marzece/Tubii_Tk2/Parts/parts/resistors/rsmd0603/readme

This is a working example of of parts table
for an 0805 resistor package. It points to
the c0805.dra in 
/tape/nandorpcb/PSD140/myparts/allegroSymbols
