marzece/Tubii_Tk2/worklib/tubii/physical/netlist.txt

(NETLIST)
(FOR DRAWING: C:/Users/QGPWindowsVB/Documents/ANUSTART/worklib/tubii/physical/TubiiPCB_V6.brd)
(GENERATED BY: ALLEGRO 16.6 P004 (v16-6-112G))
(Fri May 22 17:57:33 2015)
$PACKAGES
3006_TRIMPOT ! 3006P_TRIMPOT ; U149 U150 
CAP0603 ! 'CSMD0603-0.1UF,10%,0603,50V' ! '0.1UF' ; C1 C2 C3 C11 C12 C13 ,
        C14 C15 C22 C23 C24 C25 C26 C27 C28 C29 C30 C32 C33 C34 C35 C36 C37 ,
        C38 C39 C40 C41 C42 C43 C44 C45 C46 C47 C48 C84 C85 C86 C87 C89 ,
        C101 C102 C103 C104 C105 C110 C111 C112 C113 C114 C115 C116 C117 ,
        C118 C119 C120 C121 C122 C124 C125 C126 C127 C128 C129 C130 C131 ,
        C132 C133 C135 C136 C184 
CAP0603 ! 'CSMD0603-0.1UF,5%,0603,50V' ! '0.1UF' ; C52 C53 C54 C55 C56 C57 ,
        C60 C62 C63 C66 C96 C97 C98 C183 
CAP0603 ! 'CSMD0603-1.0UF,10%,0603,25V' ! '1.0UF' ; C4 C5 C6 C7 C9 C50 
CAP0603 ! 'CSMD0603-10NF,10%,0603,25V' ! 10NF ; C31 
CAP805 ! 'CSMD0805-0.01UF,10%,0805,25V' ! '0.01UF' ; C202 
CAP805 ! 'CSMD0805-0.1UF,5%,0805,50V' ! '0.1UF' ; C8 C10 C49 C51 C58 C59 ,
        C61 C64 C65 C76 C78 C88 C90 C91 C92 C93 C94 C99 C100 C123 C137 C138 ,
        C139 C140 C181 C182 
CAP805 ! 'CSMD0805-0.33UF,10%,0805,25V' ! '0.33UF' ; C71 C72 
CAP805 ! 'CSMD0805-1.0UF,10%,0805,25V' ! '1.0UF' ; C16 C17 C18 C19 C20 C21 
CAP805 ! 'CSMD0805-100NF,10%,0805,25V' ! 100NF ; C95 
CAP805 ! 'CSMD0805-10NF,10%,0805,25V' ! 10NF ; C83 
CAP805 ! 'CSMD0805-15PF,10%,0805,25V' ! 15PF ; C134 
CAP805 ! 'CSMD0805-1UF,10%,0805,25V' ! 1UF ; C106 C107 C108 C109 C141 C142 ,
        C143 C144 C145 C146 C147 C148 C149 C150 C151 C152 C153 C154 C155 ,
        C156 C157 C158 C159 C160 C161 C162 C163 C164 C165 C166 C167 C168 ,
        C169 C170 C171 C172 C173 C174 C175 C176 C177 C178 C179 C180 
CAP805 ! 'CSMD0805-NS,10%,0805,25V' ! 'NO STUFF' ; C186 C187 C188 C189 C190 ,
        C191 C192 C193 C194 C195 C196 C197 C198 C199 C200 C201 
CAP805 ! 'TANT0805-0.1UF,5%,0805,50V' ! '0.1UF' ; C73 C74 C82 C185 
CAP805 ! 'TANT0805-10UF,5%,0805,25V' ! 10UF ; C67 C68 C75 C77 C80 
CAP805 ! 'TANT0805-1UF,10%,0805,25V' ! 1UF ; C69 C70 C79 C81 
CONN10 ! IDS_C10 ; U6 U16 U53 U54 U80 
CONN12 ! CONN12 ; J2 
CONN20 ! CONN20 ; J3 
CONN32 ! CONN32 ; U148 
COTO2300_V1 ! COTO2342 ; U107 U112 U117 U122 U127 U132 U137 U142 
D6R10F1_BUTTON ! DR610F1_BUTTON ; U151 
DO35 ! 1N4448 ; U109 U110 U114 U115 U119 U120 U124 U125 U129 U130 U134 U135 ,
        U139 U140 U144 U145 
DO41 ! Z4KE ; U155 U156 U157 
FCI_61083_CONNECTOR ! 'FCI_61083-101400LF' ; U5 U65 
FEC32DTP ! TESTPOINT_L ; TP1 TP2 TP3 TP4 TP5 TP6 TP7 TP8 TP9 TP10 TP11 TP12 ,
        TP13 TP14 TP15 TP16 TP17 TP18 TP19 TP20 TP21 TP22 TP23 TP24 TP25 ,
        TP26 TP27 TP28 TP29 TP30 TP31 TP32 TP33 TP34 TP35 TP36 TP37 TP38 ,
        TP39 TP40 TP41 TP42 TP43 TP44 TP45 TP46 TP47 TP48 TP49 TP50 TP51 ,
        TP52 TP53 TP64 TP65 TP68 TP69 TP76 TP77 TP78 TP79 TP80 TP81 TP82 ,
        TP83 TP84 TP85 TP86 TP87 TP88 TP89 TP90 TP91 TP92 TP93 TP94 TP95 ,
        TP110 TP111 TP112 TP113 TP114 TP115 TP116 TP117 TP118 TP119 TP120 ,
        TP121 TP122 TP123 TP124 TP125 TP126 TP127 TP128 TP129 TP130 TP131 ,
        TP132 TP133 TP134 TP135 TP136 TP137 TP138 TP139 TP140 TP141 TP142 ,
        TP143 TP144 TP145 TP146 TP147 TP148 TP149 TP150 TP151 TP152 TP153 ,
        TP154 TP155 TP156 TP157 TP158 TP159 TP160 TP161 TP162 TP163 TP164 ,
        TP165 TP166 TP167 TP168 TP169 TP170 TP171 TP172 TP173 TP174 TP175 ,
        TP176 TP177 TP178 TP179 TP180 TP181 TP182 TP183 TP184 TP185 TP186 ,
        TP187 TP188 TP189 TP190 TP191 TP192 TP193 TP194 TP195 TP196 TP197 ,
        TP198 
INDUCT400 ! INDUCTOR_L ; L1 L2 L3 L4 L5 
LED1206 ! 'LED_1206-RED,RED,1206,16V' ! Red ; LED1 LED2 
LED_SSFLXH1031D ! LED_L ; D1 D2 D3 D4 D5 D6 D7 D8 D9 D10 D11 D12 D13 D14 ,
        D15 D16 D17 D18 
OSTOQ027150 ! OSTOQ027150 ; U154 
OSTOQ047150 ! OSTOQ047150 ; U48 U49 
P113FC ! PICKERING113FC ; U102 U103 U104 U105 
PLCC20 ! MC10H104 ; U12 U30 U32 U39 U40 U84 
PLCC20 ! MC10H116 ; U34 U51 U52 U153 
PLCC20 ! MC10H124 ; U8 U10 U29 U31 U33 U57 U67 U68 U94 
PLCC20 ! MC10H125 ; U18 U24 U35 U45 U56 U78 U79 U93 
PLCC20 ! MC10H131 ; U41 U42 U46 U73 U85 
PLCC28 ! MC10E016 ; U82 
PLCC28 ! MC10E101 ; U44 
PLCC28 ! MC10E116 ; U11 U17 U21 U43 U55 U74 U75 U83 
RES805 ! RES_L ; R194 R195 R196 R197 R198 R201 R203 R204 R208 R211 R212 ,
        R213 R214 R215 R218 R220 R221 R225 R228 R229 R230 R231 R232 R235 ,
        R237 R238 R242 R245 R246 R247 R248 R249 R252 R254 R255 R259 R262 ,
        R263 R264 R265 R266 R269 R271 R272 R276 R279 R280 R281 R282 R283 ,
        R286 R288 R289 R293 R296 R297 R298 R299 R300 R303 R305 R306 R310 ,
        R313 R314 R315 R316 R317 R320 R322 R323 R327 
RES805 ! 'RSMD0805-0,1%,0805' ! 0 ; R205 R206 R207 R209 R222 R223 R224 R226 ,
        R239 R240 R241 R243 R256 R257 R258 R260 R273 R274 R275 R277 R290 ,
        R291 R292 R294 R307 R308 R309 R311 R324 R325 R326 R328 
RES805 ! 'RSMD0805-10,1%,0805' ! 10 ; R200 R217 R234 R251 R268 R285 R302 ,
        R319 
RES805 ! 'RSMD0805-100,1%,0805' ! 100 ; R3 R4 R5 R12 R28 R40 R41 R76 R77 ,
        R110 R112 R181 R182 R183 R184 R185 R186 R367 R368 R381 R382 R383 ,
        R384 R385 R386 R387 R388 R389 R390 
RES805 ! 'RSMD0805-1000,1%,0805' ! 1000 ; R18 R19 R66 R68 R78 R79 R82 R83 ,
        R84 R85 R86 R87 R108 R109 R111 R113 R114 R115 
RES805 ! 'RSMD0805-10K,1%,0805' ! 10K ; R1 R2 R38 R39 R72 R75 R354 R355 
RES805 ! 'RSMD0805-111,1%,0805' ! 111 ; R199 R216 R233 R250 R267 R284 R301 ,
        R318 
RES805 ! 'RSMD0805-2K,1%,0805' ! 2K ; R180 R193 R210 R227 R244 R261 R278 ,
        R295 R312 
RES805 ! 'RSMD0805-499,1%,0805' ! 499 ; R140 R141 R142 R143 R144 R145 R146 ,
        R147 R167 R202 R219 R236 R253 R270 R287 R304 R321 
RES805 ! 'RSMD0805-5.1K,1%,0805' ! '5.1K' ; R351 R352 R353 R356 R357 R358 ,
        R359 R360 R361 R362 
RES805 ! 'RSMD0805-50,1%,0805' ! 50 ; R6 R7 R8 R9 R10 R11 R13 R14 R15 R16 ,
        R17 R20 R21 R22 R23 R24 R25 R26 R27 R29 R30 R31 R32 R33 R34 R35 R36 ,
        R37 R42 R43 R44 R45 R46 R47 R48 R49 R50 R51 R52 R53 R54 R55 R56 R57 ,
        R58 R59 R60 R61 R62 R63 R64 R65 R67 R69 R70 R71 R73 R74 R80 R81 R88 ,
        R89 R90 R91 R92 R93 R94 R95 R96 R97 R98 R99 R100 R101 R102 R103 ,
        R104 R105 R106 R107 R116 R117 R118 R119 R120 R121 R122 R123 R124 ,
        R125 R126 R127 R128 R129 R130 R131 R132 R133 R134 R135 R136 R137 ,
        R138 R139 R148 R149 R150 R151 R152 R153 R154 R155 R156 R157 R158 ,
        R159 R160 R161 R162 R163 R164 R165 R166 R168 R169 R170 R171 R172 ,
        R173 R174 R175 R176 R177 R178 R179 R187 R188 R189 R190 R191 R192 ,
        R329 R330 R331 R332 R333 R334 R335 R336 R337 R338 R339 R340 R341 ,
        R342 R343 R344 R345 R346 R347 R348 R349 R350 R363 R364 R365 R366 ,
        R369 R370 R371 R372 R373 R374 R375 R376 R377 R378 R379 R380 
SIP16 ! SIP_HEADER_16PIN ; J1 
SIP2 ! SIP_HEADER_2PIN ; U87 U88 U89 U90 U91 U92 
SMD_FOX ! FOXCLOCK ; U26 
SOIC14 ! 74F06 ; U63 U64 
SOIC14 ! 74F07 ; U76 U77 U101 
SOIC14 ! 74HCT164 ; U2 U66 U97 U98 
SOIC14 ! DS90LV019 ; U58 
SOIC14 ! OPA4277 ; U13 U14 
SOIC14 ! SN74S32 ; U152 
SOIC16 ! AD96687 ; U70 
SOIC16 ! DS1023200 ; U1 
SOIC16 ! DS102350 ; U36 U37 
SOIC16 ! DS1023500 ; U7 
SOIC16 ! HCT123 ; U9 U38 U47 U62 U95 
SOIC16 ! SY100EL34L ; U28 U86 
SOIC16W ! AD7243 ; U69 
SOIC20 ! 74HCT273 ; U96 
SOIC20 ! HCT374_1 ; U4 U99 U100 
SOIC20W ! SY100EL91L ; U27 
SOIC8 ! AD8009_SOIC ; U50 
SOIC8 ! DS90LV027 ; U20 
SOIC8 ! OPA2277_SOIC ; U15 
SOIC8 ! OPA277 ; U147 
SOIC8 ! REF02 ; U146 
SOIC8 ! SY100EL05 ; U22 U23 U81 
SOIC8 ! THS3061 ; U106 U108 U111 U113 U116 U118 U121 U123 U126 U128 U131 ,
        U133 U136 U138 U141 U143 
SOT223 ! LM1117 ; Q4 
SOT23 ! MMBTH10 ; U59 
SOT23 ! MMBTH81 ; U19 
SS22SDP2 ! SS22SDP2 ; U25 U71 U72 
SSOP16 ! 74HCT165 ; U3 
TO220ABH ! 7815S_L ; Q2 
TO220ABV ! 7915_L ; Q1 
TO92 ! MPSH81 ; U60 
TSSOP16 ! HCT238_TSSOP ; U61 
$NETS
'BACKPLANE_IN<10>' ; R80.2 U6.9 U15.5 
'BACKPLANE_IN<1>' ; R378.2 U6.1 U13.3 
'BACKPLANE_IN<2>' ; R377.2 U6.3 U13.5 
'BACKPLANE_IN<3>' ; R376.2 U6.5 U13.10 
'BACKPLANE_IN<4>' ; R375.2 U6.7 U13.12 
'BACKPLANE_IN<5>' ; R374.2 U6.2 U14.3 
'BACKPLANE_IN<6>' ; R373.2 U6.4 U14.5 
'BACKPLANE_IN<7>' ; R372.2 U6.6 U14.10 
'BACKPLANE_IN<8>' ; R371.2 U6.8 U14.12 
'BACKPLANE_IN<9>' ; R81.2 U6.10 U15.2 
'BACKPLANE_OUT<10>' ; U15.6 U15.7 U16.9 
'BACKPLANE_OUT<1>' ; U13.1 U13.2 U16.1 
'BACKPLANE_OUT<2>' ; U13.6 U13.7 U16.3 
'BACKPLANE_OUT<3>' ; U13.8 U13.9 U16.5 
'BACKPLANE_OUT<4>' ; U13.13 U13.14 U16.7 
'BACKPLANE_OUT<5>' ; U14.1 U14.2 U16.2 
'BACKPLANE_OUT<6>' ; U14.6 U14.7 U16.4 
'BACKPLANE_OUT<7>' ; U14.8 U14.9 U16.6 
'BACKPLANE_OUT<8>' ; U14.13 U14.14 U16.8 
'BACKPLANE_OUT<9>' ; U15.1 U15.3 U16.10 
'BCKP_CLK*' ; R27.2 TP12.1 U30.12 
BCKP_CLK_BUFD_N ; R162.2 U81.4 U83.12 
BCKP_CLK_BUFD_P ; R163.2 U81.3 U83.11 
'CARRIER_SRST#' ; U5.6 
CHANGE_CLK2_N ; R336.2 U21.15 U24.3 
CHANGE_CLK2_P ; R338.2 U21.14 U24.4 
CHOSEN_CLK2_N ; R332.2 U21.26 U24.8 U25.5 
CHOSEN_CLK2_P ; R331.2 U21.25 U24.9 U25.2 
CHOSEN_CLK_N ; R347.2 U22.6 U23.6 U25.6 
CHOSEN_CLK_P ; R345.2 U22.7 U23.7 U25.3 
CLK_BAD_N ; R178.1 U81.2 U94.5 
CLK_BAD_P ; R177.1 U81.1 U94.3 
CLK_MISSED ; R182.1 U96.2 
CLK_SEL_ECL_N ; R25.2 U29.5 U30.9 U30.14 
CLK_SEL_ECL_P ; R26.2 U29.3 U30.7 U30.17 
CLK_STATE ; R175.2 U84.7 U85.4 
'CNTRL_RAW<0>' ; TP8.1 U2.3 U3.11 U4.2 
'CNTRL_RAW<1>' ; TP7.1 U2.4 U3.12 U4.3 
'CNTRL_RAW<2>' ; TP6.1 U2.5 U3.13 U4.4 
'CNTRL_RAW<3>' ; TP5.1 U2.6 U3.14 U4.5 
'CNTRL_RAW<4>' ; TP4.1 U2.10 U3.3 U4.6 
'CNTRL_RAW<5>' ; TP3.1 U2.11 U3.4 U4.7 
'CNTRL_RAW<6>' ; TP2.1 U2.12 U3.5 U4.8 
'CNTRL_RAW<7>' ; TP1.1 U2.13 U3.6 U4.9 
COMP1_THRESH ; TP31.1 U69.14 U70.7 
COMP2_THRESH ; TP30.1 U70.10 U150.2 
COUNT ; R159.1 U81.7 U82.27 U85.8 
'COUNT_DATA_ECL<0>' ; R148.1 U68.3 U82.3 
'COUNT_DATA_ECL<1>' ; R149.1 U68.2 U82.4 
'COUNT_DATA_ECL<2>' ; R150.1 U68.19 U82.5 
'COUNT_DATA_ECL<3>' ; R151.1 U68.18 U82.6 
'COUNT_DATA_ECL<4>' ; R152.1 U67.3 U82.7 
'COUNT_DATA_ECL<5>' ; R153.1 U67.2 U82.21 
'COUNT_DATA_ECL<6>' ; R154.1 U67.19 U82.22 
'COUNT_DATA_ECL<7>' ; R155.1 U67.18 U82.23 
DDGT_BITS ; U1.3 U7.5 
DDGT_TTL ; U7.9 U8.9 U9.10 
DEF_CLK_DIV2_N ; U86.2 U88.1 
DEF_CLK_DIV2_P ; U86.1 U87.1 
DEF_CLK_DIV4_N ; U86.5 U90.1 
DEF_CLK_DIV4_P ; U86.4 U89.1 
DEF_CLK_DIV8_N ; U86.8 U92.1 
DEF_CLK_DIV8_P ; U86.7 U91.1 
DEF_CLK_DIVD_N ; R176.2 U88.2 U90.2 U92.2 U93.4 
DEF_CLK_DIVD_P ; R179.2 U87.2 U89.2 U91.2 U93.3 
DGT_GATE ; R53.2 TP122.1 U40.7 U40.9 U40.14 U40.17 U73.3 
DGT_TTL ; U1.15 U8.7 U8.13 U9.2 
DIVD_CLK_TTL ; U93.5 U95.2 
ECAL_ACTIVE_ECL_N ; R29.2 U31.5 U32.8 
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
TRIG_PULS2_N ; R62.2 U43.24 U46.18 
TRIG_PULS2_P ; R63.2 R66.2 U43.23 U46.19 
UNNAMED_1_74F06_I2_D1 ; U62.13 U63.1 U63.3 U63.5 U63.9 U63.11 U63.13 U64.1 ,
        U64.3 U64.5 U64.9 U64.11 U64.13 
UNNAMED_1_74F06_I2_Q1 ; C100.1 R110.1 R111.2 R382.1 R384.1 R387.1 R389.1 ,
        R390.1 U63.2 U63.4 U63.6 U63.8 U63.10 U63.12 
UNNAMED_1_74F06_I3_Q1 ; C99.1 R112.1 R113.2 R381.1 R383.1 R385.1 R386.1 ,
        R388.1 U64.2 U64.4 U64.6 U64.8 U64.10 U64.12 
UNNAMED_1_74F07_I41_A0 ; U99.19 U101.1 
UNNAMED_1_74F07_I41_A1 ; U99.18 U101.3 
UNNAMED_1_74F07_I41_A2 ; U99.17 U101.5 
UNNAMED_1_74F07_I41_A3 ; U99.16 U101.9 
UNNAMED_1_74F07_I41_Y0 ; R186.1 U101.2 
UNNAMED_1_74F07_I41_Y1 ; R184.1 U101.4 
UNNAMED_1_74F07_I41_Y2 ; R183.1 U101.6 
UNNAMED_1_74F07_I41_Y3 ; R185.1 U101.8 
UNNAMED_1_74HCT164_I28_Q0 ; U66.3 U68.7 
UNNAMED_1_74HCT164_I28_Q1 ; U66.4 U68.9 
UNNAMED_1_74HCT164_I28_Q2 ; U66.5 U68.13 
UNNAMED_1_74HCT164_I28_Q3 ; U66.6 U68.14 
UNNAMED_1_74HCT164_I28_Q4 ; U66.10 U67.7 
UNNAMED_1_74HCT164_I28_Q5 ; U66.11 U67.9 
UNNAMED_1_74HCT164_I28_Q6 ; U66.12 U67.13 
UNNAMED_1_74HCT164_I28_Q7 ; U66.13 U67.14 
UNNAMED_1_74HCT164_I64_Q0 ; U98.3 U99.2 
UNNAMED_1_74HCT164_I64_Q1 ; U98.4 U99.3 
UNNAMED_1_74HCT164_I64_Q2 ; U98.5 U99.4 
UNNAMED_1_74HCT164_I64_Q3 ; U98.6 U99.5 
UNNAMED_1_74HCT164_I64_Q7 ; U97.1 U98.13 
UNNAMED_1_74HCT164_I65_Q0 ; U97.3 U100.2 
UNNAMED_1_74HCT164_I65_Q1 ; U97.4 U100.3 
UNNAMED_1_74HCT164_I65_Q2 ; U97.5 U100.4 
UNNAMED_1_74HCT164_I65_Q3 ; U97.6 U100.5 
UNNAMED_1_74HCT164_I65_Q4 ; U97.10 U100.6 
UNNAMED_1_74HCT164_I65_Q5 ; U97.11 U100.7 
UNNAMED_1_74HCT164_I65_Q6 ; U97.12 U100.8 
UNNAMED_1_74HCT164_I65_Q7 ; U97.13 U100.9 
UNNAMED_1_AD7243_I2_REFIN ; U69.1 U69.2 U69.13 
UNNAMED_1_AD7243_I2_VDD ; C107.2 U69.16 
UNNAMED_1_AD7243_I2_VSS ; C106.2 U69.15 
UNNAMED_1_AD8009_I1_IN ; R86.2 R87.1 U50.2 
UNNAMED_1_AD8009_I1_V ; C84.1 U50.7 
UNNAMED_1_AD8009_I1_V_1 ; C85.2 U50.4 
UNNAMED_1_AD96687_I1_LE1 ; R356.2 U70.4 
UNNAMED_1_AD96687_I1_LE2 ; R357.2 U70.13 
UNNAMED_1_AD96687_I1_Q1 ; R48.2 TP32.1 U39.5 U70.1 
UNNAMED_1_AD96687_I1_Q2 ; R45.2 TP35.1 U39.13 U70.16 
UNNAMED_1_AD96687_I1_Q1_1 ; R46.2 TP33.1 U39.8 U70.2 
UNNAMED_1_AD96687_I1_Q2_1 ; R43.2 TP34.1 U39.15 U70.15 
UNNAMED_1_CAENBUFFER_I18_CNTRL ; R200.1 U100.15 
UNNAMED_1_CAENBUFFER_I18_INANAL ; R168.2 R193.1 R194.1 R197.1 U102.5 
UNNAMED_1_CAENBUFFER_I18_VREF5M ; C141.1 C146.1 C151.1 C156.1 C161.1 C166.1 ,
        C171.1 C176.1 R201.1 R218.1 R235.1 R252.1 R269.1 R286.1 R303.1 ,
        R320.1 R355.2 U147.6 
UNNAMED_1_CAENBUFFER_I19_CNTRL ; R217.1 U100.19 
UNNAMED_1_CAENBUFFER_I19_INANAL ; R169.2 R210.1 R211.1 R214.1 U104.5 
UNNAMED_1_CAENBUFFER_I20_CNTRL ; R234.1 U100.17 
UNNAMED_1_CAENBUFFER_I20_INANAL ; R170.2 R227.1 R228.1 R231.1 U103.5 
UNNAMED_1_CAENBUFFER_I21_CNTRL ; R251.1 U100.16 
UNNAMED_1_CAENBUFFER_I22_CNTRL ; R268.1 U100.14 
UNNAMED_1_CAENBUFFER_I23_CNTRL ; R285.1 U100.12 
UNNAMED_1_CAENBUFFER_I24_CNTRL ; R302.1 U100.18 
UNNAMED_1_CAENBUFFER_I5_CNTRL ; R319.1 U100.13 
UNNAMED_1_CAENBUFFER_I5_INANAL ; R312.1 R313.1 R316.1 R364.2 U105.5 
UNNAMED_1_CAENCOMS_I8_DATARDY ; U65.17 U99.11 U100.11 
UNNAMED_1_CAENCOMS_I8_GT2P ; R56.2 U17.20 U32.7 U41.5 U41.17 U42.5 U42.17 ,
        U73.5 
UNNAMED_1_CAENCOMS_I8_GTTTL ; U1.1 U5.24 U7.1 U18.15 
UNNAMED_1_CAENCOMS_I8_SYNC24TTL ; U5.18 U18.7 U20.3 
UNNAMED_1_CAENCOMS_I8_SYNCTTL ; U5.20 U18.5 U20.2 
UNNAMED_1_CHANGECLKS_I3_BCKPCLK ; R339.2 U23.4 U83.18 
UNNAMED_1_CHANGECLKS_I3_BCKPC_1 ; R340.2 U23.3 U83.17 
UNNAMED_1_CHANGECLKS_I3_BCKPC_2 ; R348.2 U25.4 U83.21 
UNNAMED_1_CHANGECLKS_I3_BCKPC_3 ; R346.2 U25.1 U83.20 
UNNAMED_1_CHANGECLKS_I3_CHANGEC ; R334.2 U21.4 U21.5 U21.28 U85.18 
UNNAMED_1_CHANGECLKS_I3_CHANG_1 ; R333.2 U21.3 U21.6 U21.27 U85.19 
UNNAMED_1_CHANGECLKS_I3_DEFAULT ; R342.1 U22.2 U83.15 
UNNAMED_1_CHANGECLKS_I3_DEFAU_1 ; R344.1 U22.1 U83.14 
UNNAMED_1_CLOCKS_I2_BCKPUSED ; U24.5 U65.43 
UNNAMED_1_CLOCKS_I2_CLK100TTL ; U24.7 U65.41 
UNNAMED_1_CLOCKS_I2_CLKSEL ; U4.19 U29.7 
UNNAMED_1_CLOCKS_I2_DATARDY ; U65.25 U94.9 
UNNAMED_1_CLOCKS_I2_RESET ; U65.47 U152.1 
UNNAMED_1_CNTRLREGISTER_I10_DAT ; U4.11 U65.38 
UNNAMED_1_CNTRLREGISTER_I10_ECA ; R28.1 U4.17 U31.7 
UNNAMED_1_CNTRLREGISTER_I10_LOS ; R5.2 U4.18 U10.7 
UNNAMED_1_CNTRLREGISTER_I10_REA ; U3.1 U3.15 U65.36 
UNNAMED_1_CNTRLREGISTER_I10_REG ; U3.9 U3.10 U65.32 
UNNAMED_1_COTO2342_I1_CTRLIN ; R319.2 U142.2 
UNNAMED_1_COTO2342_I1_CTRLIN_1 ; R200.2 U107.2 
UNNAMED_1_COTO2342_I1_CTRLIN_2 ; R217.2 U112.2 
UNNAMED_1_COTO2342_I1_CTRLIN_3 ; R234.2 U117.2 
UNNAMED_1_COTO2342_I1_CTRLIN_4 ; R251.2 U122.2 
UNNAMED_1_COTO2342_I1_CTRLIN_5 ; R268.2 U127.2 
UNNAMED_1_COTO2342_I1_CTRLIN_6 ; R285.2 U132.2 
UNNAMED_1_COTO2342_I1_CTRLIN_7 ; R302.2 U137.2 
UNNAMED_1_COTO2342_I1_IN1 ; R325.1 U142.5 
UNNAMED_1_COTO2342_I1_IN2 ; R324.1 U142.8 
UNNAMED_1_COTO2342_I1_IN1_1 ; R206.1 U107.5 
UNNAMED_1_COTO2342_I1_IN1_2 ; R223.1 U112.5 
UNNAMED_1_COTO2342_I1_IN1_3 ; R240.1 U117.5 
UNNAMED_1_COTO2342_I1_IN1_4 ; R257.1 U122.5 
UNNAMED_1_COTO2342_I1_IN1_5 ; R274.1 U127.5 
UNNAMED_1_COTO2342_I1_IN1_6 ; R291.1 U132.5 
UNNAMED_1_COTO2342_I1_IN1_7 ; R308.1 U137.5 
UNNAMED_1_COTO2342_I1_IN2_1 ; R205.1 U107.8 
UNNAMED_1_COTO2342_I1_IN2_2 ; R222.1 U112.8 
UNNAMED_1_COTO2342_I1_IN2_3 ; R239.1 U117.8 
UNNAMED_1_COTO2342_I1_IN2_4 ; R256.1 U122.8 
UNNAMED_1_COTO2342_I1_IN2_5 ; R273.1 U127.8 
UNNAMED_1_COTO2342_I1_IN2_6 ; R290.1 U132.8 
UNNAMED_1_COTO2342_I1_IN2_7 ; R307.1 U137.8 
UNNAMED_1_COTO2342_I1_NC1 ; R322.2 U142.7 
UNNAMED_1_COTO2342_I1_NC2 ; R315.2 R318.2 U142.6 
UNNAMED_1_COTO2342_I1_NC1_1 ; R203.2 U107.7 
UNNAMED_1_COTO2342_I1_NC1_2 ; R220.2 U112.7 
UNNAMED_1_COTO2342_I1_NC1_3 ; R237.2 U117.7 
UNNAMED_1_COTO2342_I1_NC1_4 ; R254.2 U122.7 
UNNAMED_1_COTO2342_I1_NC1_5 ; R271.2 U127.7 
UNNAMED_1_COTO2342_I1_NC1_6 ; R288.2 U132.7 
UNNAMED_1_COTO2342_I1_NC1_7 ; R305.2 U137.7 
UNNAMED_1_COTO2342_I1_NC2_1 ; R196.2 R199.2 U107.6 
UNNAMED_1_COTO2342_I1_NC2_2 ; R213.2 R216.2 U112.6 
UNNAMED_1_COTO2342_I1_NC2_3 ; R230.2 R233.2 U117.6 
UNNAMED_1_COTO2342_I1_NC2_4 ; R247.2 R250.2 U122.6 
UNNAMED_1_COTO2342_I1_NC2_5 ; R264.2 R267.2 U127.6 
UNNAMED_1_COTO2342_I1_NC2_6 ; R281.2 R284.2 U132.6 
UNNAMED_1_COTO2342_I1_NC2_7 ; R298.2 R301.2 U137.6 
UNNAMED_1_COTO2342_I1_NO1 ; R313.2 U142.1 
UNNAMED_1_COTO2342_I1_NO2 ; R314.2 R317.2 U142.4 
UNNAMED_1_COTO2342_I1_NO1_1 ; R194.2 U107.1 
UNNAMED_1_COTO2342_I1_NO1_2 ; R211.2 U112.1 
UNNAMED_1_COTO2342_I1_NO1_3 ; R228.2 U117.1 
UNNAMED_1_COTO2342_I1_NO1_4 ; R245.2 U122.1 
UNNAMED_1_COTO2342_I1_NO1_5 ; R262.2 U127.1 
UNNAMED_1_COTO2342_I1_NO1_6 ; R279.2 U132.1 
UNNAMED_1_COTO2342_I1_NO1_7 ; R296.2 U137.1 
UNNAMED_1_COTO2342_I1_NO2_1 ; R195.2 R198.2 U107.4 
UNNAMED_1_COTO2342_I1_NO2_2 ; R212.2 R215.2 U112.4 
UNNAMED_1_COTO2342_I1_NO2_3 ; R229.2 R232.2 U117.4 
UNNAMED_1_COTO2342_I1_NO2_4 ; R246.2 R249.2 U122.4 
UNNAMED_1_COTO2342_I1_NO2_5 ; R263.2 R266.2 U127.4 
UNNAMED_1_COTO2342_I1_NO2_6 ; R280.2 R283.2 U132.4 
UNNAMED_1_COTO2342_I1_NO2_7 ; R297.2 R300.2 U137.4 
UNNAMED_1_CSMD0603_I10_B_1 ; C41.2 U34.5 U34.12 U34.14 
UNNAMED_1_CSMD0603_I54_B ; C113.2 U74.2 U74.4 U74.6 U74.26 U74.28 
UNNAMED_1_CSMD0603_I55_A ; C115.1 U75.2 U75.4 U75.6 U75.26 U75.28 
UNNAMED_1_CSMD0805_I10_A ; C21.1 U15.8 
UNNAMED_1_CSMD0805_I11_A ; C20.1 U15.4 
UNNAMED_1_CSMD0805_I13_B ; C51.2 R38.2 U38.7 
UNNAMED_1_CSMD0805_I14_B ; C10.2 R1.2 U9.7 
UNNAMED_1_CSMD0805_I14_B_1 ; C49.2 R39.2 U38.15 
UNNAMED_1_CSMD0805_I15_B ; C8.2 R2.2 U9.15 
UNNAMED_1_CSMD0805_I20_B ; C176.2 R314.1 R315.1 
UNNAMED_1_CSMD0805_I20_B_1 ; C141.2 R195.1 R196.1 
UNNAMED_1_CSMD0805_I20_B_2 ; C146.2 R212.1 R213.1 
UNNAMED_1_CSMD0805_I20_B_3 ; C151.2 R229.1 R230.1 
UNNAMED_1_CSMD0805_I20_B_4 ; C156.2 R246.1 R247.1 
UNNAMED_1_CSMD0805_I20_B_5 ; C161.2 R263.1 R264.1 
UNNAMED_1_CSMD0805_I20_B_6 ; C166.2 R280.1 R281.1 
UNNAMED_1_CSMD0805_I20_B_7 ; C171.2 R297.1 R298.1 
UNNAMED_1_CSMD0805_I21_B_8 ; C100.2 TP22.1 
UNNAMED_1_CSMD0805_I22_B ; C99.2 TP25.1 
UNNAMED_1_CSMD0805_I23_B ; C95.2 U62.15 U149.2 
UNNAMED_1_CSMD0805_I46_B ; C64.2 R72.2 U47.15 
UNNAMED_1_CSMD0805_I57_B ; C65.2 R75.1 U47.7 
UNNAMED_1_CSMD0805_I64_B ; C61.2 U43.2 U43.4 U43.6 
UNNAMED_1_CSMD0805_I6_A ; C17.1 U13.4 
UNNAMED_1_CSMD0805_I70_B ; C59.2 R66.1 U43.5 
UNNAMED_1_CSMD0805_I71_A ; C58.1 R68.1 U43.3 
UNNAMED_1_CSMD0805_I7_A_1 ; C18.1 U13.11 
UNNAMED_1_CSMD0805_I8_A_1 ; C19.1 U14.4 
UNNAMED_1_CSMD0805_I8_B ; C108.2 U150.3 
UNNAMED_1_CSMD0805_I9_B ; C109.2 U150.1 
UNNAMED_1_CSMD0805_I9_B_1 ; C16.2 U14.11 
UNNAMED_1_DEFAULTCLKSEL_I1_BCKP ; R160.2 U30.18 U30.19 U83.5 U83.23 U83.25 
UNNAMED_1_DEFAULTCLKSEL_I1_DEFA ; R161.2 U30.3 U30.4 U83.3 U83.27 
UNNAMED_1_DEFAULTCLKSEL_I1_RESE ; R157.1 U29.18 U82.26 U85.17 
UNNAMED_1_DEFAULTCLKSEL_I1_RE_1 ; U29.9 U29.14 U96.1 U152.3 
UNNAMED_1_DR610F1BUTTON_I24_B1 ; R167.2 U151.2 U151.3 U152.4 
UNNAMED_1_DS102350_I1_Q ; U36.3 U37.5 
UNNAMED_1_DS90LV019_I14_DIN ; U56.7 U58.2 
UNNAMED_1_DS90LV019_I14_ROUT ; U57.9 U58.4 
UNNAMED_1_ELLIECOMS_I9_SMELLIED ; U5.54 U33.7 
UNNAMED_1_ELLIECOMS_I9_SMELLIEP ; U5.17 U35.5 
UNNAMED_1_ELLIECOMS_I9_SMELLI_1 ; U5.48 U33.13 
UNNAMED_1_ELLIECOMS_I9_TELLIEDE ; U5.50 U33.9 
UNNAMED_1_ELLIECOMS_I9_TELLIEPR ; U5.19 U35.7 
UNNAMED_1_ELLIECOMS_I9_TELLIEPU ; U5.44 U33.14 
'UNNAMED_1_EXTTRIGS_I70_EXTT<10>' ; R145.2 U5.61 U76.6 
'UNNAMED_1_EXTTRIGS_I70_EXTT<11>' ; R144.2 U5.69 U76.8 
'UNNAMED_1_EXTTRIGS_I70_EXTT<12>' ; R143.2 U5.81 U77.2 
'UNNAMED_1_EXTTRIGS_I70_EXTT<13>' ; R142.2 U5.75 U77.4 
'UNNAMED_1_EXTTRIGS_I70_EXTT<14>' ; R141.2 U5.73 U77.6 
'UNNAMED_1_EXTTRIGS_I70_EXTT<15>' ; R140.2 U5.83 U77.8 
'UNNAMED_1_EXTTRIGS_I70_EXTTR<0>' ; U65.74 U79.5 
'UNNAMED_1_EXTTRIGS_I70_EXTTR<1>' ; U65.84 U79.7 
'UNNAMED_1_EXTTRIGS_I70_EXTTR<2>' ; U65.82 U79.15 
'UNNAMED_1_EXTTRIGS_I70_EXTTR<3>' ; U65.76 U79.17 
'UNNAMED_1_EXTTRIGS_I70_EXTTR<4>' ; U65.62 U78.5 
'UNNAMED_1_EXTTRIGS_I70_EXTTR<5>' ; U65.70 U78.7 
'UNNAMED_1_EXTTRIGS_I70_EXTTR<6>' ; U65.68 U78.15 
'UNNAMED_1_EXTTRIGS_I70_EXTTR<7>' ; U65.64 U78.17 
'UNNAMED_1_EXTTRIGS_I70_EXTTR<8>' ; R147.2 U5.67 U76.2 
'UNNAMED_1_EXTTRIGS_I70_EXTTR<9>' ; R146.2 U5.63 U76.4 
UNNAMED_1_GENERALUTILITIES_I4_1 ; U36.1 U65.19 
UNNAMED_1_GENERALUTILITIES_I4_G ; U37.1 U65.23 
UNNAMED_1_GTDELAYS_I1_DDGTN ; R11.2 U8.4 U12.9 
UNNAMED_1_GTDELAYS_I1_DDGTP ; R12.2 TP11.1 U8.2 
UNNAMED_1_HCT123_I22_Q1 ; R41.1 U38.13 
UNNAMED_1_HCT123_I22_Q2 ; R40.1 U38.5 
UNNAMED_1_HCT123_I29_CEXT1 ; C134.2 R180.2 U95.14 
UNNAMED_1_HCT123_I54_Q1 ; R76.1 U47.13 
UNNAMED_1_HCT123_I54_Q2 ; R77.1 U47.5 
UNNAMED_1_HCT123_I9_Q1 ; R4.1 U9.13 
UNNAMED_1_HCT123_I9_Q2 ; R3.1 U9.5 
UNNAMED_1_HCT238_I53_A0 ; U5.49 U61.1 
UNNAMED_1_HCT238_I53_A1 ; U5.53 U61.2 
UNNAMED_1_HCT238_I53_A2 ; U5.55 U61.3 
UNNAMED_1_HCT374_I2_Q6 ; TP9.1 U4.13 
UNNAMED_1_HCT374_I2_Q7 ; TP10.1 U4.12 
UNNAMED_1_LED1206_I28_A ; LED1.2 R111.1 
UNNAMED_1_LED1206_I29_A ; LED2.2 R113.1 
UNNAMED_1_LEDL_I102_A ; D15.2 R367.1 
UNNAMED_1_LEDL_I11_A ; D3.2 R5.1 
UNNAMED_1_LEDL_I12_A ; D10.2 R79.2 
UNNAMED_1_LEDL_I17_A ; D5.2 R41.2 
UNNAMED_1_LEDL_I18_A ; D1.2 R4.2 
UNNAMED_1_LEDL_I18_A_1 ; D6.2 R40.2 
UNNAMED_1_LEDL_I19_A ; D2.2 R3.2 
UNNAMED_1_LEDL_I19_B ; D9.1 R78.1 
UNNAMED_1_LEDL_I25_A ; D14.2 R85.2 
UNNAMED_1_LEDL_I32_A ; D17.2 R181.2 
UNNAMED_1_LEDL_I33_A ; D18.2 R182.2 
UNNAMED_1_LEDL_I3_A ; D4.2 R28.2 
UNNAMED_1_LEDL_I42_B ; D11.1 R82.1 
UNNAMED_1_LEDL_I44_A ; D12.2 R83.1 
UNNAMED_1_LEDL_I46_B ; D13.1 R84.1 
UNNAMED_1_LEDL_I49_A ; D8.2 R77.2 
UNNAMED_1_LEDL_I50_A ; D7.2 R76.2 
UNNAMED_1_LOGEN_I13_DGT2 ; R116.2 U8.19 U73.7 
UNNAMED_1_LOGEN_I13_LOSTAR2 ; R59.2 U11.14 U42.12 
UNNAMED_1_MC10E016_I48_TCLD ; R359.2 U82.28 
UNNAMED_1_MC10E116_I1_D0 ; C123.2 U83.2 U83.4 U83.6 U83.24 U83.26 U83.28 
UNNAMED_1_MC10E116_I1_Q0 ; R164.2 U83.8 U86.13 
UNNAMED_1_MC10E116_I1_Q3 ; R330.2 U17.18 U18.13 
UNNAMED_1_MC10E116_I1_Q0_1 ; R165.2 U83.9 U86.12 
UNNAMED_1_MC10E116_I1_Q3_1 ; R329.2 U17.17 U18.14 
UNNAMED_1_MC10E116_I22_D3 ; R108.2 U55.25 U59.2 
UNNAMED_1_MC10E116_I22_Q0 ; R103.2 U55.8 U56.4 
UNNAMED_1_MC10E116_I22_Q1 ; R104.2 U55.11 U56.9 
UNNAMED_1_MC10E116_I22_Q2 ; R107.2 U55.14 U60.1 
UNNAMED_1_MC10E116_I22_Q0_1 ; R105.2 U55.9 U56.3 
UNNAMED_1_MC10E116_I22_Q1_1 ; R106.2 U55.12 U56.8 
UNNAMED_1_MC10E116_I2_D0 ; C11.2 U11.2 U11.4 U11.6 U11.28 
UNNAMED_1_MC10E116_I2_Q0 ; R8.2 U11.8 U12.7 
UNNAMED_1_MC10E116_I3_Q0 ; R128.1 U74.8 U79.14 
UNNAMED_1_MC10E116_I3_Q1 ; R124.1 U74.12 U79.8 
UNNAMED_1_MC10E116_I3_Q2 ; R139.1 U74.14 U79.4 
UNNAMED_1_MC10E116_I3_Q3 ; R134.1 U74.18 U79.18 
UNNAMED_1_MC10E116_I3_Q0_1 ; R130.1 U74.9 U79.13 
UNNAMED_1_MC10E116_I3_Q1_1 ; R126.1 U74.11 U79.9 
UNNAMED_1_MC10E116_I3_Q2_1 ; R138.1 U74.15 U79.3 
UNNAMED_1_MC10E116_I3_Q3_1 ; R132.1 U74.17 U79.19 
UNNAMED_1_MC10E116_I4_Q0 ; R129.2 U75.9 U78.13 
UNNAMED_1_MC10E116_I4_Q1 ; R133.2 U75.12 U78.8 
UNNAMED_1_MC10E116_I4_Q2 ; R136.2 U75.15 U78.3 
UNNAMED_1_MC10E116_I4_Q3 ; R125.2 U75.17 U78.19 
UNNAMED_1_MC10E116_I4_Q0_1 ; R131.2 U75.8 U78.14 
UNNAMED_1_MC10E116_I4_Q1_1 ; R135.2 U75.11 U78.9 
UNNAMED_1_MC10E116_I4_Q2_1 ; R137.2 U75.14 U78.4 
UNNAMED_1_MC10E116_I4_Q3_1 ; R127.2 U75.18 U78.18 
UNNAMED_1_MC10E116_I63_Q0 ; R73.1 TP131.1 U43.8 U46.5 
UNNAMED_1_MC10E116_I63_Q1 ; R74.1 TP132.1 U43.11 U46.17 
UNNAMED_1_MC10H104_I4_A2 ; R349.2 U30.8 U30.15 U153.4 
UNNAMED_1_MC10H131_I17_CE1 ; U42.8 U42.14 
UNNAMED_1_MC10H131_I59_CC ; R362.1 U85.12 
UNNAMED_1_MC10H131_I59_D1 ; R360.2 U85.9 
UNNAMED_1_MC10H131_I59_D2 ; R361.2 U85.13 
UNNAMED_1_MC10H131_I62_CC ; R351.1 U46.12 
UNNAMED_1_MC10H131_I62_D1 ; R353.1 U46.9 
UNNAMED_1_MC10H131_I62_D2 ; R352.1 U46.13 
UNNAMED_1_MICROZEDMODULE_I1_MTC ; U5.32 U69.9 
UNNAMED_1_MICROZEDMODULE_I1_M_1 ; U5.30 U45.7 U47.10 
UNNAMED_1_MICROZEDMODULE_I1_M_2 ; U5.26 U45.5 U47.2 
UNNAMED_1_MMBTH81_I9_C ; R19.1 U19.3 
UNNAMED_1_MPSH81_I17_C ; R109.2 U60.3 
UNNAMED_1_OPA277_I2_IN ; R354.2 R355.1 U147.2 
UNNAMED_1_PICKERING113FC_I60_CN ; R183.2 U105.4 
UNNAMED_1_PICKERING113FC_I61_CN ; R184.2 U102.4 
UNNAMED_1_PICKERING113FC_I62_CN ; R185.2 U104.4 
UNNAMED_1_PICKERING113FC_I63_CN ; R186.2 U103.4 
UNNAMED_1_REF02_I1_VOUT ; R354.1 U146.5 
UNNAMED_1_RESL_I10_B ; R320.2 U141.2 
UNNAMED_1_RESL_I10_B_1 ; R201.2 U106.2 
UNNAMED_1_RESL_I10_B_2 ; R218.2 U111.2 
UNNAMED_1_RESL_I10_B_3 ; R235.2 U116.2 
UNNAMED_1_RESL_I10_B_4 ; R252.2 U121.2 
UNNAMED_1_RESL_I10_B_5 ; R269.2 U126.2 
UNNAMED_1_RESL_I10_B_6 ; R286.2 U131.2 
UNNAMED_1_RESL_I10_B_7 ; R303.2 U136.2 
UNNAMED_1_RESL_I11_A ; C200.1 R316.2 R323.1 U141.3 
UNNAMED_1_RESL_I11_A_1 ; C186.1 R197.2 R204.1 U106.3 
UNNAMED_1_RESL_I11_A_2 ; C188.1 R214.2 R221.1 U111.3 
UNNAMED_1_RESL_I11_A_3 ; C190.1 R231.2 R238.1 U116.3 
UNNAMED_1_RESL_I11_A_4 ; C192.1 R248.2 R255.1 U121.3 
UNNAMED_1_RESL_I11_A_5 ; C194.1 R265.2 R272.1 U126.3 
UNNAMED_1_RESL_I11_A_6 ; C196.1 R282.2 R289.1 U131.3 
UNNAMED_1_RESL_I11_A_7 ; C198.1 R299.2 R306.1 U136.3 
UNNAMED_1_RESL_I11_B ; C200.2 R323.2 R326.1 U141.6 
UNNAMED_1_RESL_I11_B_1 ; C186.2 R204.2 R207.1 U106.6 
UNNAMED_1_RESL_I11_B_2 ; C188.2 R221.2 R224.1 U111.6 
UNNAMED_1_RESL_I11_B_3 ; C190.2 R238.2 R241.1 U116.6 
UNNAMED_1_RESL_I11_B_4 ; C192.2 R255.2 R258.1 U121.6 
UNNAMED_1_RESL_I11_B_5 ; C194.2 R272.2 R275.1 U126.6 
UNNAMED_1_RESL_I11_B_6 ; C196.2 R289.2 R292.1 U131.6 
UNNAMED_1_RESL_I11_B_7 ; C198.2 R306.2 R309.1 U136.6 
UNNAMED_1_RESL_I16_A ; C201.1 R325.2 R327.1 U143.3 
UNNAMED_1_RESL_I16_A_1 ; C187.1 R206.2 R208.1 U108.3 
UNNAMED_1_RESL_I16_A_2 ; C189.1 R223.2 R225.1 U113.3 
UNNAMED_1_RESL_I16_A_3 ; C191.1 R240.2 R242.1 U118.3 
UNNAMED_1_RESL_I16_A_4 ; C193.1 R257.2 R259.1 U123.3 
UNNAMED_1_RESL_I16_A_5 ; C195.1 R274.2 R276.1 U128.3 
UNNAMED_1_RESL_I16_A_6 ; C197.1 R291.2 R293.1 U133.3 
UNNAMED_1_RESL_I16_A_7 ; C199.1 R308.2 R310.1 U138.3 
UNNAMED_1_RESL_I16_B ; C201.2 R327.2 R328.1 U143.6 
UNNAMED_1_RESL_I16_B_1 ; C187.2 R208.2 R209.1 U108.6 
UNNAMED_1_RESL_I16_B_2 ; C189.2 R225.2 R226.1 U113.6 
UNNAMED_1_RESL_I16_B_3 ; C191.2 R242.2 R243.1 U118.6 
UNNAMED_1_RESL_I16_B_4 ; C193.2 R259.2 R260.1 U123.6 
UNNAMED_1_RESL_I16_B_5 ; C195.2 R276.2 R277.1 U128.6 
UNNAMED_1_RESL_I16_B_6 ; C197.2 R293.2 R294.1 U133.6 
UNNAMED_1_RESL_I16_B_7 ; C199.2 R310.2 R311.1 U138.6 
UNNAMED_1_RESL_I7_A ; R312.2 R321.1 R322.1 
UNNAMED_1_RESL_I7_A_1 ; R193.2 R202.1 R203.1 
UNNAMED_1_RESL_I7_A_2 ; R210.2 R219.1 R220.1 
UNNAMED_1_RESL_I7_A_3 ; R227.2 R236.1 R237.1 
UNNAMED_1_RESL_I7_A_4 ; R244.2 R253.1 R254.1 
UNNAMED_1_RESL_I7_A_5 ; R261.2 R270.1 R271.1 
UNNAMED_1_RESL_I7_A_6 ; R278.2 R287.1 R288.1 
UNNAMED_1_RESL_I7_A_7 ; R295.2 R304.1 R305.1 
UNNAMED_1_RSMD0805_I16_B ; R20.2 U27.19 U28.13 
UNNAMED_1_RSMD0805_I17_B ; R21.2 U27.18 U28.12 
UNNAMED_1_RSMD0805_I18_B ; R324.2 U143.2 
UNNAMED_1_RSMD0805_I18_B_1 ; R205.2 U108.2 
UNNAMED_1_RSMD0805_I18_B_2 ; R222.2 U113.2 
UNNAMED_1_RSMD0805_I18_B_3 ; R239.2 U118.2 
UNNAMED_1_RSMD0805_I18_B_4 ; R256.2 U123.2 
UNNAMED_1_RSMD0805_I18_B_5 ; R273.2 U128.2 
UNNAMED_1_RSMD0805_I18_B_6 ; R290.2 U133.2 
UNNAMED_1_RSMD0805_I18_B_7 ; R307.2 U138.2 
UNNAMED_1_RSMD0805_I39_A ; C202.2 D16.2 R379.1 R380.1 U156.1 
UNNAMED_1_RSMD0805_I45_B ; R358.2 U71.1 U71.6 U72.1 U72.6 
UNNAMED_1_RSMD0805_I4_B ; R115.2 TP21.1 
UNNAMED_1_RSMD0805_I5_B ; R114.2 TP24.1 
UNNAMED_1_SS22SDP2_I34_P1 ; R47.2 TP36.1 U39.7 U71.2 
UNNAMED_1_SS22SDP2_I34_P2 ; R350.2 TP37.1 U39.9 U71.5 
UNNAMED_1_SS22SDP2_I34_TA2 ; U71.3 U71.4 U72.3 U72.4 
UNNAMED_1_SS22SDP2_I35_P1 ; R44.2 TP38.1 U39.14 U72.2 
UNNAMED_1_SS22SDP2_I35_P2 ; R42.2 TP39.1 U39.17 U72.5 
UNNAMED_1_Z4KE_I37_CAT ; U155.1 U157.2 
UNNAMED_1_Z4KE_I38_AND ; U156.2 U157.1 
'UNNAMED_2_FRONTPORTS_I2_CAEN<0>' ; R328.2 TP143.1 U144.1 U145.2 
'UNNAMED_2_FRONTPORTS_I2_CAEN<1>' ; R209.2 TP145.1 U109.1 U110.2 
'UNNAMED_2_FRONTPORTS_I2_CAEN<2>' ; R226.2 TP147.1 U114.1 U115.2 
'UNNAMED_2_FRONTPORTS_I2_CAEN<3>' ; R243.2 TP149.1 U119.1 U120.2 
'UNNAMED_2_FRONTPORTS_I2_CAEN<4>' ; R260.2 TP151.1 U124.1 U125.2 
'UNNAMED_2_FRONTPORTS_I2_CAEN<5>' ; R277.2 TP153.1 U129.1 U130.2 
'UNNAMED_2_FRONTPORTS_I2_CAEN<6>' ; R294.2 TP155.1 U134.1 U135.2 
'UNNAMED_2_FRONTPORTS_I2_CAEN<7>' ; R311.2 TP157.1 U139.1 U140.2 
UNNAMED_2_FRONTPORTS_I2_CLK100N ; J2.12 U21.17 
UNNAMED_2_FRONTPORTS_I2_CLK100P ; J2.11 U21.18 
UNNAMED_2_FRONTPORTS_I2_DGTN ; TP117.1 U8.5 
UNNAMED_2_FRONTPORTS_I2_DGTP ; TP116.1 U8.3 
UNNAMED_2_FRONTPORTS_I2_ECLTOLV ; R101.2 TP87.1 U55.5 
UNNAMED_2_FRONTPORTS_I2_ECLTONI ; R102.2 TP88.1 U55.27 
UNNAMED_2_FRONTPORTS_I2_ECLTOTT ; R100.2 TP86.1 U55.3 
UNNAMED_2_FRONTPORTS_I2_ECLTO_1 ; TP94.1 U58.11 
UNNAMED_2_FRONTPORTS_I2_ECLTO_2 ; TP93.1 U58.12 
UNNAMED_2_FRONTPORTS_I2_ECLTO_3 ; TP95.1 U60.2 
UNNAMED_2_FRONTPORTS_I2_ECLTO_4 ; TP92.1 U56.5 
'UNNAMED_2_FRONTPORTS_I2_EXT<10>' ; U76.1 U148.21 
'UNNAMED_2_FRONTPORTS_I2_EXT<11>' ; U76.9 U148.23 
'UNNAMED_2_FRONTPORTS_I2_EXT<12>' ; U77.5 U148.25 
'UNNAMED_2_FRONTPORTS_I2_EXT<13>' ; U77.3 U148.27 
'UNNAMED_2_FRONTPORTS_I2_EXT<14>' ; U77.1 U148.29 
'UNNAMED_2_FRONTPORTS_I2_EXT<15>' ; U77.9 U148.31 
UNNAMED_2_FRONTPORTS_I2_EXTPEDI ; R31.2 TP114.1 U32.9 
UNNAMED_2_FRONTPORTS_I2_EXTPEDO ; TP110.1 U32.3 U32.4 
'UNNAMED_2_FRONTPORTS_I2_EXTT<0>' ; R118.2 U74.5 U148.1 
'UNNAMED_2_FRONTPORTS_I2_EXTT<1>' ; R117.2 U74.3 U148.3 
'UNNAMED_2_FRONTPORTS_I2_EXTT<2>' ; R363.2 U74.27 U148.5 
'UNNAMED_2_FRONTPORTS_I2_EXTT<3>' ; R119.2 U74.25 U148.7 
'UNNAMED_2_FRONTPORTS_I2_EXTT<4>' ; R121.2 U75.5 U148.9 
'UNNAMED_2_FRONTPORTS_I2_EXTT<5>' ; R120.2 U75.3 U148.11 
'UNNAMED_2_FRONTPORTS_I2_EXTT<6>' ; R122.2 U75.27 U148.13 
'UNNAMED_2_FRONTPORTS_I2_EXTT<7>' ; R123.2 U75.25 U148.15 
'UNNAMED_2_FRONTPORTS_I2_EXTT<8>' ; U76.5 U148.17 
'UNNAMED_2_FRONTPORTS_I2_EXTT<9>' ; U76.3 U148.19 
UNNAMED_2_FRONTPORTS_I2_GENERIC ; TP64.1 U5.31 
UNNAMED_2_FRONTPORTS_I2_GENER_1 ; J2.6 U37.15 U38.2 
UNNAMED_2_FRONTPORTS_I2_GENER_2 ; J2.8 U36.15 U38.10 
UNNAMED_2_FRONTPORTS_I2_GTN ; R192.2 U17.24 U17.26 U17.28 U80.2 
UNNAMED_2_FRONTPORTS_I2_GTNIM ; R18.1 TP141.1 U19.2 
UNNAMED_2_FRONTPORTS_I2_GTP ; R191.2 U17.23 U17.25 U17.27 U80.1 
UNNAMED_2_FRONTPORTS_I2_GTTTLOU ; TP52.1 U18.17 
UNNAMED_2_FRONTPORTS_I2_LOSTARO ; TP119.1 U11.12 
UNNAMED_2_FRONTPORTS_I2_LOSTA_1 ; TP118.1 U11.11 
UNNAMED_2_FRONTPORTS_I2_LVDSTOE ; R368.1 TP84.1 U58.9 
UNNAMED_2_FRONTPORTS_I2_LVDST_1 ; R368.2 TP83.1 U58.10 
UNNAMED_2_FRONTPORTS_I2_LVDST_2 ; TP90.1 U57.2 
UNNAMED_2_FRONTPORTS_I2_MTCAMIM ; J3.6 U43.18 
UNNAMED_2_FRONTPORTS_I2_MTCAM_1 ; J3.5 U43.17 
UNNAMED_2_FRONTPORTS_I2_MTCAM_2 ; J3.2 R365.2 U70.8 
UNNAMED_2_FRONTPORTS_I2_MTCAM_3 ; J3.8 U43.21 
UNNAMED_2_FRONTPORTS_I2_MTCAM_4 ; J3.7 U43.20 
UNNAMED_2_FRONTPORTS_I2_MTCAM_5 ; J3.4 R366.2 U70.9 
UNNAMED_2_FRONTPORTS_I2_MTCDLO ; R6.2 TP120.1 U11.3 
UNNAMED_2_FRONTPORTS_I2_NIMTOEC ; TP85.1 U59.1 
UNNAMED_2_FRONTPORTS_I2_NIMTO_1 ; TP91.1 U55.17 
'UNNAMED_2_FRONTPORTS_I2_PUL<10>' ; R173.2 R278.1 R279.1 R282.1 TP195.1 
'UNNAMED_2_FRONTPORTS_I2_PUL<11>' ; R174.2 R295.1 R296.1 R299.1 TP197.1 
'UNNAMED_2_FRONTPORTS_I2_PULS<0>' ; TP175.1 U105.1 
'UNNAMED_2_FRONTPORTS_I2_PULS<1>' ; TP177.1 U105.2 
'UNNAMED_2_FRONTPORTS_I2_PULS<2>' ; TP179.1 U102.1 
'UNNAMED_2_FRONTPORTS_I2_PULS<3>' ; TP181.1 U102.2 
'UNNAMED_2_FRONTPORTS_I2_PULS<4>' ; TP183.1 U104.1 
'UNNAMED_2_FRONTPORTS_I2_PULS<5>' ; TP185.1 U104.2 
'UNNAMED_2_FRONTPORTS_I2_PULS<6>' ; TP187.1 U103.1 
'UNNAMED_2_FRONTPORTS_I2_PULS<7>' ; TP189.1 U103.2 
'UNNAMED_2_FRONTPORTS_I2_PULS<8>' ; R171.2 R244.1 R245.1 R248.1 TP191.1 
'UNNAMED_2_FRONTPORTS_I2_PULS<9>' ; R172.2 R261.1 R262.1 R265.1 TP193.1 
UNNAMED_2_FRONTPORTS_I2_PULSEIN ; R86.1 TP68.1 
UNNAMED_2_FRONTPORTS_I2_PULSE_1 ; R87.2 TP76.1 U50.6 
UNNAMED_2_FRONTPORTS_I2_RIBBONP ; J2.4 R89.2 U52.5 
UNNAMED_2_FRONTPORTS_I2_RIBBO_1 ; J2.3 R88.2 U52.7 
UNNAMED_2_FRONTPORTS_I2_RIBBO_2 ; J2.1 U51.18 
UNNAMED_2_FRONTPORTS_I2_RIBBO_3 ; J2.2 U51.19 
'UNNAMED_2_FRONTPORTS_I2_SCAL<1>' ; J1.14 U4.15 
'UNNAMED_2_FRONTPORTS_I2_SCAL<2>' ; J1.15 U4.14 
'UNNAMED_2_FRONTPORTS_I2_SCAL<3>' ; J1.3 U4.16 
'UNNAMED_2_FRONTPORTS_I2_SCAL<4>' ; J1.16 U65.24 
'UNNAMED_2_FRONTPORTS_I2_SCAL<5>' ; J1.12 U65.30 
'UNNAMED_2_FRONTPORTS_I2_SCAL<6>' ; J1.13 U65.26 
'UNNAMED_2_FRONTPORTS_I2_SCOP<0>' ; R326.2 TP159.1 
'UNNAMED_2_FRONTPORTS_I2_SCOP<1>' ; R207.2 TP161.1 
'UNNAMED_2_FRONTPORTS_I2_SCOP<2>' ; R224.2 TP163.1 
'UNNAMED_2_FRONTPORTS_I2_SCOP<3>' ; R241.2 TP165.1 
'UNNAMED_2_FRONTPORTS_I2_SCOP<4>' ; R258.2 TP167.1 
'UNNAMED_2_FRONTPORTS_I2_SCOP<5>' ; R275.2 TP169.1 
'UNNAMED_2_FRONTPORTS_I2_SCOP<6>' ; R292.2 TP171.1 
'UNNAMED_2_FRONTPORTS_I2_SCOP<7>' ; R309.2 TP173.1 
UNNAMED_2_FRONTPORTS_I2_SMELLIE ; J3.18 R33.2 U34.7 
UNNAMED_2_FRONTPORTS_I2_SMELL_1 ; J3.16 U33.19 
UNNAMED_2_FRONTPORTS_I2_SMELL_2 ; J3.12 U33.3 
UNNAMED_2_FRONTPORTS_I2_SYNC24L ; TP140.1 U20.5 
UNNAMED_2_FRONTPORTS_I2_SYNC24N ; R190.2 U17.6 U80.9 
UNNAMED_2_FRONTPORTS_I2_SYNC24P ; R189.2 U17.5 U80.10 
UNNAMED_2_FRONTPORTS_I2_SYNC2_1 ; TP139.1 U20.6 
UNNAMED_2_FRONTPORTS_I2_SYNCLVD ; TP138.1 U20.8 
UNNAMED_2_FRONTPORTS_I2_SYNCL_1 ; TP137.1 U20.7 
UNNAMED_2_FRONTPORTS_I2_SYNCN ; R188.2 U17.4 U80.7 
UNNAMED_2_FRONTPORTS_I2_SYNCP ; R187.2 U17.3 U80.8 
UNNAMED_2_FRONTPORTS_I2_TELLIED ; J3.20 R32.2 U34.13 
UNNAMED_2_FRONTPORTS_I2_TELLIEP ; J3.10 U33.2 
UNNAMED_2_FRONTPORTS_I2_TELLI_1 ; J3.14 U33.18 
UNNAMED_2_FRONTPORTS_I2_TTLTOEC ; TP82.1 U57.7 
UNNAMED_2_FRONTPORTS_I2_TTLTO_1 ; TP89.1 U57.3 
UNNAMED_2_FRONTPORTS_I2_TUBCLKI ; J2.10 R370.1 U153.5 
UNNAMED_2_FRONTPORTS_I2_TUBCL_1 ; J2.9 R369.1 U153.7 
UNNAMED_2_FRONTPORTS_I2_TUBIIRT ; TP112.1 U65.20 
USE_BCKP_N ; R337.1 U21.9 U22.4 
USE_BCKP_P ; R335.1 U21.8 U22.3 
USE_DEFAULT_N ; R341.2 U21.12 U23.2 
USE_DEFAULT_P ; R343.2 U21.11 U23.1 
V3P3 ; C31.1 C33.2 C80.2 C81.2 C82.2 C83.1 Q4.2 Q4.4 R85.1 U5.78 U5.79 ,
        U5.80 U26.6 U27.1 U27.11 U27.20 U65.78 U65.79 U65.80 U155.2 
VBAT ; U5.7 
VBB_TRANS ; C88.2 U55.2 U55.4 U55.6 U55.26 U55.28 
VCC15 ; C78.2 C107.1 C142.2 C144.2 C147.2 C149.2 C152.2 C154.2 C157.2 ,
        C159.2 C162.2 C164.2 C167.2 C169.2 C172.2 C174.2 C177.2 C179.2 ,
        C181.1 Q2.3 Q2.4 R83.2 TP16.1 U106.7 U108.7 U111.7 U113.7 U116.7 ,
        U118.7 U121.7 U123.7 U126.7 U128.7 U131.7 U133.7 U136.7 U138.7 ,
        U141.7 U143.7 U146.2 U147.7 
VCC24 ; C71.2 L4.2 Q2.1 
VCC ; C1.2 C2.2 C3.1 C4.1 C5.2 C6.2 C9.1 C12.1 C17.2 C19.2 C21.2 C24.2 ,
        C25.1 C30.2 C35.1 C38.1 C40.2 C42.1 C46.2 C47.2 C48.2 C50.1 C62.2 ,
        C66.1 C68.1 C70.1 C74.1 C77.2 C84.2 C91.1 C92.2 C93.2 C96.1 C97.2 ,
        C98.2 C101.2 C102.1 C103.1 C108.1 C111.2 C117.1 C118.1 C121.2 ,
        C122.2 C131.2 C133.2 C135.2 C136.1 C137.2 C138.2 C139.1 C140.1 ,
        C182.2 C183.1 J1.2 L1.2 Q4.3 R1.1 R2.1 R38.1 R39.1 R72.1 R75.2 ,
        R79.1 R110.2 R112.2 R114.1 R115.1 R140.1 R141.1 R142.1 R143.1 ,
        R144.1 R145.1 R146.1 R147.1 R180.1 R381.2 R382.2 R383.2 R384.2 ,
        R385.2 R386.2 R387.2 R388.2 R389.2 R390.2 TP13.1 TP40.1 TP42.1 ,
        TP44.1 TP46.1 TP48.1 TP50.1 U1.14 U1.16 U2.9 U2.14 U3.16 U4.1 U4.20 ,
        U5.57 U5.58 U5.59 U5.60 U7.14 U7.16 U8.12 U9.3 U9.11 U9.16 U10.12 ,
        U18.12 U20.1 U24.12 U29.8 U29.12 U31.8 U31.12 U32.10 U33.8 U33.12 ,
        U35.12 U36.14 U36.16 U37.14 U37.16 U38.3 U38.11 U38.16 U45.12 ,
        U47.16 U56.12 U57.8 U57.12 U58.1 U58.14 U61.4 U61.5 U61.16 U62.3 ,
        U62.16 U63.14 U64.14 U65.12 U65.57 U65.58 U65.59 U65.60 U66.9 ,
        U66.14 U67.8 U67.12 U68.8 U68.12 U69.3 U69.4 U70.11 U76.14 U77.14 ,
        U78.12 U79.12 U93.12 U94.8 U94.12 U95.16 U96.3 U96.20 U97.9 U97.14 ,
        U98.9 U98.14 U99.20 U100.20 U101.14 U102.3 U103.3 U104.3 U105.3 ,
        U107.3 U112.3 U117.3 U122.3 U127.3 U132.3 U137.3 U142.3 U149.3 ,
        U151.1 
VCC15M ; C76.2 C106.1 C143.1 C145.1 C148.1 C150.1 C153.1 C155.1 C158.1 ,
        C160.1 C163.1 C165.1 C168.1 C170.1 C173.1 C175.1 C178.1 C180.1 Q1.3 ,
        Q1.4 R82.2 TP15.1 U106.4 U108.4 U111.4 U113.4 U116.4 U118.4 U121.4 ,
        U123.4 U126.4 U128.4 U131.4 U133.4 U136.4 U138.4 U141.4 U143.4 ,
        U147.4 
VCC24M ; C72.2 L3.2 Q1.2 
VCC24M_RAW ; L3.1 U48.4 
VCC24_RAW ; L4.1 U48.1 
VCCIO_EN_O ; U65.10 
VCC_RAW ; L1.1 U49.1 
VEE ; C7.1 C13.1 C14.2 C15.2 C16.1 C18.2 C20.2 C22.1 C23.1 C26.1 C27.1 ,
        C28.2 C29.2 C32.1 C34.2 C36.2 C37.2 C39.2 C43.1 C44.2 C45.1 C52.2 ,
        C53.2 C54.2 C55.2 C56.2 C57.1 C60.1 C63.1 C67.2 C69.2 C73.2 C85.1 ,
        C86.1 C87.1 C89.1 C90.1 C94.2 C104.2 C105.2 C109.1 C110.2 C112.2 ,
        C114.1 C116.1 C119.1 C120.1 C124.1 C125.1 C126.1 C127.1 C128.1 ,
        C129.2 C130.1 C132.1 C184.1 L2.2 R19.2 R78.2 R108.1 R109.1 TP14.1 ,
        U8.10 U10.10 U11.1 U12.10 U17.1 U18.10 U21.1 U22.5 U23.5 U24.10 ,
        U27.10 U28.9 U29.10 U30.10 U31.10 U33.10 U34.10 U35.10 U39.10 ,
        U40.10 U41.10 U42.10 U43.1 U44.1 U45.10 U46.10 U51.10 U52.10 U55.1 ,
        U56.10 U57.10 U67.10 U68.10 U70.6 U73.10 U74.1 U75.1 U78.10 U79.10 ,
        U81.5 U82.1 U83.1 U84.10 U85.10 U86.9 U93.10 U94.10 U153.10 
VEE_RAW ; L2.1 U49.4 
VTT ; C75.2 C79.2 C185.2 L5.2 R6.1 R7.1 R8.1 R9.1 R10.1 R11.1 R12.1 R13.2 ,
        R14.2 R15.2 R16.2 R17.2 R20.1 R21.1 R22.1 R23.1 R24.1 R25.1 R26.1 ,
        R27.1 R29.1 R30.1 R31.1 R32.1 R33.1 R34.1 R35.1 R36.1 R37.1 R42.1 ,
        R43.1 R44.1 R45.1 R46.1 R47.1 R48.1 R49.1 R50.1 R51.1 R52.1 R53.1 ,
        R54.1 R55.1 R56.1 R57.1 R58.1 R59.1 R60.1 R61.1 R62.1 R63.1 R64.1 ,
        R65.1 R67.1 R69.1 R70.1 R71.1 R73.2 R74.2 R84.2 R88.1 R89.1 R90.1 ,
        R91.1 R92.1 R93.1 R94.1 R95.1 R96.1 R97.1 R98.1 R99.1 R100.1 R101.1 ,
        R102.1 R103.1 R104.1 R105.1 R106.1 R107.1 R116.1 R117.1 R118.1 ,
        R119.1 R120.1 R121.1 R122.1 R123.1 R124.2 R125.1 R126.2 R127.1 ,
        R128.2 R129.1 R130.2 R131.1 R132.2 R133.1 R134.2 R135.1 R136.1 ,
        R137.1 R138.2 R139.2 R148.2 R149.2 R150.2 R151.2 R152.2 R153.2 ,
        R154.2 R155.2 R156.2 R157.2 R158.1 R159.2 R160.1 R161.1 R162.1 ,
        R163.1 R164.1 R165.1 R166.1 R175.1 R176.1 R177.2 R178.2 R179.1 ,
        R187.1 R188.1 R189.1 R190.1 R191.1 R192.1 R329.1 R330.1 R331.1 ,
        R332.1 R333.1 R334.1 R335.2 R336.1 R337.2 R338.1 R339.1 R340.1 ,
        R341.1 R342.2 R343.1 R344.2 R345.1 R346.1 R347.1 R348.1 R349.1 ,
        R350.1 R363.1 R369.2 R370.2 TP17.1 U110.1 U115.1 U120.1 U125.1 ,
        U130.1 U135.1 U140.1 U145.1 
VTT_RAW ; L5.1 U154.1 
$PACKAGES
$A_PROPERTIES
REUSE_ID '26'; 'U144'
REUSE_ID '21'; 'U145'
REUSE_ID '11'; 'U142'
REUSE_ID '4'; 'C176'
REUSE_ID '15'; 'C177'
REUSE_ID '6'; 'C178'
REUSE_ID '27'; 'C179'
REUSE_ID '25'; 'C180'
ROOM 'BASE_BUFFER'; 'U14' 'U13' 'U15' 'U16' 'U6' 'C21',
           'C20' 'C19' 'C18' 'C17' 'C16'
REUSE_ID '13'; 'R313'
REUSE_ID '3'; 'R314'
REUSE_ID '5'; 'R315'
REUSE_ID '8'; 'R316'
REUSE_ID '2'; 'R317'
REUSE_ID '9'; 'R320'
REUSE_ID '17'; 'R322'
REUSE_ID '10'; 'R323'
REUSE_ID '24'; 'R327'
REUSE_ID '16'; 'R324'
REUSE_ID '18'; 'R325'
REUSE_ID '19'; 'R326'
REUSE_ID '22'; 'R328'
REUSE_ID '1'; 'R319'
REUSE_ID '7'; 'R318'
REUSE_ID '12'; 'R312'
ROOM 'CAEN_DIG'; 'C25' 'C24' 'C23' 'C22' 'R192' 'R191',
           'R190' 'R189' 'R188' 'R187' 'R17' 'R16',
           'R15' 'R14' 'R13' 'R330' 'R329' 'U17',
           'R19' 'R18' 'U19' 'U18' 'U20'
ROOM 'ECAL_CONTROL'; 'C40' 'C39' 'C38' 'R31' 'R30' 'R29',
           'U32' 'U31'
ROOM 'PULSE_INV'; 'C85' 'C84' 'R87' 'R86' 'U50'
ROOM 'EXT_TRIG'; 'C122' 'C121' 'C120' 'C119' 'C118' 'C117',
           'C116' 'C115' 'C114' 'C113' 'R139' 'R138',
           'R137' 'R136' 'R135' 'R134' 'R133' 'R132',
           'R131' 'R130' 'R129' 'R128' 'R127' 'R126',
           'R125' 'R124' 'R123' 'R122' 'R121' 'R120',
           'R119' 'R118' 'R117' 'R363' 'U75' 'U74',
           'U79' 'U78' 'U77' 'U76'
ROOM 'TRANSLATORS'; 'C94' 'C93' 'C92' 'C91' 'C90' 'C88',
           'C89' 'R107' 'R106' 'R105' 'R104' 'R103',
           'R102' 'R101' 'R100' 'U55' 'R109' 'R108',
           'U60' 'U59' 'U56' 'U57' 'U58'
ROOM 'SPKR'; 'C100' 'C99' 'R113' 'R111' 'C95' 'C98',
           'C97' 'C96' 'U64' 'U63' 'U62' 'LED2',
           'LED1'
ROOM 'FAULT_DETECT'; 'C123' 'C136' 'C135' 'C133' 'C132' 'C131',
           'C130' 'C129' 'C128' 'C127' 'C126' 'C125',
           'C124' 'C105' 'C104' 'C103' 'C102' 'C101',
           'R179' 'R178' 'R177' 'R176' 'R175' 'R166',
           'R165' 'R164' 'R163' 'R162' 'R161' 'R160',
           'R159' 'R158' 'R157' 'R156' 'R155' 'R154',
           'R153' 'R152' 'R151' 'R150' 'R149' 'R148',
           'U84' 'U83' 'U86' 'U81' 'U92' 'U91',
           'U90' 'U89' 'U88' 'U87' 'R180' 'U85',
           'U93' 'U94' 'U68' 'U67' 'U82' 'C134',
           'U96' 'U95' 'R362' 'R361' 'R360' 'R359'
ROOM 'SEL_LO'; 'R5' 'D3' 'C15' 'C14' 'C13' 'C12',
           'C11' 'R11' 'R10' 'R9' 'R8' 'R7',
           'R6' 'U12' 'U11' 'U10'
ROOM 'GT_DELAY'; 'R2' 'R1' 'R4' 'R3' 'D2' 'D1',
           'U7' 'U1' 'C10' 'C8' 'C9' 'C7',
           'C6' 'C5' 'C4' 'U8' 'U9'
ROOM 'POWER'; 'TP17' 'TP16' 'TP15' 'TP14' 'TP13' 'C78',
           'C76' 'C81' 'C79' 'C70' 'C69' 'C80',
           'C77' 'C68' 'C67' 'C75' 'C82' 'C74',
           'C73' 'C185' 'U49' 'U48' 'L4' 'L3',
           'L2' 'L1' 'L5' 'C83' 'C72' 'C71',
           'Q4' 'Q1' 'Q2'
ROOM 'CNTRL_REG'; 'TP10' 'TP9' 'TP8' 'TP7' 'TP6' 'TP5',
           'TP4' 'TP3' 'TP2' 'TP1' 'U4' 'C3',
           'C2' 'C1' 'U3'
PLACE_TAG; 'TP10' 'TP9' 'TP8' 'TP7' 'TP6' 'TP5',
           'TP4' 'TP3' 'TP2' 'TP1' 'TP198' 'TP197',
           'TP196' 'TP195' 'TP194' 'TP193' 'TP192' 'TP191',
           'TP190' 'TP189' 'TP188' 'TP187' 'TP186' 'TP185',
           'TP184' 'TP183' 'TP182' 'TP181' 'TP180' 'TP179',
           'TP178' 'TP177' 'TP176' 'TP175' 'TP174' 'TP173',
           'TP172' 'TP171' 'TP170' 'TP169' 'TP168' 'TP167',
           'TP166' 'TP165' 'TP164' 'TP163' 'TP162' 'TP161',
           'TP160' 'TP159' 'TP158' 'TP157' 'TP156' 'TP155',
           'TP154' 'TP153' 'TP152' 'TP151' 'TP150' 'TP149',
           'TP148' 'TP147' 'TP146' 'TP145' 'TP144' 'TP143',
           'TP130' 'TP129' 'TP127' 'TP26' 'TP25' 'TP24',
           'TP23' 'TP22' 'TP21' 'TP17' 'TP16' 'TP15',
           'TP14' 'TP13' 'TP12' 'R2' 'R1' 'R75',
           'R72' 'R39' 'R38' 'R4' 'R3' 'R5',
           'R186' 'R185' 'R184' 'R183' 'R182' 'R181',
           'R77' 'R76' 'R41' 'R40' 'R28' 'R112',
           'R110' 'D2' 'D1' 'D3' 'D18' 'D17',
           'D14' 'D13' 'D12' 'D11' 'D10' 'D9',
           'D8' 'D7' 'D6' 'D5' 'D4' 'U4',
           'U100' 'U99' 'U7' 'U1' 'C10' 'C8',
           'C140' 'C139' 'C138' 'C137' 'C123' 'C100',
           'C99' 'C94' 'C93' 'C92' 'C91' 'C90',
           'C88' 'C78' 'C76' 'C65' 'C64' 'C61',
           'C59' 'C58' 'C51' 'C49' 'C9' 'C7',
           'C6' 'C5' 'C4' 'C50' 'C3' 'C2',
           'C1' 'C15' 'C14' 'C13' 'C12' 'C11',
           'C136' 'C135' 'C133' 'C132' 'C131' 'C130',
           'C129' 'C128' 'C127' 'C126' 'C125' 'C124',
           'C122' 'C121' 'C120' 'C119' 'C118' 'C117',
           'C116' 'C115' 'C114' 'C113' 'C105' 'C104',
           'C103' 'C102' 'C101' 'C89' 'C87' 'C86',
           'C85' 'C84' 'C48' 'C47' 'C46' 'C45',
           'C44' 'C43' 'C42' 'C41' 'C40' 'C39',
           'C38' 'C37' 'C36' 'C35' 'C34' 'C33',
           'C32' 'C30' 'C29' 'C28' 'C27' 'C26',
           'C25' 'C24' 'C23' 'C22' 'U3' 'R11',
           'R10' 'R9' 'R8' 'R7' 'R6' 'R192',
           'R191' 'R190' 'R189' 'R188' 'R187' 'R179',
           'R178' 'R177' 'R176' 'R175' 'R166' 'R165',
           'R164' 'R163' 'R162' 'R161' 'R160' 'R159',
           'R158' 'R157' 'R156' 'R155' 'R154' 'R153',
           'R152' 'R151' 'R150' 'R149' 'R148' 'R139',
           'R138' 'R137' 'R136' 'R135' 'R134' 'R133',
           'R132' 'R131' 'R130' 'R129' 'R128' 'R127',
           'R126' 'R125' 'R124' 'R123' 'R122' 'R121',
           'R120' 'R119' 'R118' 'R117' 'R107' 'R106',
           'R105' 'R104' 'R103' 'R102' 'R101' 'R100',
           'R99' 'R98' 'R97' 'R96' 'R95' 'R94',
           'R93' 'R92' 'R91' 'R90' 'R89' 'R88',
           'R74' 'R73' 'R71' 'R70' 'R69' 'R67',
           'R65' 'R64' 'R63' 'R62' 'R61' 'R60',
           'R59' 'R58' 'R57' 'R56' 'R55' 'R54',
           'R53' 'R52' 'R51' 'R50' 'R49' 'R48',
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
ROOM 'MTCA_MIMIC'; 'TP136' 'TP135' 'TP130' 'TP129' 'TP127' 'TP35',
           'TP34' 'R75' 'R72' 'R77' 'R76' 'D8',
           'D7' 'C65' 'C64' 'C61' 'C59' 'C58',
           'R74' 'R73' 'R71' 'R70' 'R69' 'R67',
           'R65' 'R64' 'R63' 'R62' 'R61' 'R60',
           'R59' 'R58' 'R57' 'R56' 'R55' 'R54',
           'R53' 'R52' 'R51' 'R50' 'R49' 'R48',
           'R47' 'R46' 'R45' 'R44' 'R43' 'R42',
           'R350' 'U40' 'U39' 'U43' 'R68' 'R66',
           'U46' 'U42' 'U41' 'U45' 'U44' 'C66',
           'C63' 'C62' 'C60' 'C57' 'C56' 'C55',
           'C54' 'C53' 'C52' 'U47' 'R353' 'R352',
           'R351'
ROOM 'CLK_PICK'; 'TP12' 'C37' 'C36' 'C35' 'C34' 'C33',
           'C32' 'C184' 'R27' 'R26' 'R25' 'R24',
           'R23' 'R22' 'R21' 'R20' 'R349' 'R370',
           'R369' 'U30' 'U27' 'U28' 'R167' 'U29',
           'U26' 'C31' 'U152'
ROOM 'GENERIC_DELAYS'; 'R39' 'R38' 'C51' 'C49' 'C50' 'C48',
           'C47' 'U37' 'U36' 'U38'
ROOM 'CAEN_ANALOG'; 'R186' 'R185' 'R184' 'R183' 'U100' 'U99',
           'C140' 'C139' 'C138' 'C137' 'C182' 'R364',
           'R174' 'R173' 'R172' 'R171' 'R170' 'R169',
           'R168' 'R321' 'R304' 'R287' 'R270' 'R253',
           'R236' 'R219' 'R202' 'R312' 'R295' 'R278',
           'R261' 'R244' 'R227' 'R210' 'R193' 'R318',
           'R301' 'R284' 'R267' 'R250' 'R233' 'R216',
           'R199' 'R319' 'R302' 'R285' 'R268' 'R251',
           'R234' 'R217' 'R200' 'R328' 'R326' 'R325',
           'R324' 'R311' 'R309' 'R308' 'R307' 'R294',
           'R292' 'R291' 'R290' 'R277' 'R275' 'R274',
           'R273' 'R260' 'R258' 'R257' 'R256' 'R243',
           'R241' 'R240' 'R239' 'R226' 'R224' 'R223',
           'R222' 'R209' 'R207' 'R206' 'R205' 'R327',
           'R323' 'R322' 'R320' 'R317' 'R316' 'R315',
           'R314' 'R313' 'R310' 'R306' 'R305' 'R303',
           'R300' 'R299' 'R298' 'R297' 'R296' 'R293',
           'R289' 'R288' 'R286' 'R283' 'R282' 'R281',
           'R280' 'R279' 'R276' 'R272' 'R271' 'R269',
           'R266' 'R265' 'R264' 'R263' 'R262' 'R259',
           'R255' 'R254' 'R252' 'R249' 'R248' 'R247',
           'R246' 'R245' 'R242' 'R238' 'R237' 'R235',
           'R232' 'R231' 'R230' 'R229' 'R228' 'R225',
           'R221' 'R220' 'R218' 'R215' 'R214' 'R213',
           'R212' 'R211' 'R208' 'R204' 'R203' 'R201',
           'R198' 'R197' 'R196' 'R195' 'R194' 'C180',
           'C179' 'C178' 'C177' 'C176' 'C175' 'C174',
           'C173' 'C172' 'C171' 'C170' 'C169' 'C168',
           'C167' 'C166' 'C165' 'C164' 'C163' 'C162',
           'C161' 'C160' 'C159' 'C158' 'C157' 'C156',
           'C155' 'C154' 'C153' 'C152' 'C151' 'C150',
           'C149' 'C148' 'C147' 'C146' 'C145' 'C144',
           'C143' 'C142' 'C141' 'U142' 'U137' 'U132',
           'U127' 'U122' 'U117' 'U112' 'U107' 'U101',
           'U145' 'U144' 'U140' 'U139' 'U135' 'U134',
           'U130' 'U129' 'U125' 'U124' 'U120' 'U119',
           'U115' 'U114' 'U110' 'U109' 'U143' 'U141',
           'U138' 'U136' 'U133' 'U131' 'U128' 'U126',
           'U123' 'U121' 'U118' 'U116' 'U113' 'U111',
           'U108' 'U106' 'C201' 'C200' 'C199' 'C198',
           'C197' 'C196' 'C195' 'C194' 'C193' 'C192',
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
ROOM 'RIBBON_DELAY'; 'C87' 'C86' 'R99' 'R98' 'R97' 'R96',
           'R95' 'R94' 'R93' 'R92' 'R91' 'R90',
           'R89' 'R88' 'U52' 'U51' 'U54' 'U53'
ROOM 'ELLIE'; 'C46' 'C45' 'C44' 'C43' 'C42' 'C41',
           'R37' 'R36' 'R35' 'R34' 'R33' 'R32',
           'U35' 'U33' 'U34'
ROOM 'CHANGE_CLKS'; 'C30' 'C29' 'C28' 'C27' 'C26' 'R348',
           'R347' 'R346' 'R345' 'R344' 'R343' 'R342',
           'R341' 'R340' 'R339' 'R338' 'R337' 'R336',
           'R335' 'R334' 'R333' 'R332' 'R331' 'U21',
           'U23' 'U22' 'U25' 'U24'
REUSE_ID '20'; 'R321'
$NETS
$A_PROPERTIES
LOGICAL_PATH '@tubii_tk2_lib.tubii(sch_1):page1_i1@tubii_tk2_lib.tubii_pcb(sch_1):page1_i2@tubii_tk2_lib.clocks(sch_1):page1_i1@tubii_tk2_lib.default_clk_sel(sch_1):unnamed_1_z4ke_i38_and'; 'UNNAMED_1_Z4KE_I38_AND'
LOGICAL_PATH '@tubii_tk2_lib.tubii(sch_1):page1_i1@tubii_tk2_lib.tubii_pcb(sch_1):page1_i2@tubii_tk2_lib.clocks(sch_1):page1_i1@tubii_tk2_lib.default_clk_sel(sch_1):unnamed_1_z4ke_i37_cat'; 'UNNAMED_1_Z4KE_I37_CAT'
LOGICAL_PATH '@tubii_tk2_lib.tubii(sch_1):page1_i1@tubii_tk2_lib.tubii_pcb(sch_1):page1_i2@tubii_tk2_lib.clocks(sch_1):page1_i1@tubii_tk2_lib.default_clk_sel(sch_1):unnamed_1_rsmd0805_i39_a'; 'UNNAMED_1_RSMD0805_I39_A'
LOGICAL_PATH '@tubii_tk2_lib.tubii(sch_1):unnamed_2_frontports_i2_gtttlout'; 'UNNAMED_2_FRONTPORTS_I2_GTTTLOU'
LOGICAL_PATH '@tubii_tk2_lib.tubii(sch_1):page1_i1@tubii_tk2_lib.tubii_pcb(sch_1):page1_i5@tubii_tk2_lib.power(sch_1):vtt_raw'; 'VTT_RAW'
LOGICAL_PATH '@tubii_tk2_lib.tubii(sch_1):unnamed_2_frontports_i2_tubclkinp'; 'UNNAMED_2_FRONTPORTS_I2_TUBCL_1'
LOGICAL_PATH '@tubii_tk2_lib.tubii(sch_1):unnamed_2_frontports_i2_tubclkinn'; 'UNNAMED_2_FRONTPORTS_I2_TUBCLKI'
LOGICAL_PATH '@tubii_tk2_lib.tubii(sch_1):unnamed_2_frontports_i2_lvdstoeclinp'; 'UNNAMED_2_FRONTPORTS_I2_LVDST_1'
LOGICAL_PATH '@tubii_tk2_lib.tubii(sch_1):unnamed_2_frontports_i2_lvdstoeclinn'; 'UNNAMED_2_FRONTPORTS_I2_LVDSTOE'
LOGICAL_PATH '@tubii_tk2_lib.tubii(sch_1):page1_i1@tubii_tk2_lib.tubii_pcb(sch_1):page1_i2@tubii_tk2_lib.clocks(sch_1):page1_i1@tubii_tk2_lib.default_clk_sel(sch_1):unnamed_1_mc10h104_i4_a2'; 'UNNAMED_1_MC10H104_I4_A2'
LOGICAL_PATH '@tubii_tk2_lib.tubii(sch_1):page1_i1@tubii_tk2_lib.tubii_pcb(sch_1):page1_i1@tubii_tk2_lib.microzed_module(sch_1):unnamed_1_ledl_i102_a'; 'UNNAMED_1_LEDL_I102_A'
LOGICAL_PATH '@tubii_tk2_lib.tubii(sch_1):page1_i1@tubii_tk2_lib.tubii_pcb(sch_1):page1_i1@tubii_tk2_lib.microzed_module(sch_1):vccio_en_o'; 'VCCIO_EN_O'
LOGICAL_PATH '@tubii_tk2_lib.tubii(sch_1):page1_i1@tubii_tk2_lib.tubii_pcb(sch_1):page1_i1@tubii_tk2_lib.microzed_module(sch_1):vbat'; 'VBAT'
LOGICAL_PATH '@tubii_tk2_lib.tubii(sch_1):page1_i1@tubii_tk2_lib.tubii_pcb(sch_1):page1_i1@tubii_tk2_lib.microzed_module(sch_1):pwr_good'; 'PWR_GOOD'
LOGICAL_PATH '@tubii_tk2_lib.tubii(sch_1):page1_i1@tubii_tk2_lib.tubii_pcb(sch_1):page1_i1@tubii_tk2_lib.microzed_module(sch_1):pwr_en'; 'PWR_EN'
LOGICAL_PATH '@tubii_tk2_lib.tubii(sch_1):page1_i1@tubii_tk2_lib.tubii_pcb(sch_1):page1_i1@tubii_tk2_lib.microzed_module(sch_1):mz_happy'; 'MZ_HAPPY'
LOGICAL_PATH '@tubii_tk2_lib.tubii(sch_1):page1_i1@tubii_tk2_lib.tubii_pcb(sch_1):page1_i1@tubii_tk2_lib.microzed_module(sch_1):jx2_se_1'; 'JX2_SE_1'
LOGICAL_PATH '@tubii_tk2_lib.tubii(sch_1):page1_i1@tubii_tk2_lib.tubii_pcb(sch_1):page1_i1@tubii_tk2_lib.microzed_module(sch_1):jx2_se_0'; 'JX2_SE_0'
LOGICAL_PATH '@tubii_tk2_lib.tubii(sch_1):page1_i1@tubii_tk2_lib.tubii_pcb(sch_1):page1_i1@tubii_tk2_lib.microzed_module(sch_1):jx1_se_0'; 'JX1_SE_0'
LOGICAL_PATH '@tubii_tk2_lib.tubii(sch_1):page1_i1@tubii_tk2_lib.tubii_pcb(sch_1):page1_i1@tubii_tk2_lib.microzed_module(sch_1):jtag_tdo'; 'JTAG_TDO'
LOGICAL_PATH '@tubii_tk2_lib.tubii(sch_1):page1_i1@tubii_tk2_lib.tubii_pcb(sch_1):page1_i1@tubii_tk2_lib.microzed_module(sch_1):jtag_tck'; 'JTAG_TCK'
LOGICAL_PATH '@tubii_tk2_lib.tubii(sch_1):page1_i1@tubii_tk2_lib.tubii_pcb(sch_1):page1_i1@tubii_tk2_lib.microzed_module(sch_1):\init#\'; 'INIT#'
LOGICAL_PATH '@tubii_tk2_lib.tubii(sch_1):page1_i1@tubii_tk2_lib.tubii_pcb(sch_1):page1_i2@tubii_tk2_lib.clocks(sch_1):unnamed_1_dr610f1button_i24_b1'; 'UNNAMED_1_DR610F1BUTTON_I24_B1'
LOGICAL_PATH '@tubii_tk2_lib.tubii(sch_1):page1_i1@tubii_tk2_lib.tubii_pcb(sch_1):page1_i2@tubii_tk2_lib.clocks(sch_1):unnamed_1_defaultclksel_i1_reset'; 'UNNAMED_1_DEFAULTCLKSEL_I1_RE_1'
LOGICAL_PATH '@tubii_tk2_lib.tubii(sch_1):page1_i1@tubii_tk2_lib.tubii_pcb(sch_1):unnamed_1_microzedmodule_i1_mtcamimictrig2'; 'UNNAMED_1_MICROZEDMODULE_I1_M_2'
LOGICAL_PATH '@tubii_tk2_lib.tubii(sch_1):page1_i1@tubii_tk2_lib.tubii_pcb(sch_1):unnamed_1_microzedmodule_i1_mtcamimictrig1'; 'UNNAMED_1_MICROZEDMODULE_I1_M_1'
LOGICAL_PATH '@tubii_tk2_lib.tubii(sch_1):page1_i1@tubii_tk2_lib.tubii_pcb(sch_1):page1_i8@tubii_tk2_lib.caen_coms(sch_1):page1_i1@tubii_tk2_lib.caen_analog_coms(sch_1):unnamed_1_pickering113fc_i63_cntrl'; 'UNNAMED_1_PICKERING113FC_I63_CN'
LOGICAL_PATH '@tubii_tk2_lib.tubii(sch_1):page1_i1@tubii_tk2_lib.tubii_pcb(sch_1):page1_i8@tubii_tk2_lib.caen_coms(sch_1):page1_i1@tubii_tk2_lib.caen_analog_coms(sch_1):unnamed_1_pickering113fc_i62_cntrl'; 'UNNAMED_1_PICKERING113FC_I62_CN'
LOGICAL_PATH '@tubii_tk2_lib.tubii(sch_1):page1_i1@tubii_tk2_lib.tubii_pcb(sch_1):page1_i8@tubii_tk2_lib.caen_coms(sch_1):page1_i1@tubii_tk2_lib.caen_analog_coms(sch_1):unnamed_1_pickering113fc_i61_cntrl'; 'UNNAMED_1_PICKERING113FC_I61_CN'
LOGICAL_PATH '@tubii_tk2_lib.tubii(sch_1):page1_i1@tubii_tk2_lib.tubii_pcb(sch_1):page1_i8@tubii_tk2_lib.caen_coms(sch_1):page1_i1@tubii_tk2_lib.caen_analog_coms(sch_1):unnamed_1_pickering113fc_i60_cntrl'; 'UNNAMED_1_PICKERING113FC_I60_CN'
LOGICAL_PATH '@tubii_tk2_lib.tubii(sch_1):page1_i1@tubii_tk2_lib.tubii_pcb(sch_1):page1_i11@tubii_tk2_lib.tubii_spkr(sch_1):unnamed_1_led1206_i29_a'; 'UNNAMED_1_LED1206_I29_A'
LOGICAL_PATH '@tubii_tk2_lib.tubii(sch_1):page1_i1@tubii_tk2_lib.tubii_pcb(sch_1):page1_i11@tubii_tk2_lib.tubii_spkr(sch_1):unnamed_1_led1206_i28_a'; 'UNNAMED_1_LED1206_I28_A'
LOGICAL_PATH '@tubii_tk2_lib.tubii(sch_1):page1_i1@tubii_tk2_lib.tubii_pcb(sch_1):page1_i3@tubii_tk2_lib.mtca_mimic(sch_1):unnamed_1_rsmd0805_i45_b'; 'UNNAMED_1_RSMD0805_I45_B'
LOGICAL_PATH '@tubii_tk2_lib.tubii(sch_1):page1_i1@tubii_tk2_lib.tubii_pcb(sch_1):page1_i2@tubii_tk2_lib.clocks(sch_1):page1_i2@tubii_tk2_lib.fault_detection(sch_1):unnamed_1_mc10h131_i59_d2'; 'UNNAMED_1_MC10H131_I59_D2'
LOGICAL_PATH '@tubii_tk2_lib.tubii(sch_1):page1_i1@tubii_tk2_lib.tubii_pcb(sch_1):page1_i2@tubii_tk2_lib.clocks(sch_1):page1_i2@tubii_tk2_lib.fault_detection(sch_1):unnamed_1_mc10h131_i59_d1'; 'UNNAMED_1_MC10H131_I59_D1'
LOGICAL_PATH '@tubii_tk2_lib.tubii(sch_1):page1_i1@tubii_tk2_lib.tubii_pcb(sch_1):page1_i2@tubii_tk2_lib.clocks(sch_1):page1_i2@tubii_tk2_lib.fault_detection(sch_1):unnamed_1_mc10h131_i59_cc'; 'UNNAMED_1_MC10H131_I59_CC'
LOGICAL_PATH '@tubii_tk2_lib.tubii(sch_1):page1_i1@tubii_tk2_lib.tubii_pcb(sch_1):page1_i2@tubii_tk2_lib.clocks(sch_1):page1_i2@tubii_tk2_lib.fault_detection(sch_1):unnamed_1_mc10e016_i48_tcld'; 'UNNAMED_1_MC10E016_I48_TCLD'
LOGICAL_PATH '@tubii_tk2_lib.tubii(sch_1):page1_i1@tubii_tk2_lib.tubii_pcb(sch_1):page1_i3@tubii_tk2_lib.mtca_mimic(sch_1):unnamed_1_ad96687_i1_le2'; 'UNNAMED_1_AD96687_I1_LE2'
LOGICAL_PATH '@tubii_tk2_lib.tubii(sch_1):page1_i1@tubii_tk2_lib.tubii_pcb(sch_1):page1_i3@tubii_tk2_lib.mtca_mimic(sch_1):unnamed_1_ad96687_i1_le1'; 'UNNAMED_1_AD96687_I1_LE1'
LOGICAL_PATH '@tubii_tk2_lib.tubii(sch_1):page1_i1@tubii_tk2_lib.tubii_pcb(sch_1):page1_i8@tubii_tk2_lib.caen_coms(sch_1):page1_i1@tubii_tk2_lib.caen_analog_coms(sch_1):unnamed_1_caenbuffer_i5_cntrl'; 'UNNAMED_1_CAENBUFFER_I5_CNTRL'
LOGICAL_PATH '@tubii_tk2_lib.tubii(sch_1):page1_i1@tubii_tk2_lib.tubii_pcb(sch_1):page1_i8@tubii_tk2_lib.caen_coms(sch_1):page1_i1@tubii_tk2_lib.caen_analog_coms(sch_1):unnamed_1_caenbuffer_i24_cntrl'; 'UNNAMED_1_CAENBUFFER_I24_CNTRL'
LOGICAL_PATH '@tubii_tk2_lib.tubii(sch_1):page1_i1@tubii_tk2_lib.tubii_pcb(sch_1):page1_i8@tubii_tk2_lib.caen_coms(sch_1):page1_i1@tubii_tk2_lib.caen_analog_coms(sch_1):unnamed_1_caenbuffer_i20_cntrl'; 'UNNAMED_1_CAENBUFFER_I20_CNTRL'
LOGICAL_PATH '@tubii_tk2_lib.tubii(sch_1):page1_i1@tubii_tk2_lib.tubii_pcb(sch_1):page1_i8@tubii_tk2_lib.caen_coms(sch_1):page1_i1@tubii_tk2_lib.caen_analog_coms(sch_1):unnamed_1_caenbuffer_i19_cntrl'; 'UNNAMED_1_CAENBUFFER_I19_CNTRL'
LOGICAL_PATH '@tubii_tk2_lib.tubii(sch_1):page1_i1@tubii_tk2_lib.tubii_pcb(sch_1):page1_i8@tubii_tk2_lib.caen_coms(sch_1):page1_i1@tubii_tk2_lib.caen_analog_coms(sch_1):unnamed_1_caenbuffer_i18_cntrl'; 'UNNAMED_1_CAENBUFFER_I18_CNTRL'
LOGICAL_PATH '@tubii_tk2_lib.tubii(sch_1):page1_i1@tubii_tk2_lib.tubii_pcb(sch_1):page1_i8@tubii_tk2_lib.caen_coms(sch_1):page1_i1@tubii_tk2_lib.caen_analog_coms(sch_1):page1_i58@tubii_tk2_lib.vref_gen(sch_1):unnamed_1_ref02_i1_vout'; 'UNNAMED_1_REF02_I1_VOUT'
LOGICAL_PATH '@tubii_tk2_lib.tubii(sch_1):page1_i1@tubii_tk2_lib.tubii_pcb(sch_1):page1_i8@tubii_tk2_lib.caen_coms(sch_1):page1_i1@tubii_tk2_lib.caen_analog_coms(sch_1):page1_i58@tubii_tk2_lib.vref_gen(sch_1):unnamed_1_opa277_i2_in'; 'UNNAMED_1_OPA277_I2_IN'
LOGICAL_PATH '@tubii_tk2_lib.tubii(sch_1):page1_i1@tubii_tk2_lib.tubii_pcb(sch_1):page1_i8@tubii_tk2_lib.caen_coms(sch_1):page1_i1@tubii_tk2_lib.caen_analog_coms(sch_1):unnamed_1_caenbuffer_i18_vref5m'; 'UNNAMED_1_CAENBUFFER_I18_VREF5M'
LOGICAL_PATH '@tubii_tk2_lib.tubii(sch_1):page1_i1@tubii_tk2_lib.tubii_pcb(sch_1):page1_i3@tubii_tk2_lib.mtca_mimic(sch_1):page1_i16@tubii_tk2_lib.trigger_logic(sch_1):unnamed_1_mc10h131_i62_d2'; 'UNNAMED_1_MC10H131_I62_D2'
LOGICAL_PATH '@tubii_tk2_lib.tubii(sch_1):page1_i1@tubii_tk2_lib.tubii_pcb(sch_1):page1_i3@tubii_tk2_lib.mtca_mimic(sch_1):page1_i16@tubii_tk2_lib.trigger_logic(sch_1):unnamed_1_mc10h131_i62_d1'; 'UNNAMED_1_MC10H131_I62_D1'
LOGICAL_PATH '@tubii_tk2_lib.tubii(sch_1):page1_i1@tubii_tk2_lib.tubii_pcb(sch_1):page1_i3@tubii_tk2_lib.mtca_mimic(sch_1):page1_i16@tubii_tk2_lib.trigger_logic(sch_1):unnamed_1_mc10h131_i62_cc'; 'UNNAMED_1_MC10H131_I62_CC'
LOGICAL_PATH '@tubii_tk2_lib.tubii(sch_1):page1_i1@tubii_tk2_lib.tubii_pcb(sch_1):page1_i4@tubii_tk2_lib.general_utilities(sch_1):page1_i20@tubii_tk2_lib.ecl_translation(sch_1):vbb_trans'; 'VBB_TRANS'
LOGICAL_PATH '@tubii_tk2_lib.tubii(sch_1):vcc15m'; 'VCC15M'
VOLTAGE '-15V'; 'VCC15M'
LOGICAL_PATH '@tubii_tk2_lib.tubii(sch_1):vcc15'; 'VCC15'
VOLTAGE '15V'; 'VCC15'
LOGICAL_PATH '@tubii_tk2_lib.tubii(sch_1):v3p3'; 'V3P3'
VOLTAGE '3.3V'; 'V3P3'
LOGICAL_PATH '@tubii_tk2_lib.tubii(sch_1):page1_i1@tubii_tk2_lib.tubii_pcb(sch_1):page1_i2@tubii_tk2_lib.clocks(sch_1):page1_i3@tubii_tk2_lib.change_clks(sch_1):use_default_p'; 'USE_DEFAULT_P'
LOGICAL_PATH '@tubii_tk2_lib.tubii(sch_1):page1_i1@tubii_tk2_lib.tubii_pcb(sch_1):page1_i2@tubii_tk2_lib.clocks(sch_1):page1_i3@tubii_tk2_lib.change_clks(sch_1):use_default_n'; 'USE_DEFAULT_N'
LOGICAL_PATH '@tubii_tk2_lib.tubii(sch_1):page1_i1@tubii_tk2_lib.tubii_pcb(sch_1):page1_i2@tubii_tk2_lib.clocks(sch_1):page1_i3@tubii_tk2_lib.change_clks(sch_1):use_bckp_p'; 'USE_BCKP_P'
LOGICAL_PATH '@tubii_tk2_lib.tubii(sch_1):page1_i1@tubii_tk2_lib.tubii_pcb(sch_1):page1_i2@tubii_tk2_lib.clocks(sch_1):page1_i3@tubii_tk2_lib.change_clks(sch_1):use_bckp_n'; 'USE_BCKP_N'
LOGICAL_PATH '@tubii_tk2_lib.tubii(sch_1):page1_i1@tubii_tk2_lib.tubii_pcb(sch_1):page1_i3@tubii_tk2_lib.mtca_mimic(sch_1):unnamed_1_ss22sdp2_i35_p2'; 'UNNAMED_1_SS22SDP2_I35_P2'
LOGICAL_PATH '@tubii_tk2_lib.tubii(sch_1):page1_i1@tubii_tk2_lib.tubii_pcb(sch_1):page1_i3@tubii_tk2_lib.mtca_mimic(sch_1):unnamed_1_ss22sdp2_i35_p1'; 'UNNAMED_1_SS22SDP2_I35_P1'
LOGICAL_PATH '@tubii_tk2_lib.tubii(sch_1):page1_i1@tubii_tk2_lib.tubii_pcb(sch_1):page1_i3@tubii_tk2_lib.mtca_mimic(sch_1):unnamed_1_ss22sdp2_i34_ta2'; 'UNNAMED_1_SS22SDP2_I34_TA2'
LOGICAL_PATH '@tubii_tk2_lib.tubii(sch_1):page1_i1@tubii_tk2_lib.tubii_pcb(sch_1):page1_i3@tubii_tk2_lib.mtca_mimic(sch_1):unnamed_1_ss22sdp2_i34_p2'; 'UNNAMED_1_SS22SDP2_I34_P2'
LOGICAL_PATH '@tubii_tk2_lib.tubii(sch_1):page1_i1@tubii_tk2_lib.tubii_pcb(sch_1):page1_i3@tubii_tk2_lib.mtca_mimic(sch_1):unnamed_1_ss22sdp2_i34_p1'; 'UNNAMED_1_SS22SDP2_I34_P1'
LOGICAL_PATH '@tubii_tk2_lib.tubii(sch_1):page1_i1@tubii_tk2_lib.tubii_pcb(sch_1):page1_i11@tubii_tk2_lib.tubii_spkr(sch_1):unnamed_1_rsmd0805_i5_b'; 'UNNAMED_1_RSMD0805_I5_B'
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
LOGICAL_PATH '@tubii_tk2_lib.tubii(sch_1):page1_i1@tubii_tk2_lib.tubii_pcb(sch_1):page1_i8@tubii_tk2_lib.caen_coms(sch_1):page1_i1@tubii_tk2_lib.caen_analog_coms(sch_1):page1_i18@tubii_tk2_lib.caen_buffer(sch_1):unnamed_1_resl_i11_a'; 'UNNAMED_1_RESL_I11_A_1'
LOGICAL_PATH '@tubii_tk2_lib.tubii(sch_1):page1_i1@tubii_tk2_lib.tubii_pcb(sch_1):page1_i8@tubii_tk2_lib.caen_coms(sch_1):page1_i1@tubii_tk2_lib.caen_analog_coms(sch_1):page1_i5@tubii_tk2_lib.caen_buffer(sch_1):unnamed_1_resl_i11_a'; 'UNNAMED_1_RESL_I11_A'
LOGICAL_PATH '@tubii_tk2_lib.tubii(sch_1):page1_i1@tubii_tk2_lib.tubii_pcb(sch_1):page1_i8@tubii_tk2_lib.caen_coms(sch_1):page1_i1@tubii_tk2_lib.caen_analog_coms(sch_1):page1_i24@tubii_tk2_lib.caen_buffer(sch_1):unnamed_1_resl_i10_b'; 'UNNAMED_1_RESL_I10_B_7'
LOGICAL_PATH '@tubii_tk2_lib.tubii(sch_1):page1_i1@tubii_tk2_lib.tubii_pcb(sch_1):page1_i8@tubii_tk2_lib.caen_coms(sch_1):page1_i1@tubii_tk2_lib.caen_analog_coms(sch_1):page1_i23@tubii_tk2_lib.caen_buffer(sch_1):unnamed_1_resl_i10_b'; 'UNNAMED_1_RESL_I10_B_6'
LOGICAL_PATH '@tubii_tk2_lib.tubii(sch_1):page1_i1@tubii_tk2_lib.tubii_pcb(sch_1):page1_i8@tubii_tk2_lib.caen_coms(sch_1):page1_i1@tubii_tk2_lib.caen_analog_coms(sch_1):page1_i22@tubii_tk2_lib.caen_buffer(sch_1):unnamed_1_resl_i10_b'; 'UNNAMED_1_RESL_I10_B_5'
LOGICAL_PATH '@tubii_tk2_lib.tubii(sch_1):page1_i1@tubii_tk2_lib.tubii_pcb(sch_1):page1_i8@tubii_tk2_lib.caen_coms(sch_1):page1_i1@tubii_tk2_lib.caen_analog_coms(sch_1):page1_i21@tubii_tk2_lib.caen_buffer(sch_1):unnamed_1_resl_i10_b'; 'UNNAMED_1_RESL_I10_B_4'
LOGICAL_PATH '@tubii_tk2_lib.tubii(sch_1):page1_i1@tubii_tk2_lib.tubii_pcb(sch_1):page1_i8@tubii_tk2_lib.caen_coms(sch_1):page1_i1@tubii_tk2_lib.caen_analog_coms(sch_1):page1_i20@tubii_tk2_lib.caen_buffer(sch_1):unnamed_1_resl_i10_b'; 'UNNAMED_1_RESL_I10_B_3'
LOGICAL_PATH '@tubii_tk2_lib.tubii(sch_1):page1_i1@tubii_tk2_lib.tubii_pcb(sch_1):page1_i8@tubii_tk2_lib.caen_coms(sch_1):page1_i1@tubii_tk2_lib.caen_analog_coms(sch_1):page1_i19@tubii_tk2_lib.caen_buffer(sch_1):unnamed_1_resl_i10_b'; 'UNNAMED_1_RESL_I10_B_2'
LOGICAL_PATH '@tubii_tk2_lib.tubii(sch_1):page1_i1@tubii_tk2_lib.tubii_pcb(sch_1):page1_i8@tubii_tk2_lib.caen_coms(sch_1):page1_i1@tubii_tk2_lib.caen_analog_coms(sch_1):page1_i18@tubii_tk2_lib.caen_buffer(sch_1):unnamed_1_resl_i10_b'; 'UNNAMED_1_RESL_I10_B_1'
LOGICAL_PATH '@tubii_tk2_lib.tubii(sch_1):page1_i1@tubii_tk2_lib.tubii_pcb(sch_1):page1_i8@tubii_tk2_lib.caen_coms(sch_1):page1_i1@tubii_tk2_lib.caen_analog_coms(sch_1):page1_i5@tubii_tk2_lib.caen_buffer(sch_1):unnamed_1_resl_i10_b'; 'UNNAMED_1_RESL_I10_B'
LOGICAL_PATH '@tubii_tk2_lib.tubii(sch_1):page1_i1@tubii_tk2_lib.tubii_pcb(sch_1):page1_i4@tubii_tk2_lib.general_utilities(sch_1):page1_i20@tubii_tk2_lib.ecl_translation(sch_1):unnamed_1_mpsh81_i17_c'; 'UNNAMED_1_MPSH81_I17_C'
LOGICAL_PATH '@tubii_tk2_lib.tubii(sch_1):page1_i1@tubii_tk2_lib.tubii_pcb(sch_1):page1_i8@tubii_tk2_lib.caen_coms(sch_1):page1_i2@tubii_tk2_lib.caen_dig_coms(sch_1):unnamed_1_mmbth81_i9_c'; 'UNNAMED_1_MMBTH81_I9_C'
LOGICAL_PATH '@tubii_tk2_lib.tubii(sch_1):page1_i1@tubii_tk2_lib.tubii_pcb(sch_1):unnamed_1_microzedmodule_i1_mtcamimicdatardy'; 'UNNAMED_1_MICROZEDMODULE_I1_MTC'
LOGICAL_PATH '@tubii_tk2_lib.tubii(sch_1):page1_i1@tubii_tk2_lib.tubii_pcb(sch_1):page1_i3@tubii_tk2_lib.mtca_mimic(sch_1):page1_i16@tubii_tk2_lib.trigger_logic(sch_1):unnamed_1_mc10h131_i17_ce1'; 'UNNAMED_1_MC10H131_I17_CE1'
LOGICAL_PATH '@tubii_tk2_lib.tubii(sch_1):page1_i1@tubii_tk2_lib.tubii_pcb(sch_1):page1_i3@tubii_tk2_lib.mtca_mimic(sch_1):page1_i16@tubii_tk2_lib.trigger_logic(sch_1):unnamed_1_mc10e116_i63_q1'; 'UNNAMED_1_MC10E116_I63_Q1'
LOGICAL_PATH '@tubii_tk2_lib.tubii(sch_1):page1_i1@tubii_tk2_lib.tubii_pcb(sch_1):page1_i3@tubii_tk2_lib.mtca_mimic(sch_1):page1_i16@tubii_tk2_lib.trigger_logic(sch_1):unnamed_1_mc10e116_i63_q0'; 'UNNAMED_1_MC10E116_I63_Q0'
LOGICAL_PATH '@tubii_tk2_lib.tubii(sch_1):page1_i1@tubii_tk2_lib.tubii_pcb(sch_1):page1_i70@tubii_tk2_lib.ext_trigs(sch_1):unnamed_1_mc10e116_i4_q3_1'; 'UNNAMED_1_MC10E116_I4_Q3_1'
LOGICAL_PATH '@tubii_tk2_lib.tubii(sch_1):page1_i1@tubii_tk2_lib.tubii_pcb(sch_1):page1_i70@tubii_tk2_lib.ext_trigs(sch_1):unnamed_1_mc10e116_i4_q3'; 'UNNAMED_1_MC10E116_I4_Q3'
LOGICAL_PATH '@tubii_tk2_lib.tubii(sch_1):page1_i1@tubii_tk2_lib.tubii_pcb(sch_1):page1_i70@tubii_tk2_lib.ext_trigs(sch_1):unnamed_1_mc10e116_i4_q2_1'; 'UNNAMED_1_MC10E116_I4_Q2_1'
LOGICAL_PATH '@tubii_tk2_lib.tubii(sch_1):page1_i1@tubii_tk2_lib.tubii_pcb(sch_1):page1_i70@tubii_tk2_lib.ext_trigs(sch_1):unnamed_1_mc10e116_i4_q2'; 'UNNAMED_1_MC10E116_I4_Q2'
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
LOGICAL_PATH '@tubii_tk2_lib.tubii(sch_1):page1_i1@tubii_tk2_lib.tubii_pcb(sch_1):page1_i2@tubii_tk2_lib.clocks(sch_1):page1_i2@tubii_tk2_lib.fault_detection(sch_1):unnamed_1_mc10e116_i1_q0_1'; 'UNNAMED_1_MC10E116_I1_Q0_1'
LOGICAL_PATH '@tubii_tk2_lib.tubii(sch_1):page1_i1@tubii_tk2_lib.tubii_pcb(sch_1):page1_i2@tubii_tk2_lib.clocks(sch_1):page1_i2@tubii_tk2_lib.fault_detection(sch_1):unnamed_1_mc10e116_i1_q0'; 'UNNAMED_1_MC10E116_I1_Q0'
LOGICAL_PATH '@tubii_tk2_lib.tubii(sch_1):page1_i1@tubii_tk2_lib.tubii_pcb(sch_1):page1_i2@tubii_tk2_lib.clocks(sch_1):page1_i2@tubii_tk2_lib.fault_detection(sch_1):unnamed_1_mc10e116_i1_d0'; 'UNNAMED_1_MC10E116_I1_D0'
LOGICAL_PATH '@tubii_tk2_lib.tubii(sch_1):page1_i1@tubii_tk2_lib.tubii_pcb(sch_1):unnamed_1_logen_i13_lostar2'; 'UNNAMED_1_LOGEN_I13_LOSTAR2'
LOGICAL_PATH '@tubii_tk2_lib.tubii(sch_1):page1_i1@tubii_tk2_lib.tubii_pcb(sch_1):unnamed_1_logen_i13_dgt2'; 'UNNAMED_1_LOGEN_I13_DGT2'
LOGICAL_PATH '@tubii_tk2_lib.tubii(sch_1):page1_i1@tubii_tk2_lib.tubii_pcb(sch_1):page1_i3@tubii_tk2_lib.mtca_mimic(sch_1):page1_i16@tubii_tk2_lib.trigger_logic(sch_1):unnamed_1_ledl_i50_a'; 'UNNAMED_1_LEDL_I50_A'
LOGICAL_PATH '@tubii_tk2_lib.tubii(sch_1):page1_i1@tubii_tk2_lib.tubii_pcb(sch_1):page1_i3@tubii_tk2_lib.mtca_mimic(sch_1):page1_i16@tubii_tk2_lib.trigger_logic(sch_1):unnamed_1_ledl_i49_a'; 'UNNAMED_1_LEDL_I49_A'
LOGICAL_PATH '@tubii_tk2_lib.tubii(sch_1):page1_i1@tubii_tk2_lib.tubii_pcb(sch_1):page1_i5@tubii_tk2_lib.power(sch_1):unnamed_1_ledl_i46_b'; 'UNNAMED_1_LEDL_I46_B'
LOGICAL_PATH '@tubii_tk2_lib.tubii(sch_1):page1_i1@tubii_tk2_lib.tubii_pcb(sch_1):page1_i5@tubii_tk2_lib.power(sch_1):unnamed_1_ledl_i44_a'; 'UNNAMED_1_LEDL_I44_A'
LOGICAL_PATH '@tubii_tk2_lib.tubii(sch_1):page1_i1@tubii_tk2_lib.tubii_pcb(sch_1):page1_i5@tubii_tk2_lib.power(sch_1):unnamed_1_ledl_i42_b'; 'UNNAMED_1_LEDL_I42_B'
LOGICAL_PATH '@tubii_tk2_lib.tubii(sch_1):page1_i1@tubii_tk2_lib.tubii_pcb(sch_1):page1_i6@tubii_tk2_lib.ecal_control(sch_1):unnamed_1_ledl_i3_a'; 'UNNAMED_1_LEDL_I3_A'
LOGICAL_PATH '@tubii_tk2_lib.tubii(sch_1):page1_i1@tubii_tk2_lib.tubii_pcb(sch_1):page1_i2@tubii_tk2_lib.clocks(sch_1):page1_i2@tubii_tk2_lib.fault_detection(sch_1):unnamed_1_ledl_i33_a'; 'UNNAMED_1_LEDL_I33_A'
LOGICAL_PATH '@tubii_tk2_lib.tubii(sch_1):page1_i1@tubii_tk2_lib.tubii_pcb(sch_1):page1_i2@tubii_tk2_lib.clocks(sch_1):page1_i2@tubii_tk2_lib.fault_detection(sch_1):unnamed_1_ledl_i32_a'; 'UNNAMED_1_LEDL_I32_A'
LOGICAL_PATH '@tubii_tk2_lib.tubii(sch_1):page1_i1@tubii_tk2_lib.tubii_pcb(sch_1):page1_i5@tubii_tk2_lib.power(sch_1):unnamed_1_ledl_i25_a'; 'UNNAMED_1_LEDL_I25_A'
LOGICAL_PATH '@tubii_tk2_lib.tubii(sch_1):page1_i1@tubii_tk2_lib.tubii_pcb(sch_1):page1_i5@tubii_tk2_lib.power(sch_1):unnamed_1_ledl_i19_b'; 'UNNAMED_1_LEDL_I19_B'
LOGICAL_PATH '@tubii_tk2_lib.tubii(sch_1):page1_i1@tubii_tk2_lib.tubii_pcb(sch_1):page1_i4@tubii_tk2_lib.general_utilities(sch_1):page1_i5@tubii_tk2_lib.generic_delays(sch_1):unnamed_1_ledl_i18_a'; 'UNNAMED_1_LEDL_I18_A_1'
LOGICAL_PATH '@tubii_tk2_lib.tubii(sch_1):page1_i1@tubii_tk2_lib.tubii_pcb(sch_1):page1_i4@tubii_tk2_lib.general_utilities(sch_1):page1_i5@tubii_tk2_lib.generic_delays(sch_1):unnamed_1_ledl_i17_a'; 'UNNAMED_1_LEDL_I17_A'
LOGICAL_PATH '@tubii_tk2_lib.tubii(sch_1):page1_i1@tubii_tk2_lib.tubii_pcb(sch_1):page1_i5@tubii_tk2_lib.power(sch_1):unnamed_1_ledl_i12_a'; 'UNNAMED_1_LEDL_I12_A'
LOGICAL_PATH '@tubii_tk2_lib.tubii(sch_1):page1_i1@tubii_tk2_lib.tubii_pcb(sch_1):page1_i5@tubii_tk2_lib.power(sch_1):vcc24m_raw'; 'VCC24M_RAW'
LOGICAL_PATH '@tubii_tk2_lib.tubii(sch_1):page1_i1@tubii_tk2_lib.tubii_pcb(sch_1):page1_i5@tubii_tk2_lib.power(sch_1):vcc24_raw'; 'VCC24_RAW'
LOGICAL_PATH '@tubii_tk2_lib.tubii(sch_1):page1_i1@tubii_tk2_lib.tubii_pcb(sch_1):page1_i5@tubii_tk2_lib.power(sch_1):vee_raw'; 'VEE_RAW'
LOGICAL_PATH '@tubii_tk2_lib.tubii(sch_1):page1_i1@tubii_tk2_lib.tubii_pcb(sch_1):page1_i5@tubii_tk2_lib.power(sch_1):vcc_raw'; 'VCC_RAW'
LOGICAL_PATH '@tubii_tk2_lib.tubii(sch_1):page1_i1@tubii_tk2_lib.tubii_pcb(sch_1):unnamed_1_hct238_i53_a2'; 'UNNAMED_1_HCT238_I53_A2'
LOGICAL_PATH '@tubii_tk2_lib.tubii(sch_1):page1_i1@tubii_tk2_lib.tubii_pcb(sch_1):unnamed_1_hct238_i53_a0'; 'UNNAMED_1_HCT238_I53_A0'
LOGICAL_PATH '@tubii_tk2_lib.tubii(sch_1):unnamed_2_frontports_i2_scopeoutanal(6)'; 'UNNAMED_2_FRONTPORTS_I2_SCOP<6>'
LOGICAL_PATH '@tubii_tk2_lib.tubii(sch_1):unnamed_2_frontports_i2_scopeoutanal(4)'; 'UNNAMED_2_FRONTPORTS_I2_SCOP<4>'
LOGICAL_PATH '@tubii_tk2_lib.tubii(sch_1):unnamed_2_frontports_i2_scopeoutanal(2)'; 'UNNAMED_2_FRONTPORTS_I2_SCOP<2>'
LOGICAL_PATH '@tubii_tk2_lib.tubii(sch_1):unnamed_2_frontports_i2_scopeoutanal(0)'; 'UNNAMED_2_FRONTPORTS_I2_SCOP<0>'
LOGICAL_PATH '@tubii_tk2_lib.tubii(sch_1):unnamed_2_frontports_i2_scaler(5)'; 'UNNAMED_2_FRONTPORTS_I2_SCAL<5>'
LOGICAL_PATH '@tubii_tk2_lib.tubii(sch_1):unnamed_2_frontports_i2_scaler(3)'; 'UNNAMED_2_FRONTPORTS_I2_SCAL<3>'
LOGICAL_PATH '@tubii_tk2_lib.tubii(sch_1):unnamed_2_frontports_i2_scaler(1)'; 'UNNAMED_2_FRONTPORTS_I2_SCAL<1>'
LOGICAL_PATH '@tubii_tk2_lib.tubii(sch_1):unnamed_2_frontports_i2_pulseinanal(8)'; 'UNNAMED_2_FRONTPORTS_I2_PULS<8>'
LOGICAL_PATH '@tubii_tk2_lib.tubii(sch_1):unnamed_2_frontports_i2_pulseinanal(6)'; 'UNNAMED_2_FRONTPORTS_I2_PULS<6>'
LOGICAL_PATH '@tubii_tk2_lib.tubii(sch_1):unnamed_2_frontports_i2_pulseinanal(4)'; 'UNNAMED_2_FRONTPORTS_I2_PULS<4>'
LOGICAL_PATH '@tubii_tk2_lib.tubii(sch_1):unnamed_2_frontports_i2_pulseinanal(2)'; 'UNNAMED_2_FRONTPORTS_I2_PULS<2>'
LOGICAL_PATH '@tubii_tk2_lib.tubii(sch_1):unnamed_2_frontports_i2_pulseinanal(0)'; 'UNNAMED_2_FRONTPORTS_I2_PULS<0>'
LOGICAL_PATH '@tubii_tk2_lib.tubii(sch_1):unnamed_2_frontports_i2_pulseinanal(10)'; 'UNNAMED_2_FRONTPORTS_I2_PUL<10>'
LOGICAL_PATH '@tubii_tk2_lib.tubii(sch_1):unnamed_2_frontports_i2_exttrigin(8)'; 'UNNAMED_2_FRONTPORTS_I2_EXTT<8>'
LOGICAL_PATH '@tubii_tk2_lib.tubii(sch_1):unnamed_2_frontports_i2_exttrigin(6)'; 'UNNAMED_2_FRONTPORTS_I2_EXTT<6>'
LOGICAL_PATH '@tubii_tk2_lib.tubii(sch_1):unnamed_2_frontports_i2_exttrigin(4)'; 'UNNAMED_2_FRONTPORTS_I2_EXTT<4>'
LOGICAL_PATH '@tubii_tk2_lib.tubii(sch_1):unnamed_2_frontports_i2_exttrigin(2)'; 'UNNAMED_2_FRONTPORTS_I2_EXTT<2>'
LOGICAL_PATH '@tubii_tk2_lib.tubii(sch_1):unnamed_2_frontports_i2_exttrigin(0)'; 'UNNAMED_2_FRONTPORTS_I2_EXTT<0>'
LOGICAL_PATH '@tubii_tk2_lib.tubii(sch_1):unnamed_2_frontports_i2_exttrigin(14)'; 'UNNAMED_2_FRONTPORTS_I2_EXT<14>'
LOGICAL_PATH '@tubii_tk2_lib.tubii(sch_1):unnamed_2_frontports_i2_exttrigin(12)'; 'UNNAMED_2_FRONTPORTS_I2_EXT<12>'
LOGICAL_PATH '@tubii_tk2_lib.tubii(sch_1):unnamed_2_frontports_i2_exttrigin(10)'; 'UNNAMED_2_FRONTPORTS_I2_EXT<10>'
LOGICAL_PATH '@tubii_tk2_lib.tubii(sch_1):unnamed_2_frontports_i2_ecltolvdsoutn'; 'UNNAMED_2_FRONTPORTS_I2_ECLTO_1'
LOGICAL_PATH '@tubii_tk2_lib.tubii(sch_1):unnamed_2_frontports_i2_dgtn'; 'UNNAMED_2_FRONTPORTS_I2_DGTN'
SPACING_CONSTRAINT_SET 'SCSDIFFPAIR'; 'UNNAMED_2_FRONTPORTS_I2_DGTN' 'UNNAMED_2_FRONTPORTS_I2_DGTP' 'UNNAMED_2_FRONTPORTS_I2_ECLTO_1' 'UNNAMED_2_FRONTPORTS_I2_ECLTO_2'
LOGICAL_PATH '@tubii_tk2_lib.tubii(sch_1):unnamed_2_frontports_i2_clk100p'; 'UNNAMED_2_FRONTPORTS_I2_CLK100P'
LOGICAL_PATH '@tubii_tk2_lib.tubii(sch_1):unnamed_2_frontports_i2_clk100n'; 'UNNAMED_2_FRONTPORTS_I2_CLK100N'
LOGICAL_PATH '@tubii_tk2_lib.tubii(sch_1):unnamed_2_frontports_i2_caenoutanal(7)'; 'UNNAMED_2_FRONTPORTS_I2_CAEN<7>'
LOGICAL_PATH '@tubii_tk2_lib.tubii(sch_1):unnamed_2_frontports_i2_caenoutanal(5)'; 'UNNAMED_2_FRONTPORTS_I2_CAEN<5>'
LOGICAL_PATH '@tubii_tk2_lib.tubii(sch_1):unnamed_2_frontports_i2_caenoutanal(3)'; 'UNNAMED_2_FRONTPORTS_I2_CAEN<3>'
LOGICAL_PATH '@tubii_tk2_lib.tubii(sch_1):unnamed_2_frontports_i2_caenoutanal(1)'; 'UNNAMED_2_FRONTPORTS_I2_CAEN<1>'
LOGICAL_PATH '@tubii_tk2_lib.tubii(sch_1):page1_i1@tubii_tk2_lib.tubii_pcb(sch_1):unnamed_1_exttrigs_i70_exttrigout(9)'; 'UNNAMED_1_EXTTRIGS_I70_EXTTR<9>'
LOGICAL_PATH '@tubii_tk2_lib.tubii(sch_1):page1_i1@tubii_tk2_lib.tubii_pcb(sch_1):unnamed_1_exttrigs_i70_exttrigout(7)'; 'UNNAMED_1_EXTTRIGS_I70_EXTTR<7>'
LOGICAL_PATH '@tubii_tk2_lib.tubii(sch_1):page1_i1@tubii_tk2_lib.tubii_pcb(sch_1):unnamed_1_exttrigs_i70_exttrigout(5)'; 'UNNAMED_1_EXTTRIGS_I70_EXTTR<5>'
LOGICAL_PATH '@tubii_tk2_lib.tubii(sch_1):page1_i1@tubii_tk2_lib.tubii_pcb(sch_1):unnamed_1_exttrigs_i70_exttrigout(3)'; 'UNNAMED_1_EXTTRIGS_I70_EXTTR<3>'
LOGICAL_PATH '@tubii_tk2_lib.tubii(sch_1):page1_i1@tubii_tk2_lib.tubii_pcb(sch_1):unnamed_1_exttrigs_i70_exttrigout(1)'; 'UNNAMED_1_EXTTRIGS_I70_EXTTR<1>'
LOGICAL_PATH '@tubii_tk2_lib.tubii(sch_1):page1_i1@tubii_tk2_lib.tubii_pcb(sch_1):unnamed_1_exttrigs_i70_exttrigout(15)'; 'UNNAMED_1_EXTTRIGS_I70_EXTT<15>'
LOGICAL_PATH '@tubii_tk2_lib.tubii(sch_1):page1_i1@tubii_tk2_lib.tubii_pcb(sch_1):unnamed_1_exttrigs_i70_exttrigout(13)'; 'UNNAMED_1_EXTTRIGS_I70_EXTT<13>'
LOGICAL_PATH '@tubii_tk2_lib.tubii(sch_1):page1_i1@tubii_tk2_lib.tubii_pcb(sch_1):unnamed_1_exttrigs_i70_exttrigout(11)'; 'UNNAMED_1_EXTTRIGS_I70_EXTT<11>'
LOGICAL_PATH '@tubii_tk2_lib.tubii(sch_1):page1_i1@tubii_tk2_lib.tubii_pcb(sch_1):unnamed_1_elliecoms_i9_telliepulse'; 'UNNAMED_1_ELLIECOMS_I9_TELLIEPU'
LOGICAL_PATH '@tubii_tk2_lib.tubii(sch_1):page1_i1@tubii_tk2_lib.tubii_pcb(sch_1):unnamed_1_elliecoms_i9_telliepredelayttl'; 'UNNAMED_1_ELLIECOMS_I9_TELLIEPR'
LOGICAL_PATH '@tubii_tk2_lib.tubii(sch_1):page1_i1@tubii_tk2_lib.tubii_pcb(sch_1):unnamed_1_elliecoms_i9_telliedelayoutttl'; 'UNNAMED_1_ELLIECOMS_I9_TELLIEDE'
LOGICAL_PATH '@tubii_tk2_lib.tubii(sch_1):page1_i1@tubii_tk2_lib.tubii_pcb(sch_1):unnamed_1_elliecoms_i9_smelliepulse'; 'UNNAMED_1_ELLIECOMS_I9_SMELLI_1'
LOGICAL_PATH '@tubii_tk2_lib.tubii(sch_1):page1_i1@tubii_tk2_lib.tubii_pcb(sch_1):unnamed_1_elliecoms_i9_smelliepredelayttl'; 'UNNAMED_1_ELLIECOMS_I9_SMELLIEP'
LOGICAL_PATH '@tubii_tk2_lib.tubii(sch_1):page1_i1@tubii_tk2_lib.tubii_pcb(sch_1):unnamed_1_elliecoms_i9_smelliedelayoutttl'; 'UNNAMED_1_ELLIECOMS_I9_SMELLIED'
LOGICAL_PATH '@tubii_tk2_lib.tubii(sch_1):page1_i1@tubii_tk2_lib.tubii_pcb(sch_1):page1_i4@tubii_tk2_lib.general_utilities(sch_1):page1_i20@tubii_tk2_lib.ecl_translation(sch_1):unnamed_1_ds90lv019_i14_rout'; 'UNNAMED_1_DS90LV019_I14_ROUT'
LOGICAL_PATH '@tubii_tk2_lib.tubii(sch_1):page1_i1@tubii_tk2_lib.tubii_pcb(sch_1):page1_i4@tubii_tk2_lib.general_utilities(sch_1):page1_i20@tubii_tk2_lib.ecl_translation(sch_1):unnamed_1_ds90lv019_i14_din'; 'UNNAMED_1_DS90LV019_I14_DIN'
LOGICAL_PATH '@tubii_tk2_lib.tubii(sch_1):page1_i1@tubii_tk2_lib.tubii_pcb(sch_1):page1_i4@tubii_tk2_lib.general_utilities(sch_1):page1_i5@tubii_tk2_lib.generic_delays(sch_1):unnamed_1_ds102350_i1_q'; 'UNNAMED_1_DS102350_I1_Q'
LOGICAL_PATH '@tubii_tk2_lib.tubii(sch_1):page1_i1@tubii_tk2_lib.tubii_pcb(sch_1):page1_i2@tubii_tk2_lib.clocks(sch_1):unnamed_1_defaultclksel_i1_reseteclp'; 'UNNAMED_1_DEFAULTCLKSEL_I1_RESE'
LOGICAL_PATH '@tubii_tk2_lib.tubii(sch_1):page1_i1@tubii_tk2_lib.tubii_pcb(sch_1):page1_i2@tubii_tk2_lib.clocks(sch_1):unnamed_1_defaultclksel_i1_defaultclk'; 'UNNAMED_1_DEFAULTCLKSEL_I1_DEFA'
LOGICAL_PATH '@tubii_tk2_lib.tubii(sch_1):page1_i1@tubii_tk2_lib.tubii_pcb(sch_1):page1_i2@tubii_tk2_lib.clocks(sch_1):unnamed_1_defaultclksel_i1_bckpclk'; 'UNNAMED_1_DEFAULTCLKSEL_I1_BCKP'
LOGICAL_PATH '@tubii_tk2_lib.tubii(sch_1):page1_i1@tubii_tk2_lib.tubii_pcb(sch_1):page1_i12@tubii_tk2_lib.baseline_buffer(sch_1):unnamed_1_csmd0805_i9_b'; 'UNNAMED_1_CSMD0805_I9_B_1'
LOGICAL_PATH '@tubii_tk2_lib.tubii(sch_1):page1_i1@tubii_tk2_lib.tubii_pcb(sch_1):page1_i3@tubii_tk2_lib.mtca_mimic(sch_1):unnamed_1_csmd0805_i9_b'; 'UNNAMED_1_CSMD0805_I9_B'
LOGICAL_PATH '@tubii_tk2_lib.tubii(sch_1):page1_i1@tubii_tk2_lib.tubii_pcb(sch_1):page1_i3@tubii_tk2_lib.mtca_mimic(sch_1):unnamed_1_csmd0805_i8_b'; 'UNNAMED_1_CSMD0805_I8_B'
LOGICAL_PATH '@tubii_tk2_lib.tubii(sch_1):page1_i1@tubii_tk2_lib.tubii_pcb(sch_1):page1_i12@tubii_tk2_lib.baseline_buffer(sch_1):unnamed_1_csmd0805_i8_a'; 'UNNAMED_1_CSMD0805_I8_A_1'
LOGICAL_PATH '@tubii_tk2_lib.tubii(sch_1):page1_i1@tubii_tk2_lib.tubii_pcb(sch_1):page1_i12@tubii_tk2_lib.baseline_buffer(sch_1):unnamed_1_csmd0805_i7_a'; 'UNNAMED_1_CSMD0805_I7_A_1'
LOGICAL_PATH '@tubii_tk2_lib.tubii(sch_1):page1_i1@tubii_tk2_lib.tubii_pcb(sch_1):page1_i3@tubii_tk2_lib.mtca_mimic(sch_1):page1_i16@tubii_tk2_lib.trigger_logic(sch_1):unnamed_1_csmd0805_i71_a'; 'UNNAMED_1_CSMD0805_I71_A'
LOGICAL_PATH '@tubii_tk2_lib.tubii(sch_1):page1_i1@tubii_tk2_lib.tubii_pcb(sch_1):page1_i3@tubii_tk2_lib.mtca_mimic(sch_1):page1_i16@tubii_tk2_lib.trigger_logic(sch_1):unnamed_1_csmd0805_i70_b'; 'UNNAMED_1_CSMD0805_I70_B'
LOGICAL_PATH '@tubii_tk2_lib.tubii(sch_1):page1_i1@tubii_tk2_lib.tubii_pcb(sch_1):page1_i12@tubii_tk2_lib.baseline_buffer(sch_1):unnamed_1_csmd0805_i6_a'; 'UNNAMED_1_CSMD0805_I6_A'
LOGICAL_PATH '@tubii_tk2_lib.tubii(sch_1):page1_i1@tubii_tk2_lib.tubii_pcb(sch_1):page1_i3@tubii_tk2_lib.mtca_mimic(sch_1):page1_i16@tubii_tk2_lib.trigger_logic(sch_1):unnamed_1_csmd0805_i64_b'; 'UNNAMED_1_CSMD0805_I64_B'
LOGICAL_PATH '@tubii_tk2_lib.tubii(sch_1):page1_i1@tubii_tk2_lib.tubii_pcb(sch_1):page1_i3@tubii_tk2_lib.mtca_mimic(sch_1):page1_i16@tubii_tk2_lib.trigger_logic(sch_1):unnamed_1_csmd0805_i57_b'; 'UNNAMED_1_CSMD0805_I57_B'
LOGICAL_PATH '@tubii_tk2_lib.tubii(sch_1):page1_i1@tubii_tk2_lib.tubii_pcb(sch_1):page1_i3@tubii_tk2_lib.mtca_mimic(sch_1):page1_i16@tubii_tk2_lib.trigger_logic(sch_1):unnamed_1_csmd0805_i46_b'; 'UNNAMED_1_CSMD0805_I46_B'
LOGICAL_PATH '@tubii_tk2_lib.tubii(sch_1):page1_i1@tubii_tk2_lib.tubii_pcb(sch_1):page1_i11@tubii_tk2_lib.tubii_spkr(sch_1):unnamed_1_csmd0805_i23_b'; 'UNNAMED_1_CSMD0805_I23_B'
LOGICAL_PATH '@tubii_tk2_lib.tubii(sch_1):page1_i1@tubii_tk2_lib.tubii_pcb(sch_1):page1_i11@tubii_tk2_lib.tubii_spkr(sch_1):unnamed_1_csmd0805_i22_b'; 'UNNAMED_1_CSMD0805_I22_B'
LOGICAL_PATH '@tubii_tk2_lib.tubii(sch_1):page1_i1@tubii_tk2_lib.tubii_pcb(sch_1):page1_i11@tubii_tk2_lib.tubii_spkr(sch_1):unnamed_1_csmd0805_i21_b'; 'UNNAMED_1_CSMD0805_I21_B_8'
LOGICAL_PATH '@tubii_tk2_lib.tubii(sch_1):page1_i1@tubii_tk2_lib.tubii_pcb(sch_1):page1_i8@tubii_tk2_lib.caen_coms(sch_1):page1_i1@tubii_tk2_lib.caen_analog_coms(sch_1):page1_i24@tubii_tk2_lib.caen_buffer(sch_1):unnamed_1_csmd0805_i20_b'; 'UNNAMED_1_CSMD0805_I20_B_7'
LOGICAL_PATH '@tubii_tk2_lib.tubii(sch_1):page1_i1@tubii_tk2_lib.tubii_pcb(sch_1):page1_i8@tubii_tk2_lib.caen_coms(sch_1):page1_i1@tubii_tk2_lib.caen_analog_coms(sch_1):page1_i23@tubii_tk2_lib.caen_buffer(sch_1):unnamed_1_csmd0805_i20_b'; 'UNNAMED_1_CSMD0805_I20_B_6'
LOGICAL_PATH '@tubii_tk2_lib.tubii(sch_1):page1_i1@tubii_tk2_lib.tubii_pcb(sch_1):page1_i8@tubii_tk2_lib.caen_coms(sch_1):page1_i1@tubii_tk2_lib.caen_analog_coms(sch_1):page1_i22@tubii_tk2_lib.caen_buffer(sch_1):unnamed_1_csmd0805_i20_b'; 'UNNAMED_1_CSMD0805_I20_B_5'
LOGICAL_PATH '@tubii_tk2_lib.tubii(sch_1):page1_i1@tubii_tk2_lib.tubii_pcb(sch_1):page1_i8@tubii_tk2_lib.caen_coms(sch_1):page1_i1@tubii_tk2_lib.caen_analog_coms(sch_1):page1_i21@tubii_tk2_lib.caen_buffer(sch_1):unnamed_1_csmd0805_i20_b'; 'UNNAMED_1_CSMD0805_I20_B_4'
LOGICAL_PATH '@tubii_tk2_lib.tubii(sch_1):page1_i1@tubii_tk2_lib.tubii_pcb(sch_1):page1_i8@tubii_tk2_lib.caen_coms(sch_1):page1_i1@tubii_tk2_lib.caen_analog_coms(sch_1):page1_i20@tubii_tk2_lib.caen_buffer(sch_1):unnamed_1_csmd0805_i20_b'; 'UNNAMED_1_CSMD0805_I20_B_3'
LOGICAL_PATH '@tubii_tk2_lib.tubii(sch_1):page1_i1@tubii_tk2_lib.tubii_pcb(sch_1):page1_i8@tubii_tk2_lib.caen_coms(sch_1):page1_i1@tubii_tk2_lib.caen_analog_coms(sch_1):page1_i19@tubii_tk2_lib.caen_buffer(sch_1):unnamed_1_csmd0805_i20_b'; 'UNNAMED_1_CSMD0805_I20_B_2'
LOGICAL_PATH '@tubii_tk2_lib.tubii(sch_1):page1_i1@tubii_tk2_lib.tubii_pcb(sch_1):page1_i8@tubii_tk2_lib.caen_coms(sch_1):page1_i1@tubii_tk2_lib.caen_analog_coms(sch_1):page1_i18@tubii_tk2_lib.caen_buffer(sch_1):unnamed_1_csmd0805_i20_b'; 'UNNAMED_1_CSMD0805_I20_B_1'
LOGICAL_PATH '@tubii_tk2_lib.tubii(sch_1):page1_i1@tubii_tk2_lib.tubii_pcb(sch_1):page1_i8@tubii_tk2_lib.caen_coms(sch_1):page1_i1@tubii_tk2_lib.caen_analog_coms(sch_1):page1_i5@tubii_tk2_lib.caen_buffer(sch_1):unnamed_1_csmd0805_i20_b'; 'UNNAMED_1_CSMD0805_I20_B'
LOGICAL_PATH '@tubii_tk2_lib.tubii(sch_1):page1_i1@tubii_tk2_lib.tubii_pcb(sch_1):page1_i4@tubii_tk2_lib.general_utilities(sch_1):page1_i5@tubii_tk2_lib.generic_delays(sch_1):unnamed_1_csmd0805_i14_b'; 'UNNAMED_1_CSMD0805_I14_B_1'
LOGICAL_PATH '@tubii_tk2_lib.tubii(sch_1):page1_i1@tubii_tk2_lib.tubii_pcb(sch_1):page1_i4@tubii_tk2_lib.general_utilities(sch_1):page1_i5@tubii_tk2_lib.generic_delays(sch_1):unnamed_1_csmd0805_i13_b'; 'UNNAMED_1_CSMD0805_I13_B'
LOGICAL_PATH '@tubii_tk2_lib.tubii(sch_1):page1_i1@tubii_tk2_lib.tubii_pcb(sch_1):page1_i12@tubii_tk2_lib.baseline_buffer(sch_1):unnamed_1_csmd0805_i11_a'; 'UNNAMED_1_CSMD0805_I11_A'
LOGICAL_PATH '@tubii_tk2_lib.tubii(sch_1):page1_i1@tubii_tk2_lib.tubii_pcb(sch_1):page1_i12@tubii_tk2_lib.baseline_buffer(sch_1):unnamed_1_csmd0805_i10_a'; 'UNNAMED_1_CSMD0805_I10_A'
LOGICAL_PATH '@tubii_tk2_lib.tubii(sch_1):page1_i1@tubii_tk2_lib.tubii_pcb(sch_1):page1_i70@tubii_tk2_lib.ext_trigs(sch_1):unnamed_1_csmd0603_i55_a'; 'UNNAMED_1_CSMD0603_I55_A'
LOGICAL_PATH '@tubii_tk2_lib.tubii(sch_1):page1_i1@tubii_tk2_lib.tubii_pcb(sch_1):page1_i70@tubii_tk2_lib.ext_trigs(sch_1):unnamed_1_csmd0603_i54_b'; 'UNNAMED_1_CSMD0603_I54_B'
LOGICAL_PATH '@tubii_tk2_lib.tubii(sch_1):page1_i1@tubii_tk2_lib.tubii_pcb(sch_1):page1_i9@tubii_tk2_lib.ellie_coms(sch_1):unnamed_1_csmd0603_i10_b'; 'UNNAMED_1_CSMD0603_I10_B_1'
LOGICAL_PATH '@tubii_tk2_lib.tubii(sch_1):page1_i1@tubii_tk2_lib.tubii_pcb(sch_1):page1_i8@tubii_tk2_lib.caen_coms(sch_1):page1_i1@tubii_tk2_lib.caen_analog_coms(sch_1):page1_i24@tubii_tk2_lib.caen_buffer(sch_1):unnamed_1_coto2342_i1_no2'; 'UNNAMED_1_COTO2342_I1_NO2_7'
LOGICAL_PATH '@tubii_tk2_lib.tubii(sch_1):page1_i1@tubii_tk2_lib.tubii_pcb(sch_1):page1_i8@tubii_tk2_lib.caen_coms(sch_1):page1_i1@tubii_tk2_lib.caen_analog_coms(sch_1):page1_i23@tubii_tk2_lib.caen_buffer(sch_1):unnamed_1_coto2342_i1_no2'; 'UNNAMED_1_COTO2342_I1_NO2_6'
LOGICAL_PATH '@tubii_tk2_lib.tubii(sch_1):page1_i1@tubii_tk2_lib.tubii_pcb(sch_1):page1_i8@tubii_tk2_lib.caen_coms(sch_1):page1_i1@tubii_tk2_lib.caen_analog_coms(sch_1):page1_i22@tubii_tk2_lib.caen_buffer(sch_1):unnamed_1_coto2342_i1_no2'; 'UNNAMED_1_COTO2342_I1_NO2_5'
LOGICAL_PATH '@tubii_tk2_lib.tubii(sch_1):page1_i1@tubii_tk2_lib.tubii_pcb(sch_1):page1_i8@tubii_tk2_lib.caen_coms(sch_1):page1_i1@tubii_tk2_lib.caen_analog_coms(sch_1):page1_i21@tubii_tk2_lib.caen_buffer(sch_1):unnamed_1_coto2342_i1_no2'; 'UNNAMED_1_COTO2342_I1_NO2_4'
LOGICAL_PATH '@tubii_tk2_lib.tubii(sch_1):page1_i1@tubii_tk2_lib.tubii_pcb(sch_1):page1_i8@tubii_tk2_lib.caen_coms(sch_1):page1_i1@tubii_tk2_lib.caen_analog_coms(sch_1):page1_i20@tubii_tk2_lib.caen_buffer(sch_1):unnamed_1_coto2342_i1_no2'; 'UNNAMED_1_COTO2342_I1_NO2_3'
LOGICAL_PATH '@tubii_tk2_lib.tubii(sch_1):page1_i1@tubii_tk2_lib.tubii_pcb(sch_1):page1_i8@tubii_tk2_lib.caen_coms(sch_1):page1_i1@tubii_tk2_lib.caen_analog_coms(sch_1):page1_i19@tubii_tk2_lib.caen_buffer(sch_1):unnamed_1_coto2342_i1_no2'; 'UNNAMED_1_COTO2342_I1_NO2_2'
LOGICAL_PATH '@tubii_tk2_lib.tubii(sch_1):page1_i1@tubii_tk2_lib.tubii_pcb(sch_1):page1_i8@tubii_tk2_lib.caen_coms(sch_1):page1_i1@tubii_tk2_lib.caen_analog_coms(sch_1):page1_i18@tubii_tk2_lib.caen_buffer(sch_1):unnamed_1_coto2342_i1_no2'; 'UNNAMED_1_COTO2342_I1_NO2_1'
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
LOGICAL_PATH '@tubii_tk2_lib.tubii(sch_1):page1_i1@tubii_tk2_lib.tubii_pcb(sch_1):unnamed_1_cntrlregister_i10_regval'; 'UNNAMED_1_CNTRLREGISTER_I10_REG'
LOGICAL_PATH '@tubii_tk2_lib.tubii(sch_1):page1_i1@tubii_tk2_lib.tubii_pcb(sch_1):unnamed_1_cntrlregister_i10_readbit'; 'UNNAMED_1_CNTRLREGISTER_I10_REA'
LOGICAL_PATH '@tubii_tk2_lib.tubii(sch_1):page1_i1@tubii_tk2_lib.tubii_pcb(sch_1):unnamed_1_cntrlregister_i10_losel'; 'UNNAMED_1_CNTRLREGISTER_I10_LOS'
LOGICAL_PATH '@tubii_tk2_lib.tubii(sch_1):page1_i1@tubii_tk2_lib.tubii_pcb(sch_1):unnamed_1_cntrlregister_i10_ecalenable'; 'UNNAMED_1_CNTRLREGISTER_I10_ECA'
LOGICAL_PATH '@tubii_tk2_lib.tubii(sch_1):page1_i1@tubii_tk2_lib.tubii_pcb(sch_1):unnamed_1_cntrlregister_i10_datardy'; 'UNNAMED_1_CNTRLREGISTER_I10_DAT'
LOGICAL_PATH '@tubii_tk2_lib.tubii(sch_1):page1_i1@tubii_tk2_lib.tubii_pcb(sch_1):unnamed_1_clocks_i2_reset'; 'UNNAMED_1_CLOCKS_I2_RESET'
LOGICAL_PATH '@tubii_tk2_lib.tubii(sch_1):page1_i1@tubii_tk2_lib.tubii_pcb(sch_1):unnamed_1_clocks_i2_datardy'; 'UNNAMED_1_CLOCKS_I2_DATARDY'
LOGICAL_PATH '@tubii_tk2_lib.tubii(sch_1):page1_i1@tubii_tk2_lib.tubii_pcb(sch_1):unnamed_1_clocks_i2_clksel'; 'UNNAMED_1_CLOCKS_I2_CLKSEL'
LOGICAL_PATH '@tubii_tk2_lib.tubii(sch_1):page1_i1@tubii_tk2_lib.tubii_pcb(sch_1):unnamed_1_clocks_i2_clk100ttl'; 'UNNAMED_1_CLOCKS_I2_CLK100TTL'
LOGICAL_PATH '@tubii_tk2_lib.tubii(sch_1):page1_i1@tubii_tk2_lib.tubii_pcb(sch_1):unnamed_1_clocks_i2_bckpused'; 'UNNAMED_1_CLOCKS_I2_BCKPUSED'
LOGICAL_PATH '@tubii_tk2_lib.tubii(sch_1):page1_i1@tubii_tk2_lib.tubii_pcb(sch_1):page1_i2@tubii_tk2_lib.clocks(sch_1):unnamed_1_changeclks_i3_defaultclk2p'; 'UNNAMED_1_CHANGECLKS_I3_DEFAU_1'
LOGICAL_PATH '@tubii_tk2_lib.tubii(sch_1):page1_i1@tubii_tk2_lib.tubii_pcb(sch_1):page1_i2@tubii_tk2_lib.clocks(sch_1):unnamed_1_changeclks_i3_defaultclk2n'; 'UNNAMED_1_CHANGECLKS_I3_DEFAULT'
LOGICAL_PATH '@tubii_tk2_lib.tubii(sch_1):page1_i1@tubii_tk2_lib.tubii_pcb(sch_1):page1_i2@tubii_tk2_lib.clocks(sch_1):unnamed_1_changeclks_i3_changeclkp'; 'UNNAMED_1_CHANGECLKS_I3_CHANG_1'
LOGICAL_PATH '@tubii_tk2_lib.tubii(sch_1):page1_i1@tubii_tk2_lib.tubii_pcb(sch_1):page1_i2@tubii_tk2_lib.clocks(sch_1):unnamed_1_changeclks_i3_changeclkn'; 'UNNAMED_1_CHANGECLKS_I3_CHANGEC'
LOGICAL_PATH '@tubii_tk2_lib.tubii(sch_1):page1_i1@tubii_tk2_lib.tubii_pcb(sch_1):page1_i2@tubii_tk2_lib.clocks(sch_1):unnamed_1_changeclks_i3_bckpclk3p'; 'UNNAMED_1_CHANGECLKS_I3_BCKPC_3'
LOGICAL_PATH '@tubii_tk2_lib.tubii(sch_1):page1_i1@tubii_tk2_lib.tubii_pcb(sch_1):page1_i2@tubii_tk2_lib.clocks(sch_1):unnamed_1_changeclks_i3_bckpclk3n'; 'UNNAMED_1_CHANGECLKS_I3_BCKPC_2'
LOGICAL_PATH '@tubii_tk2_lib.tubii(sch_1):page1_i1@tubii_tk2_lib.tubii_pcb(sch_1):page1_i2@tubii_tk2_lib.clocks(sch_1):unnamed_1_changeclks_i3_bckpclk2p'; 'UNNAMED_1_CHANGECLKS_I3_BCKPC_1'
LOGICAL_PATH '@tubii_tk2_lib.tubii(sch_1):page1_i1@tubii_tk2_lib.tubii_pcb(sch_1):page1_i2@tubii_tk2_lib.clocks(sch_1):unnamed_1_changeclks_i3_bckpclk2n'; 'UNNAMED_1_CHANGECLKS_I3_BCKPCLK'
LOGICAL_PATH '@tubii_tk2_lib.tubii(sch_1):page1_i1@tubii_tk2_lib.tubii_pcb(sch_1):unnamed_1_caencoms_i8_syncttl'; 'UNNAMED_1_CAENCOMS_I8_SYNCTTL'
LOGICAL_PATH '@tubii_tk2_lib.tubii(sch_1):page1_i1@tubii_tk2_lib.tubii_pcb(sch_1):unnamed_1_caencoms_i8_sync24ttl'; 'UNNAMED_1_CAENCOMS_I8_SYNC24TTL'
LOGICAL_PATH '@tubii_tk2_lib.tubii(sch_1):page1_i1@tubii_tk2_lib.tubii_pcb(sch_1):unnamed_1_caencoms_i8_gtttl'; 'UNNAMED_1_CAENCOMS_I8_GTTTL'
LOGICAL_PATH '@tubii_tk2_lib.tubii(sch_1):page1_i1@tubii_tk2_lib.tubii_pcb(sch_1):unnamed_1_caencoms_i8_gt2p'; 'UNNAMED_1_CAENCOMS_I8_GT2P'
LOGICAL_PATH '@tubii_tk2_lib.tubii(sch_1):page1_i1@tubii_tk2_lib.tubii_pcb(sch_1):unnamed_1_caencoms_i8_datardy'; 'UNNAMED_1_CAENCOMS_I8_DATARDY'
LOGICAL_PATH '@tubii_tk2_lib.tubii(sch_1):page1_i1@tubii_tk2_lib.tubii_pcb(sch_1):page1_i8@tubii_tk2_lib.caen_coms(sch_1):page1_i1@tubii_tk2_lib.caen_analog_coms(sch_1):unnamed_1_caenbuffer_i5_inanal'; 'UNNAMED_1_CAENBUFFER_I5_INANAL'
LOGICAL_PATH '@tubii_tk2_lib.tubii(sch_1):page1_i1@tubii_tk2_lib.tubii_pcb(sch_1):page1_i8@tubii_tk2_lib.caen_coms(sch_1):page1_i1@tubii_tk2_lib.caen_analog_coms(sch_1):unnamed_1_caenbuffer_i20_inanal'; 'UNNAMED_1_CAENBUFFER_I20_INANAL'
LOGICAL_PATH '@tubii_tk2_lib.tubii(sch_1):page1_i1@tubii_tk2_lib.tubii_pcb(sch_1):page1_i8@tubii_tk2_lib.caen_coms(sch_1):page1_i1@tubii_tk2_lib.caen_analog_coms(sch_1):unnamed_1_caenbuffer_i19_inanal'; 'UNNAMED_1_CAENBUFFER_I19_INANAL'
LOGICAL_PATH '@tubii_tk2_lib.tubii(sch_1):page1_i1@tubii_tk2_lib.tubii_pcb(sch_1):page1_i8@tubii_tk2_lib.caen_coms(sch_1):page1_i1@tubii_tk2_lib.caen_analog_coms(sch_1):unnamed_1_caenbuffer_i18_inanal'; 'UNNAMED_1_CAENBUFFER_I18_INANAL'
LOGICAL_PATH '@tubii_tk2_lib.tubii(sch_1):page1_i1@tubii_tk2_lib.tubii_pcb(sch_1):page1_i3@tubii_tk2_lib.mtca_mimic(sch_1):unnamed_1_ad96687_i1_q2_1'; 'UNNAMED_1_AD96687_I1_Q2_1'
LOGICAL_PATH '@tubii_tk2_lib.tubii(sch_1):page1_i1@tubii_tk2_lib.tubii_pcb(sch_1):page1_i3@tubii_tk2_lib.mtca_mimic(sch_1):unnamed_1_ad96687_i1_q2'; 'UNNAMED_1_AD96687_I1_Q2'
LOGICAL_PATH '@tubii_tk2_lib.tubii(sch_1):page1_i1@tubii_tk2_lib.tubii_pcb(sch_1):page1_i3@tubii_tk2_lib.mtca_mimic(sch_1):unnamed_1_ad96687_i1_q1_1'; 'UNNAMED_1_AD96687_I1_Q1_1'
LOGICAL_PATH '@tubii_tk2_lib.tubii(sch_1):page1_i1@tubii_tk2_lib.tubii_pcb(sch_1):page1_i3@tubii_tk2_lib.mtca_mimic(sch_1):unnamed_1_ad96687_i1_q1'; 'UNNAMED_1_AD96687_I1_Q1'
LOGICAL_PATH '@tubii_tk2_lib.tubii(sch_1):page1_i1@tubii_tk2_lib.tubii_pcb(sch_1):page1_i4@tubii_tk2_lib.general_utilities(sch_1):page1_i1@tubii_tk2_lib.pulse_inverter(sch_1):unnamed_1_ad8009_i1_v_1'; 'UNNAMED_1_AD8009_I1_V_1'
LOGICAL_PATH '@tubii_tk2_lib.tubii(sch_1):page1_i1@tubii_tk2_lib.tubii_pcb(sch_1):page1_i4@tubii_tk2_lib.general_utilities(sch_1):page1_i1@tubii_tk2_lib.pulse_inverter(sch_1):unnamed_1_ad8009_i1_v'; 'UNNAMED_1_AD8009_I1_V'
LOGICAL_PATH '@tubii_tk2_lib.tubii(sch_1):page1_i1@tubii_tk2_lib.tubii_pcb(sch_1):page1_i4@tubii_tk2_lib.general_utilities(sch_1):page1_i1@tubii_tk2_lib.pulse_inverter(sch_1):unnamed_1_ad8009_i1_in'; 'UNNAMED_1_AD8009_I1_IN'
LOGICAL_PATH '@tubii_tk2_lib.tubii(sch_1):page1_i1@tubii_tk2_lib.tubii_pcb(sch_1):page1_i3@tubii_tk2_lib.mtca_mimic(sch_1):unnamed_1_ad7243_i2_vss'; 'UNNAMED_1_AD7243_I2_VSS'
LOGICAL_PATH '@tubii_tk2_lib.tubii(sch_1):page1_i1@tubii_tk2_lib.tubii_pcb(sch_1):page1_i3@tubii_tk2_lib.mtca_mimic(sch_1):unnamed_1_ad7243_i2_vdd'; 'UNNAMED_1_AD7243_I2_VDD'
LOGICAL_PATH '@tubii_tk2_lib.tubii(sch_1):page1_i1@tubii_tk2_lib.tubii_pcb(sch_1):page1_i3@tubii_tk2_lib.mtca_mimic(sch_1):unnamed_1_ad7243_i2_refin'; 'UNNAMED_1_AD7243_I2_REFIN'
LOGICAL_PATH '@tubii_tk2_lib.tubii(sch_1):page1_i1@tubii_tk2_lib.tubii_pcb(sch_1):page1_i5@tubii_tk2_lib.power(sch_1):vcc24m'; 'VCC24M'
VOLTAGE '-24V'; 'VCC24M'
LOGICAL_PATH '@tubii_tk2_lib.tubii(sch_1):page1_i1@tubii_tk2_lib.tubii_pcb(sch_1):page1_i5@tubii_tk2_lib.power(sch_1):vcc24'; 'VCC24'
VOLTAGE '24V'; 'VCC24'
LOGICAL_PATH '@tubii_tk2_lib.tubii(sch_1):page1_i1@tubii_tk2_lib.tubii_pcb(sch_1):page1_i2@tubii_tk2_lib.clocks(sch_1):unnamed_1_74hct164_i28_q7'; 'UNNAMED_1_74HCT164_I28_Q7'
LOGICAL_PATH '@tubii_tk2_lib.tubii(sch_1):page1_i1@tubii_tk2_lib.tubii_pcb(sch_1):page1_i2@tubii_tk2_lib.clocks(sch_1):unnamed_1_74hct164_i28_q6'; 'UNNAMED_1_74HCT164_I28_Q6'
LOGICAL_PATH '@tubii_tk2_lib.tubii(sch_1):page1_i1@tubii_tk2_lib.tubii_pcb(sch_1):page1_i2@tubii_tk2_lib.clocks(sch_1):unnamed_1_74hct164_i28_q5'; 'UNNAMED_1_74HCT164_I28_Q5'
LOGICAL_PATH '@tubii_tk2_lib.tubii(sch_1):page1_i1@tubii_tk2_lib.tubii_pcb(sch_1):page1_i2@tubii_tk2_lib.clocks(sch_1):unnamed_1_74hct164_i28_q4'; 'UNNAMED_1_74HCT164_I28_Q4'
LOGICAL_PATH '@tubii_tk2_lib.tubii(sch_1):page1_i1@tubii_tk2_lib.tubii_pcb(sch_1):page1_i2@tubii_tk2_lib.clocks(sch_1):unnamed_1_74hct164_i28_q3'; 'UNNAMED_1_74HCT164_I28_Q3'
LOGICAL_PATH '@tubii_tk2_lib.tubii(sch_1):page1_i1@tubii_tk2_lib.tubii_pcb(sch_1):page1_i2@tubii_tk2_lib.clocks(sch_1):unnamed_1_74hct164_i28_q2'; 'UNNAMED_1_74HCT164_I28_Q2'
LOGICAL_PATH '@tubii_tk2_lib.tubii(sch_1):page1_i1@tubii_tk2_lib.tubii_pcb(sch_1):page1_i2@tubii_tk2_lib.clocks(sch_1):unnamed_1_74hct164_i28_q1'; 'UNNAMED_1_74HCT164_I28_Q1'
LOGICAL_PATH '@tubii_tk2_lib.tubii(sch_1):page1_i1@tubii_tk2_lib.tubii_pcb(sch_1):page1_i2@tubii_tk2_lib.clocks(sch_1):unnamed_1_74hct164_i28_q0'; 'UNNAMED_1_74HCT164_I28_Q0'
LOGICAL_PATH '@tubii_tk2_lib.tubii(sch_1):page1_i1@tubii_tk2_lib.tubii_pcb(sch_1):page1_i8@tubii_tk2_lib.caen_coms(sch_1):page1_i1@tubii_tk2_lib.caen_analog_coms(sch_1):unnamed_1_74hct164_i65_q7'; 'UNNAMED_1_74HCT164_I65_Q7'
LOGICAL_PATH '@tubii_tk2_lib.tubii(sch_1):page1_i1@tubii_tk2_lib.tubii_pcb(sch_1):page1_i8@tubii_tk2_lib.caen_coms(sch_1):page1_i1@tubii_tk2_lib.caen_analog_coms(sch_1):unnamed_1_74hct164_i65_q6'; 'UNNAMED_1_74HCT164_I65_Q6'
LOGICAL_PATH '@tubii_tk2_lib.tubii(sch_1):page1_i1@tubii_tk2_lib.tubii_pcb(sch_1):page1_i8@tubii_tk2_lib.caen_coms(sch_1):page1_i1@tubii_tk2_lib.caen_analog_coms(sch_1):unnamed_1_74hct164_i65_q5'; 'UNNAMED_1_74HCT164_I65_Q5'
LOGICAL_PATH '@tubii_tk2_lib.tubii(sch_1):page1_i1@tubii_tk2_lib.tubii_pcb(sch_1):page1_i8@tubii_tk2_lib.caen_coms(sch_1):page1_i1@tubii_tk2_lib.caen_analog_coms(sch_1):unnamed_1_74hct164_i65_q4'; 'UNNAMED_1_74HCT164_I65_Q4'
LOGICAL_PATH '@tubii_tk2_lib.tubii(sch_1):page1_i1@tubii_tk2_lib.tubii_pcb(sch_1):page1_i8@tubii_tk2_lib.caen_coms(sch_1):page1_i1@tubii_tk2_lib.caen_analog_coms(sch_1):unnamed_1_74hct164_i65_q3'; 'UNNAMED_1_74HCT164_I65_Q3'
LOGICAL_PATH '@tubii_tk2_lib.tubii(sch_1):page1_i1@tubii_tk2_lib.tubii_pcb(sch_1):page1_i8@tubii_tk2_lib.caen_coms(sch_1):page1_i1@tubii_tk2_lib.caen_analog_coms(sch_1):unnamed_1_74hct164_i65_q2'; 'UNNAMED_1_74HCT164_I65_Q2'
LOGICAL_PATH '@tubii_tk2_lib.tubii(sch_1):page1_i1@tubii_tk2_lib.tubii_pcb(sch_1):page1_i8@tubii_tk2_lib.caen_coms(sch_1):page1_i1@tubii_tk2_lib.caen_analog_coms(sch_1):unnamed_1_74hct164_i65_q1'; 'UNNAMED_1_74HCT164_I65_Q1'
LOGICAL_PATH '@tubii_tk2_lib.tubii(sch_1):page1_i1@tubii_tk2_lib.tubii_pcb(sch_1):page1_i8@tubii_tk2_lib.caen_coms(sch_1):page1_i1@tubii_tk2_lib.caen_analog_coms(sch_1):unnamed_1_74hct164_i65_q0'; 'UNNAMED_1_74HCT164_I65_Q0'
LOGICAL_PATH '@tubii_tk2_lib.tubii(sch_1):page1_i1@tubii_tk2_lib.tubii_pcb(sch_1):page1_i8@tubii_tk2_lib.caen_coms(sch_1):page1_i1@tubii_tk2_lib.caen_analog_coms(sch_1):unnamed_1_74hct164_i64_q7'; 'UNNAMED_1_74HCT164_I64_Q7'
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
LOGICAL_PATH '@tubii_tk2_lib.tubii(sch_1):page1_i1@tubii_tk2_lib.tubii_pcb(sch_1):page1_i3@tubii_tk2_lib.mtca_mimic(sch_1):page1_i16@tubii_tk2_lib.trigger_logic(sch_1):trig_gate1_p'; 'TRIG_GATE1_P'
LOGICAL_PATH '@tubii_tk2_lib.tubii(sch_1):page1_i1@tubii_tk2_lib.tubii_pcb(sch_1):page1_i3@tubii_tk2_lib.mtca_mimic(sch_1):page1_i16@tubii_tk2_lib.trigger_logic(sch_1):trig_gate1_n'; 'TRIG_GATE1_N'
LOGICAL_PATH '@tubii_tk2_lib.tubii(sch_1):page1_i1@tubii_tk2_lib.tubii_pcb(sch_1):page1_i9@tubii_tk2_lib.ellie_coms(sch_1):tellie_delay_buf_p'; 'TELLIE_DELAY_BUF_P'
LOGICAL_PATH '@tubii_tk2_lib.tubii(sch_1):page1_i1@tubii_tk2_lib.tubii_pcb(sch_1):page1_i9@tubii_tk2_lib.ellie_coms(sch_1):tellie_delay_buf_n'; 'TELLIE_DELAY_BUF_N'
LOGICAL_PATH '@tubii_tk2_lib.tubii(sch_1):page1_i1@tubii_tk2_lib.tubii_pcb(sch_1):page1_i2@tubii_tk2_lib.clocks(sch_1):page1_i2@tubii_tk2_lib.fault_detection(sch_1):tc'; 'TC'
LOGICAL_PATH '@tubii_tk2_lib.tubii(sch_1):page1_i1@tubii_tk2_lib.tubii_pcb(sch_1):page1_i8@tubii_tk2_lib.caen_coms(sch_1):page1_i2@tubii_tk2_lib.caen_dig_coms(sch_1):sync_2_p'; 'SYNC_2_P'
LOGICAL_PATH '@tubii_tk2_lib.tubii(sch_1):page1_i1@tubii_tk2_lib.tubii_pcb(sch_1):page1_i8@tubii_tk2_lib.caen_coms(sch_1):page1_i2@tubii_tk2_lib.caen_dig_coms(sch_1):sync_2_n'; 'SYNC_2_N'
LOGICAL_PATH '@tubii_tk2_lib.tubii(sch_1):page1_i1@tubii_tk2_lib.tubii_pcb(sch_1):page1_i8@tubii_tk2_lib.caen_coms(sch_1):page1_i2@tubii_tk2_lib.caen_dig_coms(sch_1):sync24_2_p'; 'SYNC24_2_P'
LOGICAL_PATH '@tubii_tk2_lib.tubii(sch_1):page1_i1@tubii_tk2_lib.tubii_pcb(sch_1):page1_i8@tubii_tk2_lib.caen_coms(sch_1):page1_i2@tubii_tk2_lib.caen_dig_coms(sch_1):sync24_2_n'; 'SYNC24_2_N'
LOGICAL_PATH '@tubii_tk2_lib.tubii(sch_1):page1_i1@tubii_tk2_lib.tubii_pcb(sch_1):sr_data'; 'SR_DATA'
LOGICAL_PATH '@tubii_tk2_lib.tubii(sch_1):page1_i1@tubii_tk2_lib.tubii_pcb(sch_1):sr_clk'; 'SR_CLK'
LOGICAL_PATH '@tubii_tk2_lib.tubii(sch_1):page1_i1@tubii_tk2_lib.tubii_pcb(sch_1):spkr'; 'SPKR'
LOGICAL_PATH '@tubii_tk2_lib.tubii(sch_1):page1_i1@tubii_tk2_lib.tubii_pcb(sch_1):page1_i9@tubii_tk2_lib.ellie_coms(sch_1):smellie_delay_buf_p'; 'SMELLIE_DELAY_BUF_P'
LOGICAL_PATH '@tubii_tk2_lib.tubii(sch_1):page1_i1@tubii_tk2_lib.tubii_pcb(sch_1):page1_i9@tubii_tk2_lib.ellie_coms(sch_1):smellie_delay_buf_n'; 'SMELLIE_DELAY_BUF_N'
LOGICAL_PATH '@tubii_tk2_lib.tubii(sch_1):page1_i1@tubii_tk2_lib.tubii_pcb(sch_1):page1_i3@tubii_tk2_lib.mtca_mimic(sch_1):page1_i16@tubii_tk2_lib.trigger_logic(sch_1):set_retrig2'; 'SET_RETRIG2'
LOGICAL_PATH '@tubii_tk2_lib.tubii(sch_1):page1_i1@tubii_tk2_lib.tubii_pcb(sch_1):page1_i3@tubii_tk2_lib.mtca_mimic(sch_1):page1_i16@tubii_tk2_lib.trigger_logic(sch_1):set_retrig1'; 'SET_RETRIG1'
LOGICAL_PATH '@tubii_tk2_lib.tubii(sch_1):page1_i1@tubii_tk2_lib.tubii_pcb(sch_1):page1_i4@tubii_tk2_lib.general_utilities(sch_1):page1_i2@tubii_tk2_lib.ribbon_delay(sch_1):rib9_p'; 'RIB9_P'
LOGICAL_PATH '@tubii_tk2_lib.tubii(sch_1):page1_i1@tubii_tk2_lib.tubii_pcb(sch_1):page1_i4@tubii_tk2_lib.general_utilities(sch_1):page1_i2@tubii_tk2_lib.ribbon_delay(sch_1):rib9_n'; 'RIB9_N'
LOGICAL_PATH '@tubii_tk2_lib.tubii(sch_1):page1_i1@tubii_tk2_lib.tubii_pcb(sch_1):page1_i4@tubii_tk2_lib.general_utilities(sch_1):page1_i2@tubii_tk2_lib.ribbon_delay(sch_1):rib8_p'; 'RIB8_P'
LOGICAL_PATH '@tubii_tk2_lib.tubii(sch_1):page1_i1@tubii_tk2_lib.tubii_pcb(sch_1):page1_i4@tubii_tk2_lib.general_utilities(sch_1):page1_i2@tubii_tk2_lib.ribbon_delay(sch_1):rib8_n'; 'RIB8_N'
LOGICAL_PATH '@tubii_tk2_lib.tubii(sch_1):page1_i1@tubii_tk2_lib.tubii_pcb(sch_1):page1_i4@tubii_tk2_lib.general_utilities(sch_1):page1_i2@tubii_tk2_lib.ribbon_delay(sch_1):rib7_p'; 'RIB7_P'
LOGICAL_PATH '@tubii_tk2_lib.tubii(sch_1):page1_i1@tubii_tk2_lib.tubii_pcb(sch_1):page1_i4@tubii_tk2_lib.general_utilities(sch_1):page1_i2@tubii_tk2_lib.ribbon_delay(sch_1):rib7_n'; 'RIB7_N'
LOGICAL_PATH '@tubii_tk2_lib.tubii(sch_1):page1_i1@tubii_tk2_lib.tubii_pcb(sch_1):page1_i4@tubii_tk2_lib.general_utilities(sch_1):page1_i2@tubii_tk2_lib.ribbon_delay(sch_1):rib6_p'; 'RIB6_P'
LOGICAL_PATH '@tubii_tk2_lib.tubii(sch_1):page1_i1@tubii_tk2_lib.tubii_pcb(sch_1):page1_i4@tubii_tk2_lib.general_utilities(sch_1):page1_i2@tubii_tk2_lib.ribbon_delay(sch_1):rib6_n'; 'RIB6_N'
LOGICAL_PATH '@tubii_tk2_lib.tubii(sch_1):page1_i1@tubii_tk2_lib.tubii_pcb(sch_1):page1_i4@tubii_tk2_lib.general_utilities(sch_1):page1_i2@tubii_tk2_lib.ribbon_delay(sch_1):rib5_p'; 'RIB5_P'
LOGICAL_PATH '@tubii_tk2_lib.tubii(sch_1):page1_i1@tubii_tk2_lib.tubii_pcb(sch_1):page1_i4@tubii_tk2_lib.general_utilities(sch_1):page1_i2@tubii_tk2_lib.ribbon_delay(sch_1):rib5_n'; 'RIB5_N'
LOGICAL_PATH '@tubii_tk2_lib.tubii(sch_1):page1_i1@tubii_tk2_lib.tubii_pcb(sch_1):page1_i4@tubii_tk2_lib.general_utilities(sch_1):page1_i2@tubii_tk2_lib.ribbon_delay(sch_1):rib4_p'; 'RIB4_P'
LOGICAL_PATH '@tubii_tk2_lib.tubii(sch_1):page1_i1@tubii_tk2_lib.tubii_pcb(sch_1):page1_i4@tubii_tk2_lib.general_utilities(sch_1):page1_i2@tubii_tk2_lib.ribbon_delay(sch_1):rib4_n'; 'RIB4_N'
LOGICAL_PATH '@tubii_tk2_lib.tubii(sch_1):page1_i1@tubii_tk2_lib.tubii_pcb(sch_1):page1_i4@tubii_tk2_lib.general_utilities(sch_1):page1_i2@tubii_tk2_lib.ribbon_delay(sch_1):rib3_p'; 'RIB3_P'
LOGICAL_PATH '@tubii_tk2_lib.tubii(sch_1):page1_i1@tubii_tk2_lib.tubii_pcb(sch_1):page1_i4@tubii_tk2_lib.general_utilities(sch_1):page1_i2@tubii_tk2_lib.ribbon_delay(sch_1):rib3_n'; 'RIB3_N'
LOGICAL_PATH '@tubii_tk2_lib.tubii(sch_1):page1_i1@tubii_tk2_lib.tubii_pcb(sch_1):page1_i4@tubii_tk2_lib.general_utilities(sch_1):page1_i2@tubii_tk2_lib.ribbon_delay(sch_1):rib2_p'; 'RIB2_P'
LOGICAL_PATH '@tubii_tk2_lib.tubii(sch_1):page1_i1@tubii_tk2_lib.tubii_pcb(sch_1):page1_i4@tubii_tk2_lib.general_utilities(sch_1):page1_i2@tubii_tk2_lib.ribbon_delay(sch_1):rib2_n'; 'RIB2_N'
LOGICAL_PATH '@tubii_tk2_lib.tubii(sch_1):page1_i1@tubii_tk2_lib.tubii_pcb(sch_1):page1_i4@tubii_tk2_lib.general_utilities(sch_1):page1_i2@tubii_tk2_lib.ribbon_delay(sch_1):rib1_p'; 'RIB1_P'
LOGICAL_PATH '@tubii_tk2_lib.tubii(sch_1):page1_i1@tubii_tk2_lib.tubii_pcb(sch_1):page1_i4@tubii_tk2_lib.general_utilities(sch_1):page1_i2@tubii_tk2_lib.ribbon_delay(sch_1):rib1_n'; 'RIB1_N'
LOGICAL_PATH '@tubii_tk2_lib.tubii(sch_1):page1_i1@tubii_tk2_lib.tubii_pcb(sch_1):page1_i4@tubii_tk2_lib.general_utilities(sch_1):page1_i2@tubii_tk2_lib.ribbon_delay(sch_1):rib10_p'; 'RIB10_P'
LOGICAL_PATH '@tubii_tk2_lib.tubii(sch_1):page1_i1@tubii_tk2_lib.tubii_pcb(sch_1):page1_i4@tubii_tk2_lib.general_utilities(sch_1):page1_i2@tubii_tk2_lib.ribbon_delay(sch_1):rib10_n'; 'RIB10_N'
LOGICAL_PATH '@tubii_tk2_lib.tubii(sch_1):page1_i1@tubii_tk2_lib.tubii_pcb(sch_1):page1_i3@tubii_tk2_lib.mtca_mimic(sch_1):page1_i16@tubii_tk2_lib.trigger_logic(sch_1):retrig_gate2'; 'RETRIG_GATE2'
LOGICAL_PATH '@tubii_tk2_lib.tubii(sch_1):page1_i1@tubii_tk2_lib.tubii_pcb(sch_1):page1_i3@tubii_tk2_lib.mtca_mimic(sch_1):page1_i16@tubii_tk2_lib.trigger_logic(sch_1):retrig_gate1'; 'RETRIG_GATE1'
LOGICAL_PATH '@tubii_tk2_lib.tubii(sch_1):page1_i1@tubii_tk2_lib.tubii_pcb(sch_1):page1_i2@tubii_tk2_lib.clocks(sch_1):page1_i2@tubii_tk2_lib.fault_detection(sch_1):restart_count'; 'RESTART_COUNT'
LOGICAL_PATH '@tubii_tk2_lib.tubii(sch_1):page1_i1@tubii_tk2_lib.tubii_pcb(sch_1):page1_i2@tubii_tk2_lib.clocks(sch_1):page1_i1@tubii_tk2_lib.default_clk_sel(sch_1):reset_clk_div_ecl'; 'RESET_CLK_DIV_ECL'
LOGICAL_PATH '@tubii_tk2_lib.tubii(sch_1):page1_i1@tubii_tk2_lib.tubii_pcb(sch_1):page1_i3@tubii_tk2_lib.mtca_mimic(sch_1):page1_i16@tubii_tk2_lib.trigger_logic(sch_1):prep_retrig2'; 'PREP_RETRIG2'
LOGICAL_PATH '@tubii_tk2_lib.tubii(sch_1):page1_i1@tubii_tk2_lib.tubii_pcb(sch_1):page1_i3@tubii_tk2_lib.mtca_mimic(sch_1):page1_i16@tubii_tk2_lib.trigger_logic(sch_1):prep_retrig1'; 'PREP_RETRIG1'
LOGICAL_PATH '@tubii_tk2_lib.tubii(sch_1):page1_i1@tubii_tk2_lib.tubii_pcb(sch_1):page1_i3@tubii_tk2_lib.mtca_mimic(sch_1):page1_i16@tubii_tk2_lib.trigger_logic(sch_1):pos_trig2'; 'POS_TRIG2'
LOGICAL_PATH '@tubii_tk2_lib.tubii(sch_1):page1_i1@tubii_tk2_lib.tubii_pcb(sch_1):page1_i3@tubii_tk2_lib.mtca_mimic(sch_1):page1_i16@tubii_tk2_lib.trigger_logic(sch_1):pos_trig1'; 'POS_TRIG1'
LOGICAL_PATH '@tubii_tk2_lib.tubii(sch_1):page1_i1@tubii_tk2_lib.tubii_pcb(sch_1):page1_i3@tubii_tk2_lib.mtca_mimic(sch_1):page1_i16@tubii_tk2_lib.trigger_logic(sch_1):neg_trig2'; 'NEG_TRIG2'
LOGICAL_PATH '@tubii_tk2_lib.tubii(sch_1):page1_i1@tubii_tk2_lib.tubii_pcb(sch_1):page1_i3@tubii_tk2_lib.mtca_mimic(sch_1):page1_i16@tubii_tk2_lib.trigger_logic(sch_1):neg_trig1'; 'NEG_TRIG1'
LOGICAL_PATH '@tubii_tk2_lib.tubii(sch_1):page1_i1@tubii_tk2_lib.tubii_pcb(sch_1):page1_i2@tubii_tk2_lib.clocks(sch_1):page1_i2@tubii_tk2_lib.fault_detection(sch_1):\load_count*\'; 'LOAD_COUNT*'
LOGICAL_PATH '@tubii_tk2_lib.tubii(sch_1):page1_i1@tubii_tk2_lib.tubii_pcb(sch_1):le_mtca_mimic'; 'LE_MTCA_MIMIC'
LOGICAL_PATH '@tubii_tk2_lib.tubii(sch_1):page1_i1@tubii_tk2_lib.tubii_pcb(sch_1):le_gt_delays'; 'LE_GT_DELAYS'
LOGICAL_PATH '@tubii_tk2_lib.tubii(sch_1):page1_i1@tubii_tk2_lib.tubii_pcb(sch_1):le_gen_utils'; 'LE_GEN_UTILS'
LOGICAL_PATH '@tubii_tk2_lib.tubii(sch_1):page1_i1@tubii_tk2_lib.tubii_pcb(sch_1):le_cntrl_reg'; 'LE_CNTRL_REG'
LOGICAL_PATH '@tubii_tk2_lib.tubii(sch_1):page1_i1@tubii_tk2_lib.tubii_pcb(sch_1):le_clks'; 'LE_CLKS'
LOGICAL_PATH '@tubii_tk2_lib.tubii(sch_1):page1_i1@tubii_tk2_lib.tubii_pcb(sch_1):le_caen'; 'LE_CAEN'
LOGICAL_PATH '@tubii_tk2_lib.tubii(sch_1):page1_i1@tubii_tk2_lib.tubii_pcb(sch_1):page1_i1@tubii_tk2_lib.microzed_module(sch_1):jx2_guide_pin2'; 'JX2_GUIDE_PIN2'
LOGICAL_PATH '@tubii_tk2_lib.tubii(sch_1):page1_i1@tubii_tk2_lib.tubii_pcb(sch_1):page1_i1@tubii_tk2_lib.microzed_module(sch_1):jx2_guide_pin1'; 'JX2_GUIDE_PIN1'
LOGICAL_PATH '@tubii_tk2_lib.tubii(sch_1):page1_i1@tubii_tk2_lib.tubii_pcb(sch_1):page1_i1@tubii_tk2_lib.microzed_module(sch_1):jx1_se_1'; 'JX1_SE_1'
LOGICAL_PATH '@tubii_tk2_lib.tubii(sch_1):page1_i1@tubii_tk2_lib.tubii_pcb(sch_1):page1_i1@tubii_tk2_lib.microzed_module(sch_1):jx1_guide_pin2'; 'JX1_GUIDE_PIN2'
LOGICAL_PATH '@tubii_tk2_lib.tubii(sch_1):page1_i1@tubii_tk2_lib.tubii_pcb(sch_1):page1_i1@tubii_tk2_lib.microzed_module(sch_1):jx1_guide_pin1'; 'JX1_GUIDE_PIN1'
LOGICAL_PATH '@tubii_tk2_lib.tubii(sch_1):page1_i1@tubii_tk2_lib.tubii_pcb(sch_1):page1_i1@tubii_tk2_lib.microzed_module(sch_1):jtag_tms'; 'JTAG_TMS'
LOGICAL_PATH '@tubii_tk2_lib.tubii(sch_1):page1_i1@tubii_tk2_lib.tubii_pcb(sch_1):page1_i1@tubii_tk2_lib.microzed_module(sch_1):jtag_tdi'; 'JTAG_TDI'
LOGICAL_PATH '@tubii_tk2_lib.tubii(sch_1):page1_i1@tubii_tk2_lib.tubii_pcb(sch_1):page1_i1@tubii_tk2_lib.microzed_module(sch_1):i2c_sda'; 'I2C_SDA'
LOGICAL_PATH '@tubii_tk2_lib.tubii(sch_1):page1_i1@tubii_tk2_lib.tubii_pcb(sch_1):page1_i1@tubii_tk2_lib.microzed_module(sch_1):i2c_scl'; 'I2C_SCL'
LOGICAL_PATH '@tubii_tk2_lib.tubii(sch_1):page1_i1@tubii_tk2_lib.tubii_pcb(sch_1):page1_i8@tubii_tk2_lib.caen_coms(sch_1):page1_i2@tubii_tk2_lib.caen_dig_coms(sch_1):gt_2'; 'GT_2'
LOGICAL_PATH '@tubii_tk2_lib.tubii(sch_1):page1_i1@tubii_tk2_lib.tubii_pcb(sch_1):page1_i8@tubii_tk2_lib.caen_coms(sch_1):gt2_n'; 'GT2_N'
LOGICAL_PATH '@tubii_tk2_lib.tubii(sch_1):page1_i1@tubii_tk2_lib.tubii_pcb(sch_1):page1_i1@tubii_tk2_lib.microzed_module(sch_1):gpio5'; 'GPIO5'
LOGICAL_PATH '@tubii_tk2_lib.tubii(sch_1):page1_i1@tubii_tk2_lib.tubii_pcb(sch_1):page1_i1@tubii_tk2_lib.microzed_module(sch_1):gpio4'; 'GPIO4'
LOGICAL_PATH '@tubii_tk2_lib.tubii(sch_1):page1_i1@tubii_tk2_lib.tubii_pcb(sch_1):page1_i1@tubii_tk2_lib.microzed_module(sch_1):gpio3'; 'GPIO3'
LOGICAL_PATH '@tubii_tk2_lib.tubii(sch_1):page1_i1@tubii_tk2_lib.tubii_pcb(sch_1):page1_i1@tubii_tk2_lib.microzed_module(sch_1):gpio2'; 'GPIO2'
LOGICAL_PATH '@tubii_tk2_lib.tubii(sch_1):page1_i1@tubii_tk2_lib.tubii_pcb(sch_1):page1_i1@tubii_tk2_lib.microzed_module(sch_1):gpio1'; 'GPIO1'
LOGICAL_PATH '@tubii_tk2_lib.tubii(sch_1):page1_i1@tubii_tk2_lib.tubii_pcb(sch_1):page1_i1@tubii_tk2_lib.microzed_module(sch_1):gpio0'; 'GPIO0'
LOGICAL_PATH '@tubii_tk2_lib.tubii(sch_1):page1_i1@tubii_tk2_lib.tubii_pcb(sch_1):page1_i2@tubii_tk2_lib.clocks(sch_1):page1_i2@tubii_tk2_lib.fault_detection(sch_1):fuzzd_clk_p'; 'FUZZD_CLK_P'
LOGICAL_PATH '@tubii_tk2_lib.tubii(sch_1):page1_i1@tubii_tk2_lib.tubii_pcb(sch_1):page1_i2@tubii_tk2_lib.clocks(sch_1):page1_i2@tubii_tk2_lib.fault_detection(sch_1):fuzzd_clk_n'; 'FUZZD_CLK_N'
LOGICAL_PATH '@tubii_tk2_lib.tubii(sch_1):page1_i1@tubii_tk2_lib.tubii_pcb(sch_1):page1_i1@tubii_tk2_lib.microzed_module(sch_1):fpga_done'; 'FPGA_DONE'
LOGICAL_PATH '@tubii_tk2_lib.tubii(sch_1):page1_i1@tubii_tk2_lib.tubii_pcb(sch_1):page1_i2@tubii_tk2_lib.clocks(sch_1):page1_i1@tubii_tk2_lib.default_clk_sel(sch_1):fox_clk_lvpecl_p'; 'FOX_CLK_LVPECL_P'
LOGICAL_PATH '@tubii_tk2_lib.tubii(sch_1):page1_i1@tubii_tk2_lib.tubii_pcb(sch_1):page1_i2@tubii_tk2_lib.clocks(sch_1):page1_i1@tubii_tk2_lib.default_clk_sel(sch_1):fox_clk_lvpecl_n'; 'FOX_CLK_LVPECL_N'
LOGICAL_PATH '@tubii_tk2_lib.tubii(sch_1):page1_i1@tubii_tk2_lib.tubii_pcb(sch_1):page1_i2@tubii_tk2_lib.clocks(sch_1):page1_i1@tubii_tk2_lib.default_clk_sel(sch_1):fox_100mhz_p'; 'FOX_100MHZ_P'
LOGICAL_PATH '@tubii_tk2_lib.tubii(sch_1):page1_i1@tubii_tk2_lib.tubii_pcb(sch_1):page1_i2@tubii_tk2_lib.clocks(sch_1):page1_i1@tubii_tk2_lib.default_clk_sel(sch_1):en_clk_div_ecl'; 'EN_CLK_DIV_ECL'
LOGICAL_PATH '@tubii_tk2_lib.tubii(sch_1):page1_i1@tubii_tk2_lib.tubii_pcb(sch_1):page1_i6@tubii_tk2_lib.ecal_control(sch_1):ecal_active_ecl_p'; 'ECAL_ACTIVE_ECL_P'
LOGICAL_PATH '@tubii_tk2_lib.tubii(sch_1):page1_i1@tubii_tk2_lib.tubii_pcb(sch_1):page1_i6@tubii_tk2_lib.ecal_control(sch_1):ecal_active_ecl_n'; 'ECAL_ACTIVE_ECL_N'
LOGICAL_PATH '@tubii_tk2_lib.tubii(sch_1):page1_i1@tubii_tk2_lib.tubii_pcb(sch_1):page1_i2@tubii_tk2_lib.clocks(sch_1):page1_i2@tubii_tk2_lib.fault_detection(sch_1):divd_clk_ttl'; 'DIVD_CLK_TTL'
LOGICAL_PATH '@tubii_tk2_lib.tubii(sch_1):page1_i1@tubii_tk2_lib.tubii_pcb(sch_1):page1_i3@tubii_tk2_lib.mtca_mimic(sch_1):dgt_gate'; 'DGT_GATE'
LOGICAL_PATH '@tubii_tk2_lib.tubii(sch_1):page1_i1@tubii_tk2_lib.tubii_pcb(sch_1):page1_i2@tubii_tk2_lib.clocks(sch_1):page1_i2@tubii_tk2_lib.fault_detection(sch_1):def_clk_divd_p'; 'DEF_CLK_DIVD_P'
LOGICAL_PATH '@tubii_tk2_lib.tubii(sch_1):page1_i1@tubii_tk2_lib.tubii_pcb(sch_1):page1_i2@tubii_tk2_lib.clocks(sch_1):page1_i2@tubii_tk2_lib.fault_detection(sch_1):def_clk_divd_n'; 'DEF_CLK_DIVD_N'
LOGICAL_PATH '@tubii_tk2_lib.tubii(sch_1):page1_i1@tubii_tk2_lib.tubii_pcb(sch_1):page1_i2@tubii_tk2_lib.clocks(sch_1):page1_i2@tubii_tk2_lib.fault_detection(sch_1):def_clk_div8_p'; 'DEF_CLK_DIV8_P'
LOGICAL_PATH '@tubii_tk2_lib.tubii(sch_1):page1_i1@tubii_tk2_lib.tubii_pcb(sch_1):page1_i2@tubii_tk2_lib.clocks(sch_1):page1_i2@tubii_tk2_lib.fault_detection(sch_1):def_clk_div8_n'; 'DEF_CLK_DIV8_N'
LOGICAL_PATH '@tubii_tk2_lib.tubii(sch_1):page1_i1@tubii_tk2_lib.tubii_pcb(sch_1):page1_i2@tubii_tk2_lib.clocks(sch_1):page1_i2@tubii_tk2_lib.fault_detection(sch_1):def_clk_div4_p'; 'DEF_CLK_DIV4_P'
LOGICAL_PATH '@tubii_tk2_lib.tubii(sch_1):page1_i1@tubii_tk2_lib.tubii_pcb(sch_1):page1_i2@tubii_tk2_lib.clocks(sch_1):page1_i2@tubii_tk2_lib.fault_detection(sch_1):def_clk_div4_n'; 'DEF_CLK_DIV4_N'
LOGICAL_PATH '@tubii_tk2_lib.tubii(sch_1):page1_i1@tubii_tk2_lib.tubii_pcb(sch_1):page1_i2@tubii_tk2_lib.clocks(sch_1):page1_i2@tubii_tk2_lib.fault_detection(sch_1):def_clk_div2_p'; 'DEF_CLK_DIV2_P'
LOGICAL_PATH '@tubii_tk2_lib.tubii(sch_1):page1_i1@tubii_tk2_lib.tubii_pcb(sch_1):page1_i2@tubii_tk2_lib.clocks(sch_1):page1_i2@tubii_tk2_lib.fault_detection(sch_1):def_clk_div2_n'; 'DEF_CLK_DIV2_N'
LOGICAL_PATH '@tubii_tk2_lib.tubii(sch_1):page1_i1@tubii_tk2_lib.tubii_pcb(sch_1):page1_i2@tubii_tk2_lib.clocks(sch_1):count_data_ecl(7)'; 'COUNT_DATA_ECL<7>'
LOGICAL_PATH '@tubii_tk2_lib.tubii(sch_1):page1_i1@tubii_tk2_lib.tubii_pcb(sch_1):page1_i2@tubii_tk2_lib.clocks(sch_1):count_data_ecl(5)'; 'COUNT_DATA_ECL<5>'
LOGICAL_PATH '@tubii_tk2_lib.tubii(sch_1):page1_i1@tubii_tk2_lib.tubii_pcb(sch_1):page1_i2@tubii_tk2_lib.clocks(sch_1):count_data_ecl(3)'; 'COUNT_DATA_ECL<3>'
LOGICAL_PATH '@tubii_tk2_lib.tubii(sch_1):page1_i1@tubii_tk2_lib.tubii_pcb(sch_1):page1_i2@tubii_tk2_lib.clocks(sch_1):count_data_ecl(1)'; 'COUNT_DATA_ECL<1>'
LOGICAL_PATH '@tubii_tk2_lib.tubii(sch_1):page1_i1@tubii_tk2_lib.tubii_pcb(sch_1):page1_i12@tubii_tk2_lib.baseline_buffer(sch_1):backplane_out(8)'; 'BACKPLANE_OUT<8>'
LOGICAL_PATH '@tubii_tk2_lib.tubii(sch_1):page1_i1@tubii_tk2_lib.tubii_pcb(sch_1):page1_i12@tubii_tk2_lib.baseline_buffer(sch_1):backplane_out(6)'; 'BACKPLANE_OUT<6>'
LOGICAL_PATH '@tubii_tk2_lib.tubii(sch_1):page1_i1@tubii_tk2_lib.tubii_pcb(sch_1):page1_i12@tubii_tk2_lib.baseline_buffer(sch_1):backplane_out(4)'; 'BACKPLANE_OUT<4>'
LOGICAL_PATH '@tubii_tk2_lib.tubii(sch_1):page1_i1@tubii_tk2_lib.tubii_pcb(sch_1):page1_i12@tubii_tk2_lib.baseline_buffer(sch_1):backplane_out(2)'; 'BACKPLANE_OUT<2>'
LOGICAL_PATH '@tubii_tk2_lib.tubii(sch_1):page1_i1@tubii_tk2_lib.tubii_pcb(sch_1):page1_i12@tubii_tk2_lib.baseline_buffer(sch_1):backplane_out(10)'; 'BACKPLANE_OUT<10>'
LOGICAL_PATH '@tubii_tk2_lib.tubii(sch_1):page1_i1@tubii_tk2_lib.tubii_pcb(sch_1):page1_i12@tubii_tk2_lib.baseline_buffer(sch_1):backplane_in(8)'; 'BACKPLANE_IN<8>'
LOGICAL_PATH '@tubii_tk2_lib.tubii(sch_1):page1_i1@tubii_tk2_lib.tubii_pcb(sch_1):page1_i12@tubii_tk2_lib.baseline_buffer(sch_1):backplane_in(6)'; 'BACKPLANE_IN<6>'
LOGICAL_PATH '@tubii_tk2_lib.tubii(sch_1):page1_i1@tubii_tk2_lib.tubii_pcb(sch_1):page1_i12@tubii_tk2_lib.baseline_buffer(sch_1):backplane_in(4)'; 'BACKPLANE_IN<4>'
LOGICAL_PATH '@tubii_tk2_lib.tubii(sch_1):page1_i1@tubii_tk2_lib.tubii_pcb(sch_1):page1_i12@tubii_tk2_lib.baseline_buffer(sch_1):backplane_in(2)'; 'BACKPLANE_IN<2>'
LOGICAL_PATH '@tubii_tk2_lib.tubii(sch_1):page1_i1@tubii_tk2_lib.tubii_pcb(sch_1):page1_i12@tubii_tk2_lib.baseline_buffer(sch_1):backplane_in(10)'; 'BACKPLANE_IN<10>'
VOLTAGE '5 V'; 'VCC'
LOGICAL_PATH '@tubii_tk2_lib.tubii(sch_1):page1_i1@tubii_tk2_lib.tubii_pcb(sch_1):page1_i13@tubii_tk2_lib.lo_gen(sch_1):page1_i1@tubii_tk2_lib.gt_delays(sch_1):unnamed_1_ledl_i19_a'; 'UNNAMED_1_LEDL_I19_A'
LOGICAL_PATH '@tubii_tk2_lib.tubii(sch_1):page1_i1@tubii_tk2_lib.tubii_pcb(sch_1):page1_i13@tubii_tk2_lib.lo_gen(sch_1):page1_i1@tubii_tk2_lib.gt_delays(sch_1):unnamed_1_ledl_i18_a'; 'UNNAMED_1_LEDL_I18_A'
LOGICAL_PATH '@tubii_tk2_lib.tubii(sch_1):page1_i1@tubii_tk2_lib.tubii_pcb(sch_1):page1_i10@tubii_tk2_lib.cntrl_register(sch_1):unnamed_1_hct374_i2_q7'; 'UNNAMED_1_HCT374_I2_Q7'
LOGICAL_PATH '@tubii_tk2_lib.tubii(sch_1):page1_i1@tubii_tk2_lib.tubii_pcb(sch_1):page1_i10@tubii_tk2_lib.cntrl_register(sch_1):unnamed_1_hct374_i2_q6'; 'UNNAMED_1_HCT374_I2_Q6'
LOGICAL_PATH '@tubii_tk2_lib.tubii(sch_1):page1_i1@tubii_tk2_lib.tubii_pcb(sch_1):page1_i13@tubii_tk2_lib.lo_gen(sch_1):page1_i1@tubii_tk2_lib.gt_delays(sch_1):unnamed_1_hct123_i9_q2'; 'UNNAMED_1_HCT123_I9_Q2'
LOGICAL_PATH '@tubii_tk2_lib.tubii(sch_1):page1_i1@tubii_tk2_lib.tubii_pcb(sch_1):page1_i13@tubii_tk2_lib.lo_gen(sch_1):page1_i1@tubii_tk2_lib.gt_delays(sch_1):unnamed_1_hct123_i9_q1'; 'UNNAMED_1_HCT123_I9_Q1'
LOGICAL_PATH '@tubii_tk2_lib.tubii(sch_1):page1_i1@tubii_tk2_lib.tubii_pcb(sch_1):page1_i13@tubii_tk2_lib.lo_gen(sch_1):page1_i1@tubii_tk2_lib.gt_delays(sch_1):unnamed_1_csmd0805_i15_b'; 'UNNAMED_1_CSMD0805_I15_B'
LOGICAL_PATH '@tubii_tk2_lib.tubii(sch_1):page1_i1@tubii_tk2_lib.tubii_pcb(sch_1):page1_i13@tubii_tk2_lib.lo_gen(sch_1):page1_i1@tubii_tk2_lib.gt_delays(sch_1):unnamed_1_csmd0805_i14_b'; 'UNNAMED_1_CSMD0805_I14_B'
LOGICAL_PATH '@tubii_tk2_lib.tubii(sch_1):gnd'; 'GND'
WEIGHT '0'; 'GND' 'VCC'
VOLTAGE '0 V'; 'GND'
LOGICAL_PATH '@tubii_tk2_lib.tubii(sch_1):page1_i1@tubii_tk2_lib.tubii_pcb(sch_1):page1_i13@tubii_tk2_lib.lo_gen(sch_1):page1_i1@tubii_tk2_lib.gt_delays(sch_1):dgt_ttl'; 'DGT_TTL'
LOGICAL_PATH '@tubii_tk2_lib.tubii(sch_1):page1_i1@tubii_tk2_lib.tubii_pcb(sch_1):page1_i13@tubii_tk2_lib.lo_gen(sch_1):page1_i1@tubii_tk2_lib.gt_delays(sch_1):ddgt_ttl'; 'DDGT_TTL'
LOGICAL_PATH '@tubii_tk2_lib.tubii(sch_1):page1_i1@tubii_tk2_lib.tubii_pcb(sch_1):page1_i13@tubii_tk2_lib.lo_gen(sch_1):page1_i1@tubii_tk2_lib.gt_delays(sch_1):ddgt_bits'; 'DDGT_BITS'
LOGICAL_PATH '@tubii_tk2_lib.tubii(sch_1):page1_i1@tubii_tk2_lib.tubii_pcb(sch_1):page1_i10@tubii_tk2_lib.cntrl_register(sch_1):cntrl_raw(7)'; 'CNTRL_RAW<7>'
LOGICAL_PATH '@tubii_tk2_lib.tubii(sch_1):page1_i1@tubii_tk2_lib.tubii_pcb(sch_1):page1_i10@tubii_tk2_lib.cntrl_register(sch_1):cntrl_raw(5)'; 'CNTRL_RAW<5>'
LOGICAL_PATH '@tubii_tk2_lib.tubii(sch_1):page1_i1@tubii_tk2_lib.tubii_pcb(sch_1):page1_i10@tubii_tk2_lib.cntrl_register(sch_1):cntrl_raw(3)'; 'CNTRL_RAW<3>'
LOGICAL_PATH '@tubii_tk2_lib.tubii(sch_1):page1_i1@tubii_tk2_lib.tubii_pcb(sch_1):page1_i10@tubii_tk2_lib.cntrl_register(sch_1):cntrl_raw(1)'; 'CNTRL_RAW<1>'
DIFFERENTIAL_PAIR 'DP_LVDS_TO_ECL'; 'UNNAMED_2_FRONTPORTS_I2_LVDSTOE' 'UNNAMED_2_FRONTPORTS_I2_LVDST_1'
DIFFERENTIAL_PAIR 'DP_USE_DEFAULT'; 'USE_DEFAULT_N' 'USE_DEFAULT_P'
DIFFERENTIAL_PAIR 'DP_UNNAMED_1_MC10E116_I4_Q3'; 'UNNAMED_1_MC10E116_I4_Q3' 'UNNAMED_1_MC10E116_I4_Q3_1'
DIFFERENTIAL_PAIR 'DP_UNNAMED_1_MC10E116_I4_Q1'; 'UNNAMED_1_MC10E116_I4_Q1' 'UNNAMED_1_MC10E116_I4_Q1_1'
DIFFERENTIAL_PAIR 'DP_UNNAMED_1_MC10E116_I3_Q3'; 'UNNAMED_1_MC10E116_I3_Q3' 'UNNAMED_1_MC10E116_I3_Q3_1'
DIFFERENTIAL_PAIR 'DP_UNNAMED_1_MC10E116_I3_Q1'; 'UNNAMED_1_MC10E116_I3_Q1' 'UNNAMED_1_MC10E116_I3_Q1_1'
DIFFERENTIAL_PAIR 'DP_UNNAMED_1_MC10E116_I22_Q1'; 'UNNAMED_1_MC10E116_I22_Q1' 'UNNAMED_1_MC10E116_I22_Q1_1'
DIFFERENTIAL_PAIR 'DP_UNNAMED_1_MC10E116_I1_Q3'; 'UNNAMED_1_MC10E116_I1_Q3' 'UNNAMED_1_MC10E116_I1_Q3_1'
BUS_NAME 'LE'; 'UNNAMED_1_HCT238_I53_A0' 'UNNAMED_1_HCT238_I53_A1' 'UNNAMED_1_HCT238_I53_A2'
DIFFERENTIAL_PAIR 'DP_UNNAMED_1_FRONTPORTS_I2_SYNCLVDS'; 'UNNAMED_2_FRONTPORTS_I2_SYNCLVD' 'UNNAMED_2_FRONTPORTS_I2_SYNCL_1'
DIFFERENTIAL_PAIR 'DP_UNNAMED_1_FRONTPORTS_I2_SYNC24'; 'UNNAMED_2_FRONTPORTS_I2_SYNC24N' 'UNNAMED_2_FRONTPORTS_I2_SYNC24P'
DIFFERENTIAL_PAIR 'DP_UNNAMED_1_FRONTPORTS_I2_SYNC24LVDS'; 'UNNAMED_2_FRONTPORTS_I2_SYNC24L' 'UNNAMED_2_FRONTPORTS_I2_SYNC2_1'
BUS_NAME 'UNNAMED_2_FRONTPORTS_I2_SCOPEOU'; 'UNNAMED_2_FRONTPORTS_I2_SCOP<0>' 'UNNAMED_2_FRONTPORTS_I2_SCOP<1>' 'UNNAMED_2_FRONTPORTS_I2_SCOP<2>' 'UNNAMED_2_FRONTPORTS_I2_SCOP<3>' 'UNNAMED_2_FRONTPORTS_I2_SCOP<4>' 'UNNAMED_2_FRONTPORTS_I2_SCOP<5>',
           'UNNAMED_2_FRONTPORTS_I2_SCOP<6>' 'UNNAMED_2_FRONTPORTS_I2_SCOP<7>'
DIFFERENTIAL_PAIR 'DP_UNNAMED_1_FRONTPORTS_I2_RIBBONPULSEOUT'; 'UNNAMED_2_FRONTPORTS_I2_RIBBO_2' 'UNNAMED_2_FRONTPORTS_I2_RIBBO_3'
BUS_NAME 'UNNAMED_2_FRONTPORTS_I2_PULSE_2'; 'UNNAMED_2_FRONTPORTS_I2_PUL<10>' 'UNNAMED_2_FRONTPORTS_I2_PUL<11>' 'UNNAMED_2_FRONTPORTS_I2_PULS<0>' 'UNNAMED_2_FRONTPORTS_I2_PULS<1>' 'UNNAMED_2_FRONTPORTS_I2_PULS<2>' 'UNNAMED_2_FRONTPORTS_I2_PULS<3>',
           'UNNAMED_2_FRONTPORTS_I2_PULS<4>' 'UNNAMED_2_FRONTPORTS_I2_PULS<5>' 'UNNAMED_2_FRONTPORTS_I2_PULS<6>' 'UNNAMED_2_FRONTPORTS_I2_PULS<7>' 'UNNAMED_2_FRONTPORTS_I2_PULS<8>' 'UNNAMED_2_FRONTPORTS_I2_PULS<9>'
DIFFERENTIAL_PAIR 'DP_UNNAMED_1_FRONTPORTS_I2_MTCAMIMIC2OUT'; 'UNNAMED_2_FRONTPORTS_I2_MTCAM_3' 'UNNAMED_2_FRONTPORTS_I2_MTCAM_4'
DIFFERENTIAL_PAIR 'DP_UNNAMED_1_FRONTPORTS_I2_LOSTAROUT'; 'UNNAMED_2_FRONTPORTS_I2_LOSTARO' 'UNNAMED_2_FRONTPORTS_I2_LOSTA_1'
BUS_NAME 'UNNAMED_2_FRONTPORTS_I2_EXTTRIG'; 'UNNAMED_2_FRONTPORTS_I2_EXT<10>' 'UNNAMED_2_FRONTPORTS_I2_EXT<11>' 'UNNAMED_2_FRONTPORTS_I2_EXT<12>' 'UNNAMED_2_FRONTPORTS_I2_EXT<13>' 'UNNAMED_2_FRONTPORTS_I2_EXT<14>' 'UNNAMED_2_FRONTPORTS_I2_EXT<15>',
           'UNNAMED_2_FRONTPORTS_I2_EXTT<0>' 'UNNAMED_2_FRONTPORTS_I2_EXTT<1>' 'UNNAMED_2_FRONTPORTS_I2_EXTT<2>' 'UNNAMED_2_FRONTPORTS_I2_EXTT<3>' 'UNNAMED_2_FRONTPORTS_I2_EXTT<4>' 'UNNAMED_2_FRONTPORTS_I2_EXTT<5>',
           'UNNAMED_2_FRONTPORTS_I2_EXTT<6>' 'UNNAMED_2_FRONTPORTS_I2_EXTT<7>' 'UNNAMED_2_FRONTPORTS_I2_EXTT<8>' 'UNNAMED_2_FRONTPORTS_I2_EXTT<9>'
DIFFERENTIAL_PAIR 'UNNAMED_1_FRONTPORTS_I2_DGT'; 'UNNAMED_2_FRONTPORTS_I2_DGTN' 'UNNAMED_2_FRONTPORTS_I2_DGTP'
BUS_NAME 'UNNAMED_2_FRONTPORTS_I2_CAENOUT'; 'UNNAMED_2_FRONTPORTS_I2_CAEN<0>' 'UNNAMED_2_FRONTPORTS_I2_CAEN<1>' 'UNNAMED_2_FRONTPORTS_I2_CAEN<2>' 'UNNAMED_2_FRONTPORTS_I2_CAEN<3>' 'UNNAMED_2_FRONTPORTS_I2_CAEN<4>' 'UNNAMED_2_FRONTPORTS_I2_CAEN<5>',
           'UNNAMED_2_FRONTPORTS_I2_CAEN<6>' 'UNNAMED_2_FRONTPORTS_I2_CAEN<7>'
DIFFERENTIAL_PAIR 'DP_UNNAMED_1_CSMD0805_I64_B'; 'UNNAMED_1_CSMD0805_I64_B' 'UNNAMED_1_CSMD0805_I70_B'
DIFFERENTIAL_PAIR 'DP_UNNAMED_1_CSMD0603_I55_A'; 'UNNAMED_1_CSMD0603_I55_A' 'UNNAMED_2_FRONTPORTS_I2_EXTT<4>'
DIFFERENTIAL_PAIR 'DP_UNNAMED_1_CSMD0603_I54_B'; 'UNNAMED_1_CSMD0603_I54_B' 'UNNAMED_2_FRONTPORTS_I2_EXTT<0>'
DIFFERENTIAL_PAIR 'DP_UNNAMED_1_CSMD0603_I10_B'; 'UNNAMED_1_CSMD0603_I10_B_1' 'UNNAMED_2_FRONTPORTS_I2_SMELLIE'
DIFFERENTIAL_PAIR 'DP_UNNAMED_1_CHANGECLKS_I3_CHANGECLK'; 'UNNAMED_1_CHANGECLKS_I3_CHANGEC' 'UNNAMED_1_CHANGECLKS_I3_CHANG_1'
DIFFERENTIAL_PAIR 'DP_UNNAMED_1_CHANGECLKS_I3_BCKPCLK2'; 'UNNAMED_1_CHANGECLKS_I3_BCKPCLK' 'UNNAMED_1_CHANGECLKS_I3_BCKPC_1'
DIFFERENTIAL_PAIR 'DP_UNNAMED_1_AD96687_I1_Q2'; 'UNNAMED_1_AD96687_I1_Q2' 'UNNAMED_1_AD96687_I1_Q2_1'
DIFFERENTIAL_PAIR 'DP_TRIG_PULS2'; 'TRIG_PULS2_N' 'TRIG_PULS2_P'
DIFFERENTIAL_PAIR 'DP_TRIG_GATE2'; 'TRIG_GATE2_N' 'TRIG_GATE2_P'
DIFFERENTIAL_PAIR 'DP_TELLIE_DELAY_BUF'; 'TELLIE_DELAY_BUF_N' 'TELLIE_DELAY_BUF_P'
DIFFERENTIAL_PAIR 'DP_SYNC24_2'; 'SYNC24_2_N' 'SYNC24_2_P'
DIFFERENTIAL_PAIR 'DP_RIB9'; 'RIB9_N' 'RIB9_P'
DIFFERENTIAL_PAIR 'DP_RIB7'; 'RIB7_N' 'RIB7_P'
DIFFERENTIAL_PAIR 'DP_RIB5'; 'RIB5_N' 'RIB5_P'
DIFFERENTIAL_PAIR 'DP_RIB3'; 'RIB3_N' 'RIB3_P'
DIFFERENTIAL_PAIR 'DP_RIB1'; 'RIB1_N' 'RIB1_P'
DIFFERENTIAL_PAIR 'DP_FUZZD_CLK'; 'FUZZD_CLK_N' 'FUZZD_CLK_P'
DIFFERENTIAL_PAIR 'ECAL_ACTIVE_ECL'; 'ECAL_ACTIVE_ECL_N' 'ECAL_ACTIVE_ECL_P'
DIFFERENTIAL_PAIR 'DP_DEF_CLK_DIV8'; 'DEF_CLK_DIV8_N' 'DEF_CLK_DIV8_P'
DIFFERENTIAL_PAIR 'DP_DEF_CLK_DIV2'; 'DEF_CLK_DIV2_N' 'DEF_CLK_DIV2_P'
BUS_NAME 'COUNT_DATA_ECL'; 'COUNT_DATA_ECL<1>' 'COUNT_DATA_ECL<2>' 'COUNT_DATA_ECL<3>' 'COUNT_DATA_ECL<4>' 'COUNT_DATA_ECL<5>' 'COUNT_DATA_ECL<6>',
           'COUNT_DATA_ECL<7>'
DIFFERENTIAL_PAIR 'DP_CLK_BAD'; 'CLK_BAD_N' 'CLK_BAD_P'
DIFFERENTIAL_PAIR 'DP_CHOSEN_CLK2'; 'CHOSEN_CLK2_N' 'CHOSEN_CLK2_P'
DIFFERENTIAL_PAIR 'DP_BCKP_CLK_BUFD'; 'BCKP_CLK_BUFD_N' 'BCKP_CLK_BUFD_P'
BUS_NAME 'BACKPLANE_IN'; 'BACKPLANE_IN<10>' 'BACKPLANE_IN<1>' 'BACKPLANE_IN<2>' 'BACKPLANE_IN<3>' 'BACKPLANE_IN<4>' 'BACKPLANE_IN<5>',
           'BACKPLANE_IN<6>' 'BACKPLANE_IN<7>' 'BACKPLANE_IN<8>' 'BACKPLANE_IN<9>'
DIFFERENTIAL_PAIR 'DP_UNNAMED_1_FRONTPORTS_I2_MTCDLO'; 'UNNAMED_1_MC10E116_I2_D0' 'UNNAMED_2_FRONTPORTS_I2_MTCDLO'
BUS_NAME 'CNTRL_RAW'; 'CNTRL_RAW<0>' 'CNTRL_RAW<1>' 'CNTRL_RAW<2>' 'CNTRL_RAW<3>' 'CNTRL_RAW<4>' 'CNTRL_RAW<5>',
           'CNTRL_RAW<6>' 'CNTRL_RAW<7>'
DIFFERENTIAL_PAIR 'LO_SEL_ECL'; 'LO_SEL_ECL_N' 'LO_SEL_ECL_P'
BUS_NAME 'BACKPLANE_OUT'; 'BACKPLANE_OUT<10>' 'BACKPLANE_OUT<1>' 'BACKPLANE_OUT<2>' 'BACKPLANE_OUT<3>' 'BACKPLANE_OUT<4>' 'BACKPLANE_OUT<5>',
           'BACKPLANE_OUT<6>' 'BACKPLANE_OUT<7>' 'BACKPLANE_OUT<8>' 'BACKPLANE_OUT<9>'
DIFFERENTIAL_PAIR 'DP_CHANGE_CLK2'; 'CHANGE_CLK2_N' 'CHANGE_CLK2_P'
DIFFERENTIAL_PAIR 'DP_CHOSEN_CLK'; 'CHOSEN_CLK_N' 'CHOSEN_CLK_P'
DIFFERENTIAL_PAIR 'DP_CLK_SEL_ECL'; 'CLK_SEL_ECL_N' 'CLK_SEL_ECL_P'
DIFFERENTIAL_PAIR 'DP_DEF_CLK_DIV4'; 'DEF_CLK_DIV4_N' 'DEF_CLK_DIV4_P'
DIFFERENTIAL_PAIR 'DP_DEF_CLK_DIVD'; 'DEF_CLK_DIVD_N' 'DEF_CLK_DIVD_P'
DIFFERENTIAL_PAIR 'DP_FOX_CLK_LVPECL'; 'FOX_CLK_LVPECL_N' 'FOX_CLK_LVPECL_P'
DIFFERENTIAL_PAIR 'DP_GT2_N'; 'GT2_N' 'UNNAMED_1_CAENCOMS_I8_GT2P'
DIFFERENTIAL_PAIR 'DP_RIB10'; 'RIB10_N' 'RIB10_P'
DIFFERENTIAL_PAIR 'DP_RIB2'; 'RIB2_N' 'RIB2_P'
DIFFERENTIAL_PAIR 'DP_RIB4'; 'RIB4_N' 'RIB4_P'
DIFFERENTIAL_PAIR 'DP_RIB6'; 'RIB6_N' 'RIB6_P'
DIFFERENTIAL_PAIR 'DP_RIB8'; 'RIB8_N' 'RIB8_P'
DIFFERENTIAL_PAIR 'DP_SMELLIE_DELAY_BUF'; 'SMELLIE_DELAY_BUF_N' 'SMELLIE_DELAY_BUF_P'
DIFFERENTIAL_PAIR 'DP_SYNC_2'; 'SYNC_2_N' 'SYNC_2_P'
DIFFERENTIAL_PAIR 'DP_TRIG_GATE1'; 'TRIG_GATE1_N' 'TRIG_GATE1_P'
DIFFERENTIAL_PAIR 'DP_TRIG_PULS1'; 'TRIG_PULS1_N' 'TRIG_PULS1_P'
DIFFERENTIAL_PAIR 'DP_UNNAMED_1_AD96687_I1_Q1'; 'UNNAMED_1_AD96687_I1_Q1' 'UNNAMED_1_AD96687_I1_Q1_1'
DIFFERENTIAL_PAIR 'DP_UNNAMED_1_CHANGECLKS_I3_BCKPCLK3'; 'UNNAMED_1_CHANGECLKS_I3_BCKPC_2' 'UNNAMED_1_CHANGECLKS_I3_BCKPC_3'
DIFFERENTIAL_PAIR 'DP_UNNAMED_1_CHANGECLKS_I3_DEFAULTCLK2'; 'UNNAMED_1_CHANGECLKS_I3_DEFAULT' 'UNNAMED_1_CHANGECLKS_I3_DEFAU_1'
DIFFERENTIAL_PAIR 'DP_UNNAMED_1_DEFAULTCLKSEL_I1_DEFAULTCLK'; 'UNNAMED_1_DEFAULTCLKSEL_I1_BCKP' 'UNNAMED_1_MC10E116_I1_D0'
BUS_NAME 'UNNAMED_1_EXTTRIGS_I70_EXTTRIGO'; 'UNNAMED_1_EXTTRIGS_I70_EXTT<10>' 'UNNAMED_1_EXTTRIGS_I70_EXTT<11>' 'UNNAMED_1_EXTTRIGS_I70_EXTT<12>' 'UNNAMED_1_EXTTRIGS_I70_EXTT<13>' 'UNNAMED_1_EXTTRIGS_I70_EXTT<14>' 'UNNAMED_1_EXTTRIGS_I70_EXTT<15>',
           'UNNAMED_1_EXTTRIGS_I70_EXTTR<0>' 'UNNAMED_1_EXTTRIGS_I70_EXTTR<1>' 'UNNAMED_1_EXTTRIGS_I70_EXTTR<2>' 'UNNAMED_1_EXTTRIGS_I70_EXTTR<3>' 'UNNAMED_1_EXTTRIGS_I70_EXTTR<4>' 'UNNAMED_1_EXTTRIGS_I70_EXTTR<5>',
           'UNNAMED_1_EXTTRIGS_I70_EXTTR<6>' 'UNNAMED_1_EXTTRIGS_I70_EXTTR<7>' 'UNNAMED_1_EXTTRIGS_I70_EXTTR<8>' 'UNNAMED_1_EXTTRIGS_I70_EXTTR<9>'
DIFFERENTIAL_PAIR 'DP_UNNAMED_1_FRONTPORTS_I2_CLK100'; 'UNNAMED_2_FRONTPORTS_I2_CLK100N' 'UNNAMED_2_FRONTPORTS_I2_CLK100P'
DIFFERENTIAL_PAIR 'DP_ECLTOLVDS'; 'UNNAMED_2_FRONTPORTS_I2_ECLTO_1' 'UNNAMED_2_FRONTPORTS_I2_ECLTO_2'
DIFFERENTIAL_PAIR 'DP_UNNAMED_1_FRONTPORTS_I2_GT'; 'UNNAMED_2_FRONTPORTS_I2_GTN' 'UNNAMED_2_FRONTPORTS_I2_GTP'
DIFFERENTIAL_PAIR 'DP_UNNAMED_1_FRONTPORTS_I2_MTCAMIMIC1OUT'; 'UNNAMED_2_FRONTPORTS_I2_MTCAMIM' 'UNNAMED_2_FRONTPORTS_I2_MTCAM_1'
DIFFERENTIAL_PAIR 'DP_UNNAMED_1_FRONTPORTS_I2_RIBBONPULSEIN'; 'UNNAMED_2_FRONTPORTS_I2_RIBBONP' 'UNNAMED_2_FRONTPORTS_I2_RIBBO_1'
BUS_NAME 'UNNAMED_2_FRONTPORTS_I2_SCALER'; 'UNNAMED_2_FRONTPORTS_I2_SCAL<1>' 'UNNAMED_2_FRONTPORTS_I2_SCAL<2>' 'UNNAMED_2_FRONTPORTS_I2_SCAL<3>' 'UNNAMED_2_FRONTPORTS_I2_SCAL<4>' 'UNNAMED_2_FRONTPORTS_I2_SCAL<5>' 'UNNAMED_2_FRONTPORTS_I2_SCAL<6>'
DIFFERENTIAL_PAIR 'DP_UNNAMED_1_FRONTPORTS_I2_SYNC'; 'UNNAMED_2_FRONTPORTS_I2_SYNCN' 'UNNAMED_2_FRONTPORTS_I2_SYNCP'
DIFFERENTIAL_PAIR 'DP_UNNAMED_1_MC10E116_I1_Q0'; 'UNNAMED_1_MC10E116_I1_Q0' 'UNNAMED_1_MC10E116_I1_Q0_1'
DIFFERENTIAL_PAIR 'DP_UNNAMED_2_FRONTPORTS_I2_TUBCLKIN'; 'UNNAMED_1_MC10E116_I22_D3' 'VBB_TRANS'
DIFFERENTIAL_PAIR 'DP_UNNAMED_1_MC10E116_I22_Q0'; 'UNNAMED_1_MC10E116_I22_Q0' 'UNNAMED_1_MC10E116_I22_Q0_1'
DIFFERENTIAL_PAIR 'DP_UNNAMED_1_MC10E116_I3_Q0'; 'UNNAMED_1_MC10E116_I3_Q0' 'UNNAMED_1_MC10E116_I3_Q0_1'
DIFFERENTIAL_PAIR 'DP_UNNAMED_1_MC10E116_I3_Q2'; 'UNNAMED_1_MC10E116_I3_Q2' 'UNNAMED_1_MC10E116_I3_Q2_1'
DIFFERENTIAL_PAIR 'DP_UNNAMED_1_MC10E116_I4_Q0'; 'UNNAMED_1_MC10E116_I4_Q0' 'UNNAMED_1_MC10E116_I4_Q0_1'
DIFFERENTIAL_PAIR 'DP_UNNAMED_1_MC10E116_I4_Q2'; 'UNNAMED_1_MC10E116_I4_Q2' 'UNNAMED_1_MC10E116_I4_Q2_1'
DIFFERENTIAL_PAIR 'DP_USE_BCKP'; 'USE_BCKP_N' 'USE_BCKP_P'
DIFFERENTIAL_PAIR 'DP_UNNAMED_2_FRONTPORTS_I2_TUBCLKI'; 'UNNAMED_2_FRONTPORTS_I2_TUBCLKI' 'UNNAMED_2_FRONTPORTS_I2_TUBCL_1'
LOGICAL_PATH '@tubii_tk2_lib.tubii(sch_1):page1_i1@tubii_tk2_lib.tubii_pcb(sch_1):page1_i10@tubii_tk2_lib.cntrl_register(sch_1):cntrl_raw(0)'; 'CNTRL_RAW<0>'
LOGICAL_PATH '@tubii_tk2_lib.tubii(sch_1):page1_i1@tubii_tk2_lib.tubii_pcb(sch_1):page1_i10@tubii_tk2_lib.cntrl_register(sch_1):cntrl_raw(2)'; 'CNTRL_RAW<2>'
LOGICAL_PATH '@tubii_tk2_lib.tubii(sch_1):page1_i1@tubii_tk2_lib.tubii_pcb(sch_1):page1_i10@tubii_tk2_lib.cntrl_register(sch_1):cntrl_raw(4)'; 'CNTRL_RAW<4>'
LOGICAL_PATH '@tubii_tk2_lib.tubii(sch_1):page1_i1@tubii_tk2_lib.tubii_pcb(sch_1):page1_i10@tubii_tk2_lib.cntrl_register(sch_1):cntrl_raw(6)'; 'CNTRL_RAW<6>'
LOGICAL_PATH '@tubii_tk2_lib.tubii(sch_1):vcc'; 'VCC'
VOLTAGE '-5.2 V'; 'VEE'
LOGICAL_PATH '@tubii_tk2_lib.tubii(sch_1):vee'; 'VEE'
LOGICAL_PATH '@tubii_tk2_lib.tubii(sch_1):page1_i1@tubii_tk2_lib.tubii_pcb(sch_1):page1_i13@tubii_tk2_lib.lo_gen(sch_1):page1_i2@tubii_tk2_lib.select_lo_src(sch_1):lo_sel_ecl_n'; 'LO_SEL_ECL_N'
LOGICAL_PATH '@tubii_tk2_lib.tubii(sch_1):page1_i1@tubii_tk2_lib.tubii_pcb(sch_1):page1_i13@tubii_tk2_lib.lo_gen(sch_1):page1_i2@tubii_tk2_lib.select_lo_src(sch_1):lo_sel_ecl_p'; 'LO_SEL_ECL_P'
LOGICAL_PATH '@tubii_tk2_lib.tubii(sch_1):page1_i1@tubii_tk2_lib.tubii_pcb(sch_1):page1_i13@tubii_tk2_lib.lo_gen(sch_1):page1_i2@tubii_tk2_lib.select_lo_src(sch_1):lo_star_raw'; 'LO_STAR_RAW'
LOGICAL_PATH '@tubii_tk2_lib.tubii(sch_1):page1_i1@tubii_tk2_lib.tubii_pcb(sch_1):page1_i13@tubii_tk2_lib.lo_gen(sch_1):unnamed_1_gtdelays_i1_ddgtn'; 'UNNAMED_1_GTDELAYS_I1_DDGTN'
LOGICAL_PATH '@tubii_tk2_lib.tubii(sch_1):page1_i1@tubii_tk2_lib.tubii_pcb(sch_1):page1_i13@tubii_tk2_lib.lo_gen(sch_1):unnamed_1_gtdelays_i1_ddgtp'; 'UNNAMED_1_GTDELAYS_I1_DDGTP'
LOGICAL_PATH '@tubii_tk2_lib.tubii(sch_1):page1_i1@tubii_tk2_lib.tubii_pcb(sch_1):page1_i13@tubii_tk2_lib.lo_gen(sch_1):page1_i2@tubii_tk2_lib.select_lo_src(sch_1):unnamed_1_ledl_i11_a'; 'UNNAMED_1_LEDL_I11_A'
LOGICAL_PATH '@tubii_tk2_lib.tubii(sch_1):page1_i1@tubii_tk2_lib.tubii_pcb(sch_1):page1_i13@tubii_tk2_lib.lo_gen(sch_1):page1_i2@tubii_tk2_lib.select_lo_src(sch_1):unnamed_1_mc10e116_i2_d0'; 'UNNAMED_1_MC10E116_I2_D0'
LOGICAL_PATH '@tubii_tk2_lib.tubii(sch_1):page1_i1@tubii_tk2_lib.tubii_pcb(sch_1):page1_i13@tubii_tk2_lib.lo_gen(sch_1):page1_i2@tubii_tk2_lib.select_lo_src(sch_1):unnamed_1_mc10e116_i2_q0'; 'UNNAMED_1_MC10E116_I2_Q0'
VOLTAGE '-2 V'; 'VTT'
LOGICAL_PATH '@tubii_tk2_lib.tubii(sch_1):vtt'; 'VTT'
LOGICAL_PATH '@tubii_tk2_lib.tubii(sch_1):page1_i1@tubii_tk2_lib.tubii_pcb(sch_1):page1_i12@tubii_tk2_lib.baseline_buffer(sch_1):backplane_in(1)'; 'BACKPLANE_IN<1>'
LOGICAL_PATH '@tubii_tk2_lib.tubii(sch_1):page1_i1@tubii_tk2_lib.tubii_pcb(sch_1):page1_i12@tubii_tk2_lib.baseline_buffer(sch_1):backplane_in(3)'; 'BACKPLANE_IN<3>'
LOGICAL_PATH '@tubii_tk2_lib.tubii(sch_1):page1_i1@tubii_tk2_lib.tubii_pcb(sch_1):page1_i12@tubii_tk2_lib.baseline_buffer(sch_1):backplane_in(5)'; 'BACKPLANE_IN<5>'
LOGICAL_PATH '@tubii_tk2_lib.tubii(sch_1):page1_i1@tubii_tk2_lib.tubii_pcb(sch_1):page1_i12@tubii_tk2_lib.baseline_buffer(sch_1):backplane_in(7)'; 'BACKPLANE_IN<7>'
LOGICAL_PATH '@tubii_tk2_lib.tubii(sch_1):page1_i1@tubii_tk2_lib.tubii_pcb(sch_1):page1_i12@tubii_tk2_lib.baseline_buffer(sch_1):backplane_in(9)'; 'BACKPLANE_IN<9>'
LOGICAL_PATH '@tubii_tk2_lib.tubii(sch_1):page1_i1@tubii_tk2_lib.tubii_pcb(sch_1):page1_i12@tubii_tk2_lib.baseline_buffer(sch_1):backplane_out(1)'; 'BACKPLANE_OUT<1>'
LOGICAL_PATH '@tubii_tk2_lib.tubii(sch_1):page1_i1@tubii_tk2_lib.tubii_pcb(sch_1):page1_i12@tubii_tk2_lib.baseline_buffer(sch_1):backplane_out(3)'; 'BACKPLANE_OUT<3>'
LOGICAL_PATH '@tubii_tk2_lib.tubii(sch_1):page1_i1@tubii_tk2_lib.tubii_pcb(sch_1):page1_i12@tubii_tk2_lib.baseline_buffer(sch_1):backplane_out(5)'; 'BACKPLANE_OUT<5>'
LOGICAL_PATH '@tubii_tk2_lib.tubii(sch_1):page1_i1@tubii_tk2_lib.tubii_pcb(sch_1):page1_i12@tubii_tk2_lib.baseline_buffer(sch_1):backplane_out(7)'; 'BACKPLANE_OUT<7>'
LOGICAL_PATH '@tubii_tk2_lib.tubii(sch_1):page1_i1@tubii_tk2_lib.tubii_pcb(sch_1):page1_i12@tubii_tk2_lib.baseline_buffer(sch_1):backplane_out(9)'; 'BACKPLANE_OUT<9>'
LOGICAL_PATH '@tubii_tk2_lib.tubii(sch_1):page1_i1@tubii_tk2_lib.tubii_pcb(sch_1):page1_i2@tubii_tk2_lib.clocks(sch_1):page1_i1@tubii_tk2_lib.default_clk_sel(sch_1):\bckp_clk*\'; 'BCKP_CLK*'
LOGICAL_PATH '@tubii_tk2_lib.tubii(sch_1):page1_i1@tubii_tk2_lib.tubii_pcb(sch_1):page1_i2@tubii_tk2_lib.clocks(sch_1):page1_i2@tubii_tk2_lib.fault_detection(sch_1):bckp_clk_bufd_n'; 'BCKP_CLK_BUFD_N'
LOGICAL_PATH '@tubii_tk2_lib.tubii(sch_1):page1_i1@tubii_tk2_lib.tubii_pcb(sch_1):page1_i2@tubii_tk2_lib.clocks(sch_1):page1_i2@tubii_tk2_lib.fault_detection(sch_1):bckp_clk_bufd_p'; 'BCKP_CLK_BUFD_P'
LOGICAL_PATH '@tubii_tk2_lib.tubii(sch_1):page1_i1@tubii_tk2_lib.tubii_pcb(sch_1):page1_i8@tubii_tk2_lib.caen_coms(sch_1):page1_i1@tubii_tk2_lib.caen_analog_coms(sch_1):unnamed_1_caenbuffer_i21_cntrl'; 'UNNAMED_1_CAENBUFFER_I21_CNTRL'
LOGICAL_PATH '@tubii_tk2_lib.tubii(sch_1):page1_i1@tubii_tk2_lib.tubii_pcb(sch_1):page1_i8@tubii_tk2_lib.caen_coms(sch_1):page1_i1@tubii_tk2_lib.caen_analog_coms(sch_1):unnamed_1_caenbuffer_i22_cntrl'; 'UNNAMED_1_CAENBUFFER_I22_CNTRL'
LOGICAL_PATH '@tubii_tk2_lib.tubii(sch_1):page1_i1@tubii_tk2_lib.tubii_pcb(sch_1):page1_i8@tubii_tk2_lib.caen_coms(sch_1):page1_i1@tubii_tk2_lib.caen_analog_coms(sch_1):unnamed_1_caenbuffer_i23_cntrl'; 'UNNAMED_1_CAENBUFFER_I23_CNTRL'
LOGICAL_PATH '@tubii_tk2_lib.tubii(sch_1):page1_i1@tubii_tk2_lib.tubii_pcb(sch_1):page1_i1@tubii_tk2_lib.microzed_module(sch_1):\carrier_srst#\'; 'CARRIER_SRST#'
LOGICAL_PATH '@tubii_tk2_lib.tubii(sch_1):page1_i1@tubii_tk2_lib.tubii_pcb(sch_1):page1_i2@tubii_tk2_lib.clocks(sch_1):page1_i3@tubii_tk2_lib.change_clks(sch_1):change_clk2_n'; 'CHANGE_CLK2_N'
LOGICAL_PATH '@tubii_tk2_lib.tubii(sch_1):page1_i1@tubii_tk2_lib.tubii_pcb(sch_1):page1_i2@tubii_tk2_lib.clocks(sch_1):page1_i3@tubii_tk2_lib.change_clks(sch_1):change_clk2_p'; 'CHANGE_CLK2_P'
LOGICAL_PATH '@tubii_tk2_lib.tubii(sch_1):page1_i1@tubii_tk2_lib.tubii_pcb(sch_1):page1_i2@tubii_tk2_lib.clocks(sch_1):page1_i3@tubii_tk2_lib.change_clks(sch_1):chosen_clk2_n'; 'CHOSEN_CLK2_N'
LOGICAL_PATH '@tubii_tk2_lib.tubii(sch_1):page1_i1@tubii_tk2_lib.tubii_pcb(sch_1):page1_i2@tubii_tk2_lib.clocks(sch_1):page1_i3@tubii_tk2_lib.change_clks(sch_1):chosen_clk2_p'; 'CHOSEN_CLK2_P'
LOGICAL_PATH '@tubii_tk2_lib.tubii(sch_1):page1_i1@tubii_tk2_lib.tubii_pcb(sch_1):page1_i2@tubii_tk2_lib.clocks(sch_1):page1_i3@tubii_tk2_lib.change_clks(sch_1):chosen_clk_n'; 'CHOSEN_CLK_N'
LOGICAL_PATH '@tubii_tk2_lib.tubii(sch_1):page1_i1@tubii_tk2_lib.tubii_pcb(sch_1):page1_i2@tubii_tk2_lib.clocks(sch_1):page1_i3@tubii_tk2_lib.change_clks(sch_1):chosen_clk_p'; 'CHOSEN_CLK_P'
LOGICAL_PATH '@tubii_tk2_lib.tubii(sch_1):page1_i1@tubii_tk2_lib.tubii_pcb(sch_1):page1_i2@tubii_tk2_lib.clocks(sch_1):page1_i2@tubii_tk2_lib.fault_detection(sch_1):clk_bad_n'; 'CLK_BAD_N'
LOGICAL_PATH '@tubii_tk2_lib.tubii(sch_1):page1_i1@tubii_tk2_lib.tubii_pcb(sch_1):page1_i2@tubii_tk2_lib.clocks(sch_1):page1_i2@tubii_tk2_lib.fault_detection(sch_1):clk_bad_p'; 'CLK_BAD_P'
LOGICAL_PATH '@tubii_tk2_lib.tubii(sch_1):page1_i1@tubii_tk2_lib.tubii_pcb(sch_1):page1_i2@tubii_tk2_lib.clocks(sch_1):page1_i2@tubii_tk2_lib.fault_detection(sch_1):clk_missed'; 'CLK_MISSED'
LOGICAL_PATH '@tubii_tk2_lib.tubii(sch_1):page1_i1@tubii_tk2_lib.tubii_pcb(sch_1):page1_i2@tubii_tk2_lib.clocks(sch_1):page1_i1@tubii_tk2_lib.default_clk_sel(sch_1):clk_sel_ecl_n'; 'CLK_SEL_ECL_N'
LOGICAL_PATH '@tubii_tk2_lib.tubii(sch_1):page1_i1@tubii_tk2_lib.tubii_pcb(sch_1):page1_i2@tubii_tk2_lib.clocks(sch_1):page1_i1@tubii_tk2_lib.default_clk_sel(sch_1):clk_sel_ecl_p'; 'CLK_SEL_ECL_P'
LOGICAL_PATH '@tubii_tk2_lib.tubii(sch_1):page1_i1@tubii_tk2_lib.tubii_pcb(sch_1):page1_i2@tubii_tk2_lib.clocks(sch_1):page1_i2@tubii_tk2_lib.fault_detection(sch_1):clk_state'; 'CLK_STATE'
LOGICAL_PATH '@tubii_tk2_lib.tubii(sch_1):page1_i1@tubii_tk2_lib.tubii_pcb(sch_1):page1_i3@tubii_tk2_lib.mtca_mimic(sch_1):comp1_thresh'; 'COMP1_THRESH'
LOGICAL_PATH '@tubii_tk2_lib.tubii(sch_1):page1_i1@tubii_tk2_lib.tubii_pcb(sch_1):page1_i3@tubii_tk2_lib.mtca_mimic(sch_1):comp2_thresh'; 'COMP2_THRESH'
LOGICAL_PATH '@tubii_tk2_lib.tubii(sch_1):page1_i1@tubii_tk2_lib.tubii_pcb(sch_1):page1_i2@tubii_tk2_lib.clocks(sch_1):page1_i2@tubii_tk2_lib.fault_detection(sch_1):count'; 'COUNT'
LOGICAL_PATH '@tubii_tk2_lib.tubii(sch_1):page1_i1@tubii_tk2_lib.tubii_pcb(sch_1):page1_i2@tubii_tk2_lib.clocks(sch_1):count_data_ecl(0)'; 'COUNT_DATA_ECL<0>'
LOGICAL_PATH '@tubii_tk2_lib.tubii(sch_1):page1_i1@tubii_tk2_lib.tubii_pcb(sch_1):page1_i2@tubii_tk2_lib.clocks(sch_1):count_data_ecl(2)'; 'COUNT_DATA_ECL<2>'
LOGICAL_PATH '@tubii_tk2_lib.tubii(sch_1):page1_i1@tubii_tk2_lib.tubii_pcb(sch_1):page1_i2@tubii_tk2_lib.clocks(sch_1):count_data_ecl(4)'; 'COUNT_DATA_ECL<4>'
LOGICAL_PATH '@tubii_tk2_lib.tubii(sch_1):page1_i1@tubii_tk2_lib.tubii_pcb(sch_1):page1_i2@tubii_tk2_lib.clocks(sch_1):count_data_ecl(6)'; 'COUNT_DATA_ECL<6>'
LOGICAL_PATH '@tubii_tk2_lib.tubii(sch_1):page1_i1@tubii_tk2_lib.tubii_pcb(sch_1):unnamed_1_exttrigs_i70_exttrigout(10)'; 'UNNAMED_1_EXTTRIGS_I70_EXTT<10>'
LOGICAL_PATH '@tubii_tk2_lib.tubii(sch_1):page1_i1@tubii_tk2_lib.tubii_pcb(sch_1):unnamed_1_exttrigs_i70_exttrigout(12)'; 'UNNAMED_1_EXTTRIGS_I70_EXTT<12>'
LOGICAL_PATH '@tubii_tk2_lib.tubii(sch_1):page1_i1@tubii_tk2_lib.tubii_pcb(sch_1):unnamed_1_exttrigs_i70_exttrigout(14)'; 'UNNAMED_1_EXTTRIGS_I70_EXTT<14>'
LOGICAL_PATH '@tubii_tk2_lib.tubii(sch_1):page1_i1@tubii_tk2_lib.tubii_pcb(sch_1):unnamed_1_exttrigs_i70_exttrigout(0)'; 'UNNAMED_1_EXTTRIGS_I70_EXTTR<0>'
LOGICAL_PATH '@tubii_tk2_lib.tubii(sch_1):page1_i1@tubii_tk2_lib.tubii_pcb(sch_1):unnamed_1_exttrigs_i70_exttrigout(2)'; 'UNNAMED_1_EXTTRIGS_I70_EXTTR<2>'
LOGICAL_PATH '@tubii_tk2_lib.tubii(sch_1):page1_i1@tubii_tk2_lib.tubii_pcb(sch_1):unnamed_1_exttrigs_i70_exttrigout(4)'; 'UNNAMED_1_EXTTRIGS_I70_EXTTR<4>'
LOGICAL_PATH '@tubii_tk2_lib.tubii(sch_1):page1_i1@tubii_tk2_lib.tubii_pcb(sch_1):unnamed_1_exttrigs_i70_exttrigout(6)'; 'UNNAMED_1_EXTTRIGS_I70_EXTTR<6>'
LOGICAL_PATH '@tubii_tk2_lib.tubii(sch_1):page1_i1@tubii_tk2_lib.tubii_pcb(sch_1):unnamed_1_exttrigs_i70_exttrigout(8)'; 'UNNAMED_1_EXTTRIGS_I70_EXTTR<8>'
LOGICAL_PATH '@tubii_tk2_lib.tubii(sch_1):unnamed_2_frontports_i2_caenoutanal(0)'; 'UNNAMED_2_FRONTPORTS_I2_CAEN<0>'
LOGICAL_PATH '@tubii_tk2_lib.tubii(sch_1):unnamed_2_frontports_i2_caenoutanal(2)'; 'UNNAMED_2_FRONTPORTS_I2_CAEN<2>'
LOGICAL_PATH '@tubii_tk2_lib.tubii(sch_1):unnamed_2_frontports_i2_caenoutanal(4)'; 'UNNAMED_2_FRONTPORTS_I2_CAEN<4>'
LOGICAL_PATH '@tubii_tk2_lib.tubii(sch_1):unnamed_2_frontports_i2_caenoutanal(6)'; 'UNNAMED_2_FRONTPORTS_I2_CAEN<6>'
LOGICAL_PATH '@tubii_tk2_lib.tubii(sch_1):unnamed_2_frontports_i2_dgtp'; 'UNNAMED_2_FRONTPORTS_I2_DGTP'
LOGICAL_PATH '@tubii_tk2_lib.tubii(sch_1):unnamed_2_frontports_i2_ecltolvdsin'; 'UNNAMED_2_FRONTPORTS_I2_ECLTOLV'
LOGICAL_PATH '@tubii_tk2_lib.tubii(sch_1):unnamed_2_frontports_i2_ecltonimin'; 'UNNAMED_2_FRONTPORTS_I2_ECLTONI'
LOGICAL_PATH '@tubii_tk2_lib.tubii(sch_1):unnamed_2_frontports_i2_ecltottlin'; 'UNNAMED_2_FRONTPORTS_I2_ECLTOTT'
LOGICAL_PATH '@tubii_tk2_lib.tubii(sch_1):unnamed_2_frontports_i2_ecltolvdsoutp'; 'UNNAMED_2_FRONTPORTS_I2_ECLTO_2'
LOGICAL_PATH '@tubii_tk2_lib.tubii(sch_1):unnamed_2_frontports_i2_ecltonimout'; 'UNNAMED_2_FRONTPORTS_I2_ECLTO_3'
LOGICAL_PATH '@tubii_tk2_lib.tubii(sch_1):unnamed_2_frontports_i2_ecltottlout'; 'UNNAMED_2_FRONTPORTS_I2_ECLTO_4'
LOGICAL_PATH '@tubii_tk2_lib.tubii(sch_1):unnamed_2_frontports_i2_exttrigin(11)'; 'UNNAMED_2_FRONTPORTS_I2_EXT<11>'
LOGICAL_PATH '@tubii_tk2_lib.tubii(sch_1):unnamed_2_frontports_i2_exttrigin(13)'; 'UNNAMED_2_FRONTPORTS_I2_EXT<13>'
LOGICAL_PATH '@tubii_tk2_lib.tubii(sch_1):unnamed_2_frontports_i2_exttrigin(15)'; 'UNNAMED_2_FRONTPORTS_I2_EXT<15>'
LOGICAL_PATH '@tubii_tk2_lib.tubii(sch_1):unnamed_2_frontports_i2_extpedin'; 'UNNAMED_2_FRONTPORTS_I2_EXTPEDI'
LOGICAL_PATH '@tubii_tk2_lib.tubii(sch_1):unnamed_2_frontports_i2_extpedout'; 'UNNAMED_2_FRONTPORTS_I2_EXTPEDO'
LOGICAL_PATH '@tubii_tk2_lib.tubii(sch_1):unnamed_2_frontports_i2_exttrigin(1)'; 'UNNAMED_2_FRONTPORTS_I2_EXTT<1>'
LOGICAL_PATH '@tubii_tk2_lib.tubii(sch_1):unnamed_2_frontports_i2_exttrigin(3)'; 'UNNAMED_2_FRONTPORTS_I2_EXTT<3>'
LOGICAL_PATH '@tubii_tk2_lib.tubii(sch_1):unnamed_2_frontports_i2_exttrigin(5)'; 'UNNAMED_2_FRONTPORTS_I2_EXTT<5>'
LOGICAL_PATH '@tubii_tk2_lib.tubii(sch_1):unnamed_2_frontports_i2_exttrigin(7)'; 'UNNAMED_2_FRONTPORTS_I2_EXTT<7>'
LOGICAL_PATH '@tubii_tk2_lib.tubii(sch_1):unnamed_2_frontports_i2_exttrigin(9)'; 'UNNAMED_2_FRONTPORTS_I2_EXTT<9>'
LOGICAL_PATH '@tubii_tk2_lib.tubii(sch_1):unnamed_2_frontports_i2_genericdelayin'; 'UNNAMED_2_FRONTPORTS_I2_GENERIC'
LOGICAL_PATH '@tubii_tk2_lib.tubii(sch_1):unnamed_2_frontports_i2_genericdelayout'; 'UNNAMED_2_FRONTPORTS_I2_GENER_1'
LOGICAL_PATH '@tubii_tk2_lib.tubii(sch_1):unnamed_2_frontports_i2_genericpulseout'; 'UNNAMED_2_FRONTPORTS_I2_GENER_2'
LOGICAL_PATH '@tubii_tk2_lib.tubii(sch_1):unnamed_2_frontports_i2_gtn'; 'UNNAMED_2_FRONTPORTS_I2_GTN'
LOGICAL_PATH '@tubii_tk2_lib.tubii(sch_1):unnamed_2_frontports_i2_gtnim'; 'UNNAMED_2_FRONTPORTS_I2_GTNIM'
LOGICAL_PATH '@tubii_tk2_lib.tubii(sch_1):unnamed_2_frontports_i2_gtp'; 'UNNAMED_2_FRONTPORTS_I2_GTP'
LOGICAL_PATH '@tubii_tk2_lib.tubii(sch_1):unnamed_2_frontports_i2_lostaroutn'; 'UNNAMED_2_FRONTPORTS_I2_LOSTARO'
LOGICAL_PATH '@tubii_tk2_lib.tubii(sch_1):unnamed_2_frontports_i2_lostaroutp'; 'UNNAMED_2_FRONTPORTS_I2_LOSTA_1'
LOGICAL_PATH '@tubii_tk2_lib.tubii(sch_1):unnamed_2_frontports_i2_lvdstoeclout'; 'UNNAMED_2_FRONTPORTS_I2_LVDST_2'
LOGICAL_PATH '@tubii_tk2_lib.tubii(sch_1):unnamed_2_frontports_i2_mtcamimic1outn'; 'UNNAMED_2_FRONTPORTS_I2_MTCAMIM'
LOGICAL_PATH '@tubii_tk2_lib.tubii(sch_1):unnamed_2_frontports_i2_mtcamimic1outp'; 'UNNAMED_2_FRONTPORTS_I2_MTCAM_1'
LOGICAL_PATH '@tubii_tk2_lib.tubii(sch_1):unnamed_2_frontports_i2_mtcamimic1pulseanal'; 'UNNAMED_2_FRONTPORTS_I2_MTCAM_2'
LOGICAL_PATH '@tubii_tk2_lib.tubii(sch_1):unnamed_2_frontports_i2_mtcamimic2outn'; 'UNNAMED_2_FRONTPORTS_I2_MTCAM_3'
LOGICAL_PATH '@tubii_tk2_lib.tubii(sch_1):unnamed_2_frontports_i2_mtcamimic2outp'; 'UNNAMED_2_FRONTPORTS_I2_MTCAM_4'
LOGICAL_PATH '@tubii_tk2_lib.tubii(sch_1):unnamed_2_frontports_i2_mtcamimic2pulseanal'; 'UNNAMED_2_FRONTPORTS_I2_MTCAM_5'
LOGICAL_PATH '@tubii_tk2_lib.tubii(sch_1):unnamed_2_frontports_i2_mtcdlo'; 'UNNAMED_2_FRONTPORTS_I2_MTCDLO'
LOGICAL_PATH '@tubii_tk2_lib.tubii(sch_1):unnamed_2_frontports_i2_nimtoeclin'; 'UNNAMED_2_FRONTPORTS_I2_NIMTOEC'
LOGICAL_PATH '@tubii_tk2_lib.tubii(sch_1):unnamed_2_frontports_i2_nimtoeclout'; 'UNNAMED_2_FRONTPORTS_I2_NIMTO_1'
LOGICAL_PATH '@tubii_tk2_lib.tubii(sch_1):unnamed_2_frontports_i2_pulseinanal(11)'; 'UNNAMED_2_FRONTPORTS_I2_PUL<11>'
LOGICAL_PATH '@tubii_tk2_lib.tubii(sch_1):unnamed_2_frontports_i2_pulseinanal(1)'; 'UNNAMED_2_FRONTPORTS_I2_PULS<1>'
LOGICAL_PATH '@tubii_tk2_lib.tubii(sch_1):unnamed_2_frontports_i2_pulseinanal(3)'; 'UNNAMED_2_FRONTPORTS_I2_PULS<3>'
LOGICAL_PATH '@tubii_tk2_lib.tubii(sch_1):unnamed_2_frontports_i2_pulseinanal(5)'; 'UNNAMED_2_FRONTPORTS_I2_PULS<5>'
LOGICAL_PATH '@tubii_tk2_lib.tubii(sch_1):unnamed_2_frontports_i2_pulseinanal(7)'; 'UNNAMED_2_FRONTPORTS_I2_PULS<7>'
LOGICAL_PATH '@tubii_tk2_lib.tubii(sch_1):unnamed_2_frontports_i2_pulseinanal(9)'; 'UNNAMED_2_FRONTPORTS_I2_PULS<9>'
LOGICAL_PATH '@tubii_tk2_lib.tubii(sch_1):unnamed_2_frontports_i2_pulseinvin'; 'UNNAMED_2_FRONTPORTS_I2_PULSEIN'
LOGICAL_PATH '@tubii_tk2_lib.tubii(sch_1):unnamed_2_frontports_i2_pulseinvout'; 'UNNAMED_2_FRONTPORTS_I2_PULSE_1'
LOGICAL_PATH '@tubii_tk2_lib.tubii(sch_1):unnamed_2_frontports_i2_ribbonpulseinn'; 'UNNAMED_2_FRONTPORTS_I2_RIBBONP'
LOGICAL_PATH '@tubii_tk2_lib.tubii(sch_1):unnamed_2_frontports_i2_ribbonpulseinp'; 'UNNAMED_2_FRONTPORTS_I2_RIBBO_1'
LOGICAL_PATH '@tubii_tk2_lib.tubii(sch_1):unnamed_2_frontports_i2_ribbonpulseoutn'; 'UNNAMED_2_FRONTPORTS_I2_RIBBO_2'
LOGICAL_PATH '@tubii_tk2_lib.tubii(sch_1):unnamed_2_frontports_i2_ribbonpulseoutp'; 'UNNAMED_2_FRONTPORTS_I2_RIBBO_3'
LOGICAL_PATH '@tubii_tk2_lib.tubii(sch_1):unnamed_2_frontports_i2_scaler(2)'; 'UNNAMED_2_FRONTPORTS_I2_SCAL<2>'
LOGICAL_PATH '@tubii_tk2_lib.tubii(sch_1):unnamed_2_frontports_i2_scaler(4)'; 'UNNAMED_2_FRONTPORTS_I2_SCAL<4>'
LOGICAL_PATH '@tubii_tk2_lib.tubii(sch_1):unnamed_2_frontports_i2_scaler(6)'; 'UNNAMED_2_FRONTPORTS_I2_SCAL<6>'
LOGICAL_PATH '@tubii_tk2_lib.tubii(sch_1):unnamed_2_frontports_i2_scopeoutanal(1)'; 'UNNAMED_2_FRONTPORTS_I2_SCOP<1>'
LOGICAL_PATH '@tubii_tk2_lib.tubii(sch_1):unnamed_2_frontports_i2_scopeoutanal(3)'; 'UNNAMED_2_FRONTPORTS_I2_SCOP<3>'
LOGICAL_PATH '@tubii_tk2_lib.tubii(sch_1):unnamed_2_frontports_i2_scopeoutanal(5)'; 'UNNAMED_2_FRONTPORTS_I2_SCOP<5>'
LOGICAL_PATH '@tubii_tk2_lib.tubii(sch_1):unnamed_2_frontports_i2_scopeoutanal(7)'; 'UNNAMED_2_FRONTPORTS_I2_SCOP<7>'
LOGICAL_PATH '@tubii_tk2_lib.tubii(sch_1):unnamed_2_frontports_i2_smelliedelayin'; 'UNNAMED_2_FRONTPORTS_I2_SMELLIE'
LOGICAL_PATH '@tubii_tk2_lib.tubii(sch_1):unnamed_2_frontports_i2_smelliedelayout'; 'UNNAMED_2_FRONTPORTS_I2_SMELL_1'
LOGICAL_PATH '@tubii_tk2_lib.tubii(sch_1):unnamed_2_frontports_i2_smelliepulseout'; 'UNNAMED_2_FRONTPORTS_I2_SMELL_2'
LOGICAL_PATH '@tubii_tk2_lib.tubii(sch_1):unnamed_2_frontports_i2_sync24lvdsn'; 'UNNAMED_2_FRONTPORTS_I2_SYNC24L'
LOGICAL_PATH '@tubii_tk2_lib.tubii(sch_1):unnamed_2_frontports_i2_sync24n'; 'UNNAMED_2_FRONTPORTS_I2_SYNC24N'
LOGICAL_PATH '@tubii_tk2_lib.tubii(sch_1):unnamed_2_frontports_i2_sync24p'; 'UNNAMED_2_FRONTPORTS_I2_SYNC24P'
LOGICAL_PATH '@tubii_tk2_lib.tubii(sch_1):unnamed_2_frontports_i2_sync24lvdsp'; 'UNNAMED_2_FRONTPORTS_I2_SYNC2_1'
LOGICAL_PATH '@tubii_tk2_lib.tubii(sch_1):unnamed_2_frontports_i2_synclvdsn'; 'UNNAMED_2_FRONTPORTS_I2_SYNCLVD'
LOGICAL_PATH '@tubii_tk2_lib.tubii(sch_1):unnamed_2_frontports_i2_synclvdsp'; 'UNNAMED_2_FRONTPORTS_I2_SYNCL_1'
LOGICAL_PATH '@tubii_tk2_lib.tubii(sch_1):unnamed_2_frontports_i2_syncn'; 'UNNAMED_2_FRONTPORTS_I2_SYNCN'
LOGICAL_PATH '@tubii_tk2_lib.tubii(sch_1):unnamed_2_frontports_i2_syncp'; 'UNNAMED_2_FRONTPORTS_I2_SYNCP'
LOGICAL_PATH '@tubii_tk2_lib.tubii(sch_1):unnamed_2_frontports_i2_telliedelayin'; 'UNNAMED_2_FRONTPORTS_I2_TELLIED'
LOGICAL_PATH '@tubii_tk2_lib.tubii(sch_1):unnamed_2_frontports_i2_telliepulseout'; 'UNNAMED_2_FRONTPORTS_I2_TELLIEP'
LOGICAL_PATH '@tubii_tk2_lib.tubii(sch_1):unnamed_2_frontports_i2_telliedelayout'; 'UNNAMED_2_FRONTPORTS_I2_TELLI_1'
LOGICAL_PATH '@tubii_tk2_lib.tubii(sch_1):unnamed_2_frontports_i2_ttltoeclin'; 'UNNAMED_2_FRONTPORTS_I2_TTLTOEC'
LOGICAL_PATH '@tubii_tk2_lib.tubii(sch_1):unnamed_2_frontports_i2_ttltoeclout'; 'UNNAMED_2_FRONTPORTS_I2_TTLTO_1'
LOGICAL_PATH '@tubii_tk2_lib.tubii(sch_1):unnamed_2_frontports_i2_tubiirtout'; 'UNNAMED_2_FRONTPORTS_I2_TUBIIRT'
LOGICAL_PATH '@tubii_tk2_lib.tubii(sch_1):page1_i1@tubii_tk2_lib.tubii_pcb(sch_1):unnamed_1_generalutilities_i4_genericpulsein'; 'UNNAMED_1_GENERALUTILITIES_I4_1'
LOGICAL_PATH '@tubii_tk2_lib.tubii(sch_1):page1_i1@tubii_tk2_lib.tubii_pcb(sch_1):unnamed_1_generalutilities_i4_genericdelayin'; 'UNNAMED_1_GENERALUTILITIES_I4_G'
LOGICAL_PATH '@tubii_tk2_lib.tubii(sch_1):page1_i1@tubii_tk2_lib.tubii_pcb(sch_1):page1_i4@tubii_tk2_lib.general_utilities(sch_1):page1_i5@tubii_tk2_lib.generic_delays(sch_1):unnamed_1_hct123_i22_q1'; 'UNNAMED_1_HCT123_I22_Q1'
LOGICAL_PATH '@tubii_tk2_lib.tubii(sch_1):page1_i1@tubii_tk2_lib.tubii_pcb(sch_1):page1_i4@tubii_tk2_lib.general_utilities(sch_1):page1_i5@tubii_tk2_lib.generic_delays(sch_1):unnamed_1_hct123_i22_q2'; 'UNNAMED_1_HCT123_I22_Q2'
LOGICAL_PATH '@tubii_tk2_lib.tubii(sch_1):page1_i1@tubii_tk2_lib.tubii_pcb(sch_1):page1_i2@tubii_tk2_lib.clocks(sch_1):page1_i2@tubii_tk2_lib.fault_detection(sch_1):unnamed_1_hct123_i29_cext1'; 'UNNAMED_1_HCT123_I29_CEXT1'
LOGICAL_PATH '@tubii_tk2_lib.tubii(sch_1):page1_i1@tubii_tk2_lib.tubii_pcb(sch_1):page1_i3@tubii_tk2_lib.mtca_mimic(sch_1):page1_i16@tubii_tk2_lib.trigger_logic(sch_1):unnamed_1_hct123_i54_q1'; 'UNNAMED_1_HCT123_I54_Q1'
LOGICAL_PATH '@tubii_tk2_lib.tubii(sch_1):page1_i1@tubii_tk2_lib.tubii_pcb(sch_1):page1_i3@tubii_tk2_lib.mtca_mimic(sch_1):page1_i16@tubii_tk2_lib.trigger_logic(sch_1):unnamed_1_hct123_i54_q2'; 'UNNAMED_1_HCT123_I54_Q2'
LOGICAL_PATH '@tubii_tk2_lib.tubii(sch_1):page1_i1@tubii_tk2_lib.tubii_pcb(sch_1):unnamed_1_hct238_i53_a1'; 'UNNAMED_1_HCT238_I53_A1'
$END
