marzece/Tubii_Tk2/Documentation/FinishedLayout.png

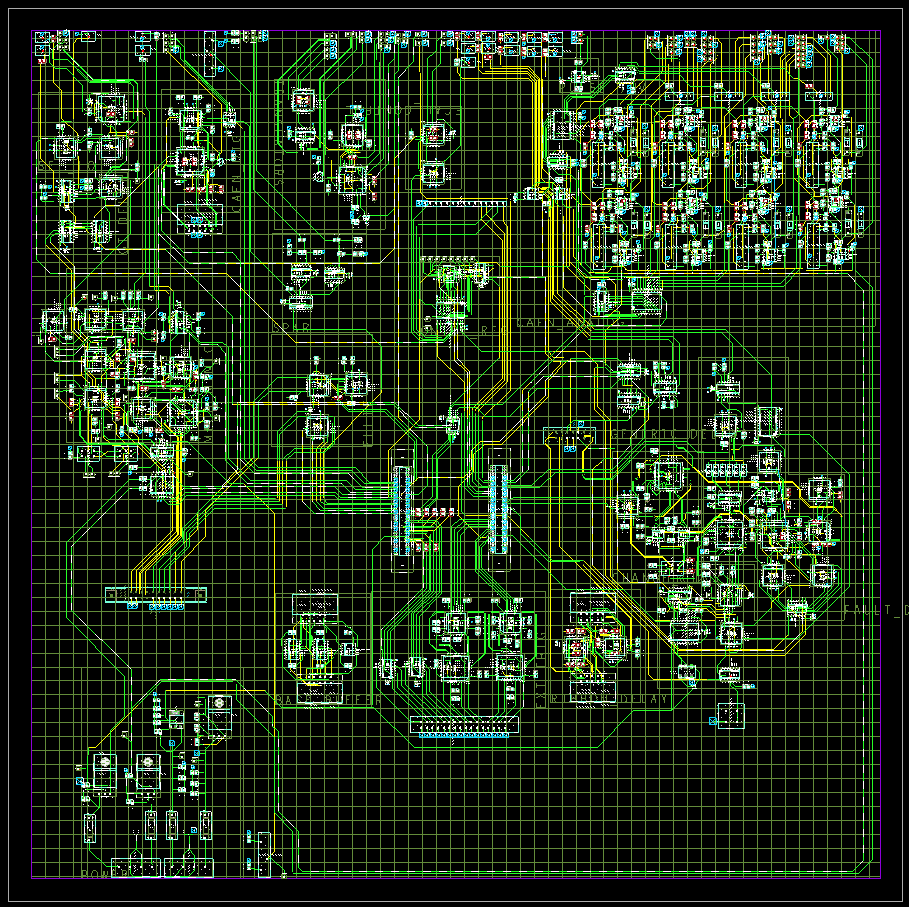
Documentation/FinishedLayout.png
