marzece/Tubii_Tk2/Finished3D.png

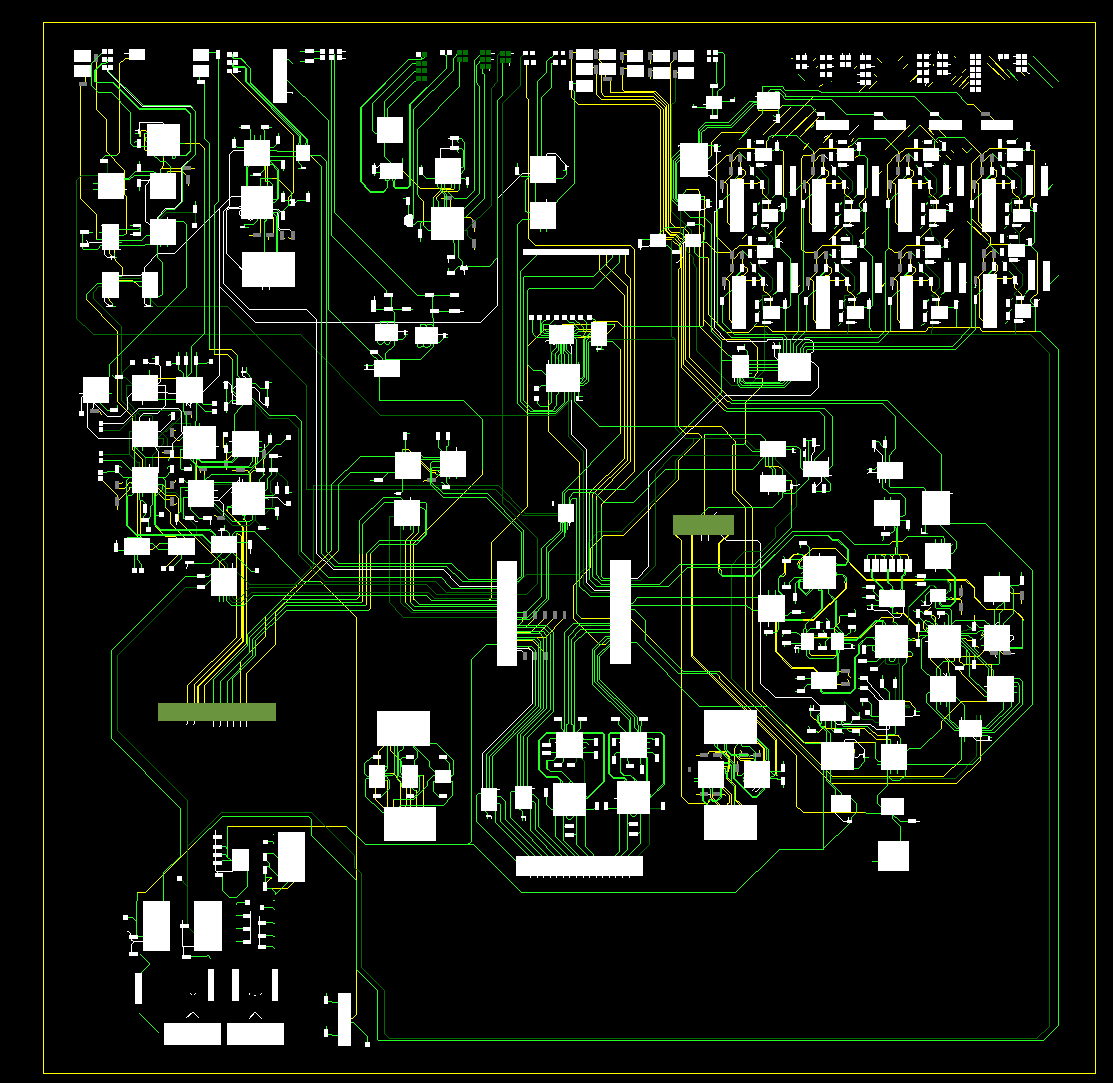
Finished3D.png
