marzece/Tubii_Tk2/temp/xxnedtmp29/undo1/#UNNAMED_PennShiel_bmp.bmp

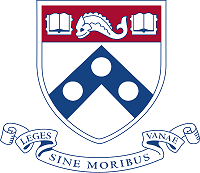
temp/xxnedtmp29/undo1/#UNNAMED_PennShiel_bmp.bmp
