marzece/Tubii_Tk2/Parts/parts/diodes/1n5822/metadata/pinlist.txt

(Pinlist
	(Pin
		(Name AN)
		(MSB )
		(LSB )
		(Type ANALOG)
		(Location Left)
		(InputLoadLow )
		(InputLoadHigh )
		(OutputLoadLow )
		(OutputLoadHigh )
		(CheckLoad Off)
		(CheckIO Off)
		(CheckDir 0)
		(CheckAssert 0)
		(CheckOutput 0)
		(UnknownLoading 0)
		(PinShape )
		(DIFF_PAIR_PINS_POS )
		(DIFF_PAIR_PINS_NEG )
	)

	(Pin
		(Name CAT)
		(MSB )
		(LSB )
		(Type ANALOG)
		(Location Right)
		(InputLoadLow )
		(InputLoadHigh )
		(OutputLoadLow )
		(OutputLoadHigh )
		(CheckLoad Off)
		(CheckIO Off)
		(CheckDir 0)
		(CheckAssert 0)
		(CheckOutput 0)
		(UnknownLoading 0)
		(PinShape )
		(DIFF_PAIR_PINS_POS )
		(DIFF_PAIR_PINS_NEG )
	)

)
