marzece/Tubii_Tk2/Parts/parts/ttl/ds1023200/metadata/pinlist.txt

(Pinlist
	(Pin
		(Name P7)
		(MSB )
		(LSB )
		(Type INPUT)
		(Location Left)
		(InputLoadLow -0.6)
		(InputLoadHigh 0.02)
		(OutputLoadLow )
		(OutputLoadHigh )
		(CheckLoad Both)
		(CheckIO Both)
		(CheckDir 1)
		(CheckAssert 1)
		(CheckOutput 1)
		(UnknownLoading 0)
		(PinShape )
		(DIFF_PAIR_PINS_POS )
		(DIFF_PAIR_PINS_NEG )
	)

	(Pin
		(Name P6)
		(MSB )
		(LSB )
		(Type INPUT)
		(Location Left)
		(InputLoadLow -0.6)
		(InputLoadHigh 0.02)
		(OutputLoadLow )
		(OutputLoadHigh )
		(CheckLoad Both)
		(CheckIO Both)
		(CheckDir 1)
		(CheckAssert 1)
		(CheckOutput 1)
		(UnknownLoading 0)
		(PinShape )
		(DIFF_PAIR_PINS_POS )
		(DIFF_PAIR_PINS_NEG )
	)

	(Pin
		(Name P5)
		(MSB )
		(LSB )
		(Type INPUT)
		(Location Left)
		(InputLoadLow -0.6)
		(InputLoadHigh 0.02)
		(OutputLoadLow )
		(OutputLoadHigh )
		(CheckLoad Both)
		(CheckIO Both)
		(CheckDir 1)
		(CheckAssert 1)
		(CheckOutput 1)
		(UnknownLoading 0)
		(PinShape )
		(DIFF_PAIR_PINS_POS )
		(DIFF_PAIR_PINS_NEG )
	)

	(Pin
		(Name MS)
		(MSB )
		(LSB )
		(Type INPUT)
		(Location Left)
		(InputLoadLow -0.6)
		(InputLoadHigh 0.02)
		(OutputLoadLow )
		(OutputLoadHigh )
		(CheckLoad Both)
		(CheckIO Both)
		(CheckDir 1)
		(CheckAssert 1)
		(CheckOutput 1)
		(UnknownLoading 0)
		(PinShape )
		(DIFF_PAIR_PINS_POS )
		(DIFF_PAIR_PINS_NEG )
	)

	(Pin
		(Name Q/P0)
		(MSB )
		(LSB )
		(Type INPUT)
		(Location Left)
		(InputLoadLow -0.6)
		(InputLoadHigh 0.02)
		(OutputLoadLow )
		(OutputLoadHigh )
		(CheckLoad Both)
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
		(LSB )
		(Type POWER)
		(Location Top)
		(InputLoadLow )
		(InputLoadHigh )
		(OutputLoadLow )
		(OutputLoadHigh )
		(CheckLoad Off)
		(CheckIO Off)
		(CheckDir 0)
		(CheckAssert 0)
		(CheckOutput 0)
		(UnknownLoading 0)
		(PinShape )
		(DIFF_PAIR_PINS_POS )
		(DIFF_PAIR_PINS_NEG )
	)

)
