marzece/Tubii_Tk2/Parts/parts/ttl/74lv07a/metadata/pinlist.txt

(Pinlist
	(Pin
		(Name A1)
		(MSB )
		(LSB )
		(Type INPUT)
		(Location Left)
		(InputLoadLow -0.010000)
		(InputLoadHigh 0.010000)
		(OutputLoadLow )
		(OutputLoadHigh )
		(CheckLoad Both)
		(CheckIO Both)
		(CheckDir 1)
		(CheckAssert 1)
		(CheckOutput 1)
		(UnknownLoading 0)
		(PinShape Line)
		(DIFF_PAIR_PINS_POS )
		(DIFF_PAIR_PINS_NEG )
	)

	(Pin
		(Name A2)
		(MSB )
		(LSB )
		(Type INPUT)
		(Location Left)
		(InputLoadLow -0.010000)
		(InputLoadHigh 0.010000)
		(OutputLoadLow )
		(OutputLoadHigh )
		(CheckLoad Both)
		(CheckIO Both)
		(CheckDir 1)
		(CheckAssert 1)
		(CheckOutput 1)
		(UnknownLoading 0)
		(PinShape Line)
		(DIFF_PAIR_PINS_POS )
		(DIFF_PAIR_PINS_NEG )
	)

	(Pin
		(Name A3)
		(MSB )
		(LSB )
		(Type INPUT)
		(Location Left)
		(InputLoadLow -0.010000)
		(InputLoadHigh 0.010000)
		(OutputLoadLow )
		(OutputLoadHigh )
		(CheckLoad Both)
		(CheckIO Both)
		(CheckDir 1)
		(CheckAssert 1)
		(CheckOutput 1)
		(UnknownLoading 0)
		(PinShape Line)
		(DIFF_PAIR_PINS_POS )
		(DIFF_PAIR_PINS_NEG )
	)

	(Pin
		(Name A4)
		(MSB )
		(LSB )
		(Type INPUT)
		(Location Left)
		(InputLoadLow -0.010000)
		(InputLoadHigh 0.010000)
		(OutputLoadLow )
		(OutputLoadHigh )
		(CheckLoad Both)
		(CheckIO Both)
		(CheckDir 1)
		(CheckAssert 1)
		(CheckOutput 1)
		(UnknownLoading 0)
		(PinShape Line)
		(DIFF_PAIR_PINS_POS )
		(DIFF_PAIR_PINS_NEG )
	)

	(Pin
		(Name A5)
		(MSB )
		(LSB )
		(Type INPUT)
		(Location Left)
		(InputLoadLow -0.010000)
		(InputLoadHigh 0.010000)
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
		(LSB )
		(Type POWER)
		(Location Top)
		(InputLoadLow )
		(InputLoadHigh )
		(OutputLoadLow )
		(OutputLoadHigh )
		(CheckLoad Off)
		(CheckIO Off)
		(CheckDir 0)
		(CheckAssert 0)
		(CheckOutput 0)
		(UnknownLoading 0)
		(PinShape Line)
		(DIFF_PAIR_PINS_POS )
		(DIFF_PAIR_PINS_NEG )
	)

)
