marzece/Tubii_Tk2/Parts/parts/regulators/7815s_l/metadata/pinlist.txt

(Pinlist
	(Pin
		(Name OUTPUT)
		(MSB )
		(LSB )
		(Type UNSPEC)
		(Location Right)
		(InputLoadLow )
		(InputLoadHigh )
		(OutputLoadLow )
		(OutputLoadHigh )
		(CheckLoad Both)
		(CheckIO Both)
		(CheckDir 1)
		(CheckAssert 1)
		(CheckOutput 1)
		(UnknownLoading 0)
		(PinShape Line)
		(DIFF_PAIR_PINS_POS )
		(DIFF_PAIR_PINS_NEG )
	)

	(Pin
		(Name INPUT)
		(MSB )
		(LSB )
		(Type UNSPEC)
		(Location Left)
		(InputLoadLow )
		(InputLoadHigh )
		(OutputLoadLow )
		(OutputLoadHigh )
		(CheckLoad Both)
		(CheckIO Both)
		(CheckDir 1)
		(CheckAssert 1)
		(CheckOutput 1)
		(UnknownLoading 0)
		(PinShape Line)
		(DIFF_PAIR_PINS_POS )
		(DIFF_PAIR_PINS_NEG )
	)

	(Pin
		(Name GROUND)
		(MSB )
		(LSB )
		(Type UNSPEC)
		(Location Bottom)
		(InputLoadLow )
		(InputLoadHigh )
		(OutputLoadLow )
		(OutputLoadHigh )
		(CheckLoad Both)
		(CheckIO Both)
		(CheckDir 1)
		(CheckAssert 1)
		(CheckOutput 1)
		(UnknownLoading 0)
		(PinShape Line)
		(DIFF_PAIR_PINS_POS )
		(DIFF_PAIR_PINS_NEG )
	)

	(Pin
		(Name OUTPUT_2)
		(MSB )
		(LSB )
		(Type ANALOG)
		(Location Right)
		(InputLoadLow )
		(InputLoadHigh )
		(OutputLoadLow )
		(OutputLoadHigh )
		(CheckLoad Off)
		(CheckIO Off)
		(CheckDir 0)
		(CheckAssert 0)
		(CheckOutput 0)
		(UnknownLoading 0)
		(PinShape Line)
		(DIFF_PAIR_PINS_POS )
		(DIFF_PAIR_PINS_NEG )
	)

)
