marzece/Tubii_Tk2/Parts/parts/ttl/74hct164/metadata/pinlist.txt

(Pinlist
	(Pin
		(Name DSA)
		(MSB )
		(LSB )
		(Type INPUT)
		(Location Left)
		(InputLoadLow -0.010000)
		(InputLoadHigh 0.010000)
		(OutputLoadLow )
		(OutputLoadHigh )
		(CheckLoad Both)
		(CheckIO Both)
		(CheckDir 1)
		(CheckAssert 1)
		(CheckOutput 1)
		(UnknownLoading 0)
		(PinShape Line)
		(DIFF_PAIR_PINS_POS )
		(DIFF_PAIR_PINS_NEG )
	)

	(Pin
		(Name DSB)
		(MSB )
		(LSB )
		(Type INPUT)
		(Location Left)
		(InputLoadLow -0.010000)
		(InputLoadHigh 0.010000)
		(OutputLoadLow )
		(OutputLoadHigh )
		(CheckLoad Both)
		(CheckIO Both)
		(CheckDir 1)
		(CheckAssert 1)
		(CheckOutput 1)
		(UnknownLoading 0)
		(PinShape Line)
		(DIFF_PAIR_PINS_POS )
		(DIFF_PAIR_PINS_NEG )
	)

	(Pin
		(Name Q0)
		(MSB )
		(LSB )
		(Type OUTPUT)
		(Location Right)
		(InputLoadLow )
		(InputLoadHigh )
		(OutputLoadLow -1.000000)
		(OutputLoadHigh 1.000000)
		(CheckLoad Both)
		(CheckIO Both)
		(CheckDir 1)
		(CheckAssert 1)
		(CheckOutput 1)
		(UnknownLoading 0)
		(PinShape Line)
		(DIFF_PAIR_PINS_POS )
		(DIFF_PAIR_PINS_NEG )
	)

	(Pin
		(Name Q1)
		(MSB )
		(LSB )
		(Type OUTPUT)
		(Location Right)
		(InputLoadLow )
		(InputLoadHigh )
		(OutputLoadLow -1.000000)
		(OutputLoadHigh 1.000000)
		(CheckLoad Both)
		(CheckIO Both)
		(CheckDir 1)
		(CheckAssert 1)
		(CheckOutput 1)
		(UnknownLoading 0)
		(PinShape Line)
		(DIFF_PAIR_PINS_POS )
		(DIFF_PAIR_PINS_NEG )
	)

	(Pin
		(Name Q2)
		(MSB )
		(LSB )
		(Type OUTPUT)
		(Location Right)
		(InputLoadLow )
		(InputLoadHigh )
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
		(Location Left)
		(InputLoadLow -0.010000)
		(InputLoadHigh 0.010000)
		(OutputLoadLow )
		(OutputLoadHigh )
		(CheckLoad Both)
		(CheckIO Both)
		(CheckDir 1)
		(CheckAssert 1)
		(CheckOutput 1)
		(UnknownLoading 0)
		(PinShape Dot)
		(DIFF_PAIR_PINS_POS )
		(DIFF_PAIR_PINS_NEG )
	)

)
