marzece/Tubii_Tk2/(list of files, cad)

Other CAD files:
Parts/parts/capacitors/cap_1210/chips/chips.prt
Parts/parts/capacitors/cap_l/chips/chips.prt
Parts/parts/capacitors/csmd0603/chips/Copy of chips.prt
Parts/parts/capacitors/csmd0603/chips/chips.prt
Parts/parts/capacitors/csmd0805/chips/Copy of chips.prt
Parts/parts/capacitors/csmd0805/chips/chips.prt
Parts/parts/capacitors/csmd1206/chips/chips.prt
Parts/parts/capacitors/eleccap/chips/chips.prt
Parts/parts/capacitors/hv_cer_cap/chips/chips.prt
Parts/parts/capacitors/tant0805/chips/Copy of chips.prt
Parts/parts/capacitors/tant0805/chips/chips.prt
Parts/parts/diodes/1n4000_l/chips/chips.prt
Parts/parts/diodes/1n4448/chips/chips.prt
Parts/parts/diodes/1n5822/chips/chips.prt
Parts/parts/diodes/1n5824/chips/chips.prt
Parts/parts/diodes/bas16lt1/chips/chips.prt
Parts/parts/diodes/mur105/chips/chips.prt
Parts/parts/diodes/z4ke/chips/chips.prt
Parts/parts/ecl/100e101/chips/chips.prt
Parts/parts/ecl/100el05/chips/chips.prt
Parts/parts/ecl/100el34/chips/chips.prt
Parts/parts/ecl/10104/chips/chips.prt
Parts/parts/ecl/10e016/chips/chips.prt
Parts/parts/ecl/10e101/chips/chips.prt
Parts/parts/ecl/10e104/chips/chips.prt
Parts/parts/ecl/10e116/chips/chips.prt
Parts/parts/ecl/10e131/chips/chips.prt
Parts/parts/ecl/10elt24/chips/chips.prt
Parts/parts/ecl/10ep142/chips/chips.prt
Parts/parts/ecl/10ep90/chips/chips.prt
Parts/parts/ecl/10h103/chips/chips.prt
Parts/parts/ecl/10h116/chips/chips.prt
Parts/parts/ecl/10h124/chips/chips.prt
Parts/parts/ecl/10h125/chips/chips.prt
Parts/parts/ecl/10h131/chips/chips.prt
Parts/parts/ecl/el91l/chips/chips.prt
Parts/parts/ecl/mc10198/chips/chips.prt
Parts/parts/ecl/mc10e016/chips/chips.prt
Parts/parts/ecl/mc10e101/chips/chips.prt
Parts/parts/ecl/mc10e116/chips/chips.prt
Parts/parts/ecl/mc10h104/chips/chips.prt
Parts/parts/ecl/mc10h116/chips/chips.prt
Parts/parts/ecl/mc10h124/chips/chips.prt
Parts/parts/ecl/mc10h125/chips/chips.prt
Parts/parts/ecl/mc10h131/chips/chips.prt
Parts/parts/ecl/sy100el91l/chips/chips.prt
Parts/parts/misc/200#2d1#2dc#2d53d/chips/chips.prt
Parts/parts/misc/74f164/chips/chips.prt
Parts/parts/misc/74f245/chips/chips.prt
Parts/parts/misc/8061/chips/chips.prt
Parts/parts/misc/ad7243/chips/chips.prt
Parts/parts/misc/ad7249/chips/chips.prt
Parts/parts/misc/ad8009/chips/chips.prt
Parts/parts/misc/ad96685/chips/chips.prt
Parts/parts/misc/ad96687/chips/chips.prt
Parts/parts/misc/adcmp566/chips/chips.prt
Parts/parts/misc/adg1208/chips/chips.prt
Parts/parts/misc/as12av/chips/chips.prt
Parts/parts/misc/conn12/chips/chips.prt
Parts/parts/misc/conn14/chips/chips.prt
Parts/parts/misc/conn16/chips/chips.prt
Parts/parts/misc/conn20/chips/chips.prt
Parts/parts/misc/conn30/chips/chips.prt
Parts/parts/misc/conn32/chips/chips.prt
Parts/parts/misc/conn34/chips/chips.prt
Parts/parts/misc/coto2342/chips/chips.prt
Parts/parts/misc/dipswitch/chips/chips.prt
Parts/parts/misc/dr610f1_button/chips/chips.prt
Parts/parts/misc/ds90lv019/chips/chips.prt
Parts/parts/misc/ds90lv027/chips/chips.prt
Parts/parts/misc/ep12sd1sape/chips/chips.prt
Parts/parts/misc/euroconn/chips/chips.prt
Parts/parts/misc/fci_61083#2d101400lf/chips/chips.prt
Parts/parts/misc/foxclock/chips/chips.prt
Parts/parts/misc/g3vm#2d352j/chips/chips.prt
Parts/parts/misc/hc574f/chips/chips.prt
Parts/parts/misc/hct123/chips/chips.prt
Parts/parts/misc/ids_c10/chips/chips.prt
Parts/parts/misc/ids_c34/chips/chips.prt
Parts/parts/misc/inductor_1206/chips/chips.prt
Parts/parts/misc/inductor_l/chips/chips.prt
Parts/parts/misc/led_1206/chips/chips.prt
Parts/parts/misc/led_l/chips/chips.prt
Parts/parts/misc/led_small/chips/chips.prt
Parts/parts/misc/lm7171/chips/chips.prt
Parts/parts/misc/lt1055/chips/chips.prt
Parts/parts/misc/lvds_driver_ds10/chips/chips.prt
Parts/parts/misc/max9374/chips/chips.prt
Parts/parts/misc/max9375/chips/chips.prt
Parts/parts/misc/max9376/chips/chips.prt
Parts/parts/misc/mc7805k_l/chips/chips.prt
Parts/parts/misc/opa2277/chips/chips.prt
Parts/parts/misc/opa277/chips/chips.prt
Parts/parts/misc/opa4277/chips/chips.prt
Parts/parts/misc/ostoq027150/chips/chips.prt
Parts/parts/misc/ostoq047150/chips/chips.prt
Parts/parts/misc/pickering113fc/chips/chips.prt
Parts/parts/misc/prma1c05b/chips/chips.prt
Parts/parts/misc/ref02/chips/chips.prt
Parts/parts/misc/sip_header_16pin/chips/chips.prt
Parts/parts/misc/sip_header_2pin/chips/chips.prt
Parts/parts/misc/smbconn/chips/chips.prt
Parts/parts/misc/srr6038/chips/chips.prt
Parts/parts/misc/ss12sdp2/chips/chips.prt
Parts/parts/misc/ss22sdp2/chips/chips.prt
Parts/parts/misc/sy100el34l/chips/chips.prt
Parts/parts/misc/testpoint_l/chips/chips.prt
Parts/parts/misc/ths3001/chips/chips.prt
Parts/parts/misc/ths3061/chips/chips.prt
Parts/parts/misc/ths3062/chips/chips.prt
Parts/parts/misc/tlc274/chips/chips.prt
Parts/parts/misc/tlc274_new/chips/chips.prt
Parts/parts/misc/xc2c256/chips/chips.prt
Parts/parts/misc/xc2c512/chips/chips.prt
Parts/parts/misc/xc2c64a/chips/chips.prt
Parts/parts/regulators/7806_l/chips/chips.prt
Parts/parts/regulators/7815_l/chips/chips.prt
Parts/parts/regulators/7815s_l/chips/chips.prt
Parts/parts/regulators/7906_l/chips/chips.prt
Parts/parts/regulators/7915_l/chips/chips.prt
Parts/parts/regulators/7915s_l/chips/chips.prt
Parts/parts/regulators/lm1117/chips/chips.prt
Parts/parts/regulators/lm2595/chips/chips.prt
Parts/parts/regulators/lm2596/chips/chips.prt
Parts/parts/regulators/lm309h_l/chips/chips.prt
Parts/parts/regulators/lm337s_l/chips/chips.prt
Parts/parts/regulators/lm337t_l/chips/chips.prt
Parts/parts/regulators/lt1085ct/chips/chips.prt
Parts/parts/regulators/max17501/chips/chips.prt
Parts/parts/resistors/3006p_trimpot/chips/chips.prt
Parts/parts/resistors/pot/chips/chips.prt
Parts/parts/resistors/res_l/chips/chips.prt
Parts/parts/resistors/rsmd0603/chips/Copy of chips.prt
Parts/parts/resistors/rsmd0603/chips/chips.prt
Parts/parts/resistors/rsmd0805/chips/Copy of chips.prt
Parts/parts/resistors/rsmd0805/chips/chips.prt
Parts/parts/resistors/rsmd0805_1pct/chips/chips.prt
Parts/parts/resistors/rsmd0805size/chips/chips.prt
Parts/parts/standard/conn_gen/chips/chips.prt
Parts/parts/standard/flag/chips/chips.prt
Parts/parts/transistors/bss138/chips/chips.prt
Parts/parts/transistors/mmbth10/chips/chips.prt
Parts/parts/transistors/mmbth81/chips/chips.prt
Parts/parts/transistors/mmbth81lt1/chips/chips.prt
Parts/parts/transistors/mpsh81/chips/chips.prt
Parts/parts/transistors/mrf5943/chips/chips.prt
Parts/parts/ttl/74f06/chips/chips.prt
Parts/parts/ttl/74f07/chips/chips.prt
Parts/parts/ttl/74f14/chips/chips.prt
Parts/parts/ttl/74fhct597/chips/chips.prt
Parts/parts/ttl/74hct04/chips/chips.prt
Parts/parts/ttl/74hct164/chips/chips.prt
Parts/parts/ttl/74hct165/chips/chips.prt
Parts/parts/ttl/74hct273/chips/chips.prt
Parts/parts/ttl/74lv06a/chips/chips.prt
Parts/parts/ttl/74lv07a/chips/chips.prt
Parts/parts/ttl/74lvc07a/chips/chips.prt
Parts/parts/ttl/ds1023200/chips/chips.prt
Parts/parts/ttl/ds102350/chips/chips.prt
Parts/parts/ttl/ds1023500/chips/chips.prt
Parts/parts/ttl/ds102350bkup/chips/chips.prt
Parts/parts/ttl/f06/chips/chips.prt
Parts/parts/ttl/f07/chips/chips.prt
Parts/parts/ttl/f08/chips/chips.prt
Parts/parts/ttl/f269/chips/chips.prt
Parts/parts/ttl/f273/chips/chips.prt
Parts/parts/ttl/f74/chips/chips.prt
Parts/parts/ttl/hct04/chips/chips.prt
Parts/parts/ttl/hct238/chips/chips.prt
Parts/parts/ttl/hct273/chips/chips.prt
Parts/parts/ttl/hct374/chips/chips.prt
Parts/parts/ttl/sn74lvc2t45/chips/chips.prt
Parts/parts/ttl/sn74s32/chips/chips.prt
Parts/parts/ttl/sy100el05/chips/chips.prt
Parts/phys_parts/0603rf_wv_12d.psm
Parts/phys_parts/3006_trimpot.psm
Parts/phys_parts/74hc1g125.psm
Parts/phys_parts/74hc1g125_1.psm
Parts/phys_parts/at_35ux.psm
Parts/phys_parts/bga256.psm
Parts/phys_parts/bpcap.psm
Parts/phys_parts/c0805.psm
Parts/phys_parts/cap0402.psm
Parts/phys_parts/cap0603.psm
Parts/phys_parts/cap0805.psm
Parts/phys_parts/cap1000.psm
Parts/phys_parts/cap1206.psm
Parts/phys_parts/cap1210.psm
Parts/phys_parts/cap1500.psm
Parts/phys_parts/cap1812.psm
Parts/phys_parts/cap196.psm
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
