marzece/Tubii_Tk2/Documentation/TUBii_MicroZed_PinGuide.xlsx

Sheet: JX1
NOTES | SoC Pin # | MicroZed Net | JX1 PIN # | JX1 PIN # | MicroZed Net | SoC Pin # | NOTES
 | Bank 0, F9 | JTAG_TCK | 1 | 2 | JTAG_TMS | Bank 0, J6
 | Bank 0, F6 | JTAG_TDO | 3 | 4 | JTAG_TDI | Bank 0, G6
 | N/A | PWR_ENABLE | 5 | 6 | CARRIER_SRST# | N/A
 | N/A | FPGA_VBATT | 7 | 8 | FPGA_DONE | Bank 0, R11
 | Bank 34, R19 | JX1_SE_0 | 9 | 10 | JX1_SE_1 | Bank 34, T19
 | Bank 34, T11 | BURST_IN<0> | 11 | 12 | BURST_OUT<0> | Bank 34, T12
 | Bank 34, T10 | BURST_IN<1> | 13 | 14 | BURST_OUT<1> | Bank 34, U12
 | N/A | GND | 15 | 16 | GND | N/A
 | Bank 34, U13 | BURST_IN<2> | 17 | 18 | BURST_OUT<2> | Bank 34, V12
 | Bank 34, V13 | BURST_IN<3> | 19 | 20 | BURST_OUT<3> | Bank 34, W13
 | N/A | GND | 21 | 22 | GND | N/A
 | Bank 34, T14 | COMBO_IN<0> | 23 | 24 | COMBO_OUT | Bank 34, P14
 | Bank 34, T15 | COMBO_IN<1> | 25 | 26 | TUBII_GT_OUT | Bank 34, R14
 | N/A | GND | 27 | 28 | GND | N/A
 | Bank 34, Y16 | COMBO_IN<2> | 29 | 30 | JX1_LVDS_7_P | Bank 34, W14
 | Bank 34, Y17 | COMBO_IN<3> | 31 | 32 | JX1_LVDS_7_N | Bank 34, Y14
 | N/A | GND | 33 | 34 | GND | N/A
 | Bank 34, T16 | JX1_LVDS_8_P | 35 | 36 | JX1_LVDS_9_P | Bank 34, V15
 | Bank 34, U17 | JX1_LVDS_8_N | 37 | 38 | JX1_LVDS_9_N | Bank 34, W15
 | N/A | GND | 39 | 40 | GND | N/A
 | Bank 34, U14 | JX1_LVDS_10_P | 41 | 42 | JX1_LVDS_11_P | Bank 34, U18
 | Bank 34, U15 | JX1_LVDS_10_N | 43 | 44 | JX1_LVDS_11_N | Bank 34, U19
 | N/A | GND | 45 | 46 | GND | N/A
 | Bank 34, N18 | JX1_LVDS_12_P | 47 | 48 | JX1_LVDS_13_P | Bank 34, N20
 | Bank 34, P19 | JX1_LVDS_12_N | 49 | 50 | JX1_LVDS_13_N | Bank 34, P20
 | N/A | GND | 51 | 52 | GND | N/A
 | Bank 34, T20 | JX1_LVDS_14_P | 53 | 54 | JX1_LVDS_15_P | Bank 34, V20
 | Bank 34, U20 | JX1_LVDS_14_N | 55 | 56 | JX1_LVDS_15_N | Bank 34, W20
 | N/A | VIN_HDR | 57 | 58 | VIN_HDR | N/A
 | N/A | VIN_HDR | 59 | 60 | VIN_HDR | N/A
 | Bank 34, Y18 | JX1_LVDS_16_P | 61 | 62 | JX1_LVDS_17_P | Bank 34, V16
 | Bank 34, Y19 | JX1_LVDS_16_N | 63 | 64 | JX1_LVDS_17_N | Bank 34, W16
 | N/A | GND | 65 | 66 | GND | N/A
 | Bank 34, R16 | JX1_LVDS_18_P | 67 | 68 | JX1_LVDS_19_P | Bank 34, T17
 | Bank 34,R17 | JX1_LVDS_18_N | 69 | 70 | JX1_LVDS_19_N | Bank 34, R18
 | N/A | GND | 71 | 72 | GND | N/A
 | Bank 34, V17 | JX1_LVDS_20_P | 73 | 74 | JX1_LVDS_21_P | Bank 34, W18
 | Bank 34, V18 | JX1_LVDS_20_N | 75 | 76 | JX1_LVDS_21_N | Bank 34, W19
 | N/A | GND | 77 | 78 | VCCO_34 | N/A
 | N/A | VCCO_34 | 79 | 80 | VCCO_34 | N/A
 | Bank 34, N17 | JX1_LVDS_22_P | 81 | 82 | JX1_LVDS_23_P | Bank 34, P15
 | Bank 34, P18 | JX1_LVDS_22_N | 83 | 84 | JX1_LVDS_23_N | Bank 34, P16
 | N/A | GND | 85 | 86 | GND | N/A
 | Bank 13, U7 | BANK13_LVDS_0_P | 87 | 88 | BANK13_LVDS_1_P | Bank 13, T9
 | Bank 13, V7 | BANK13_LVDS_0_N | 89 | 90 | BANK13_LVDS_1_N | Bank 13, U10
 | Bank 13, V8 | BANK13_LVDS_2_P | 91 | 92 | BANK13_LVDS_3_P | Bank 13, T5
 | Bank 13, W8 | BANK13_LVDS_2_N | 93 | 94 | BANK13_LVDS_3_N | Bank 13, U5
 | N/A | GND | 95 | 96 | GND | N/A
 | Bank 0, L10 | VP_0_P | 97 | 98 | DXP_0_P | Bank 0, M9
 | Bank 0, K9 | VN_0_N | 99 | 100 | DXN_0_N | Bank 0, M10

Sheet: JX2 - Table 1-1
Notes | SoC Pin # | MicroZed Net | JX2 PIN # | JX2 PIN# | MicroZed Net | SoC Pin # | Notes
 | Bank 500, E8 | PMOD_D0 | 1 | 2 | PMOD_D1 | Bank 500, E9
 | Bank 500, C6 | PMOD_D2 | 3 | 4 | PMOD_D3 | Bank 500, D9
 | Bank 500, E6 | PMOD_D4 | 5 | 6 | PMOD_D5 | Bank 500, B5
 | Bank 500, C5 | PMOD_D6 | 7 | 8 | PMOD_D7 | Bank 500, C8
 | Bank 0, R10 | INIT# | 9 | 10 | VCCIO_EN | N/A
 | Bank 500, C7 | PG_MODULE | 11 | 12 | VIN_HDR | N/A
 | Bank 35, G14 | JX2_SE_0 | 13 | 14 | JX2_SE_1 | Bank 35, J15
 | N/A | GND | 15 | 16 | GND | N/A
Also used as ELLIE Pulser | Bank 35, C20 | Sync_Pulse_Out | 17 | 18 | TUB_CLK_IN | Bank 35, B19
 | Bank 35, B20 | ASync_Pulse_Out | 19 | 20 | TUBii_CLK_IN | Bank 35, A20
 | N/A | GND | 21 | 22 | GND | N/A
 | Bank 35, E17 | SemiSync_Pulse_Out | 23 | 24 | EXT_CLK_IN | Bank 35, D19
 | Bank 35, D18 | ECAL_Setup | 25 | 26 | MASTER_CLK_OUT | Bank 35, D20
 | N/A | GND | 27 | 28 | GND | N/A
 | Bank 35, E18 | DGT_In | 29 | 30 | CLK_INDICATOR_OUT<0> | Bank 35, F16
 | Bank 35, E19 | DGT_Out | 31 | 32 | CLK_INDICATOR_OUT<1> | Bank 35, F17
 | N/A | GND | 33 | 34 | GND | N/A
 | Bank 35, L19 | DDGT_In | 35 | 36 | PRESCALE_IN<0> | Bank 35, M19
 | Bank 35, L20 | DDGT_Out | 37 | 38 | PRESCALE_IN<1> | Bank 35, M20
 | N/A | GND | 39 | 40 | GND | N/A
Also used as ELLIE Delay In | Bank 35, M17 | Sync_Delay_In | 41 | 42 | PRESCALE_IN<2> | Bank 35, K19
Also used as ELLIE Delay Out | Bank 35, M18 | Sync_Delay_Out | 43 | 44 | PRESCALE_IN<3> | Bank 35, J19
 | N/A | GND | 45 | 46 | GND | N/A
 | Bank 35, L16 | ASync_Delay_In | 47 | 48 | PRESCALE_OUT<0> | Bank 35, K17
 | Bank 35, L17 | ASync_Delay_Out | 49 | 50 | PRESCALE_OUT<1> | Bank 35, K18
 | N/A | GND | 51 | 52 | GND | N/A
 | Bank 35, H16 | SemiSync_Delay_In | 53 | 54 | PRESCALE_OUT<2> | Bank 35, J18
 | Bank 35, H17 | SemiSync_Delay_Out | 55 | 56 | PRESCALE_OUT<3> | Bank 35, H18
 | N/A | VIN_HDR | 57 | 58 | VIN_HDR | N/A
 | N/A | VIN_HDR | 59 | 60 | VIN_HDR | N/A
 | Bank 35, G17 | EXTTRIG_IN<0> | 61 | 62 | EXTTRIG_IN<8> | Bank 35, F19 | Asyc External Fan In
 | Bank 35, G18 | EXTTRIG_IN<1> | 63 | 64 | EXTTRIG_IN<9> | Bank 35, F20 | Asyc External Fan In
 | N/A | GND | 65 | 66 | GND | N/A
 | Bank 35, G19 | EXTTRIG_IN<2> | 67 | 68 | EXTTRIG_IN<10> | Bank 35, J20 | Asyc External Fan In
 | Bank 35, G20 | EXTTRIG_IN<3> | 69 | 70 | EXTTRIG_IN<11> | Bank 35, H20 | Asyc External Fan In
 | N/A | GND | 71 | 72 | GND | N/A
 | Bank 35, K14 | EXTTRIG_IN<4> | 73 | 74 | EXTTRIG_IN<12> | Bank 35, H15 | Asyc External Fan In
 | Bank 35, J14 | EXTTRIG_IN<5> | 75 | 76 | EXTTRIG_IN<13> | Bank 35, G15 | Asyc External Fan In
 | N/A | GND | 77 | 78 | VCCO_35 | N/A
 | N/A | VCCO_35 | 79 | 80 | VCCO_35 | N/A
 | Bank 35, N15 | EXTTRIG_IN<6> | 81 | 82 | EXTTRIG_IN<14> | Bank 35,L14 | Asyc External Fan In
 | Bank 35, N16 | EXTTRIG_IN<7> | 83 | 84 | EXTTRIG_IN<15> | Bank 35,L15 | Asyc External Fan In
 | N/A | GND | 85 | 86 | GND | N/A
 | Bank 35, M14 | EXTTRIG_RAW_OUT | 87 | 88 | EXT_RAW_ASync_Out | Bank 35, K16
 | Bank 35, M15 | EXTTRIG_LATCHED_OUT | 89 | 90 | EXT_LATCHED_ASync_Out | Bank 35, J16
 | N/A | GND | 91 | 92 | GND | N/A
 | Bank 13, Y12 | BANK13_LVDS_4_P | 93 | 94 | BANK13_LVDS_5_P | Bank 13, V11
 | Bank 13, Y13 | BANK13_LVDS_4_N | 95 | 96 | BANK13_LVDS_5_N | Bank 13, V10
 | Bank 13, V6 | BANK13_LVDS_6_P | 97 | 98 | VCCO_13 | N/A
 | Bank 13, W6 | BANK13_LVDS_6_N | 99 | 100 | BANK13_SE_0 | Bank 13, V5
 | ** Pmod_JZ has only 7 connections thus cannot connect to QSPI or SD interfaces.
