marzece/Tubii_Tk2/Parts/parts/regulators/max17501/metadata/pdv_validation.txt

SPLBPD-140,Symbol 'sym_1':The symbol cannot be saved because pin(s) 3,11,9,8,7,5,10,2,1,6,4 is (are) not on the standard grid. To make sure that all pins are on the standard grid, first select all the pins in the Symbol Pins pane and then click the up and down arrow buttons in the Move Pins area to move the pins up by 1 grid unit and then down by 1 grid unit.,Error
