marzece/Tubii_Tk2/Parts/parts/regulators/7815s_l/metadata/pdv_validation.txt

SPLBPD-170,Cell '7815s_l':Pin(s) NC is (are) not present in any package or symbol. You can choose Pins - Add from the Package Pin page and delete these pins. If the HAS_FIXED_SIZE value has been reduced, reload the part.,Warning
