marzece/Tubii_Tk2/Documentation/tubii.pdf

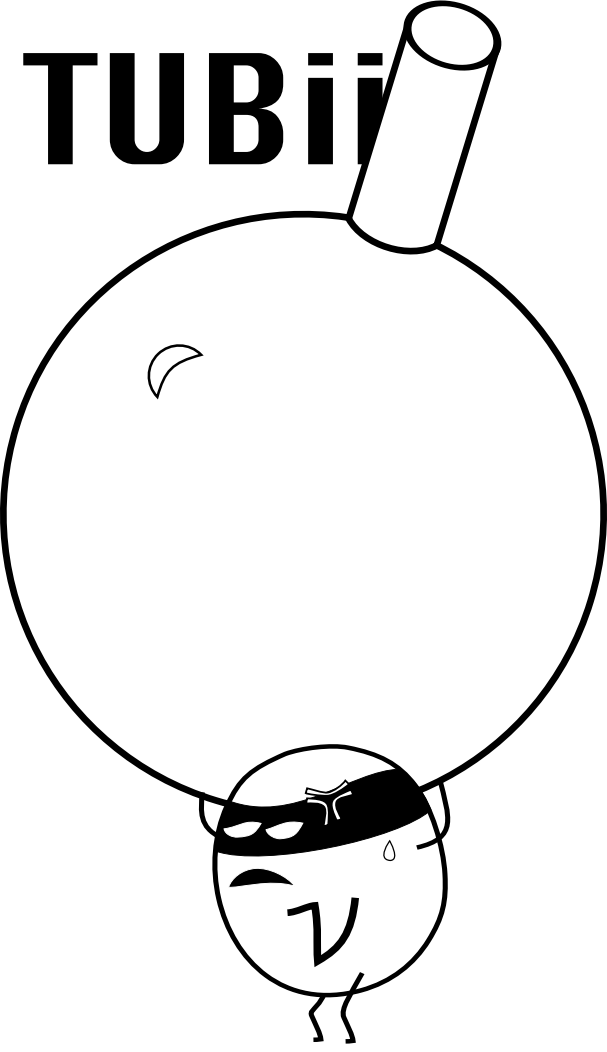
[picture p4: page 1]
TUBii
