marzece/Tubii_Tk2/Documentation/Tubii_TK2_Schem_Final.pdf

# 4. CONTROL REGISTER

# 3. MICROZED CONNECTION

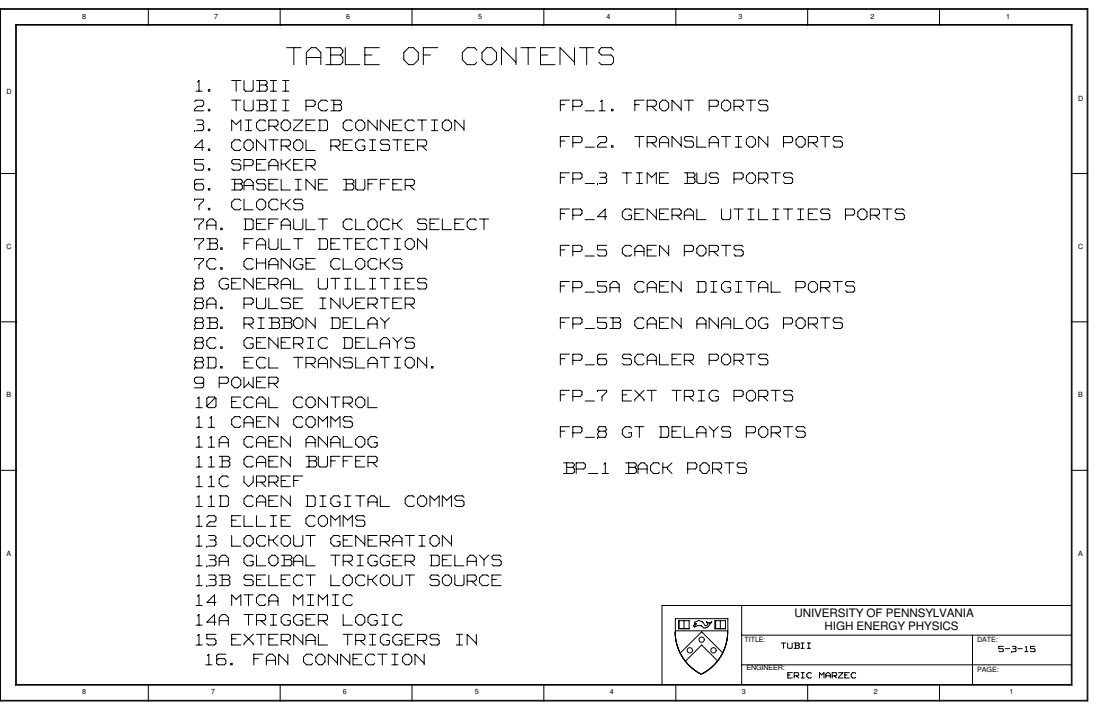
[picture p5: page 1]
1. TUBII; FP_6 SCALER PORTS; FP_2. TRANSLATION PORTS; FP_5 CAEN PORTS; FP_1. FRONT PORTS; 2. TUBII PCB; 10 ECAL CONTROL; FP_7 EXT TRIG PORTS; BP_1 BACK PORTS

TABLE OF CONTENTS

5. SPEAKER
6. BASELINE BUFFER
7. CLOCKS
7A. DEFAULT CLOCK SELECT
7B. FAULT DETECTION
7C. CHANGE CLOCKS
8 GENERAL UTILITIES
8A. PULSE INVERTER
8B. RIBBON DELAY
8C. GENERIC DELAYS
8D. ECL TRANSLATION.
9 POWER
11 CAEN COMMS
11A CAEN ANALOG
11B CAEN BUFFER
11C VRREF
11D CAEN DIGITAL COMMS
12 ELLIE COMMS
13 LOCKOUT GENERATION
13A GLOBAL TRIGGER DELAYS
13B SELECT LOCKOUT SOURCE
14 MTCA MIMIC
14A TRIGGER LOGIC
15 EXTERNAL TRIGGERS IN
16. FAN CONNECTION

FP_3 TIME BUS PORTS

FP_4 GENERAL UTILITIES PORTS

FP_5A CAEN DIGITAL PORTS

FP_5B CAEN ANALOG PORTS

FP_8 GT DELAYS PORTS

UNIVERSITY OF PENNSYLVANIA HIGH ENERGY PHYSICS

TITLE: TUBII | DATE: 5-3-15

ENGINEER: ERIC MARZEC | PAGE:

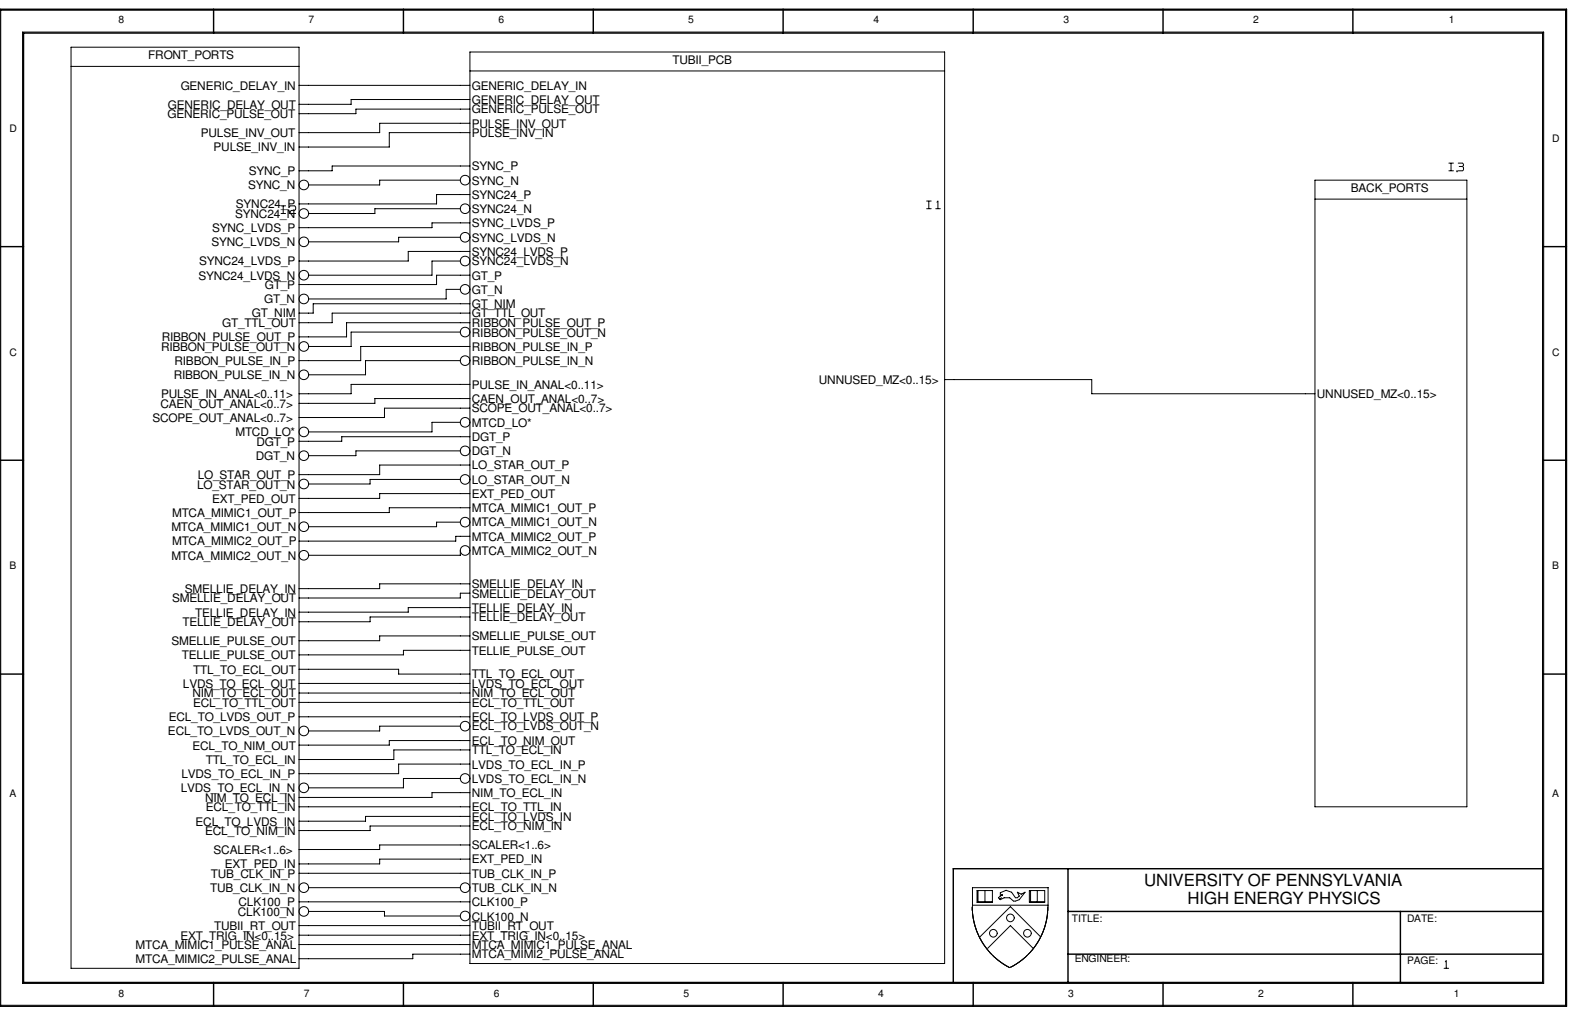
[picture p6: page 2]
BACK_PORTS; UNNUSED_MZ<0..15>; FRONT_PORTS; RIBBON_PULSE_OUT_P; GT_TTL_OUT; TUBII_RT_OUT EXT_TRIG_IN<0..15>; SYNC24_LVDS_N; MTCA_MIMIC1_PULSE_ANAL; TELLIE_DELAY_IN; SMELLIE_DELAY_IN; EXT_PED_IN; PULSE_IN_ANAL<0..11>; SYNC24_N SYNC24_P; SYNC_N; SYNC_P; MTCD_LO*; PULSE_INV_IN; RIBBON_PULSE_IN_N; RIBBON_PULSE_IN_P; GENERIC_DELAY_IN; SCALER<1..6>; TELLIE_PULSE_OUT; SMELLIE_PULSE_OUT; TELLIE_DELAY_OUT; SMELLIE_DELAY_OUT; CLK100_N CLK100_P; MTCA_MIMIC2_OUT_N; MTCA_MIMIC2_OUT_P; MTCA_MIMIC1_OUT_N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

UNIVERSITY OF PENNSYLVANIA HIGH ENERGY PHYSICS

TITLE: | DATE:

ENGINEER: | PAGE: 1

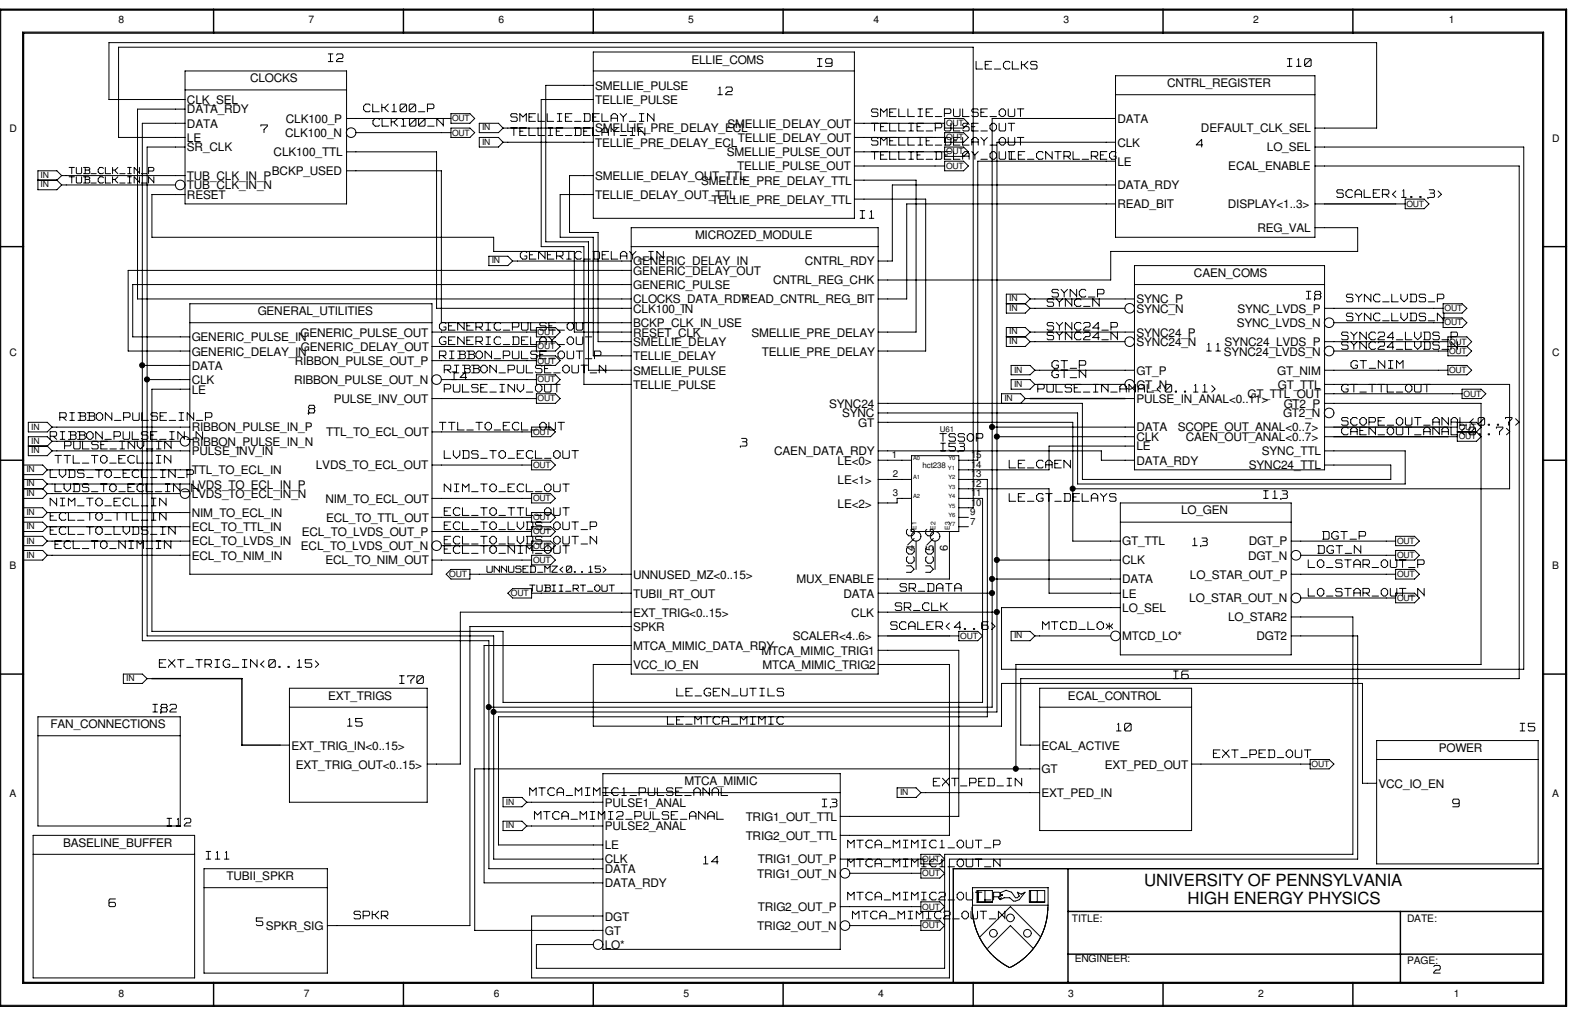
[picture p7: page 3]
TUBII_RT_OUT; SR_DATA; SR_CLK; SCALER<4..6>; UNNUSED_MZ<0..15>; MTCD_LO*; EXT_PED_OUT; LE_MTCA_MIMIC; SMELLIE_DELAY_IN TELLIE_DELAY_IN; ECL_TO_NIM_OUT ECL_TO_LVDS_OUT_N; ECL_TO_LVDS_OUT_P; ECL_TO_TTL_OUT; NIM_TO_ECL_OUT; LVDS_TO_ECL_OUT; TTL_TO_ECL_OUT; GENERIC_PULSE_OUT GENERIC_DELAY_OUT RIBBON_PULSE_OUT_P RIBBON_PULSE_OUT_N; PULSE_INV_OUT; TUB_CLK_IN_P; VCC\G; GT_TTL_OUT; SCOPE_OUT_ANAL<0..7> CAEN_OUT_ANAL<0..7>; LO_STAR_OUT_P; SYNC24_LVDS_N; SYNC_LVDS_P; MTCA_MIMIC1_PULSE_ANAL; EXT_PED_IN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

UNIVERSITY OF PENNSYLVANIA HIGH ENERGY PHYSICS

TITLE: | DATE:

ENGINEER: | PAGE: 2

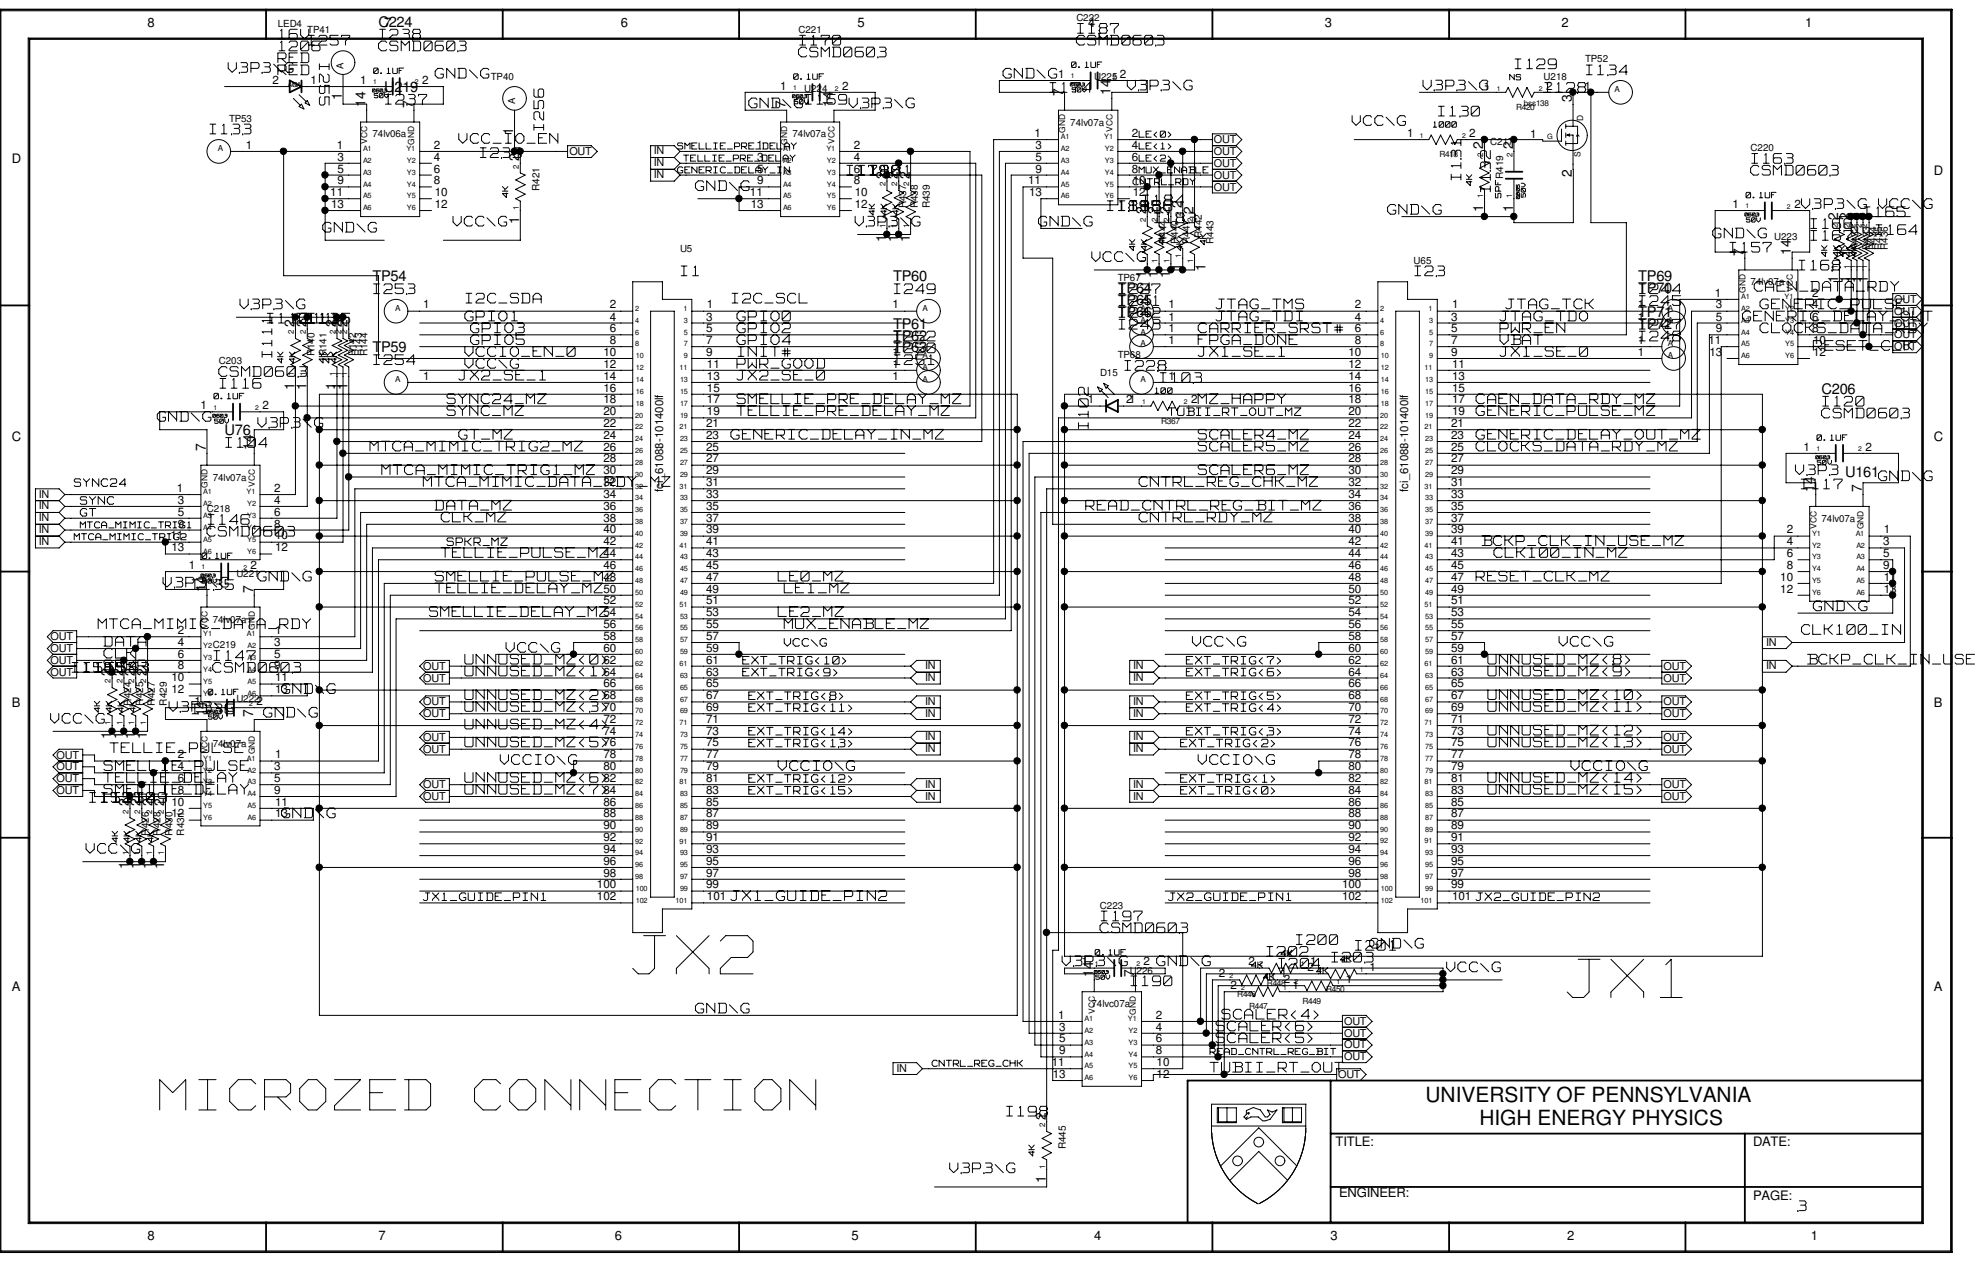
[picture p8: page 4]

# CNTRL REGISTER

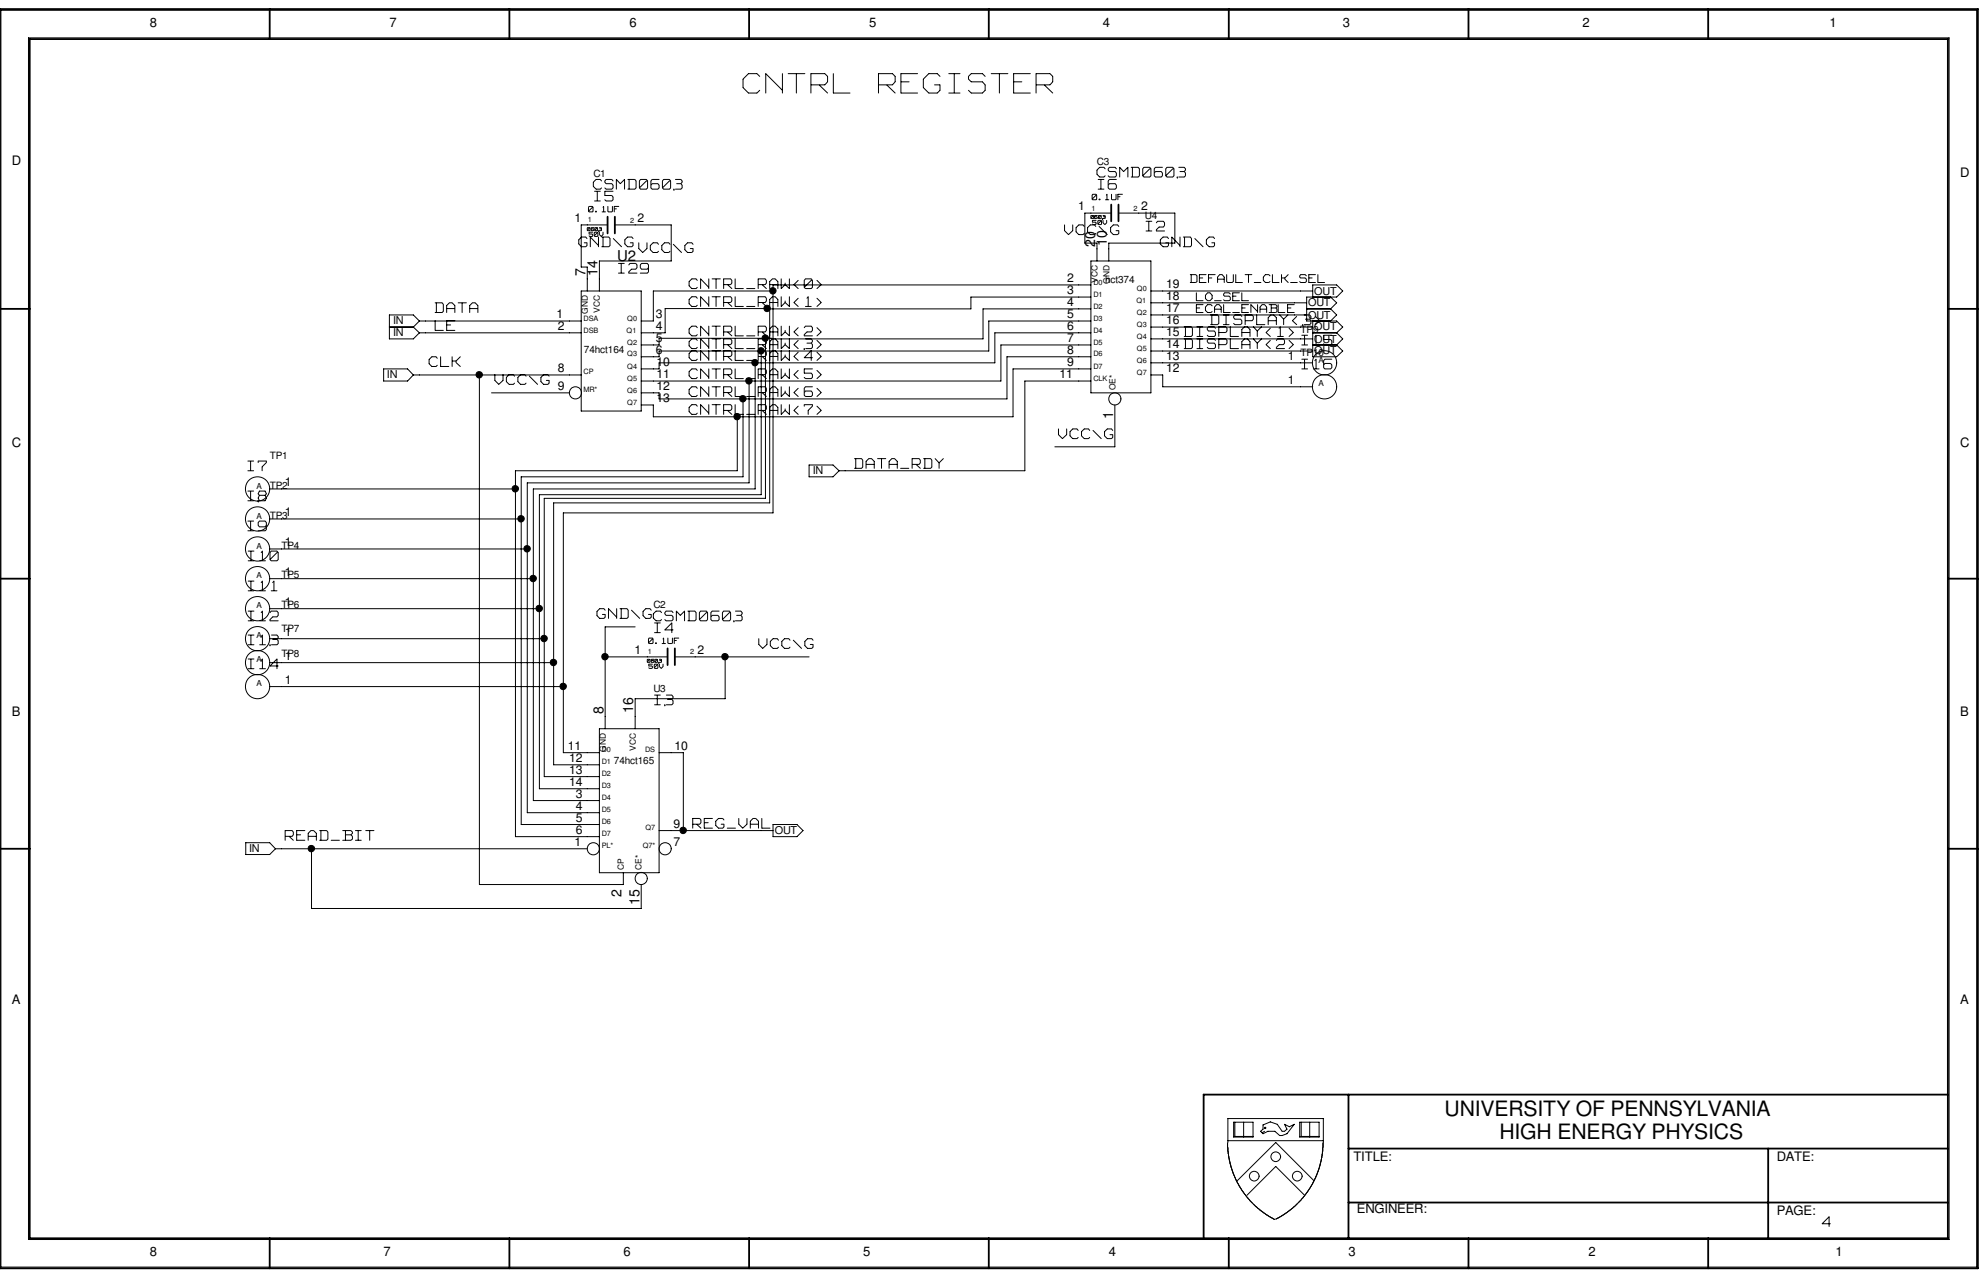
[picture p9: page 5]

UNIVERSITY OF PENNSYLVANIA HIGH ENERGY PHYSICS

TITLE: | DATE:

ENGINEER: | PAGE: 4

# SPEAKER

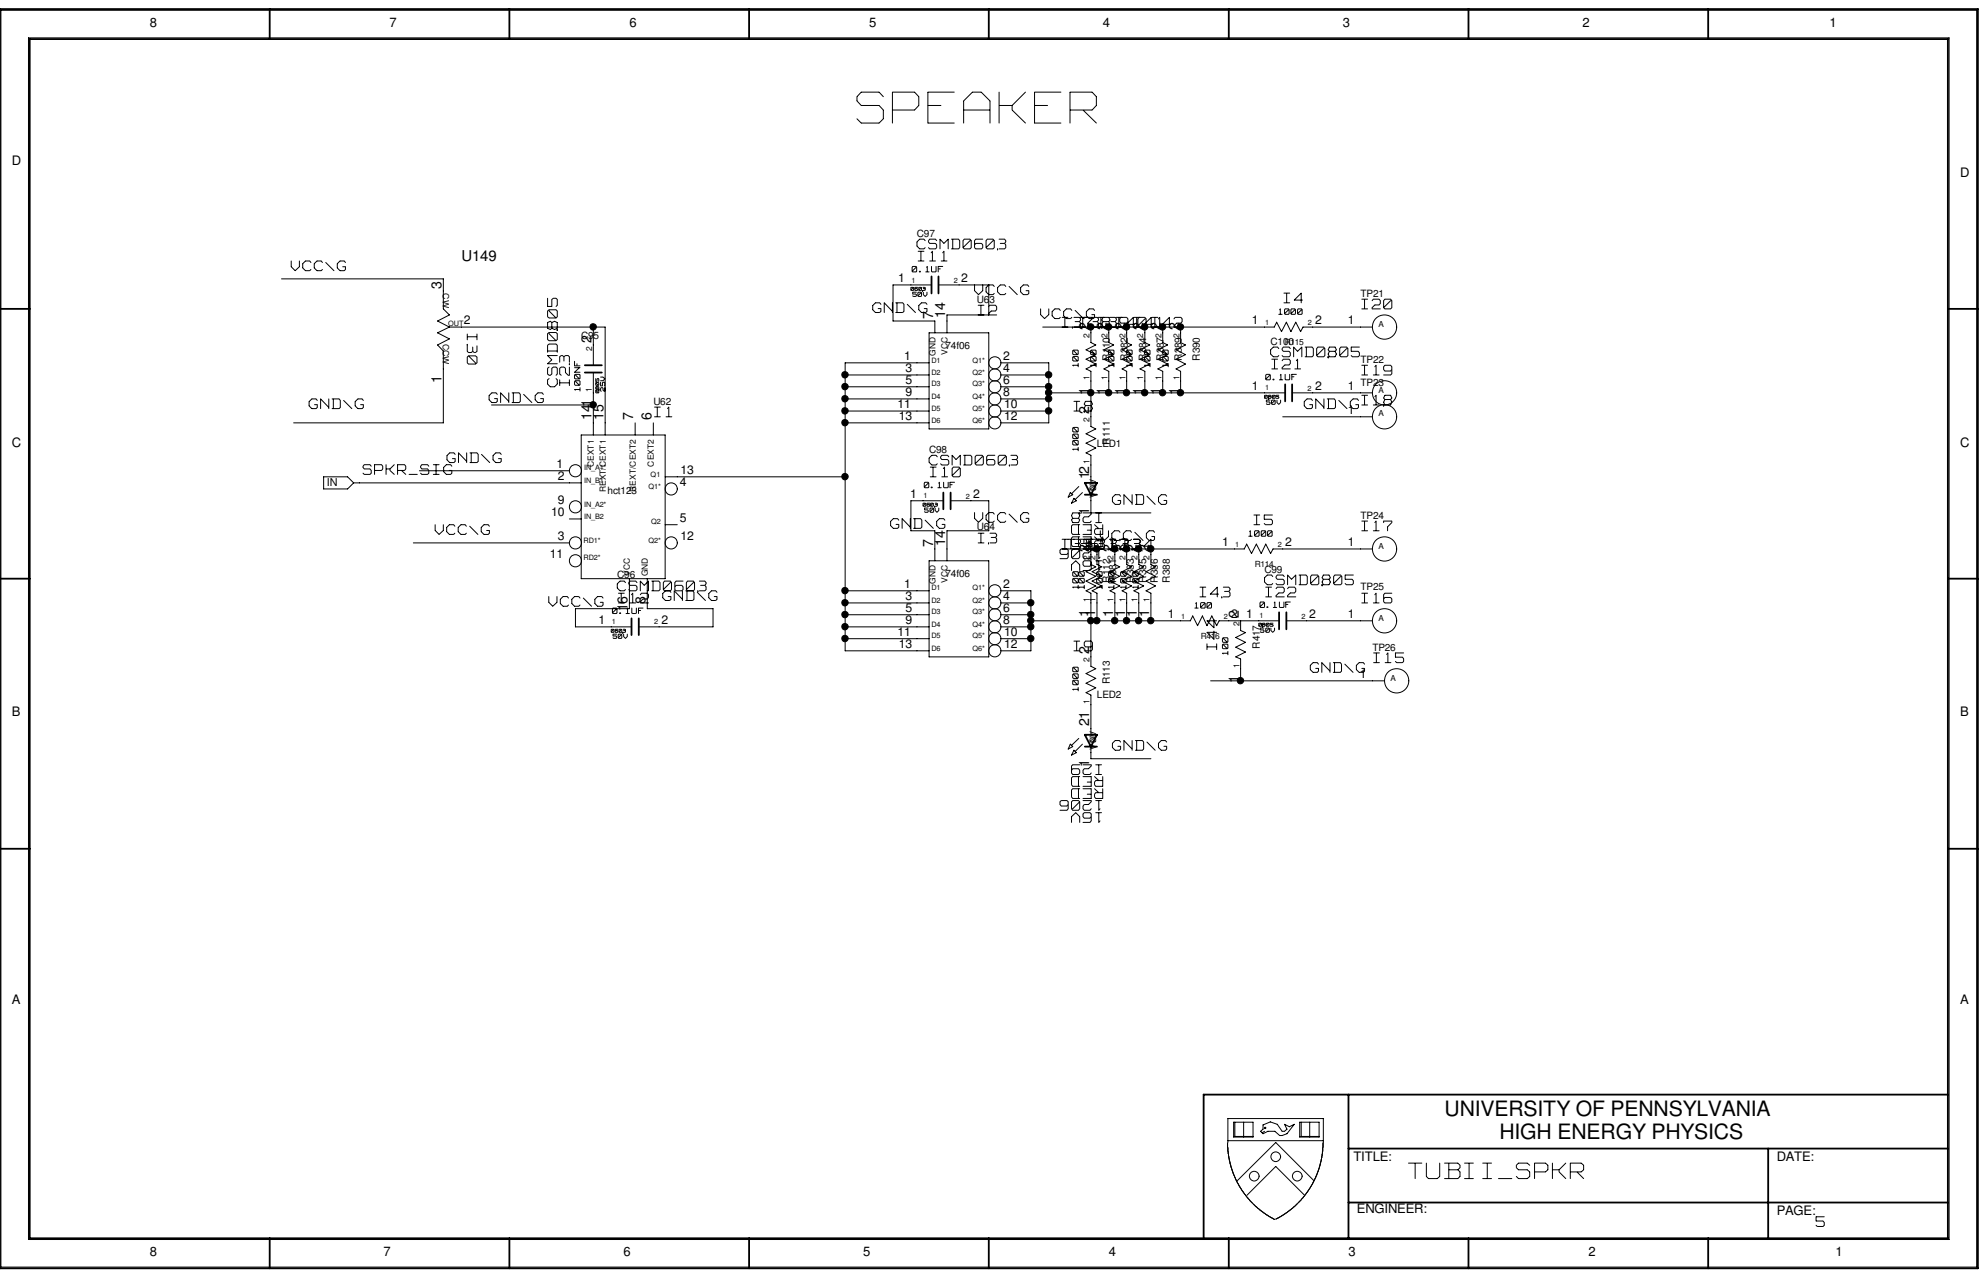
[picture p10: page 6]

# BASELINE BUFFER

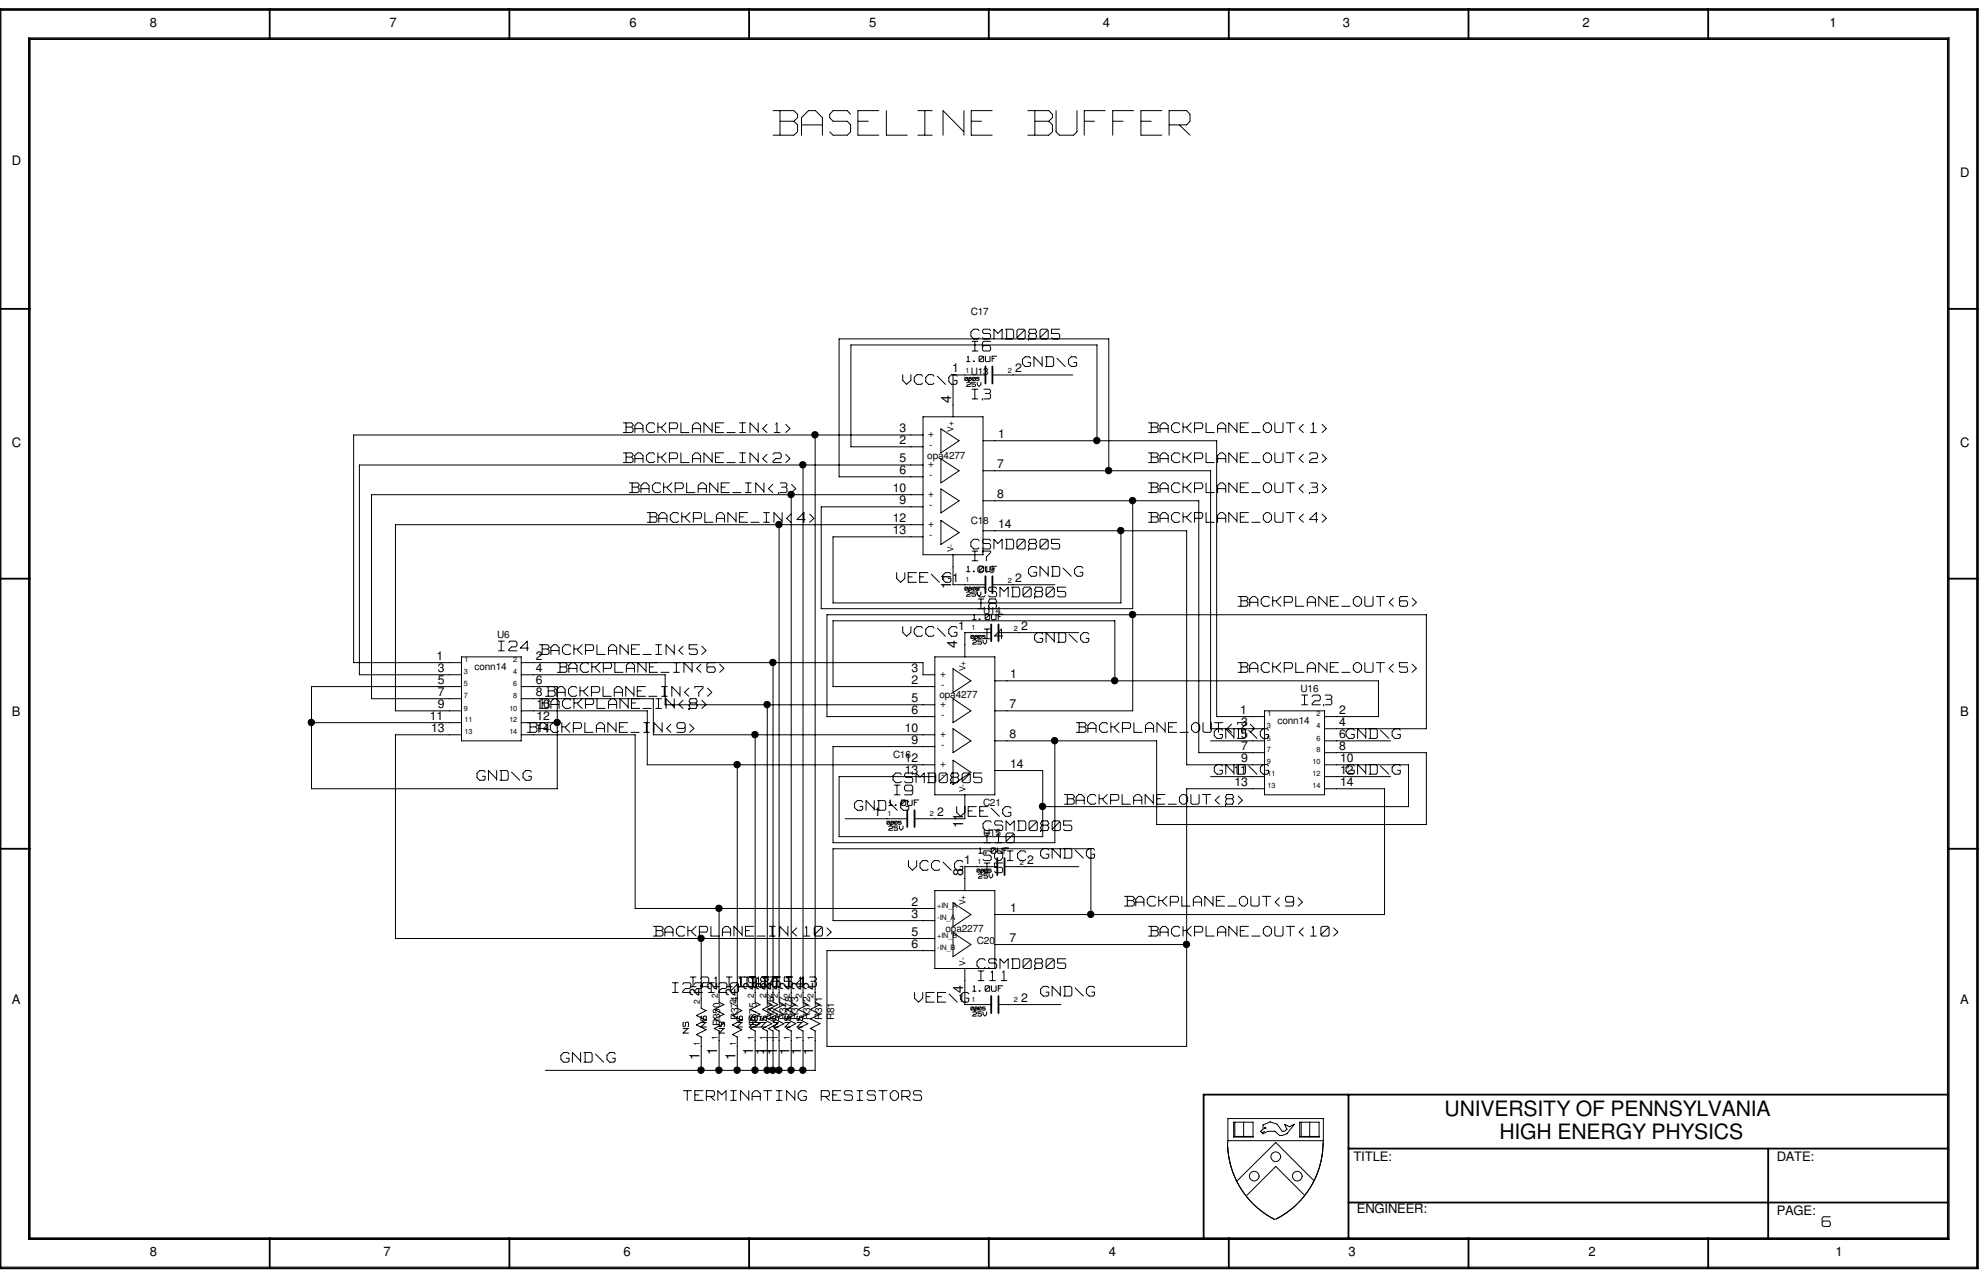
[picture p11: page 7]

UNIVERSITY OF PENNSYLVANIA HIGH ENERGY PHYSICS

TITLE: | DATE:

ENGINEER: | PAGE: 6

# CLOCKS

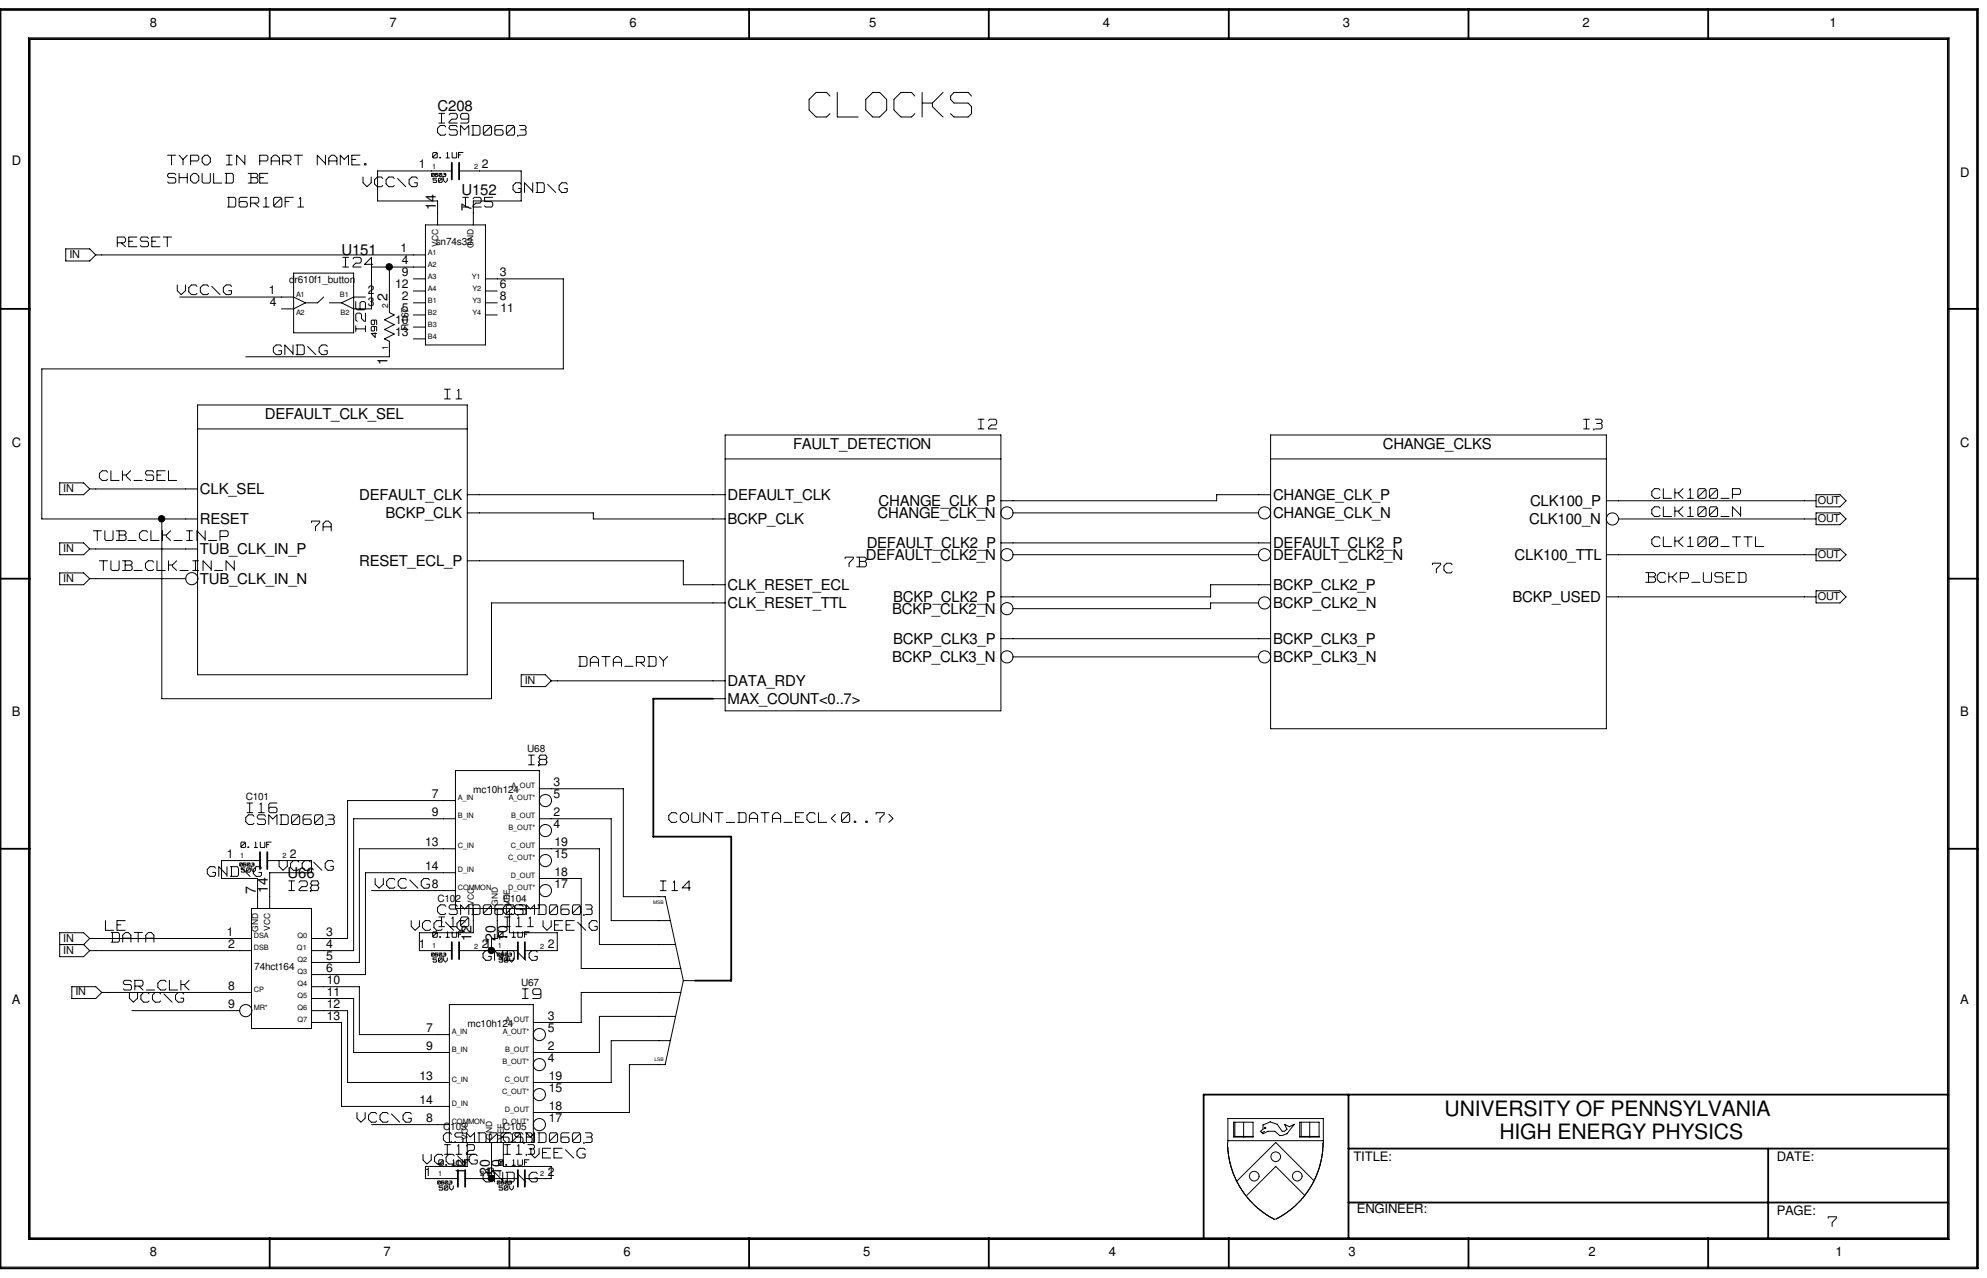
[picture p12: page 8]

TYPO IN PART NAME.
SHOULD BE

UNIVERSITY OF PENNSYLVANIA HIGH ENERGY PHYSICS

TITLE: | DATE:

ENGINEER: | PAGE: 7

# DEFAULT CLOCK SELECT

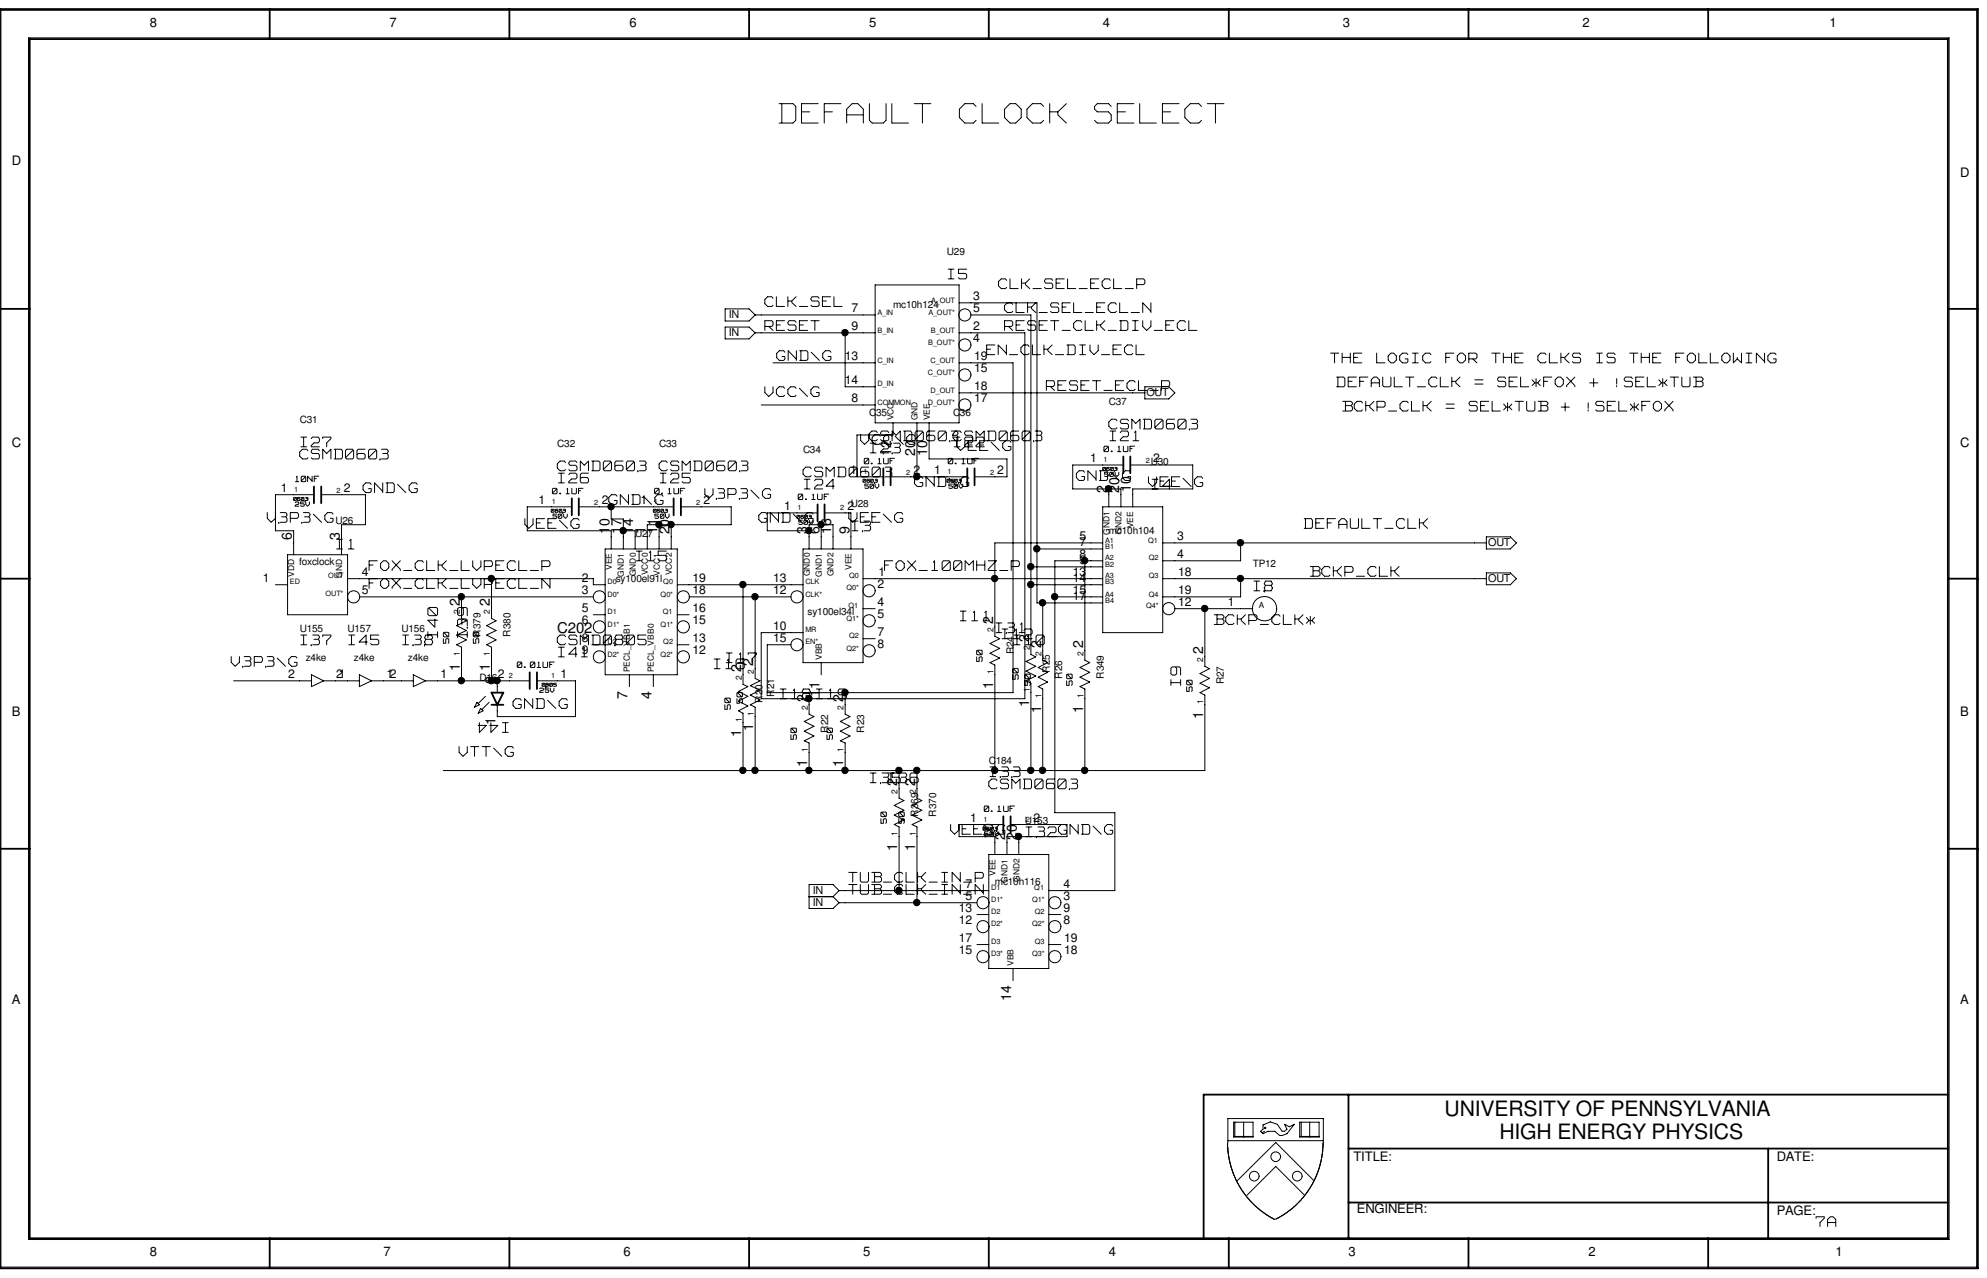
[picture p13: page 9]

THE LOGIC FOR THE CLKS IS THE FOLLOWING
DEFAULT_CLK = SEL*FOX + !SEL*TUB
BCKP_CLK = SEL*TUB + !SEL*FOX

# FAULT DETECT

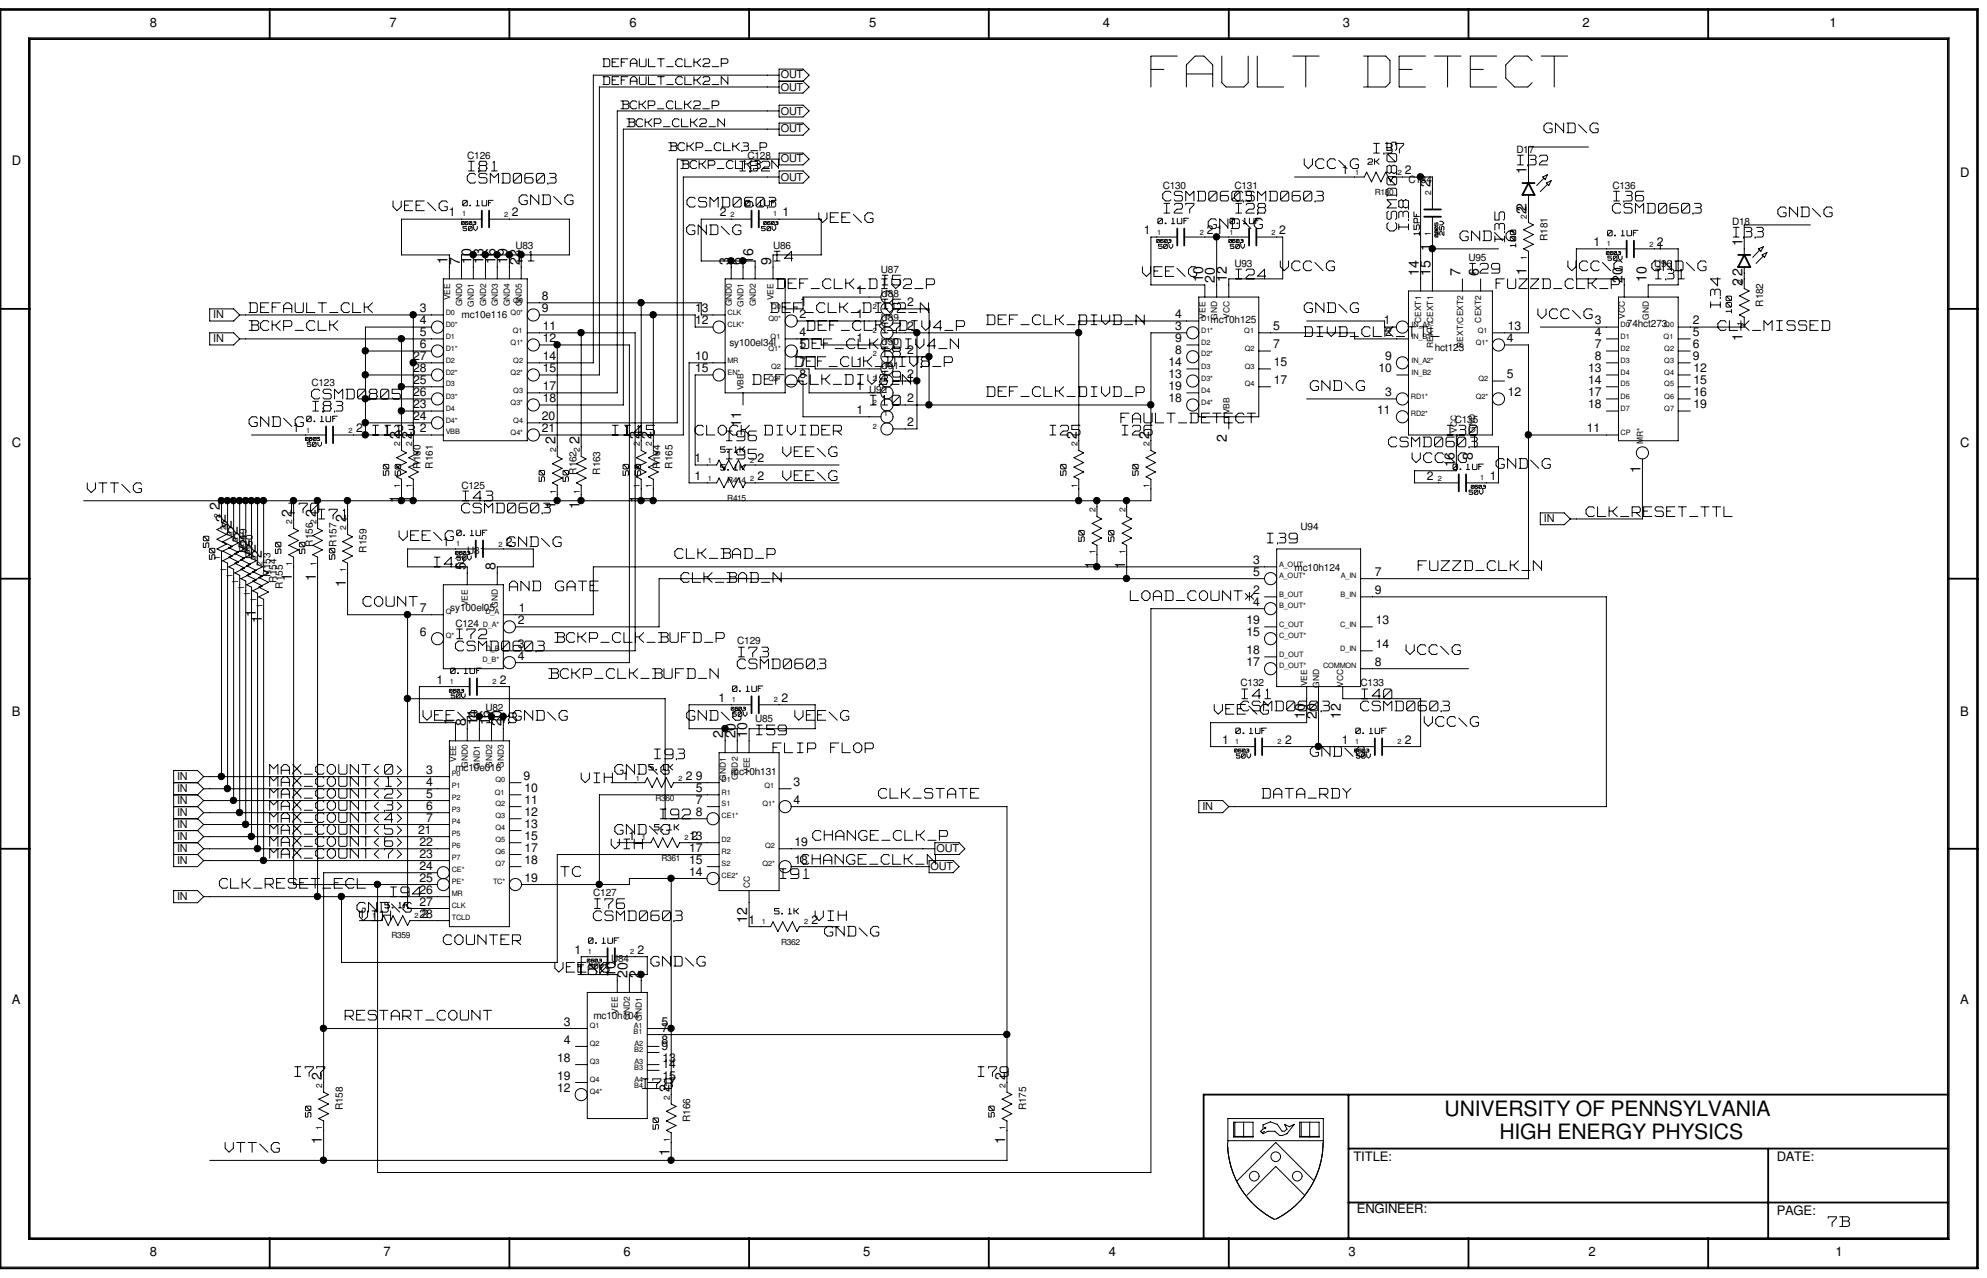
[picture p14: page 10]

# CHANGE CLOCKS

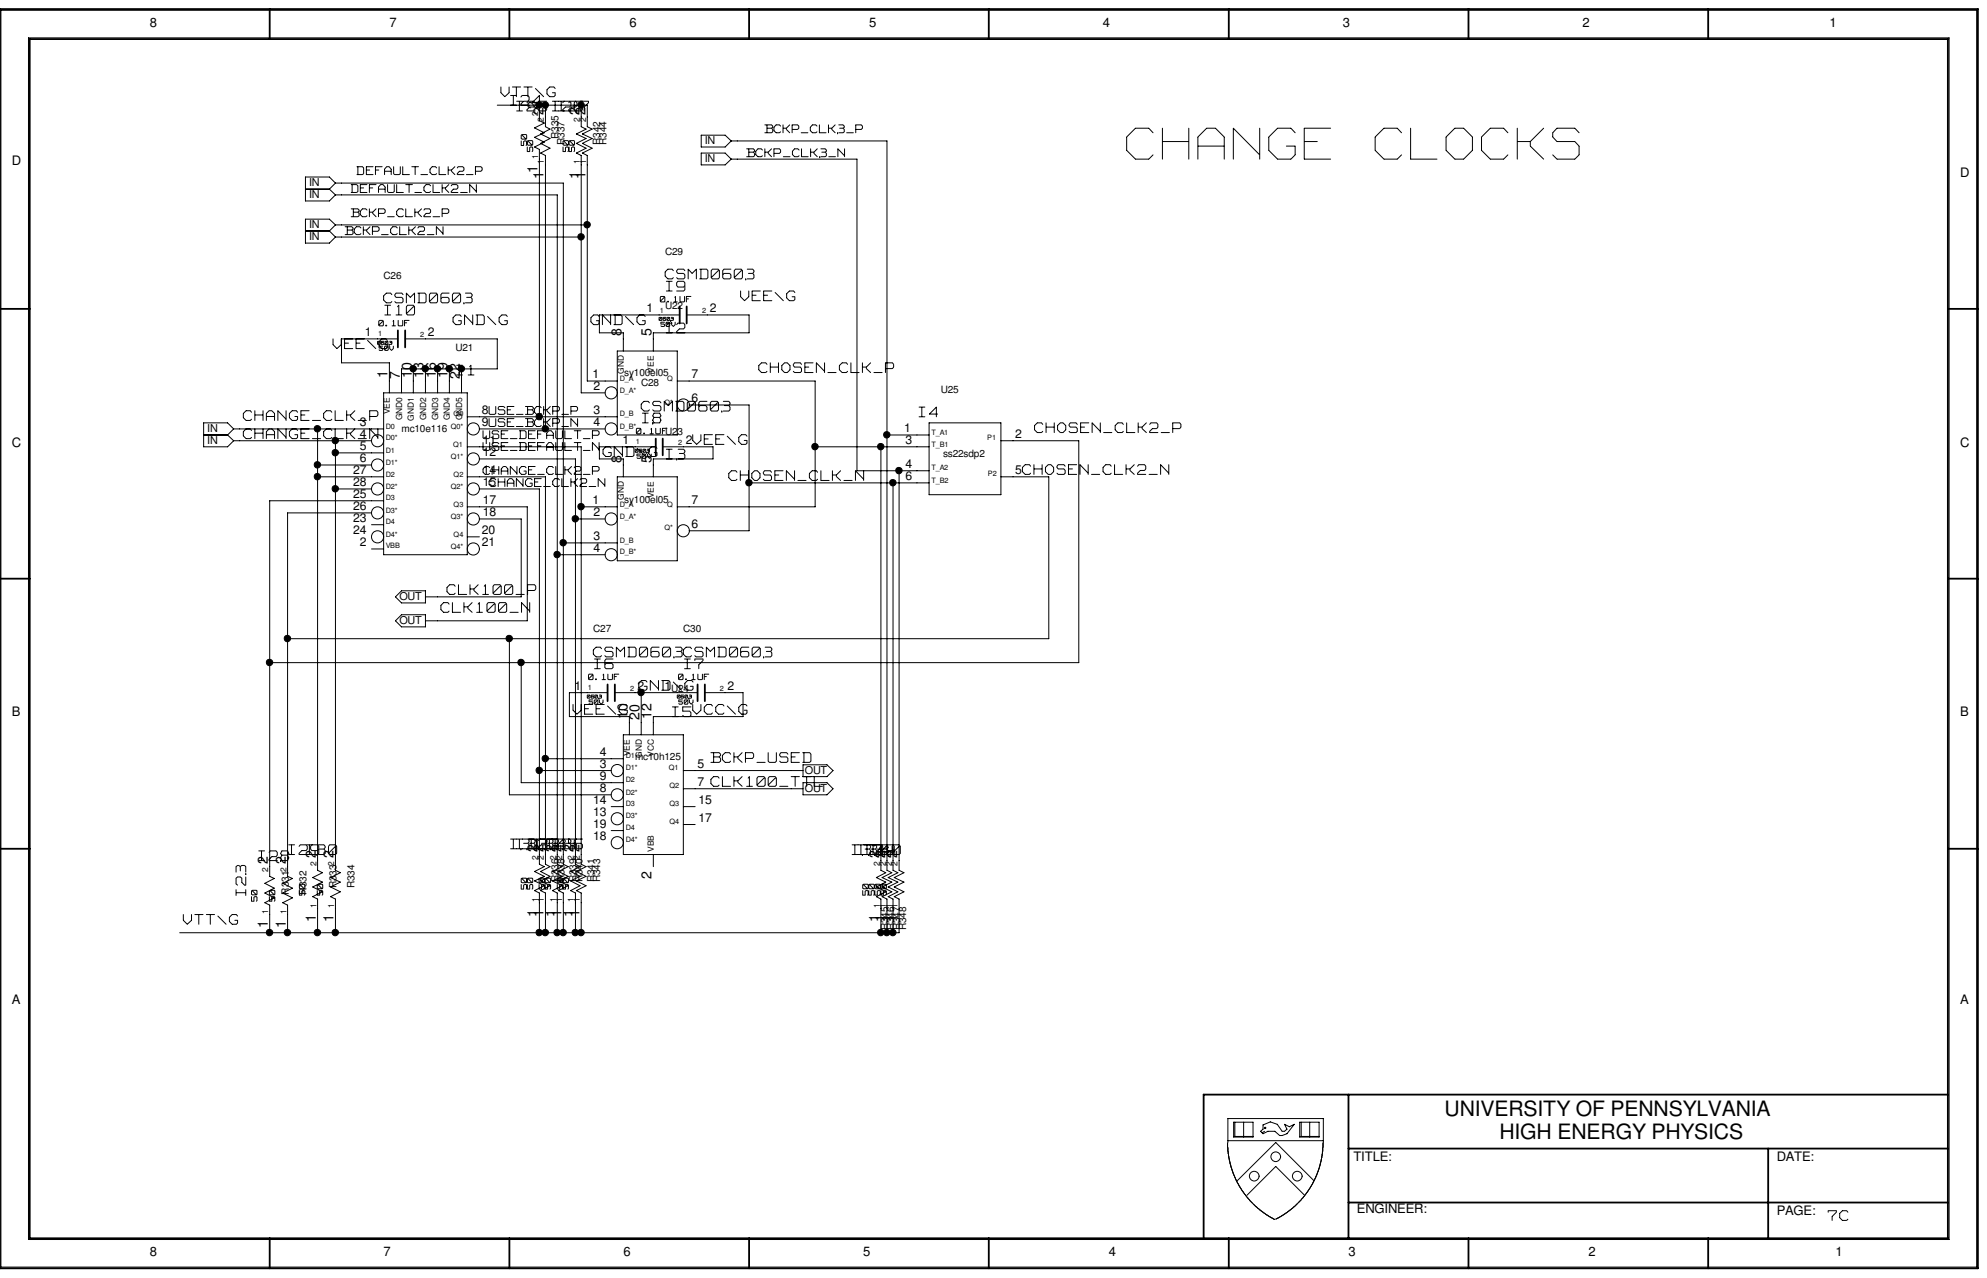
[picture p15: page 11]

UNIVERSITY OF PENNSYLVANIA HIGH ENERGY PHYSICS

TITLE: | DATE:

ENGINEER: | PAGE: 7C

# GENERAL UTILITIES

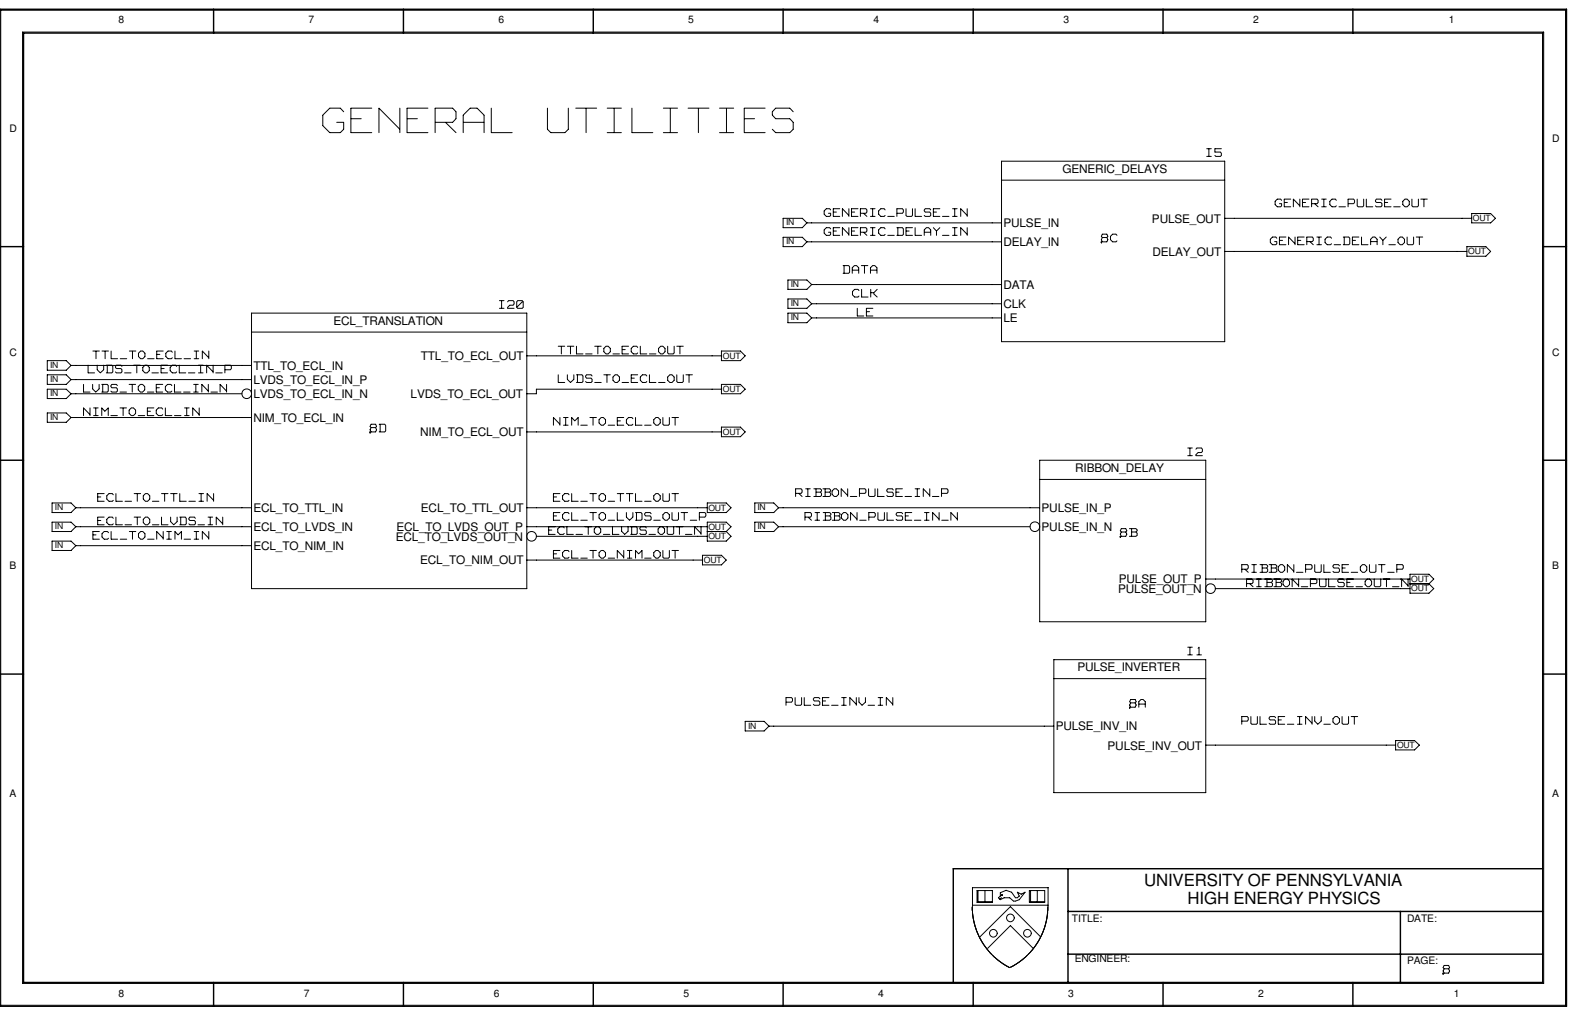
[picture p16: page 12]
LVDS_TO_ECL_OUT; TTL_TO_ECL_OUT; NIM_TO_ECL_IN; LVDS_TO_ECL_IN_N; LVDS_TO_ECL_IN_P; TTL_TO_ECL_IN; ECL_TO_NIM_IN; ECL_TO_LVDS_IN; ECL_TO_TTL_IN; NIM_TO_ECL_OUT; ECL_TO_TTL_OUT; ECL_TO_LVDS_OUT_P ECL_TO_LVDS_OUT_N; ECL_TO_NIM_OUT; RIBBON_PULSE_IN_N; PULSE_INV_IN; RIBBON_PULSE_IN_P; CLK; GENERIC_DELAY_IN; GENERIC_PULSE_IN; DATA; RIBBON_PULSE_OUT_N; RIBBON_PULSE_OUT_P; PULSE_INV_OUT; GENERIC_DELAY_OUT; GENERIC_PULSE_OUT; OUT; GENERIC_DELAYS; DELAY_OUT; PULSE_OUT; DELAY_IN; PULSE_IN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

UNIVERSITY OF PENNSYLVANIA HIGH ENERGY PHYSICS

TITLE: | DATE:

ENGINEER: | PAGE: 8

# PULSE_INVERTER

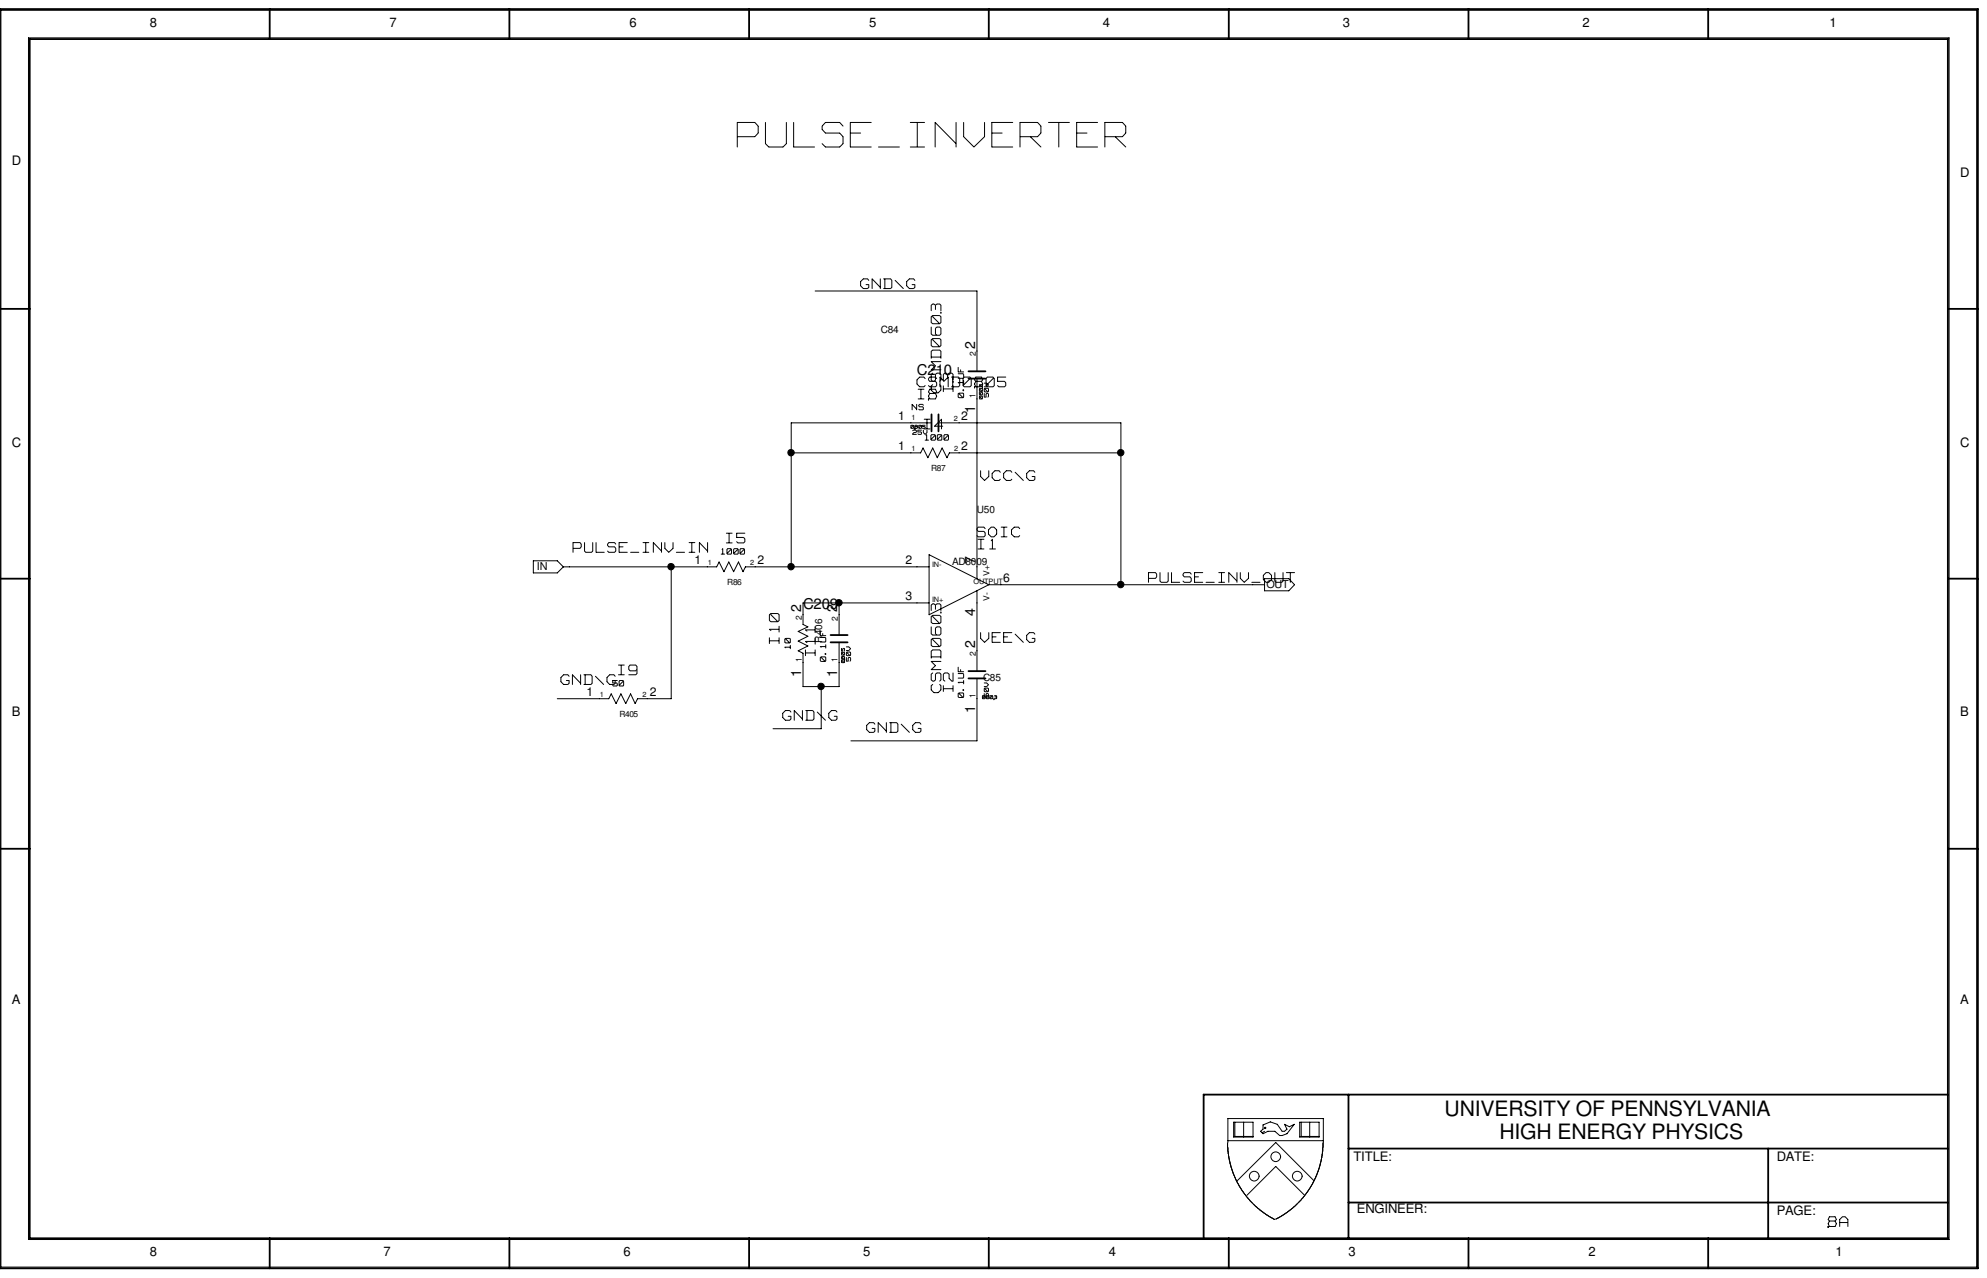
[picture p17: page 13]

UNIVERSITY OF PENNSYLVANIA HIGH ENERGY PHYSICS

TITLE: | DATE:

ENGINEER: | PAGE: 8A

# RIBBON DELAY

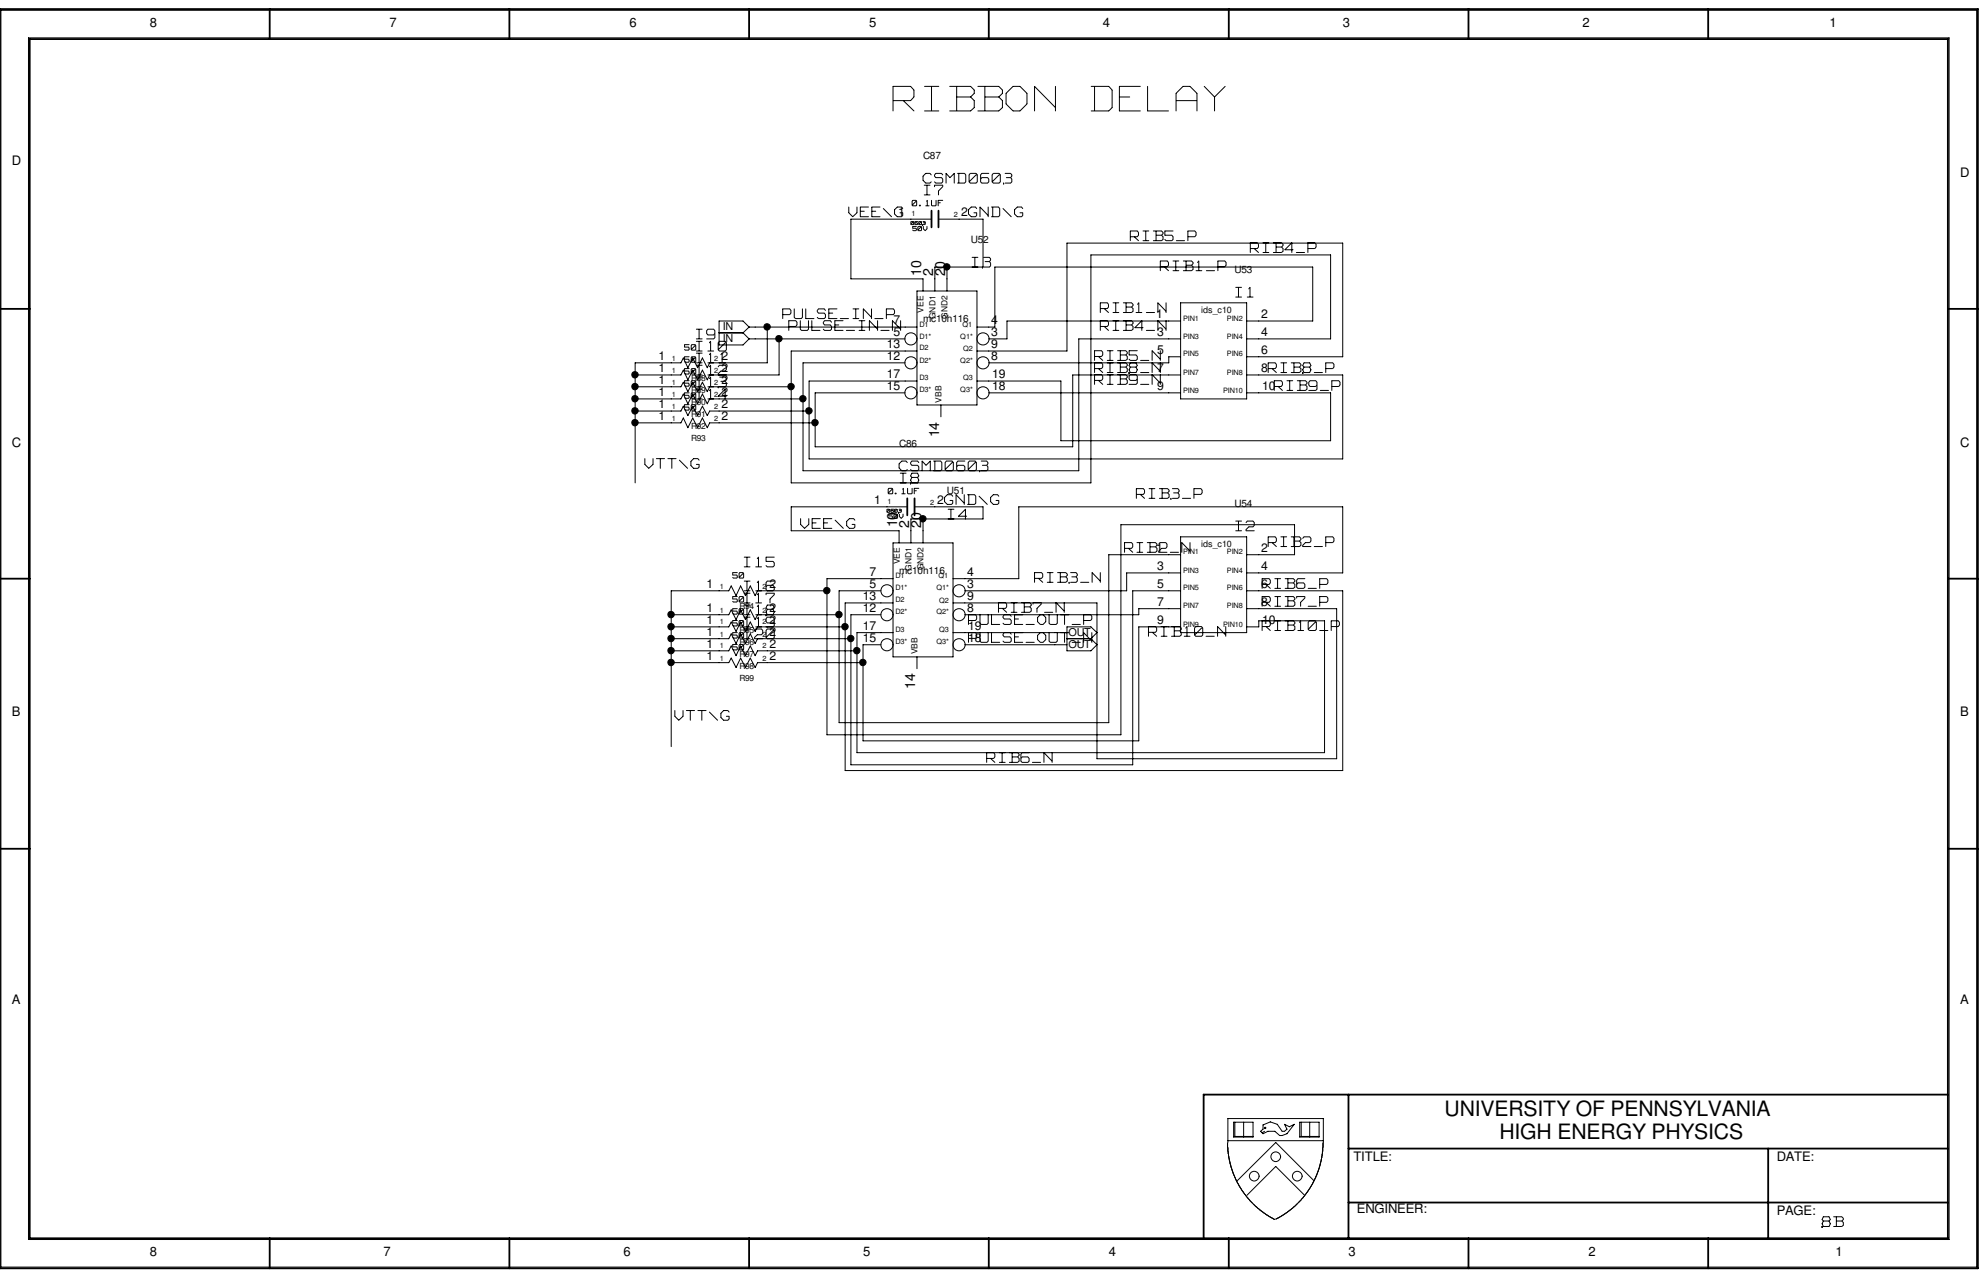
[picture p18: page 14]

UNIVERSITY OF PENNSYLVANIA HIGH ENERGY PHYSICS

TITLE: | DATE:

ENGINEER: | PAGE: 8B

# GENERIC DELAYS

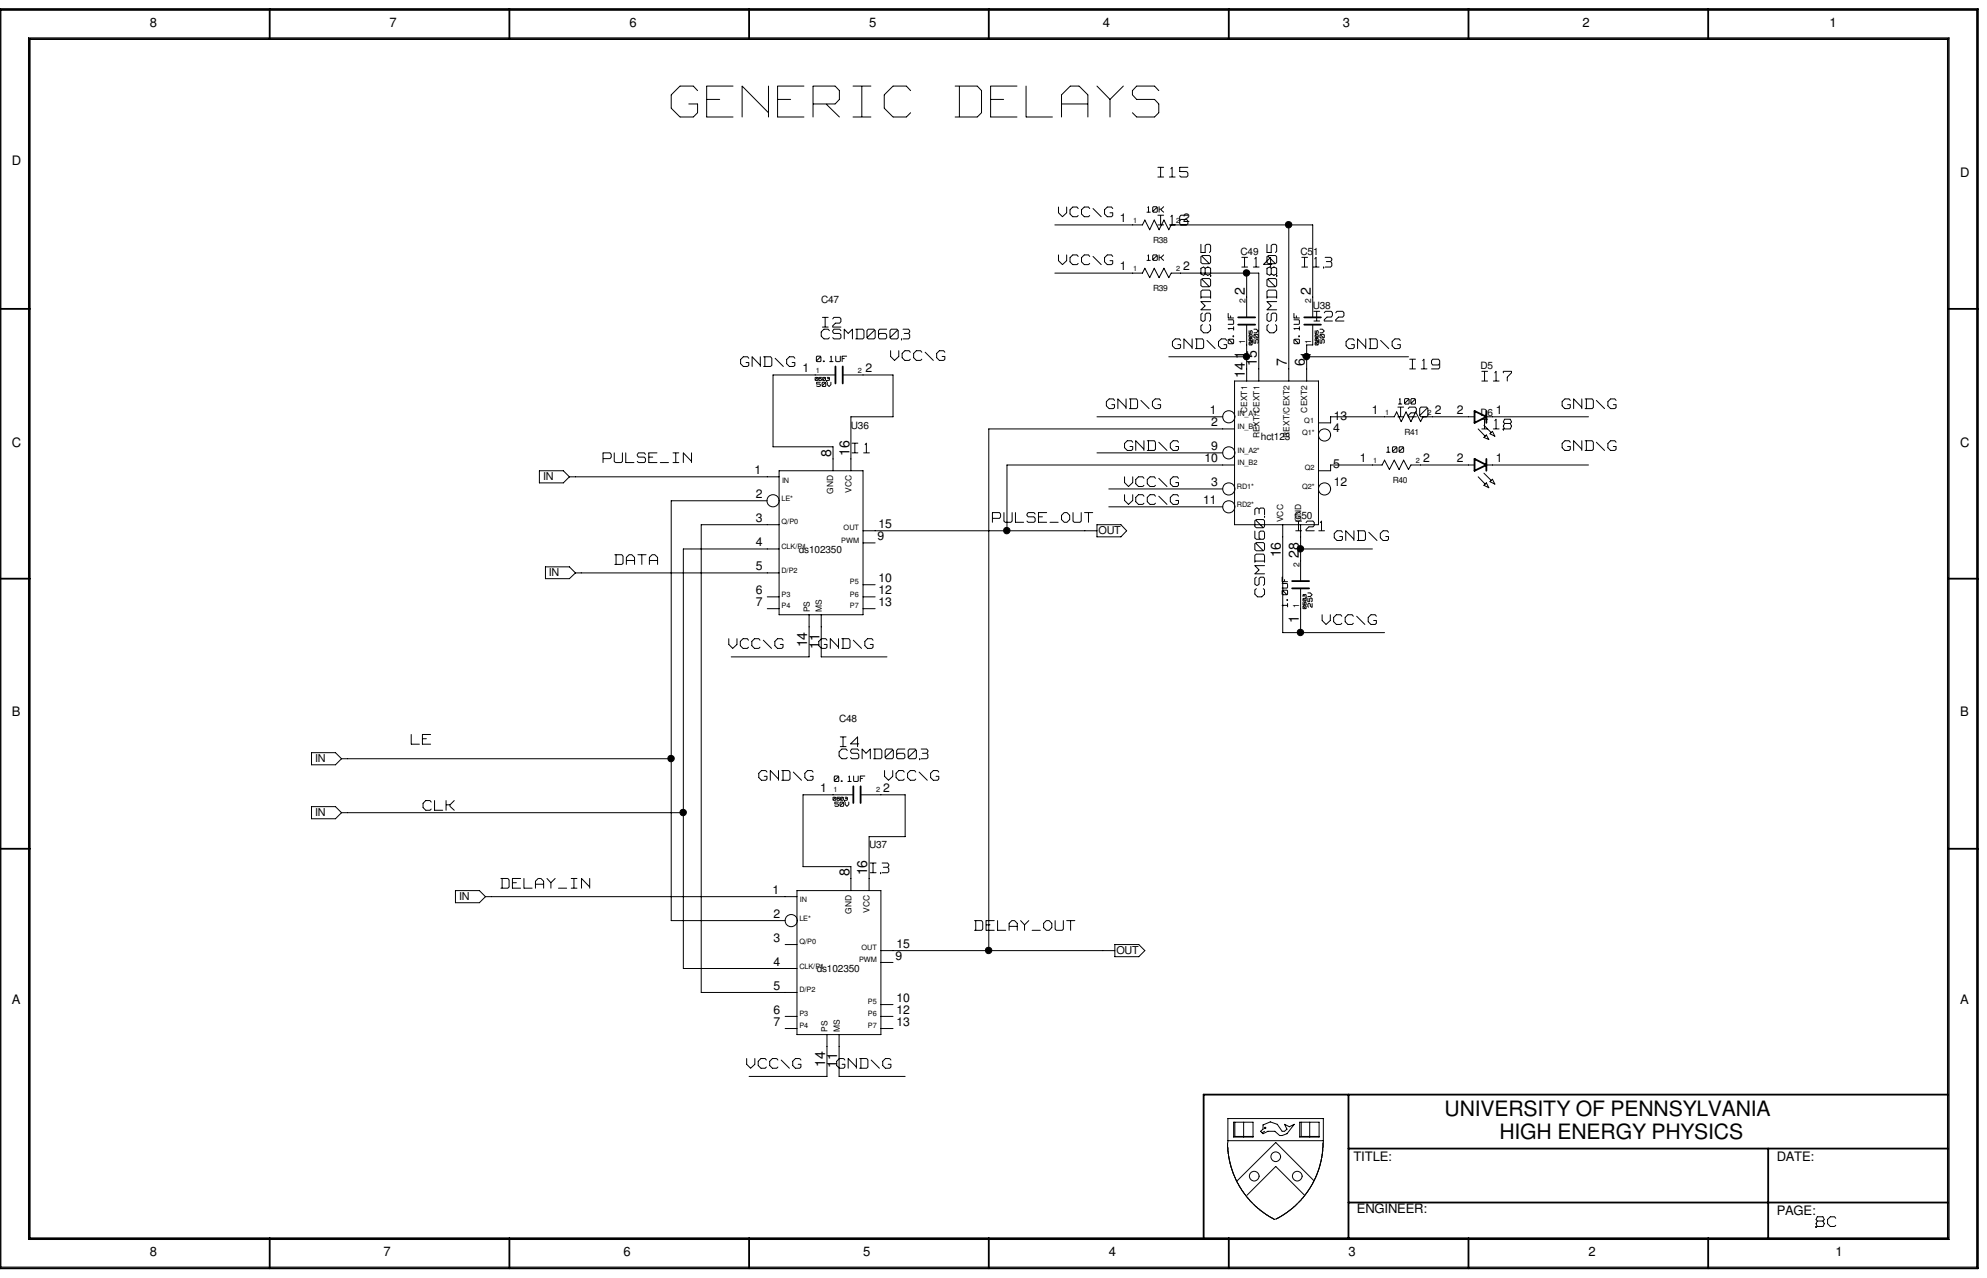
[picture p19: page 15]

# TRANSLATORS

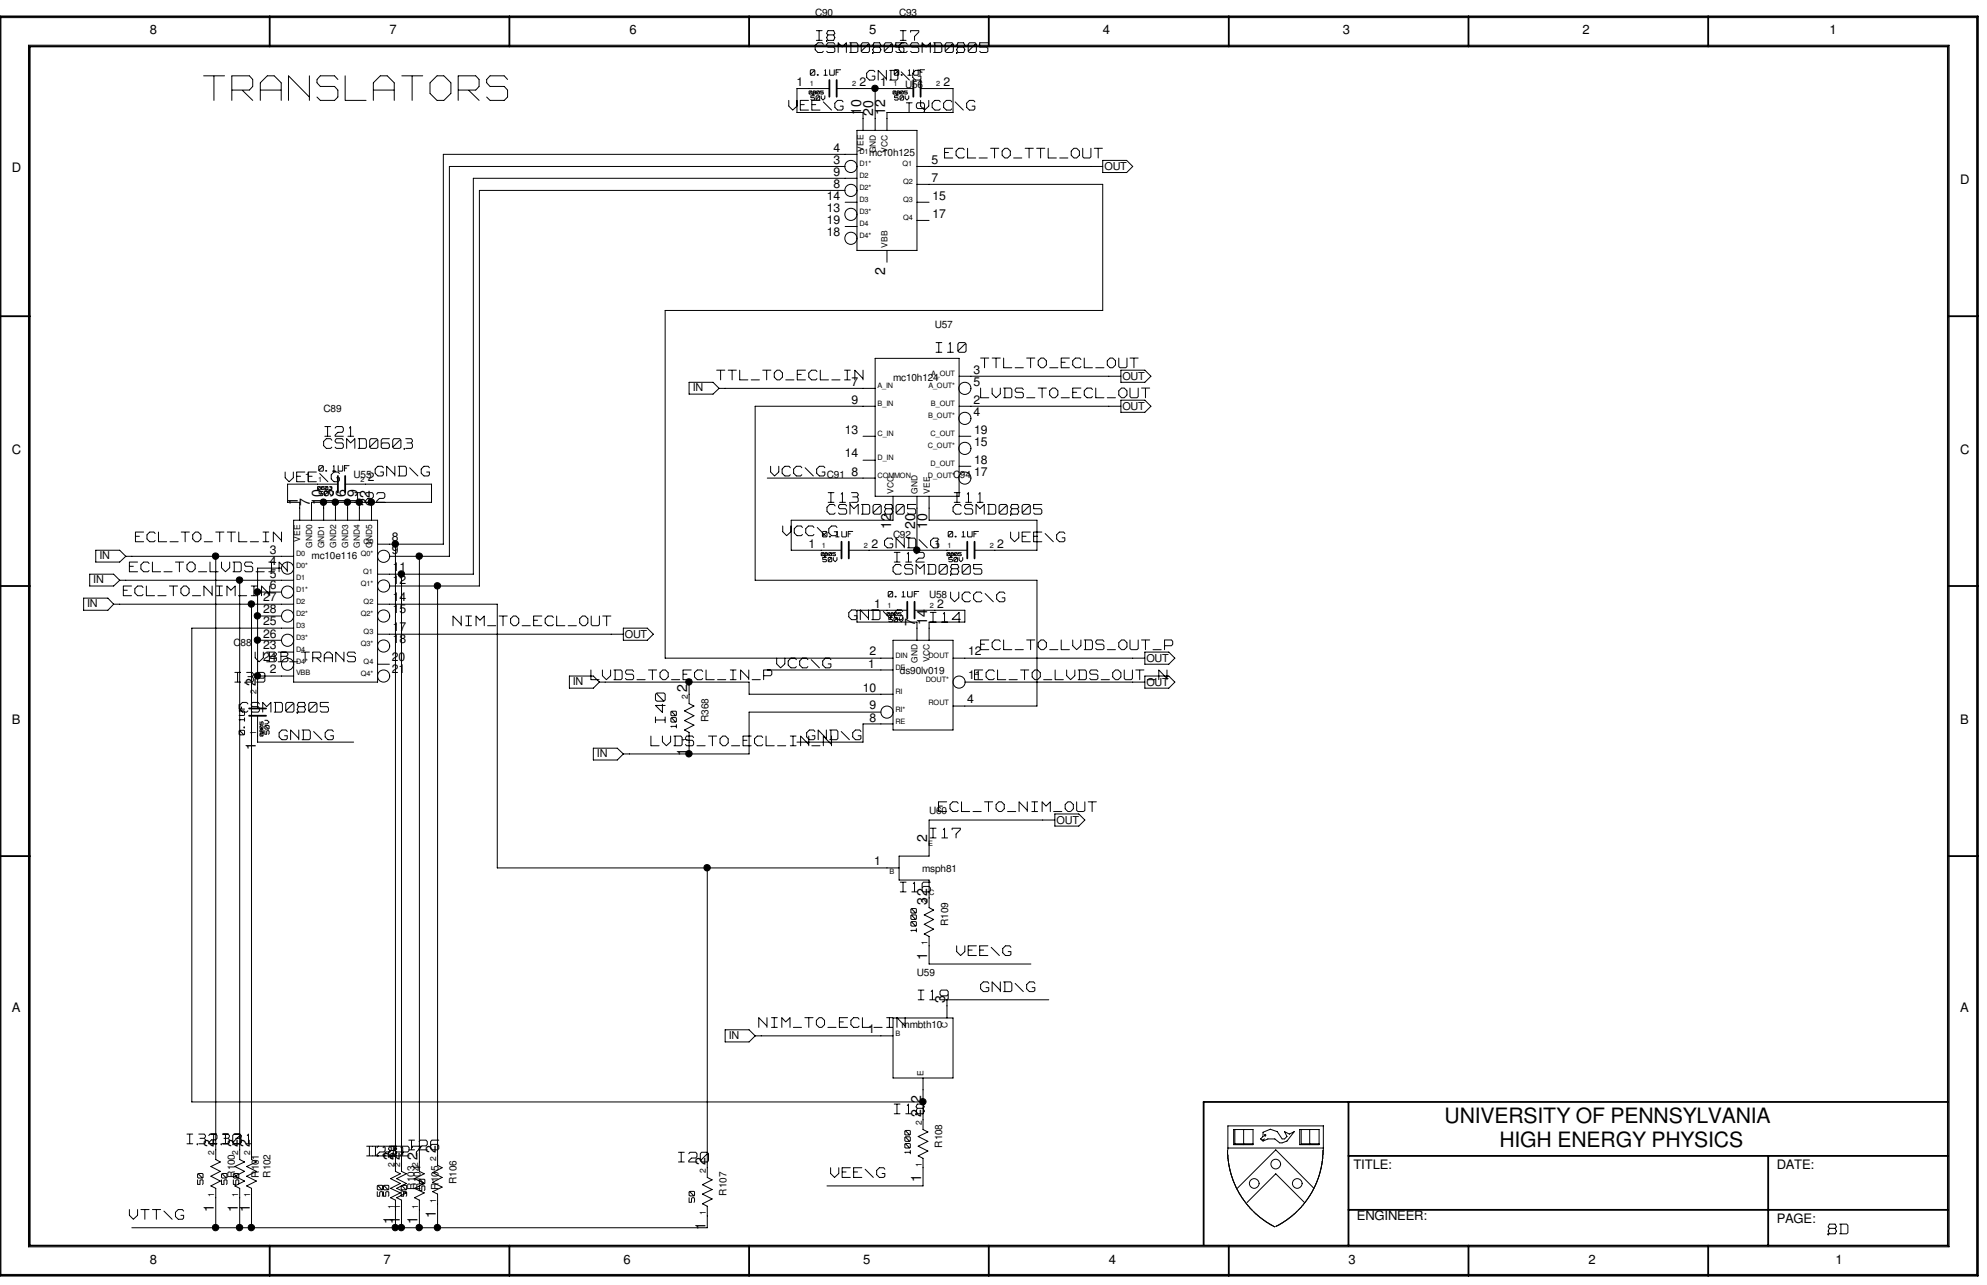
[picture p20: page 16]

UNIVERSITY OF PENNSYLVANIA HIGH ENERGY PHYSICS

TITLE: | DATE:

ENGINEER: | PAGE: 8D

# POWER

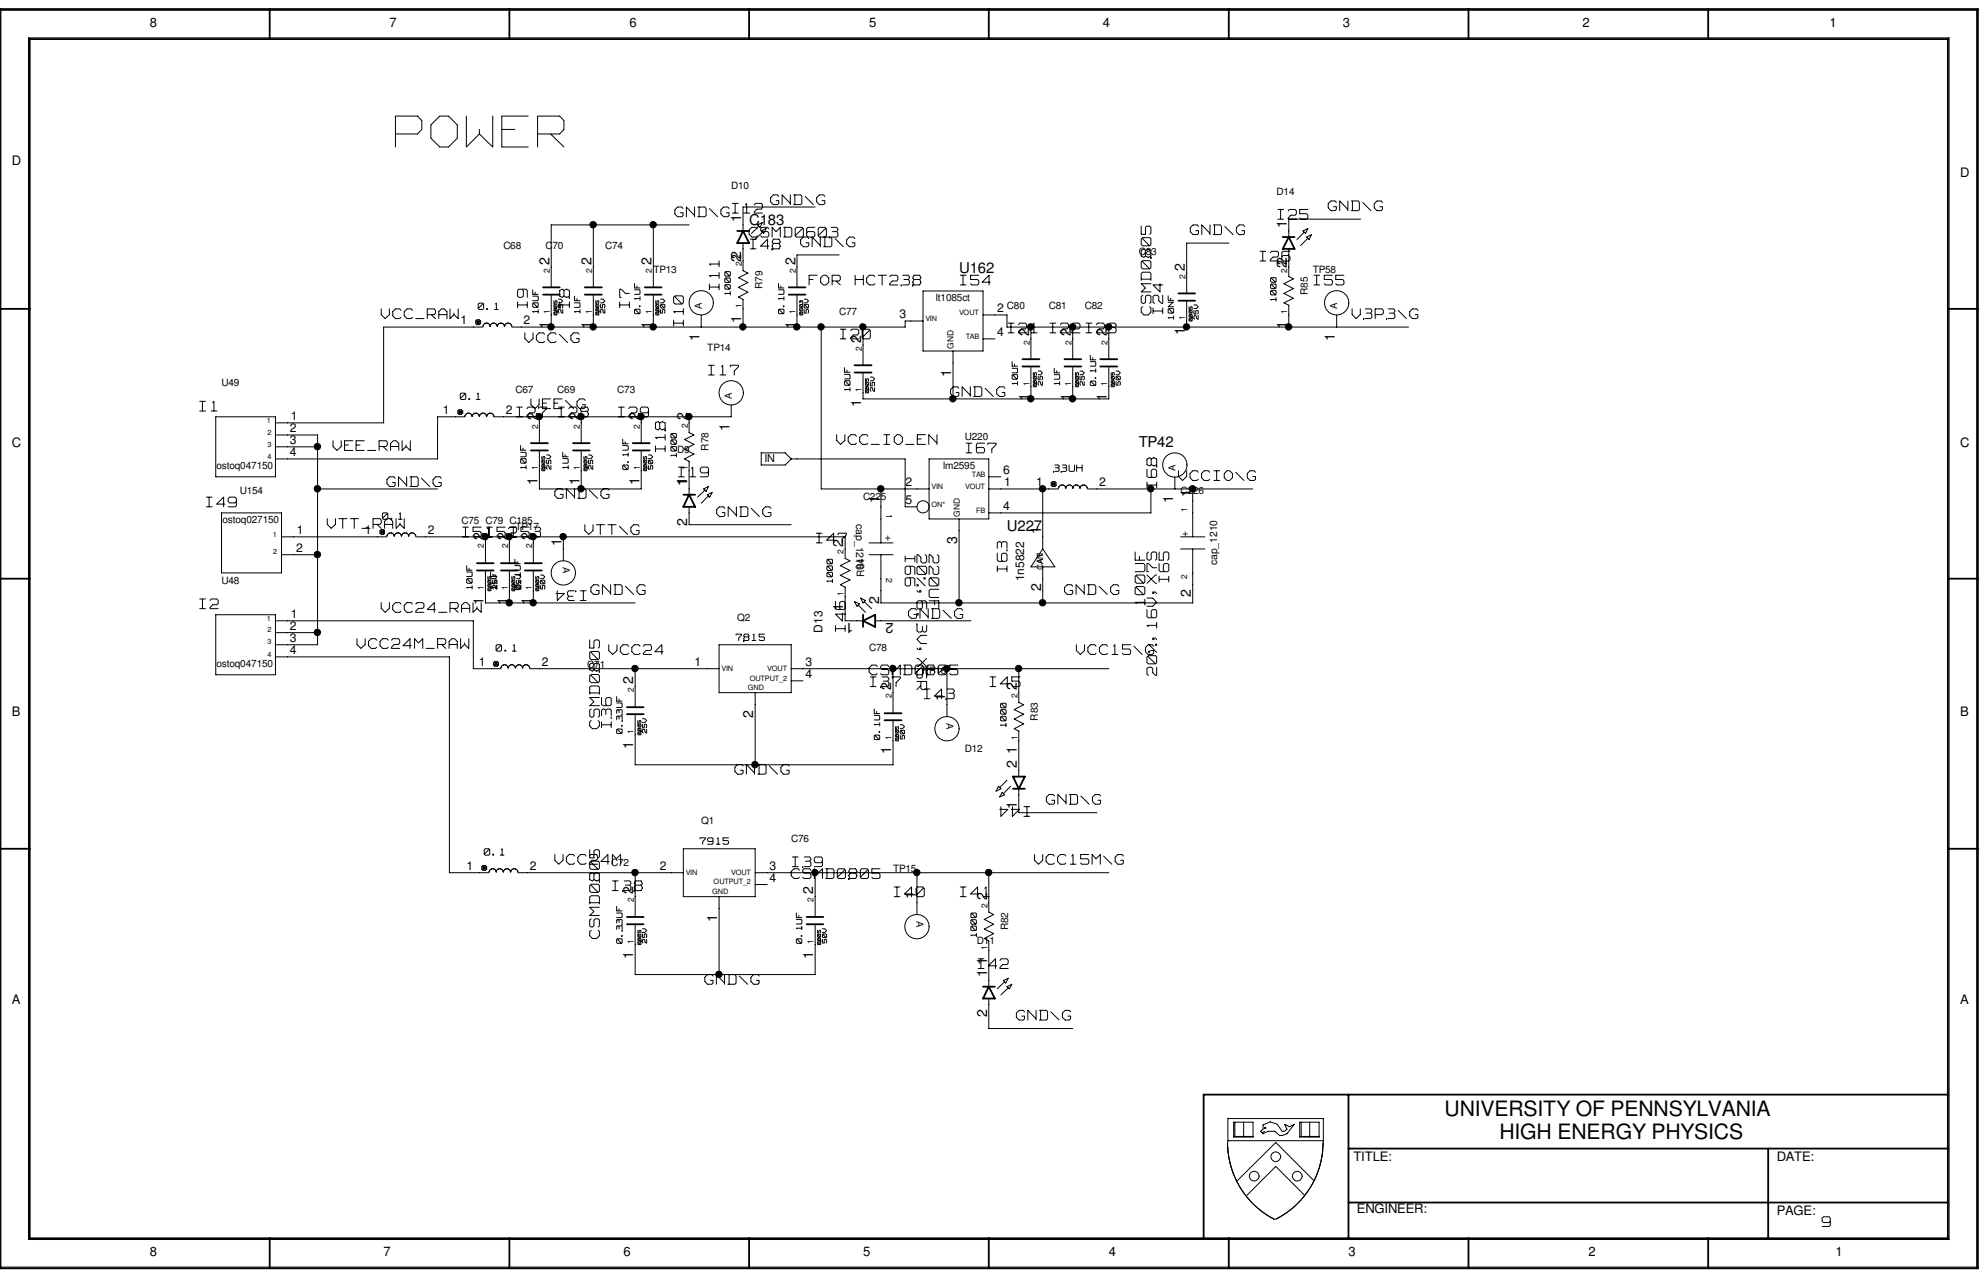
[picture p21: page 17]

# ECAL CONTROL

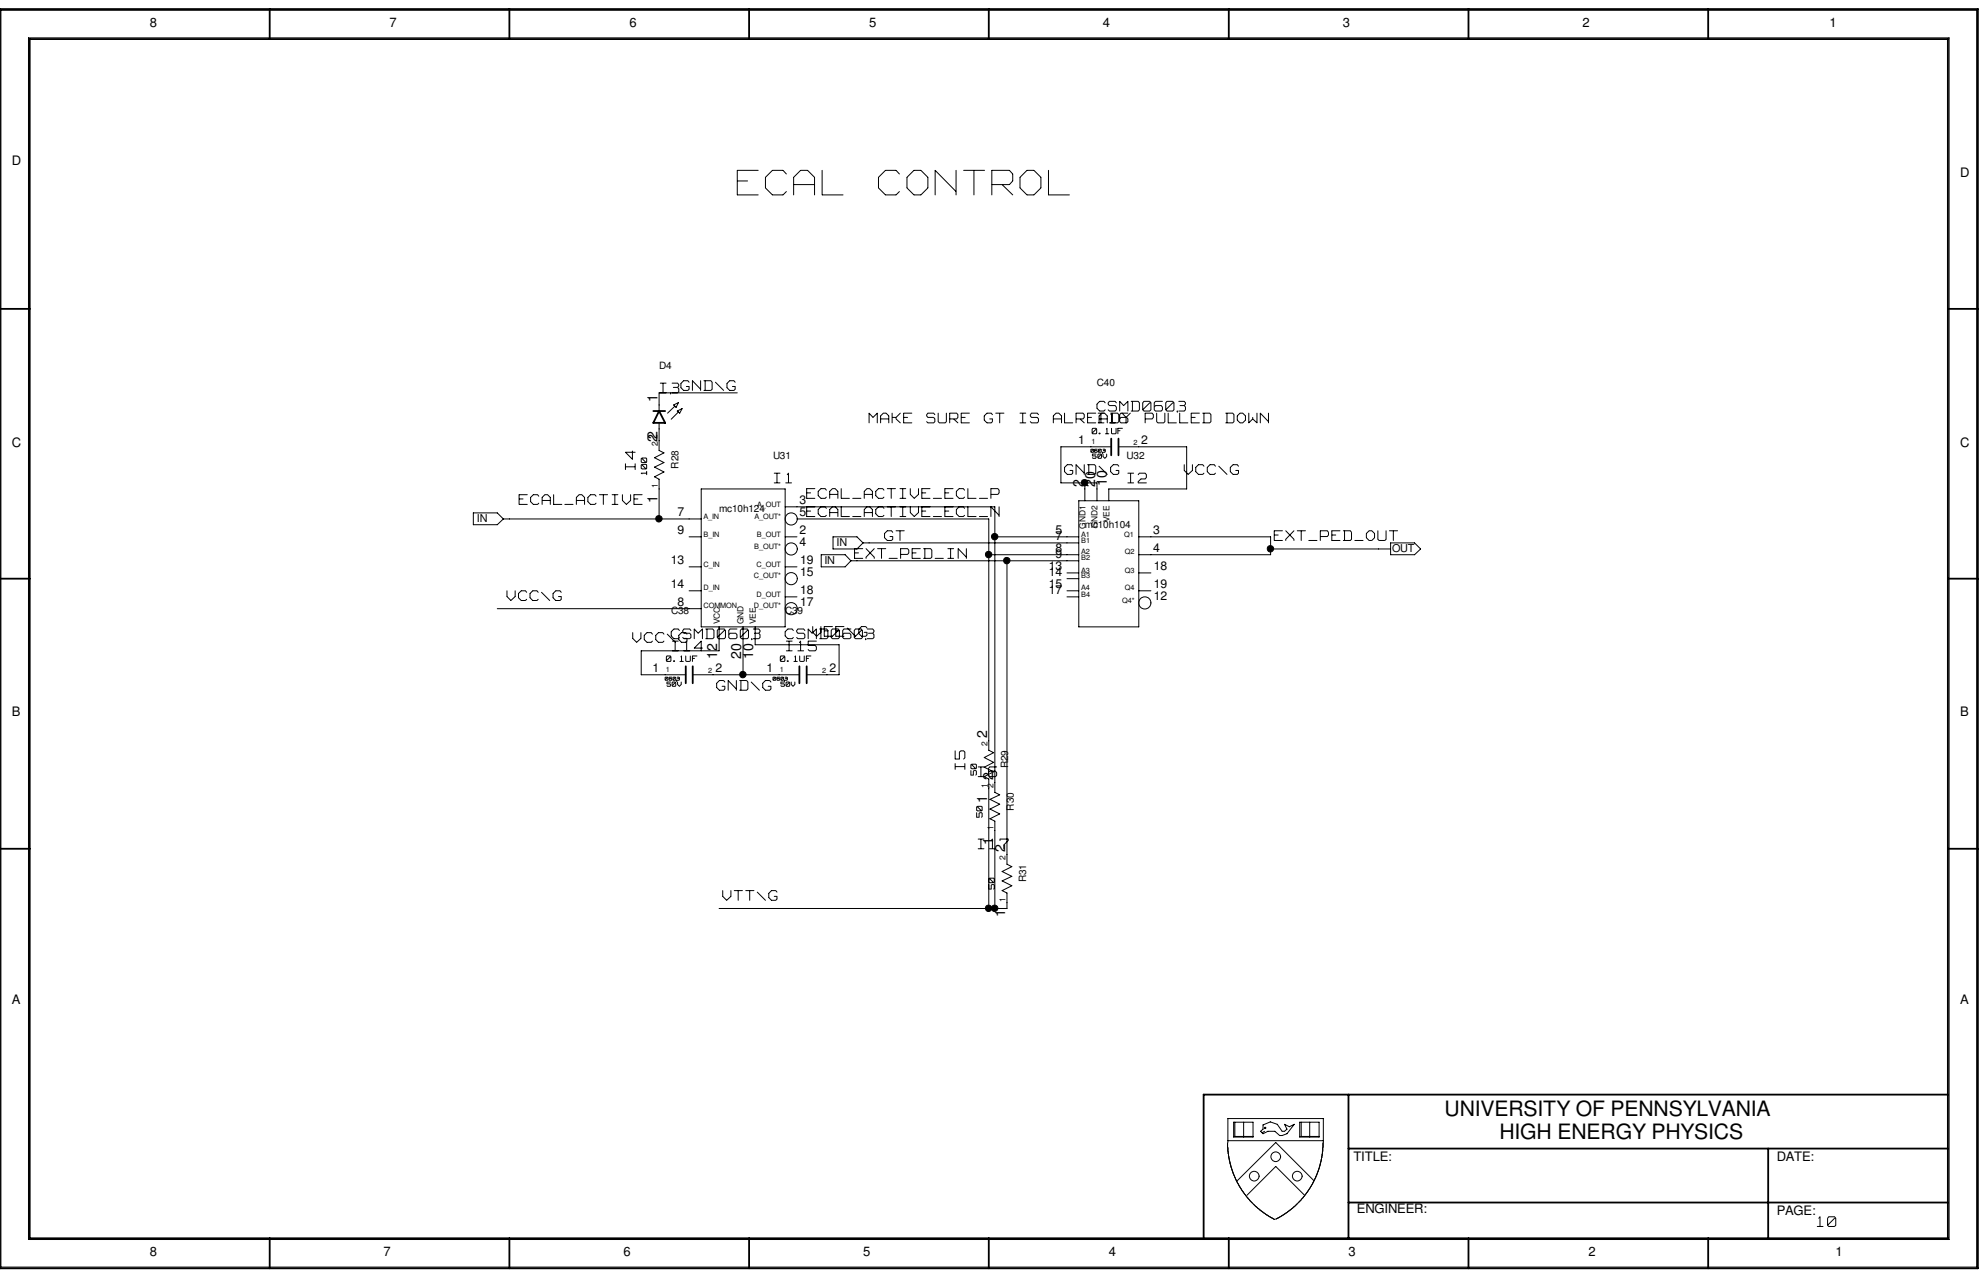
[picture p22: page 18]

MAKE SURE GT IS ALREADY PULLED DOWN

# CAEN COMMS

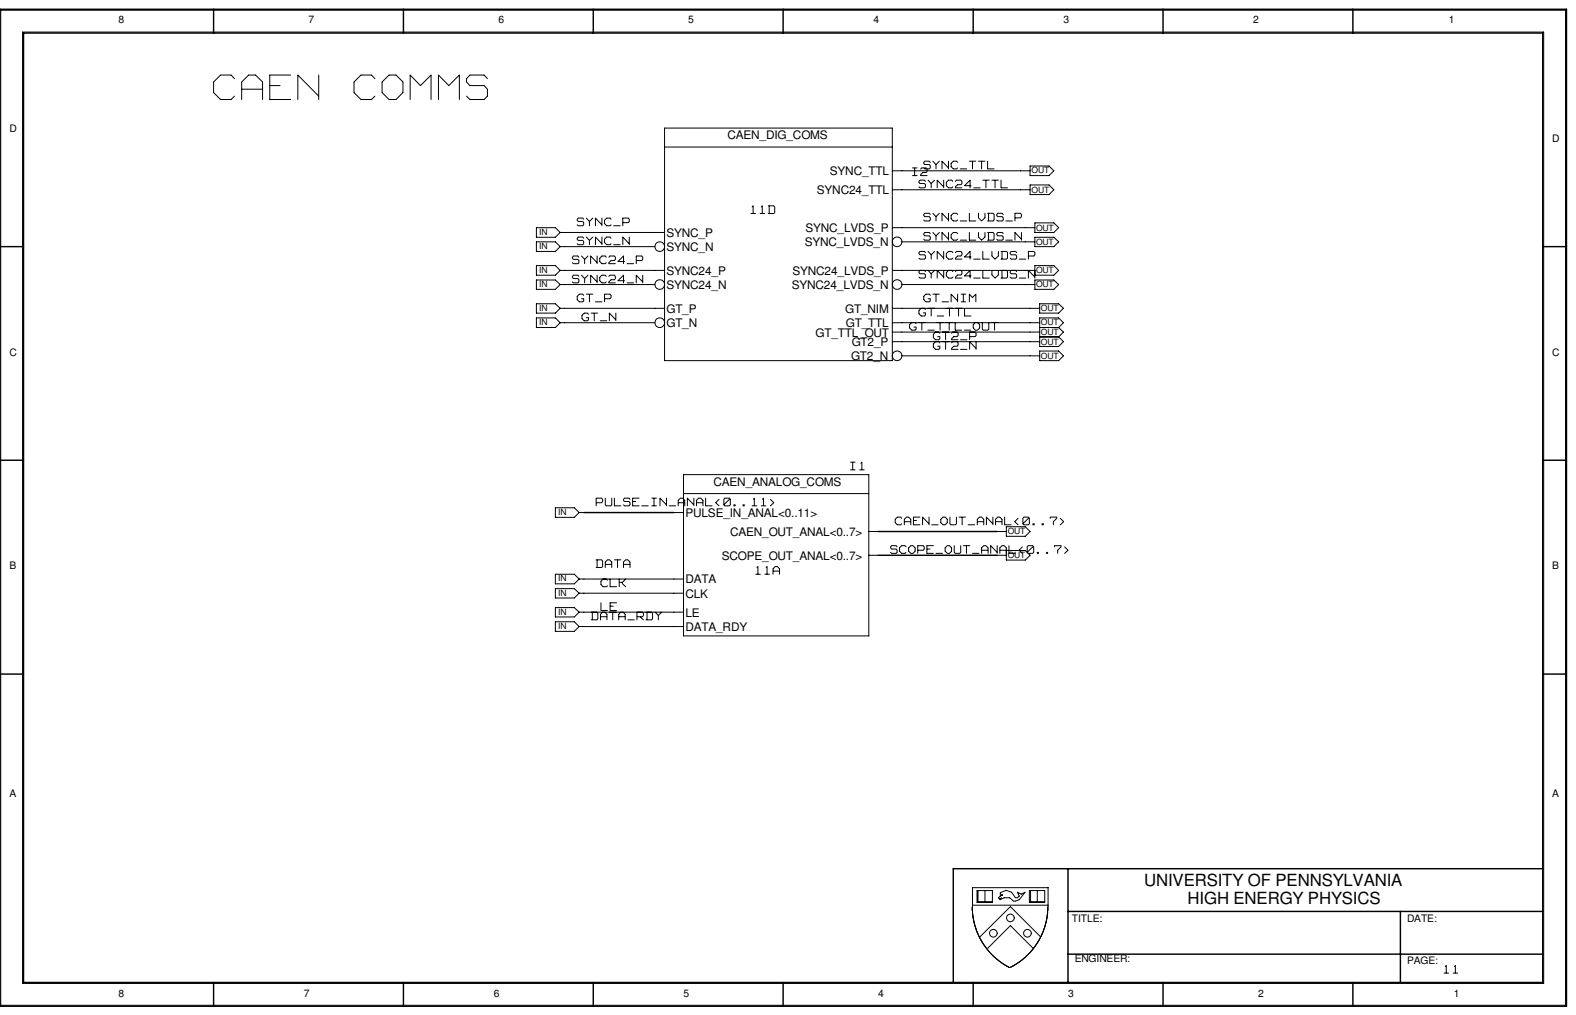
[picture p23: page 19]
GT_TTL_OUT; GT_TTL; SYNC24_N; SYNC24_P; GT_NIM; SYNC24_TTL; SYNC_TTL I2; SYNC_LVDS_N; SYNC24_LVDS_P; SYNC24_LVDS_N; PULSE_IN_ANAL<0..11>; DATA; SYNC_P; SYNC_N; SYNC_LVDS_P; SCOPE_OUT_ANAL<0..7>; CAEN_OUT_ANAL<0..7>; DATA_RDY; CLK; OUT; CAEN_DIG_COMS; SYNC_P SYNC_N; SYNC24_P SYNC24_N; GT_NIM GT_TTL; SYNC_TTL; CAEN_ANALOG_COMS

UNIVERSITY OF PENNSYLVANIA HIGH ENERGY PHYSICS

TITLE: | DATE:

ENGINEER: | PAGE: 11

# CAEN_ANALOG

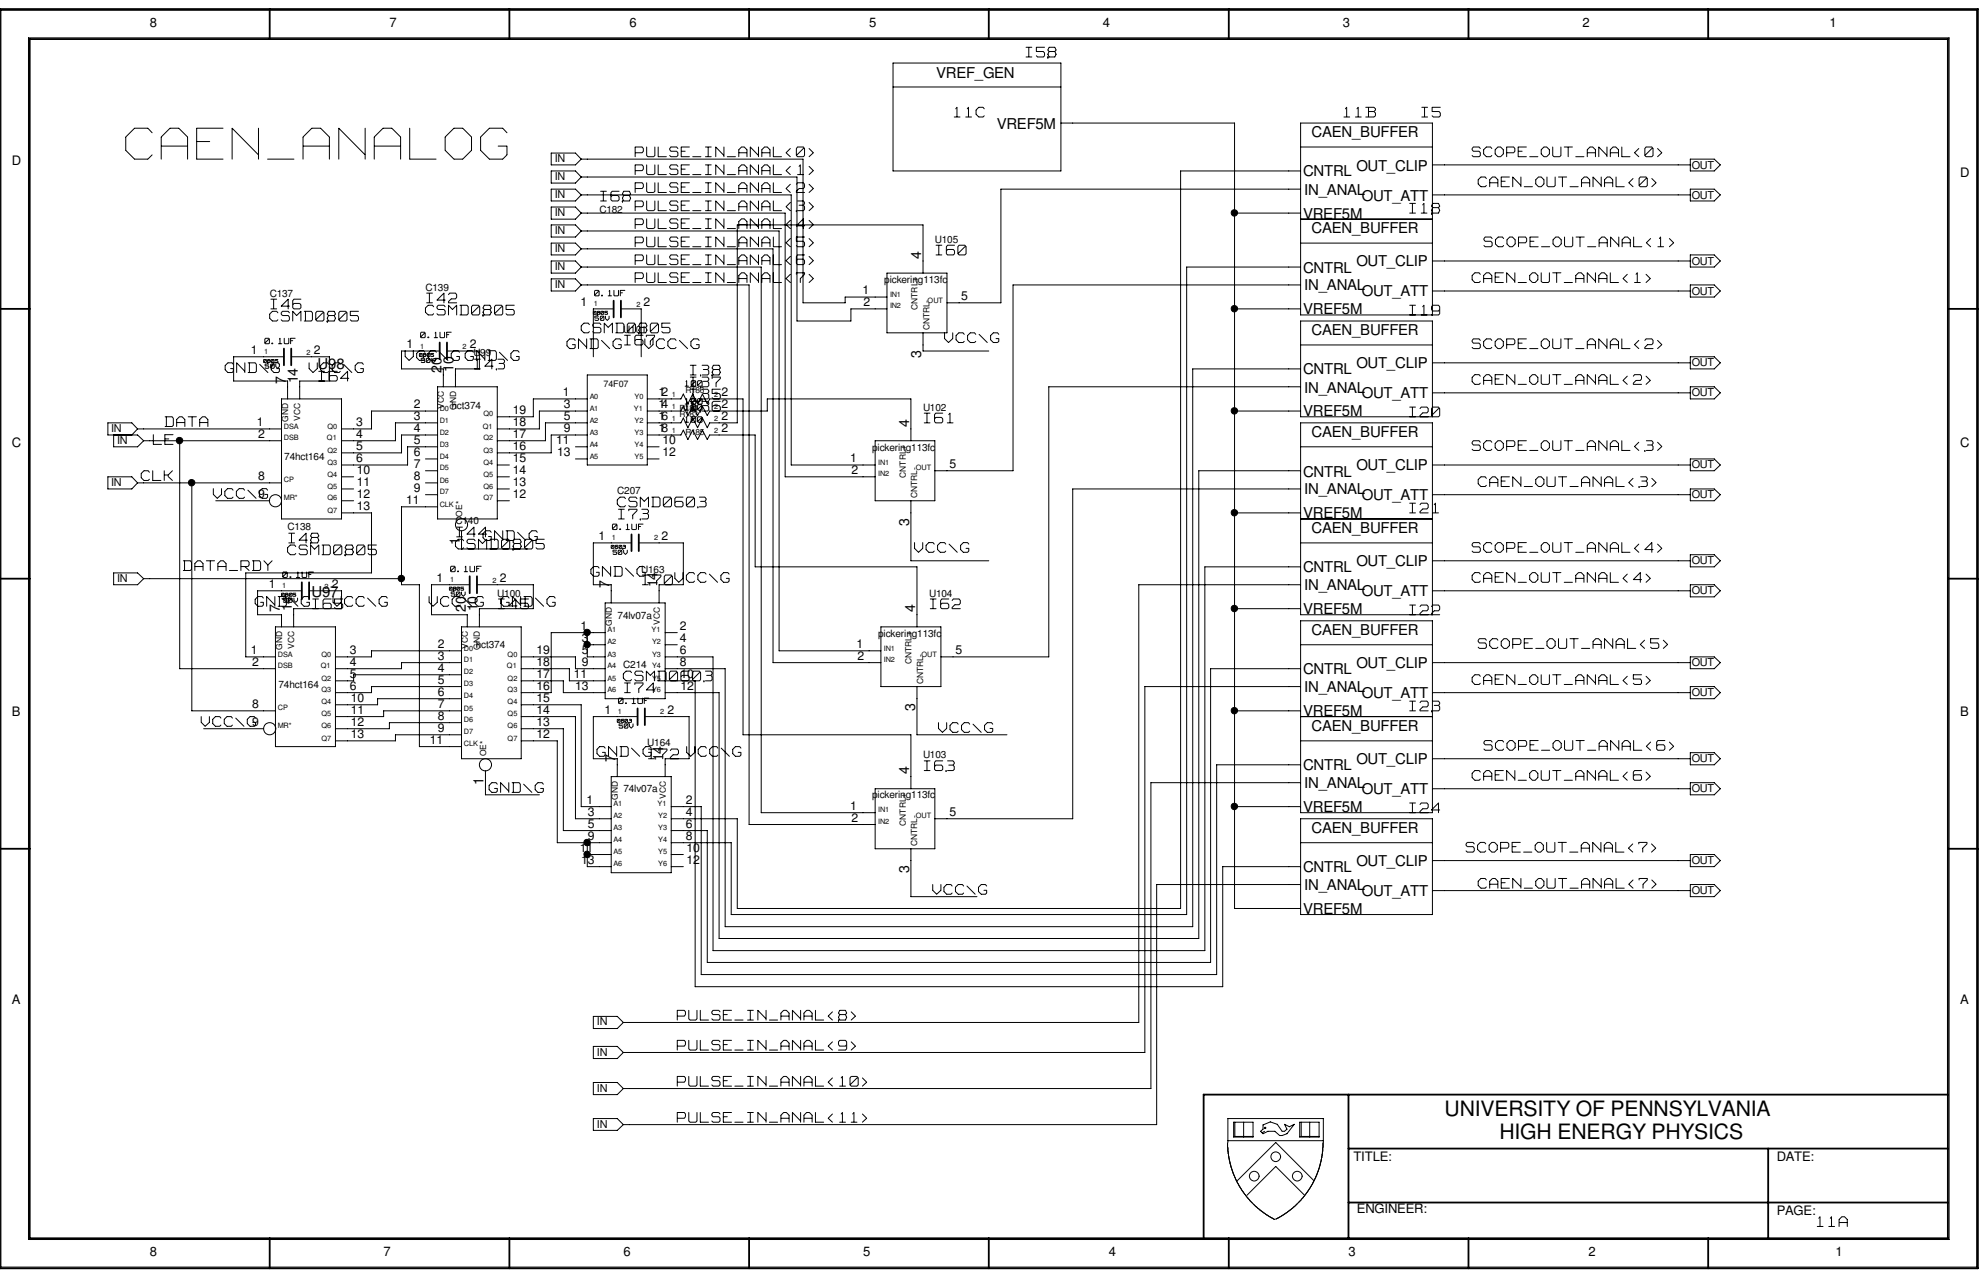
[picture p24: page 20]

UNIVERSITY OF PENNSYLVANIA HIGH ENERGY PHYSICS

TITLE: | DATE:

ENGINEER: | PAGE: 11A

# CAEN BUFFER

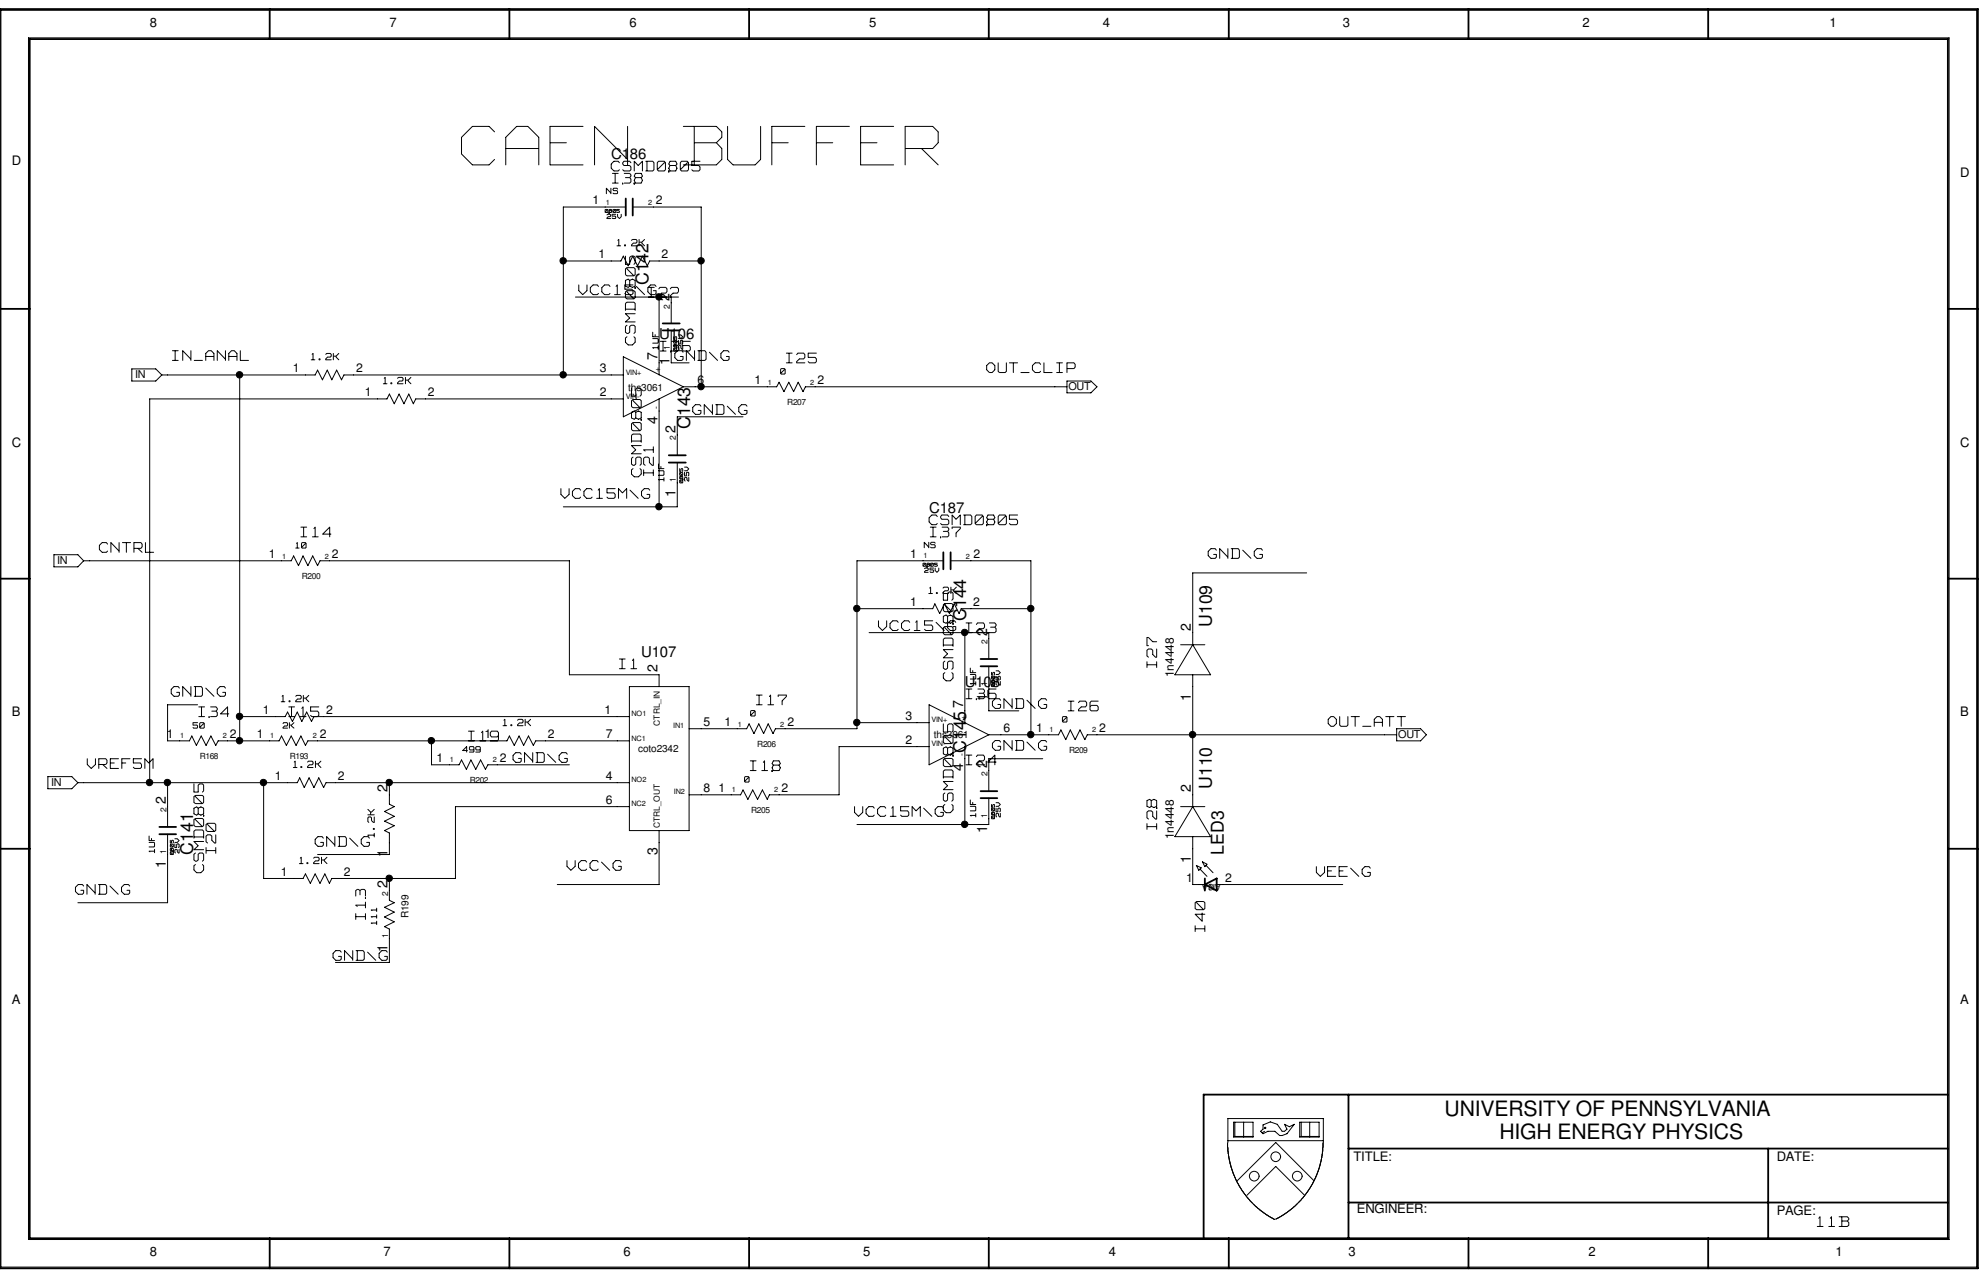
[picture p25: page 21]

# VREF

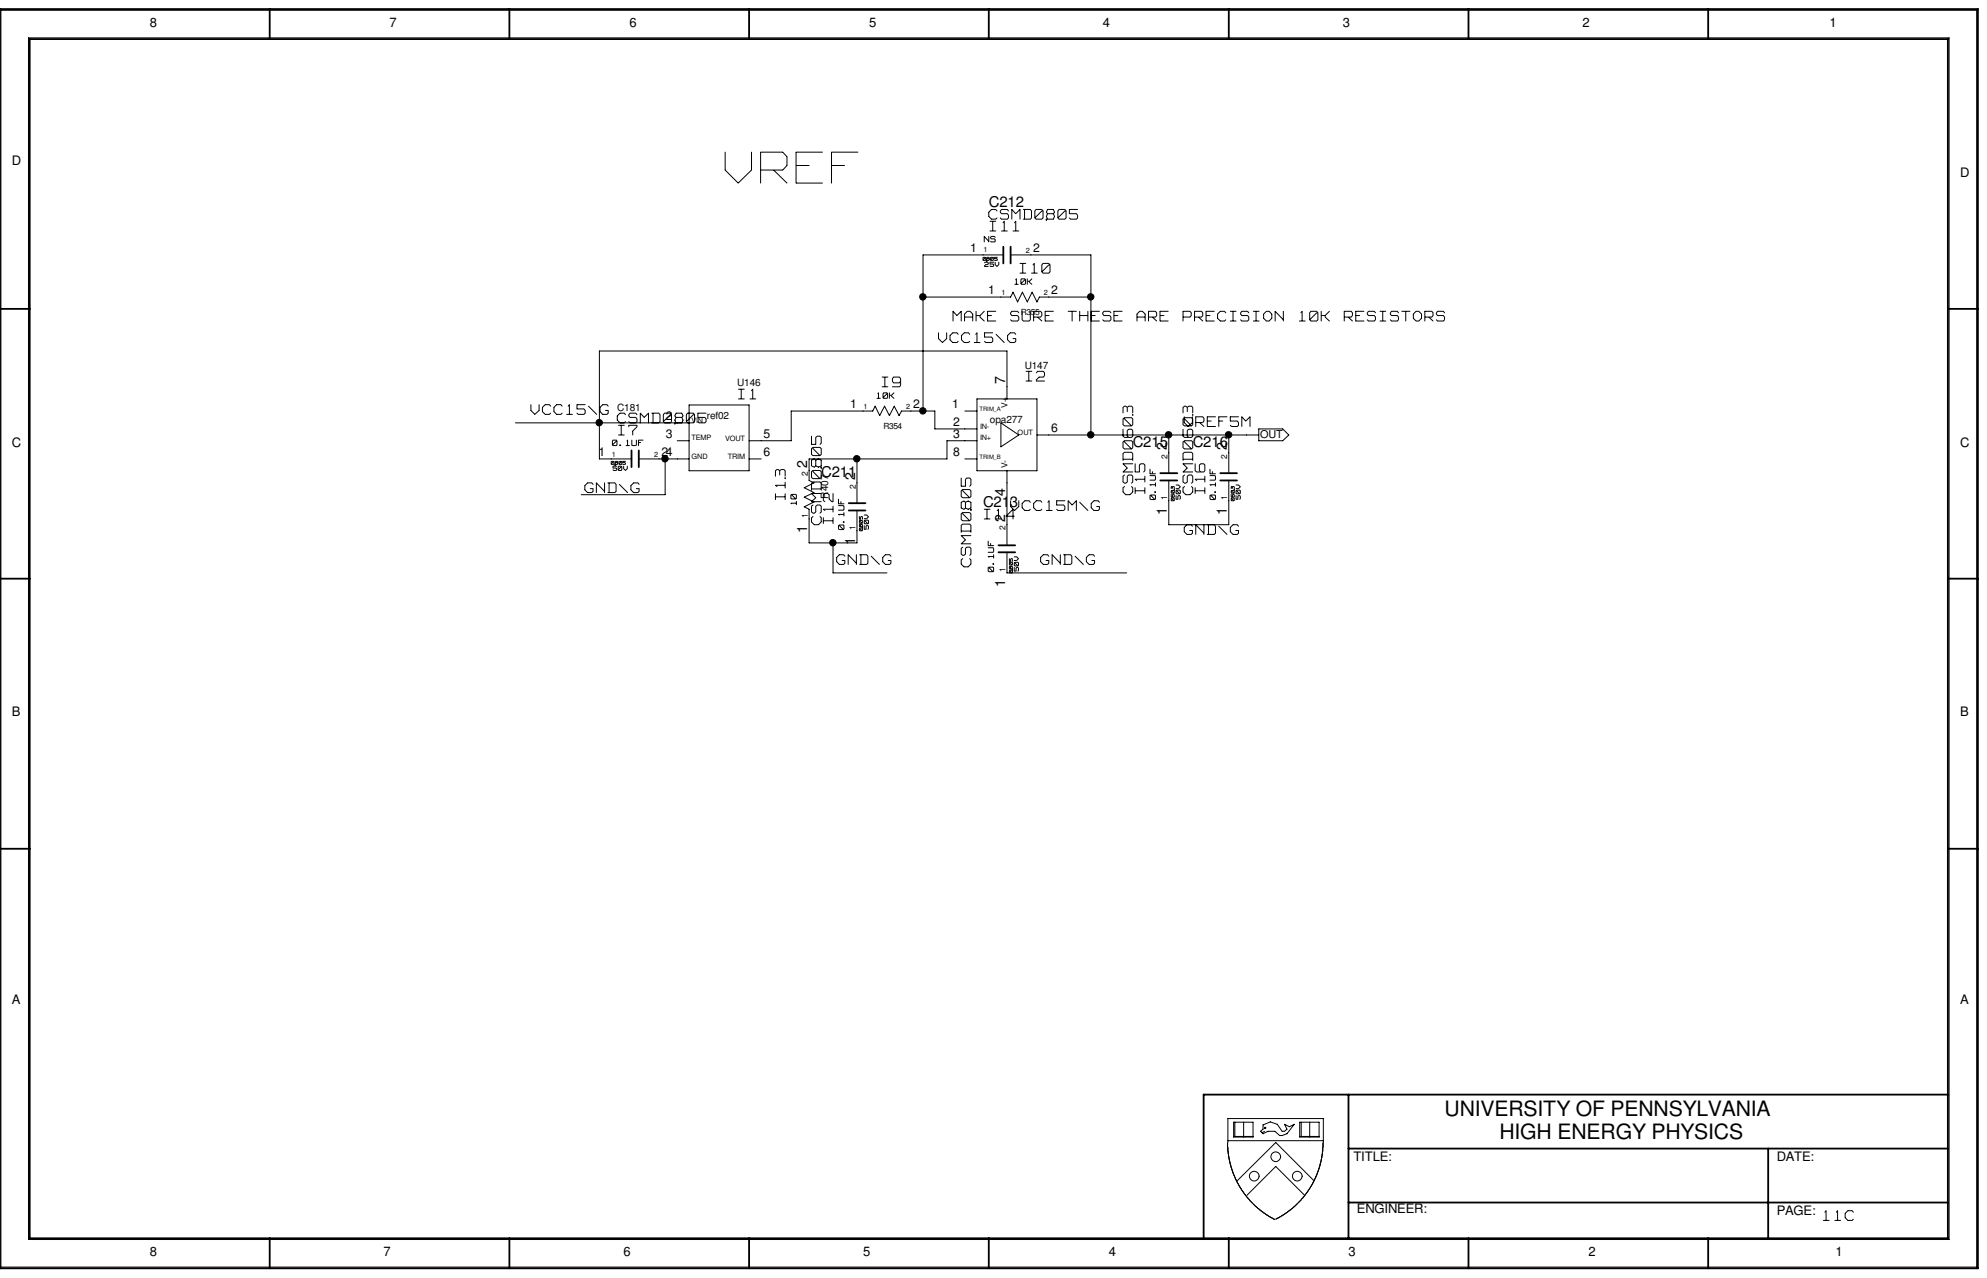
[picture p26: page 22]

MAKE SURE THESE ARE PRECISION 10K RESISTORS
VCC15\G

UNIVERSITY OF PENNSYLVANIA HIGH ENERGY PHYSICS

TITLE: | DATE:

ENGINEER: | PAGE: 11C

# CAEN DIGITAL COMMS

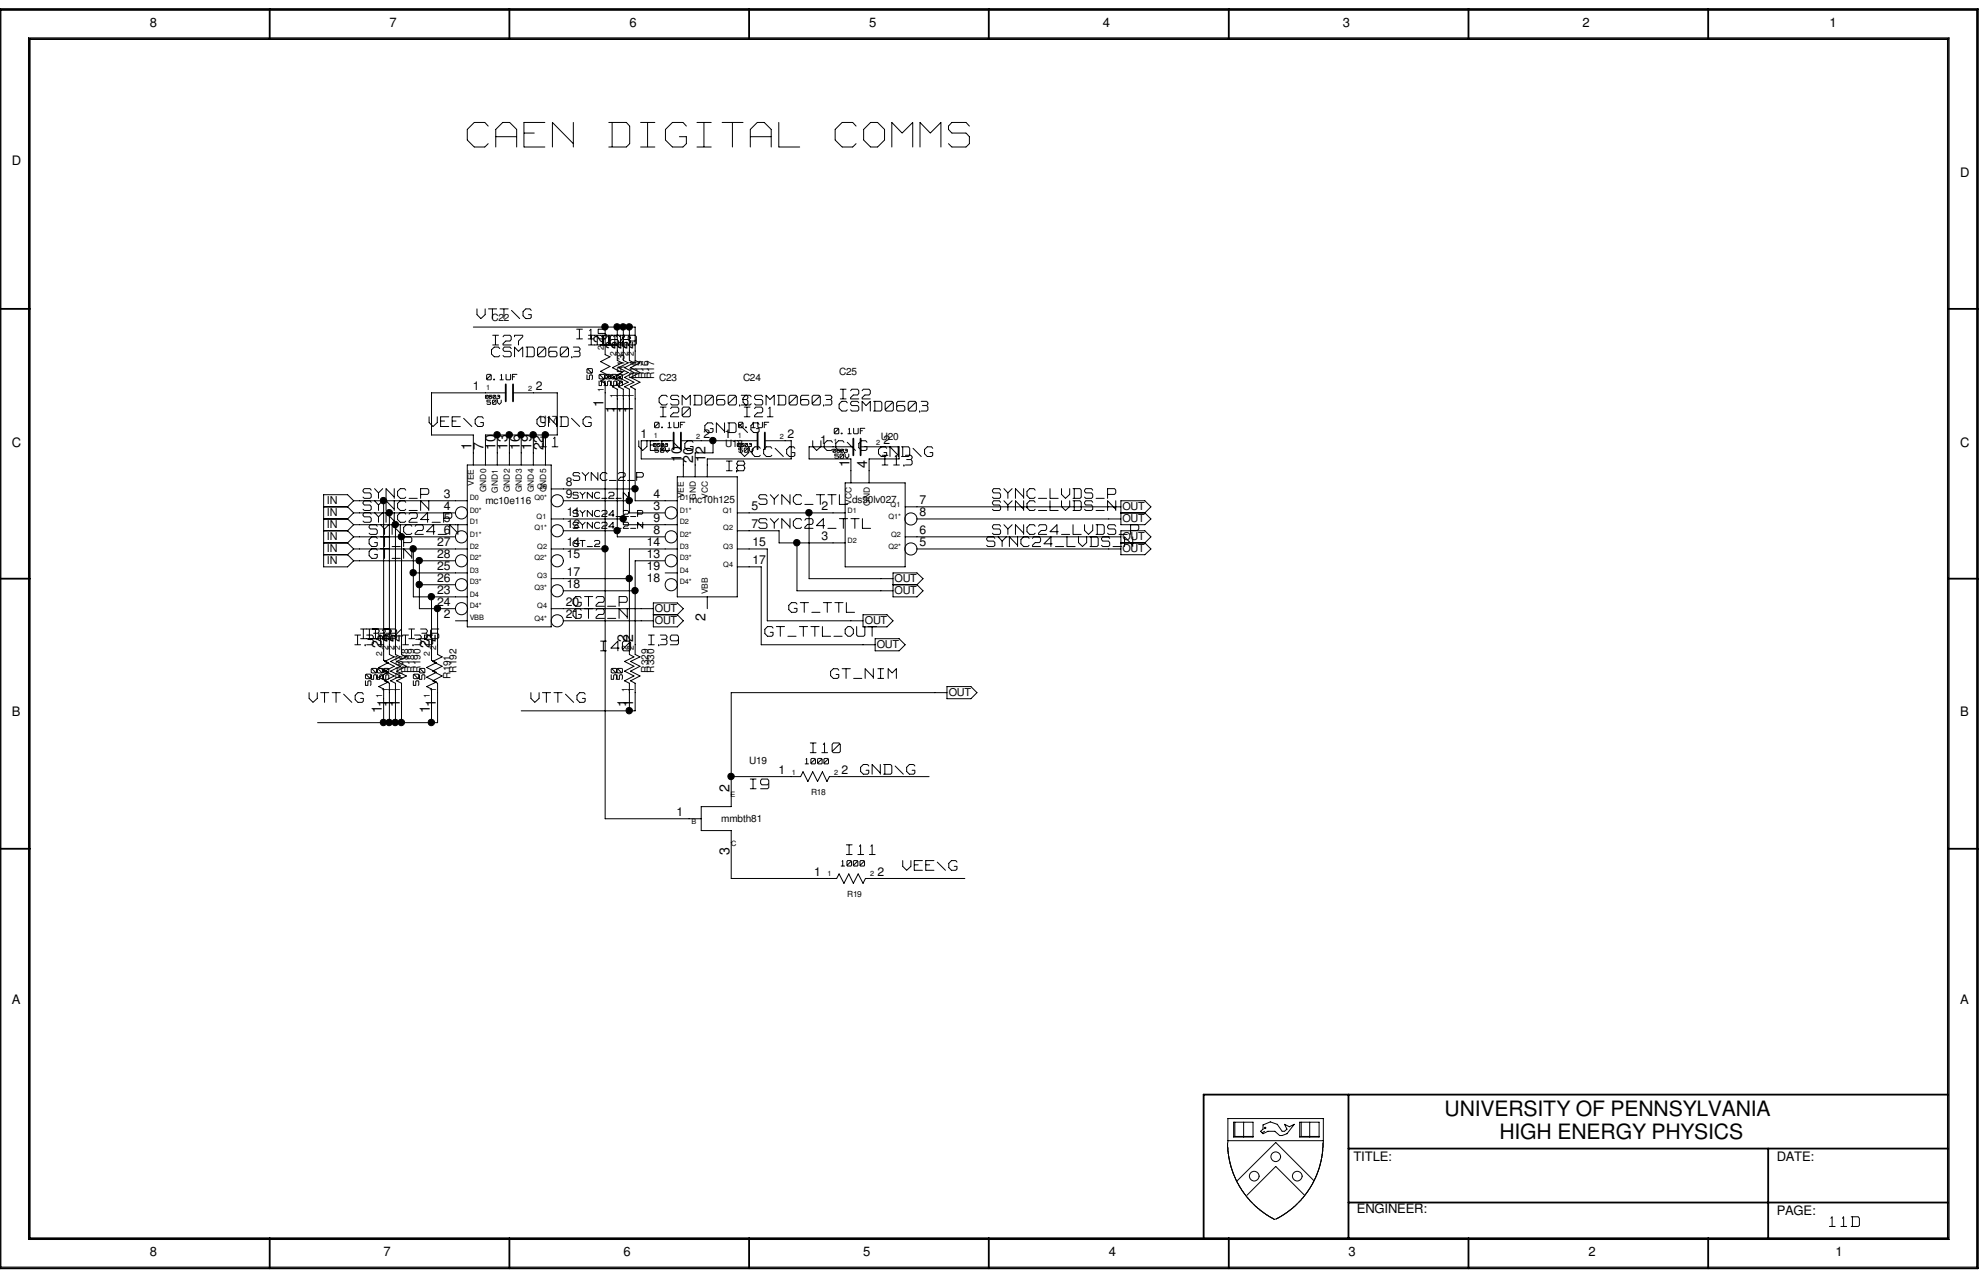
[picture p27: page 23]

UNIVERSITY OF PENNSYLVANIA HIGH ENERGY PHYSICS

TITLE: | DATE:

ENGINEER: | PAGE: 11D

# ELLIE COMMS

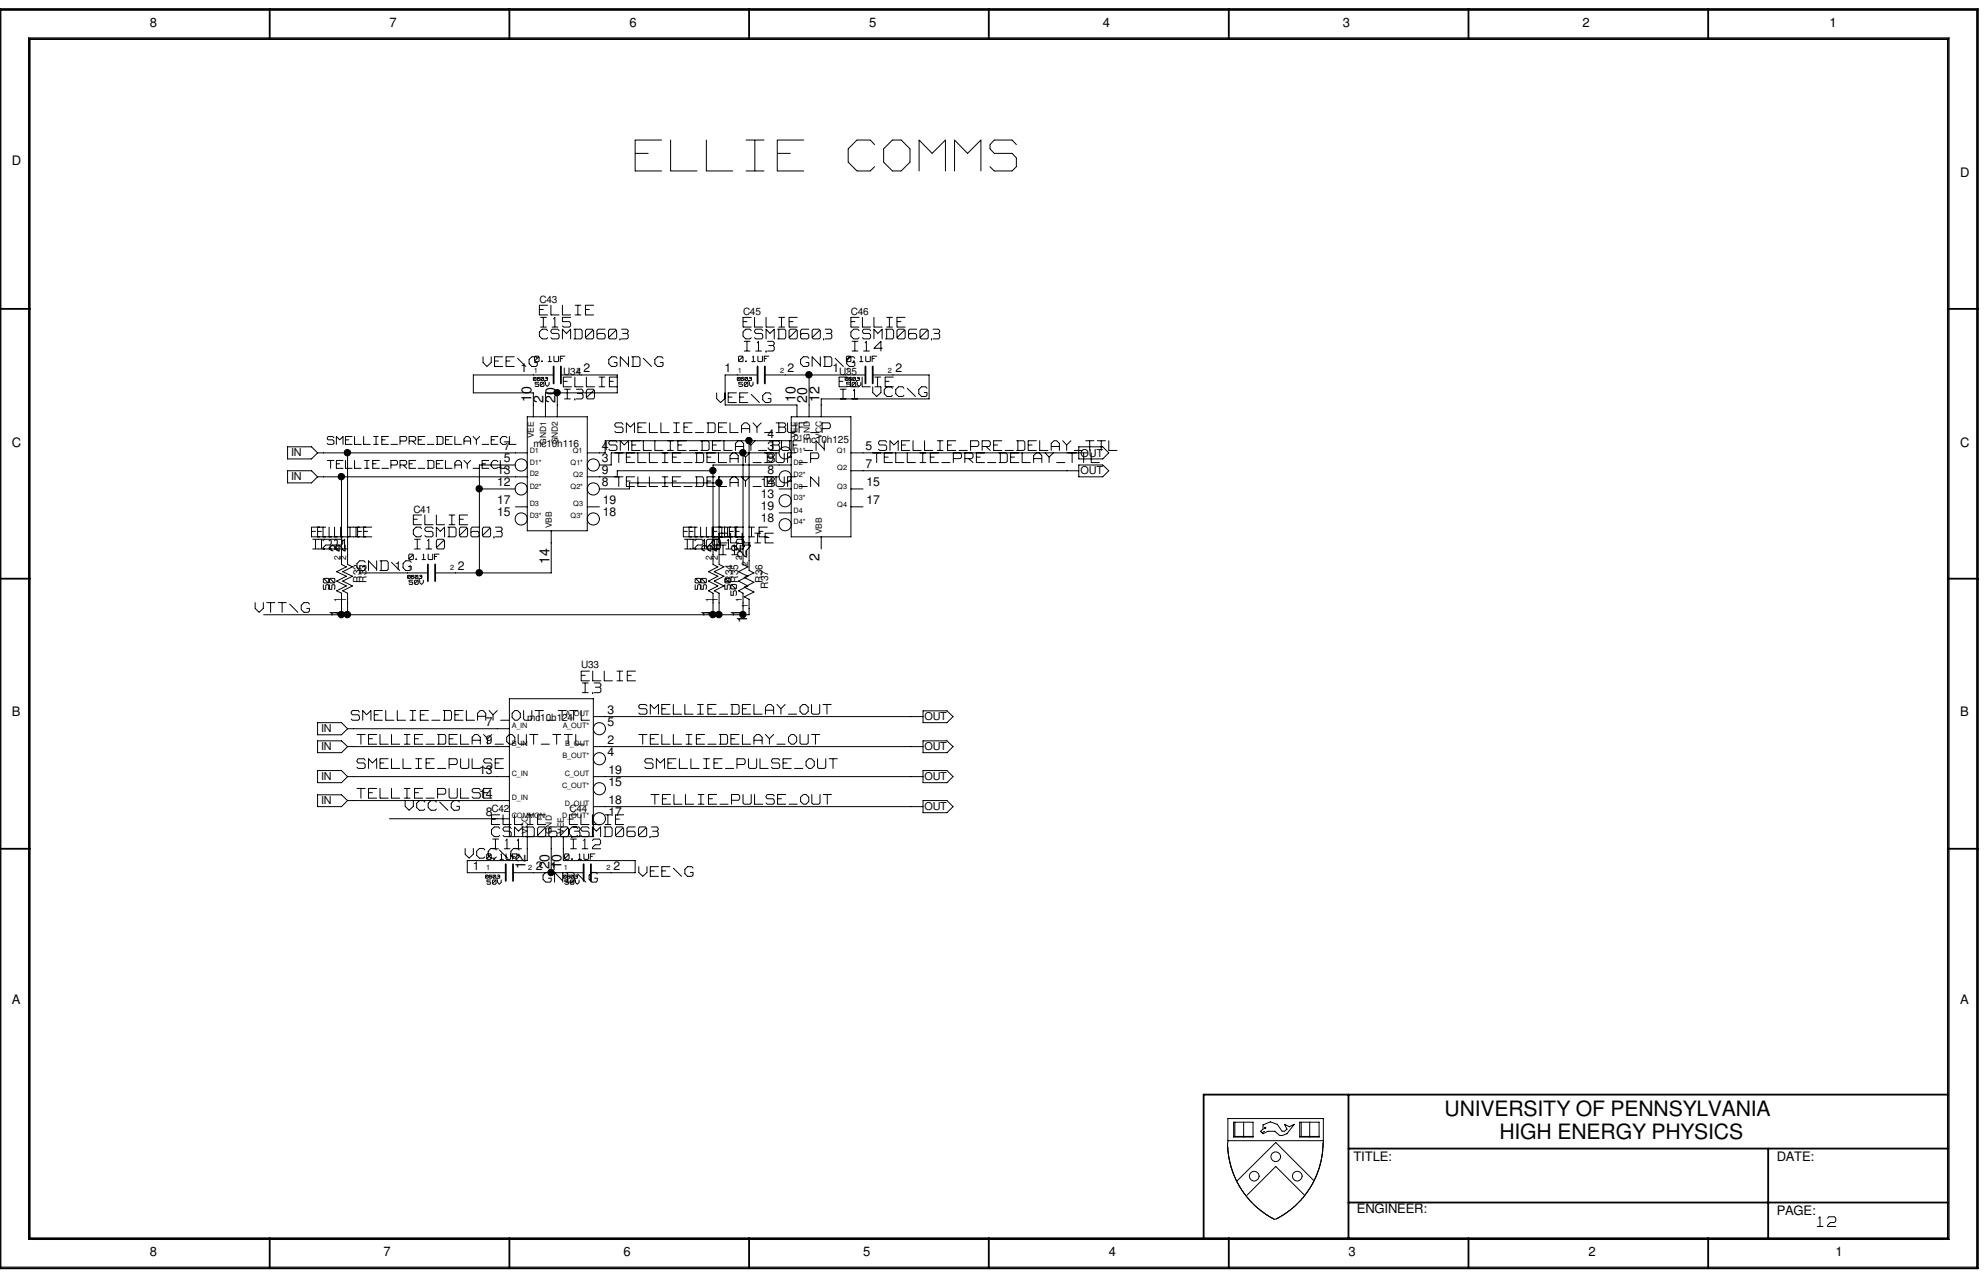
[picture p28: page 24]

UNIVERSITY OF PENNSYLVANIA HIGH ENERGY PHYSICS

TITLE: | DATE:

ENGINEER: | PAGE: 12

# LOCKOUT GENERATION

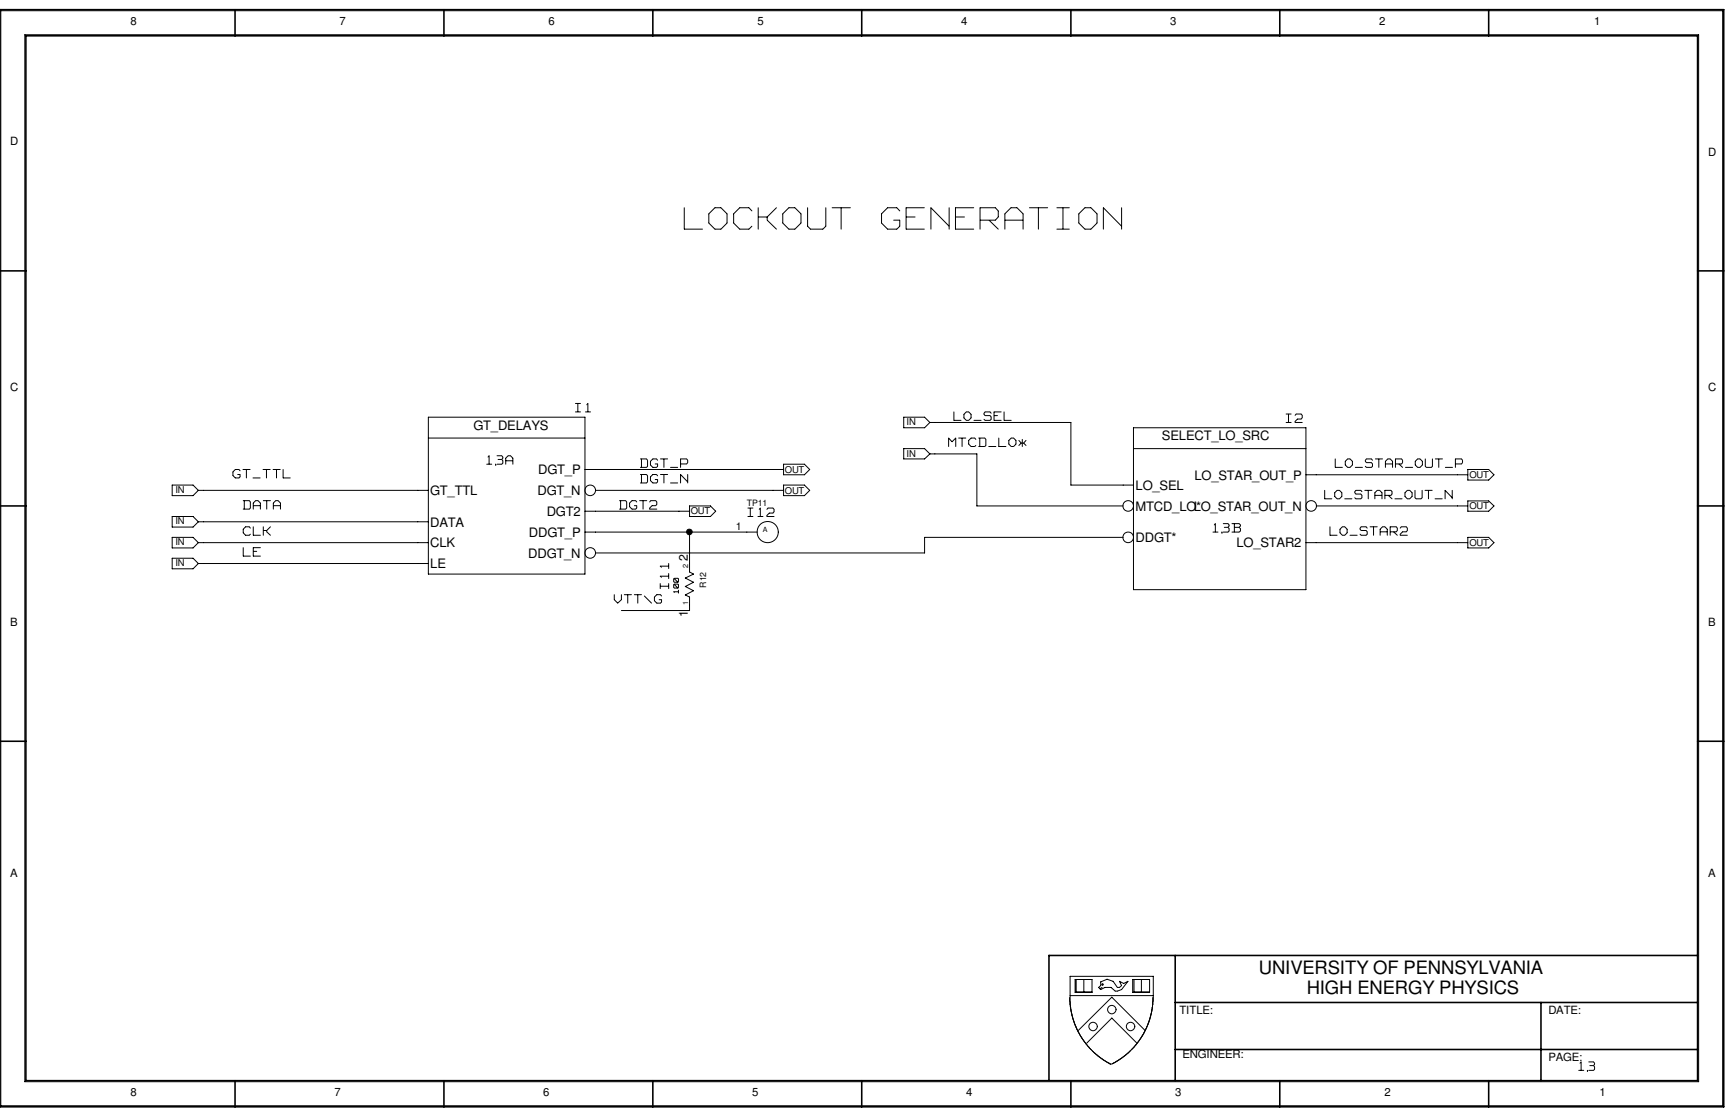
[picture p29: page 25]
CLK; LO_STAR_OUT_N; LO_STAR_OUT_P; LO_STAR2; MTCD_LO*; DGT2; DATA; GT_TTL; DGT_P DGT_N; VTT\G; LO_SEL; OUT; SELECT_LO_SRC; DDGT*; GT_DELAYS; DGT_P; DGT_N; DDGT_P; DDGT_N

UNIVERSITY OF PENNSYLVANIA HIGH ENERGY PHYSICS

TITLE: | DATE:

ENGINEER: | PAGE: 13

# GLOBAL TRIGGER DELAYS

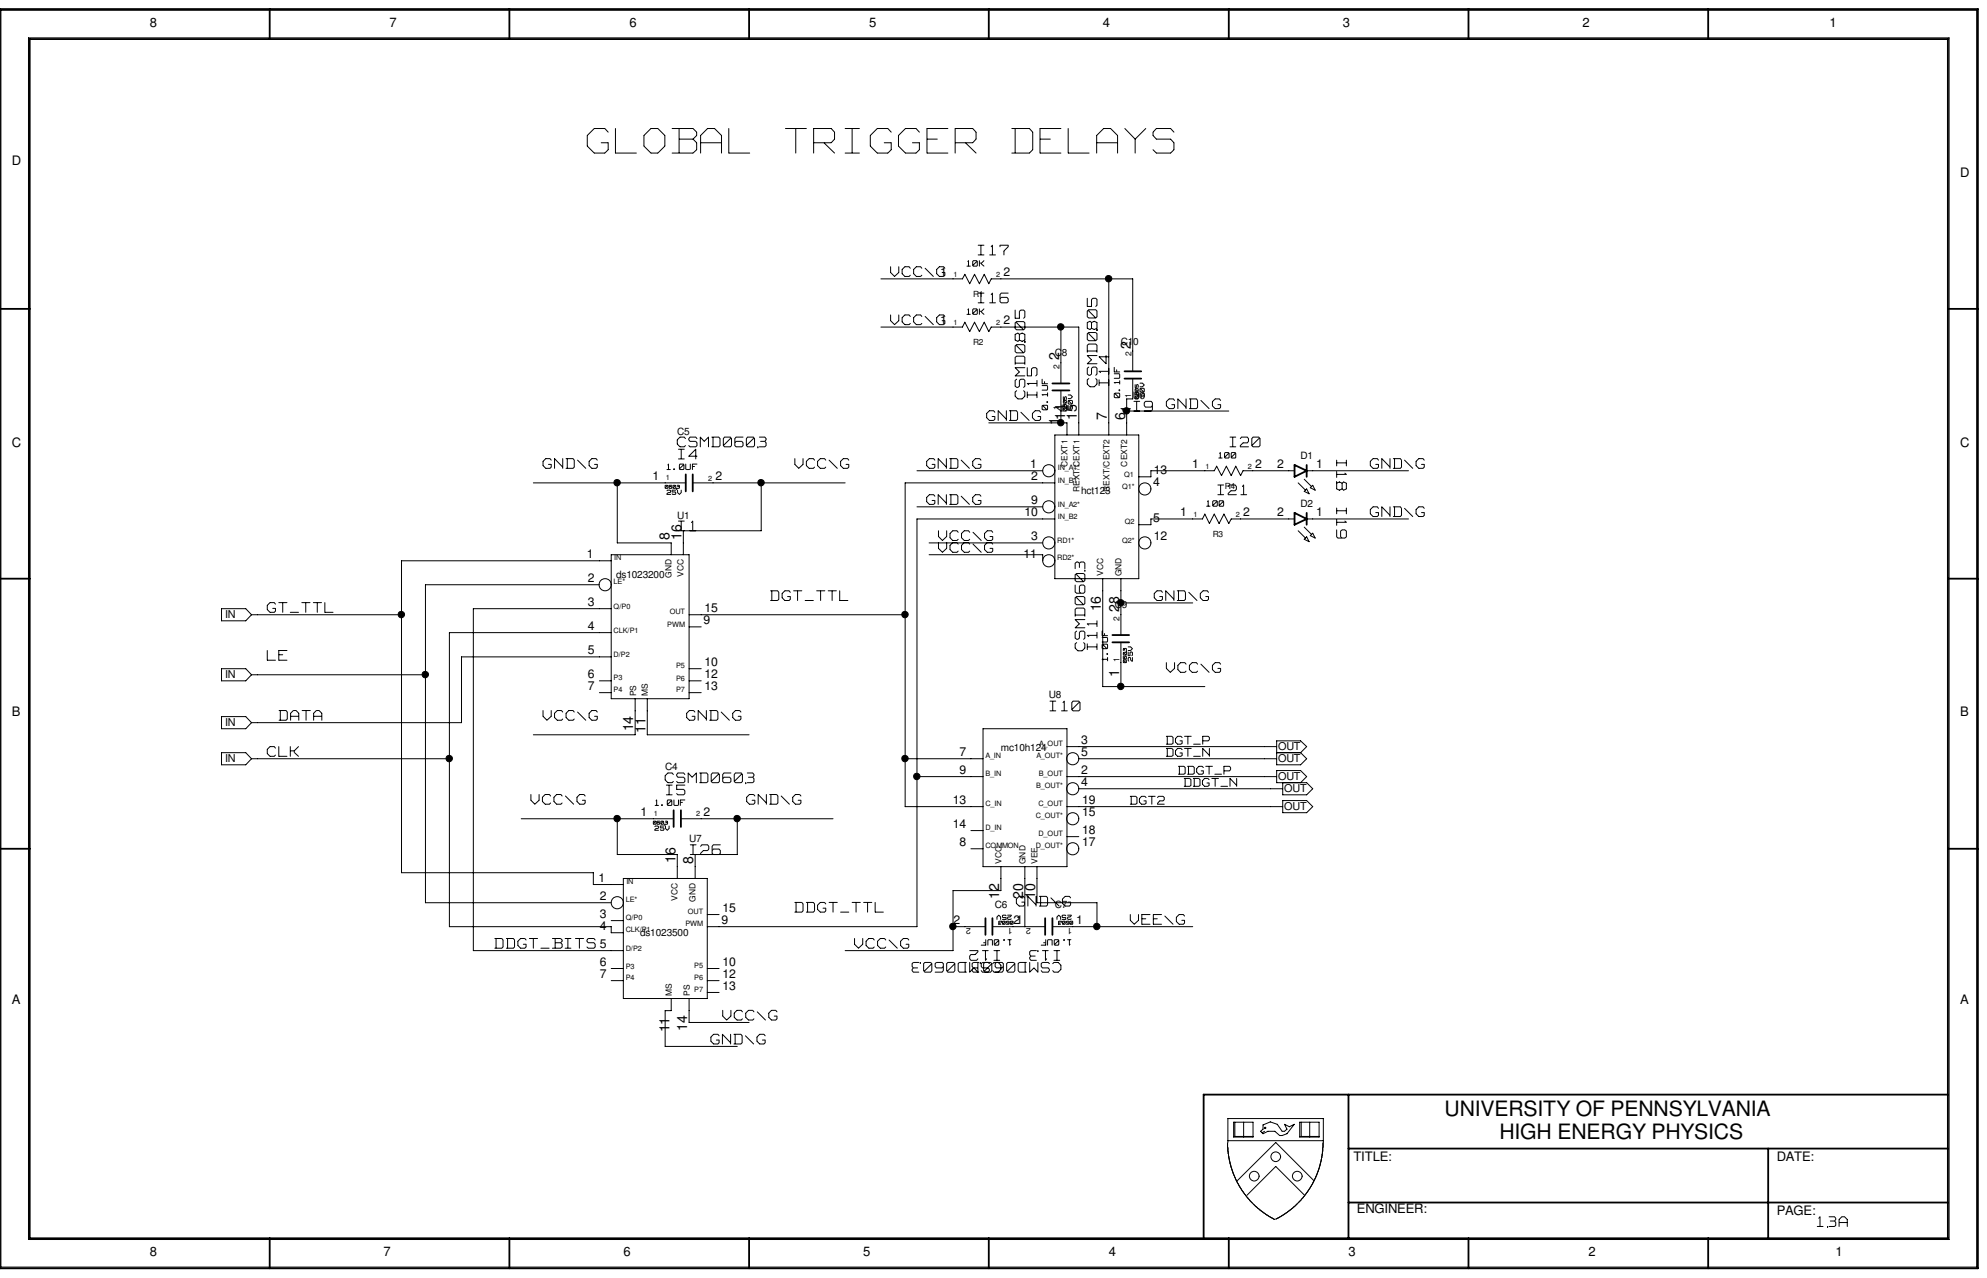
[picture p30: page 26]

# SELECT LOCKOUT SOURCE

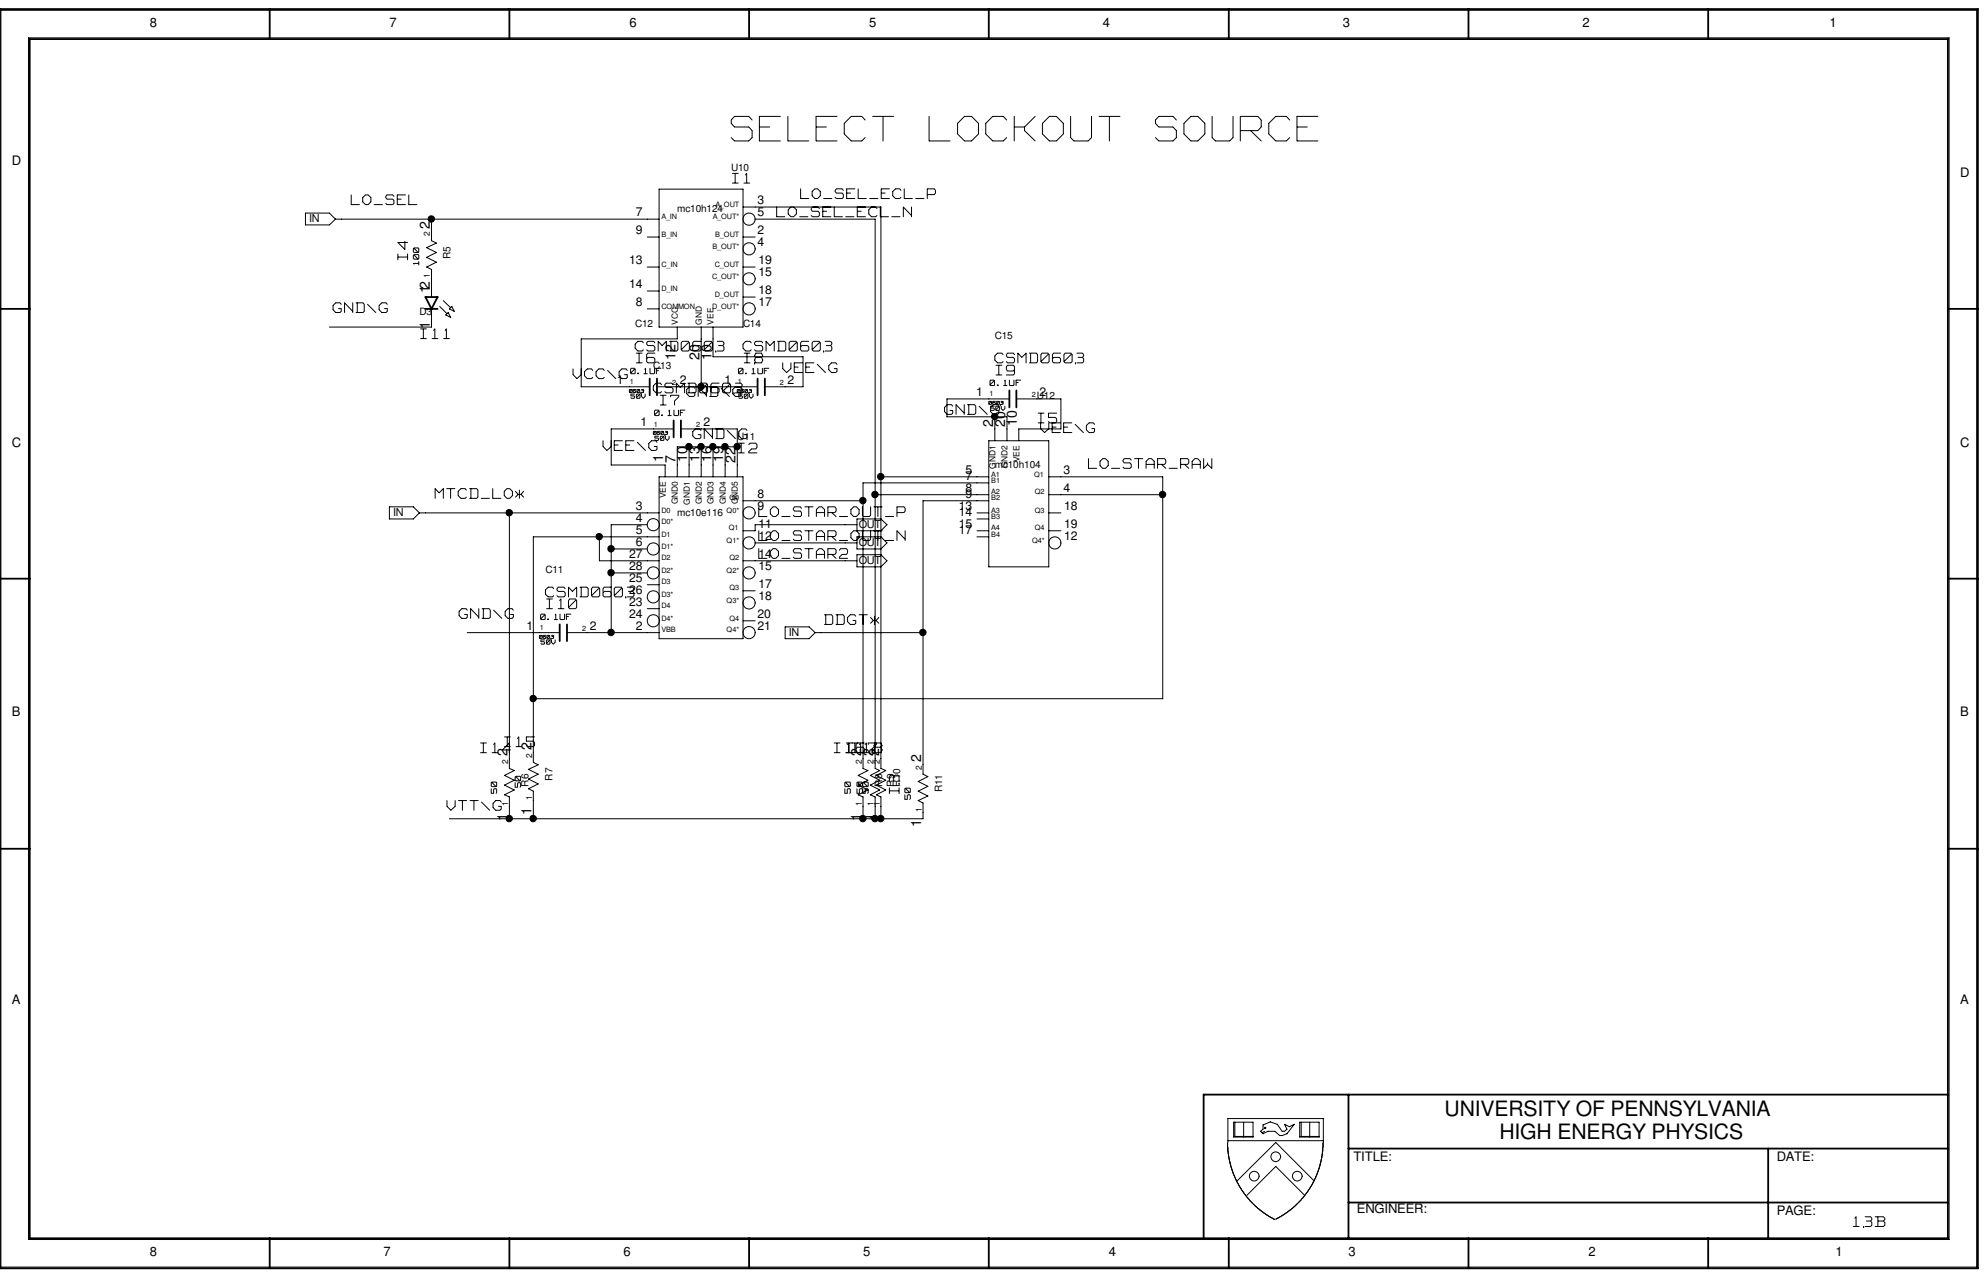
[picture p31: page 27]

# MTCA_MIMIC

AD7243

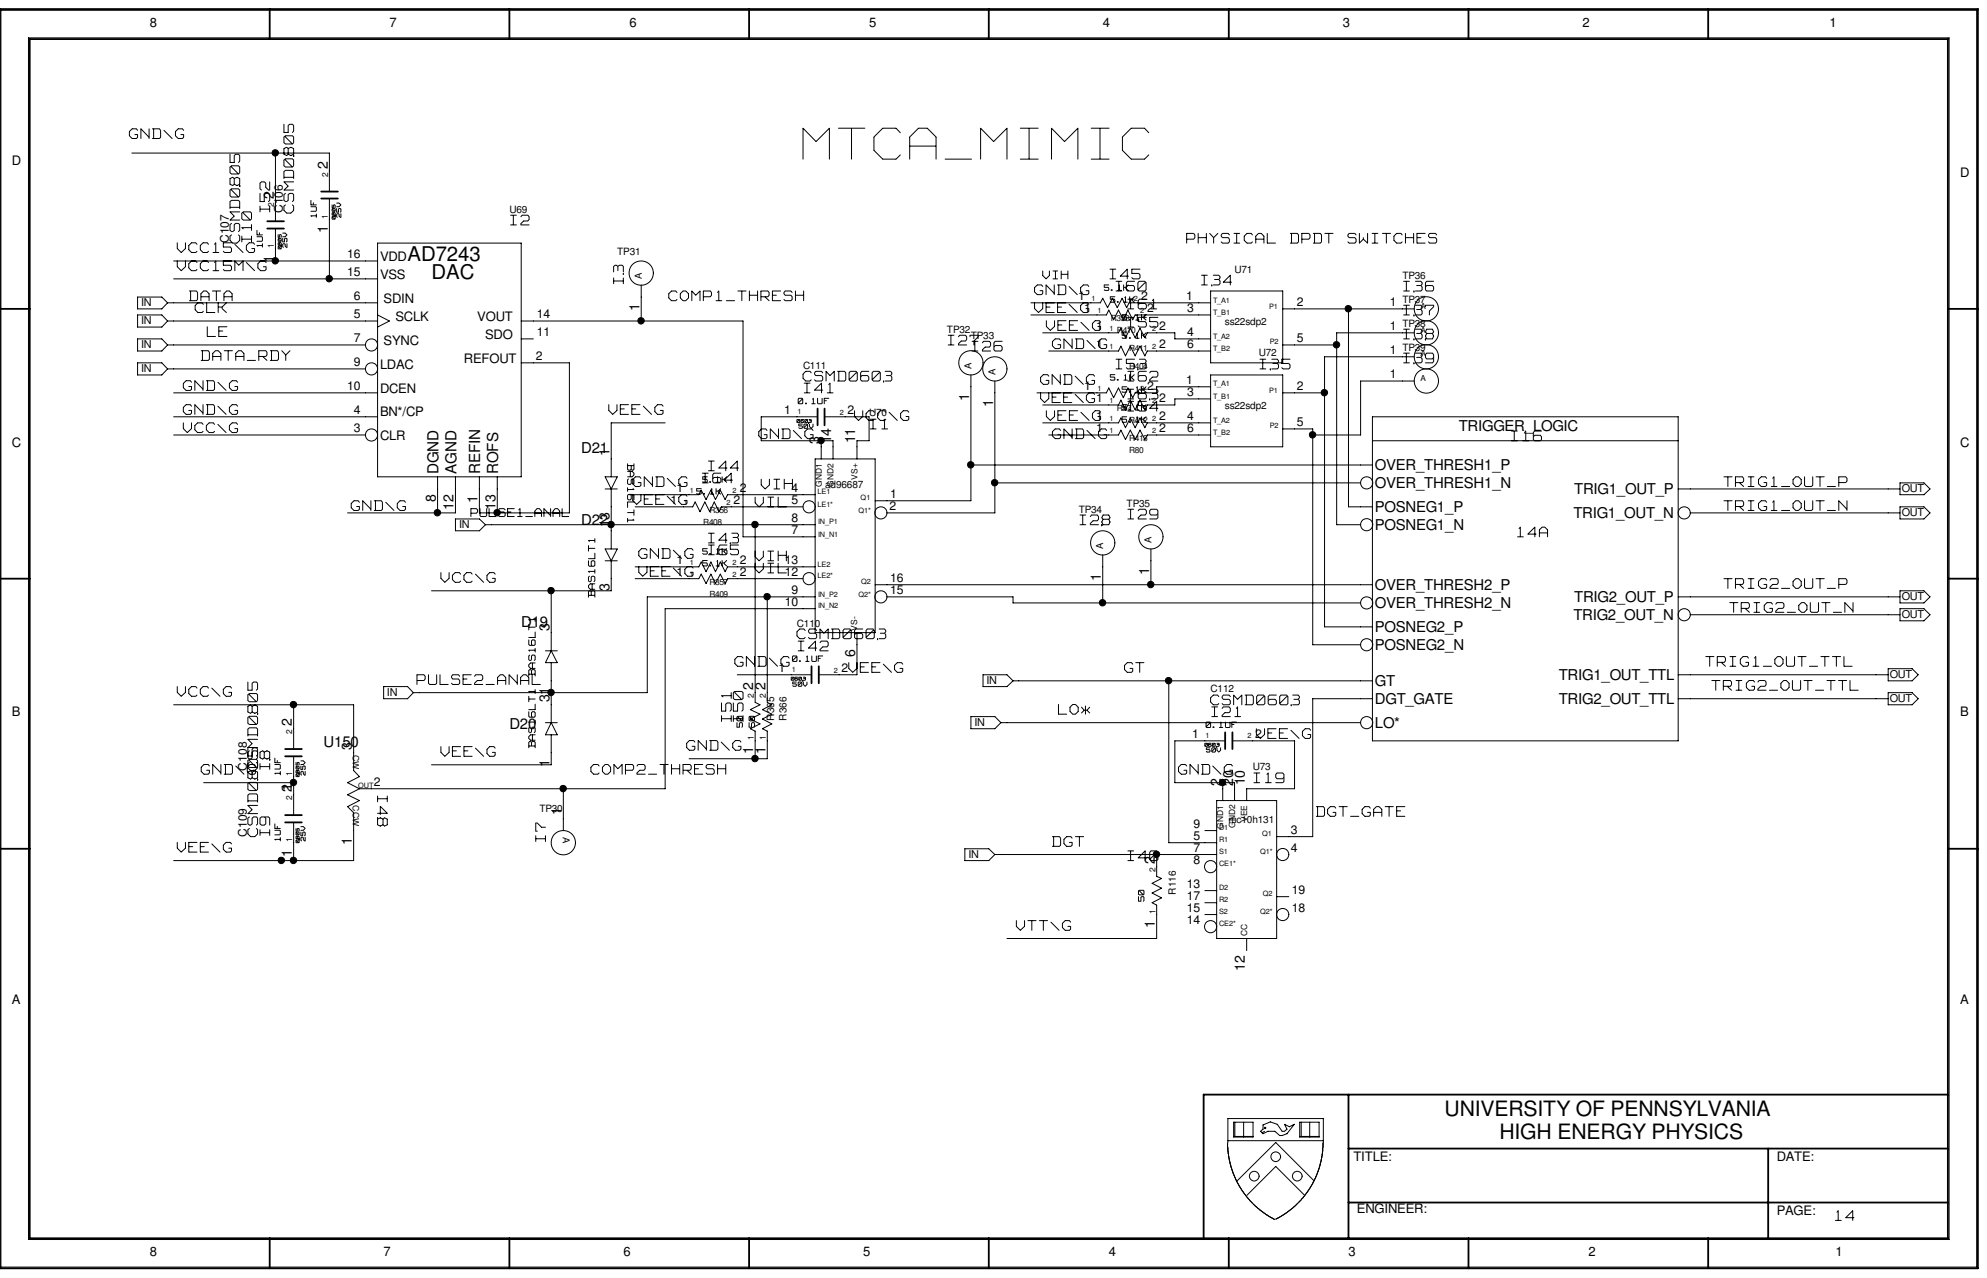
[picture p32: page 28]

UNIVERSITY OF PENNSYLVANIA HIGH ENERGY PHYSICS

TITLE: | DATE:

ENGINEER: | PAGE: 14

# TRIGGER LOGIC

# MTCA_MIMIC

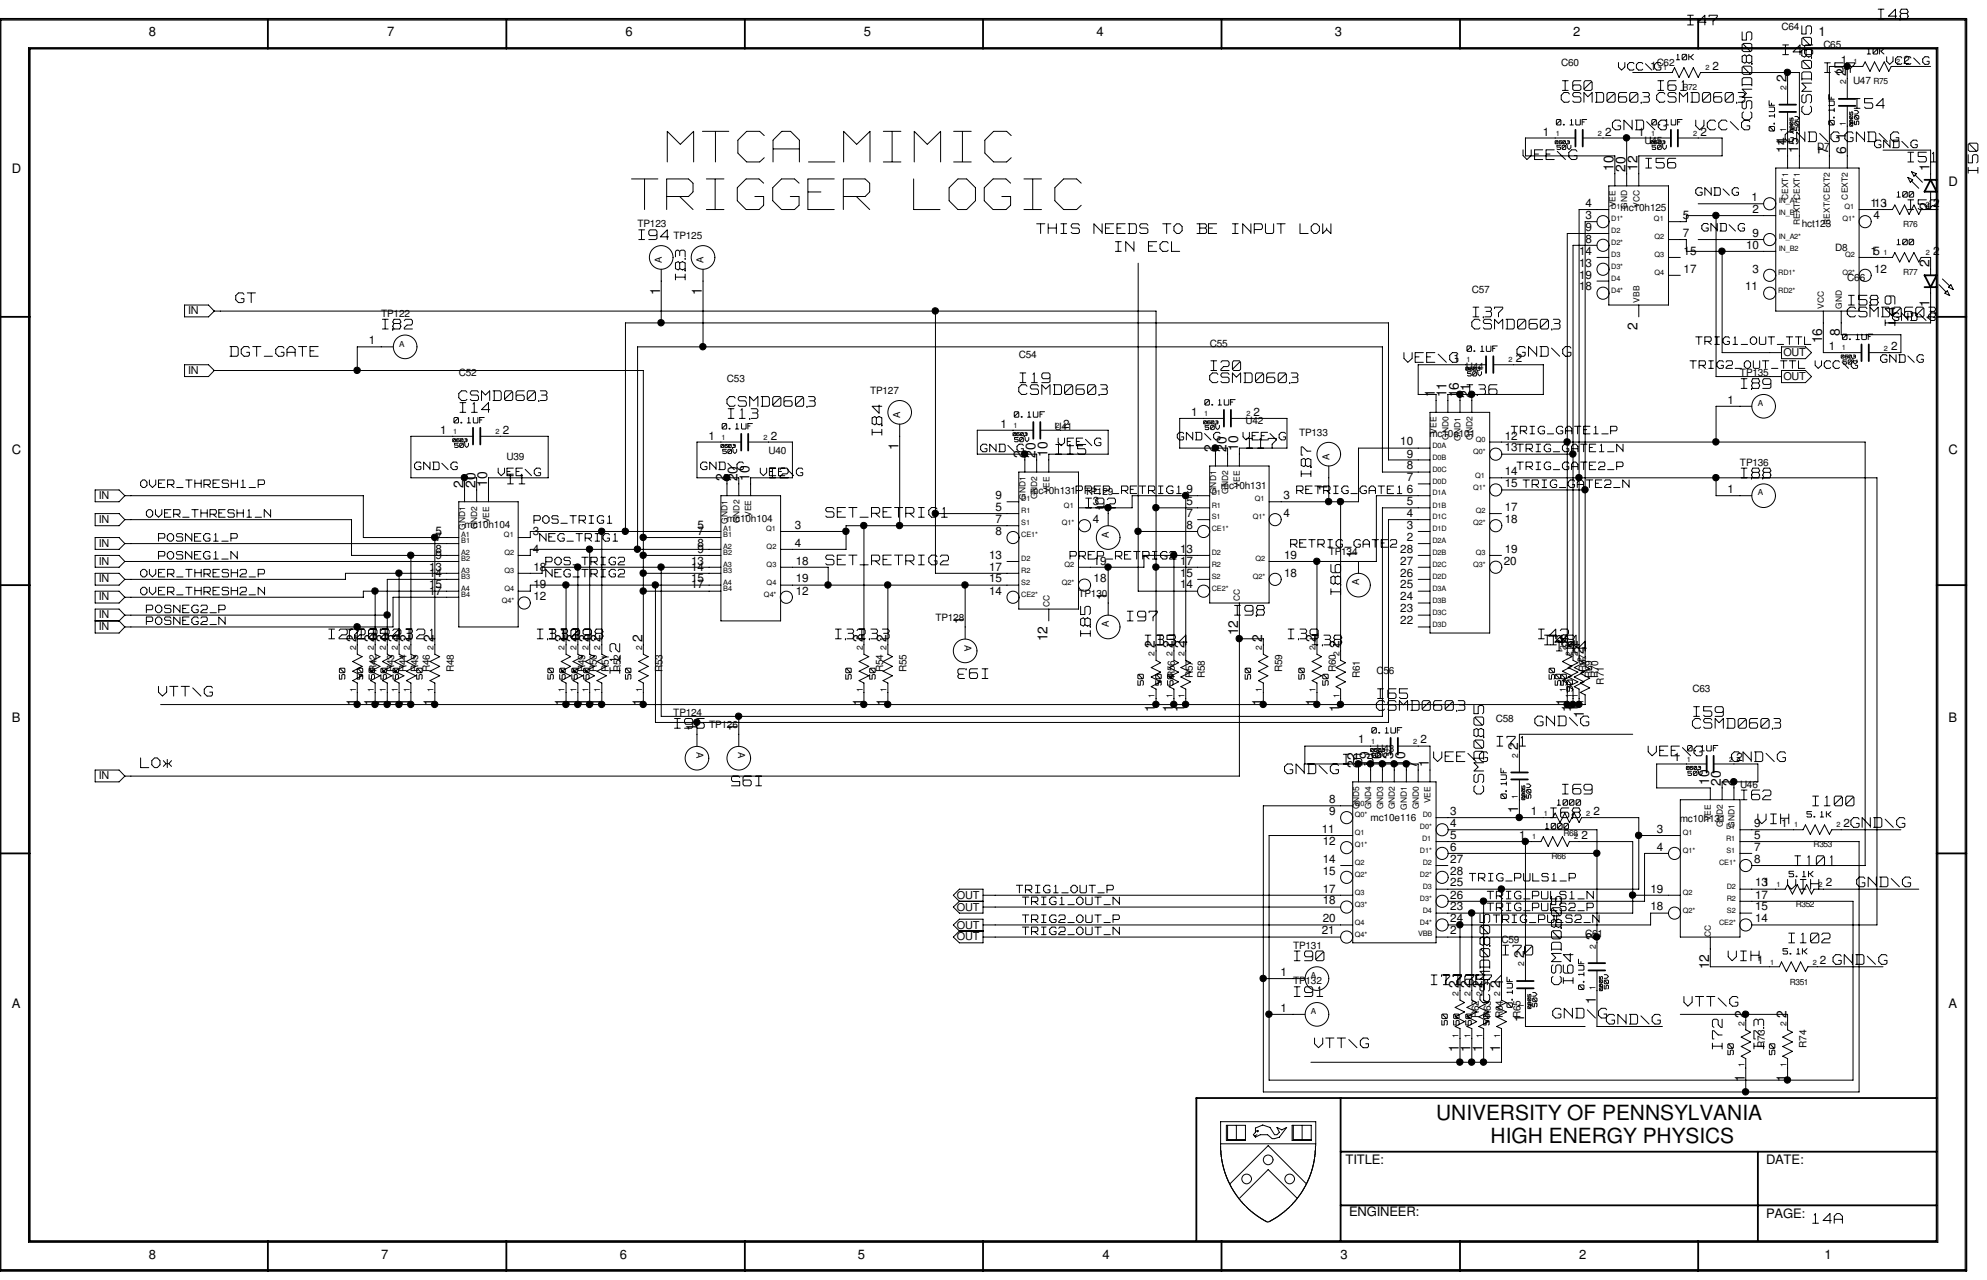
[picture p33: page 29]

THIS NEEDS TO BE INPUT LOW

# EXTERNAL TRIGGERS IN

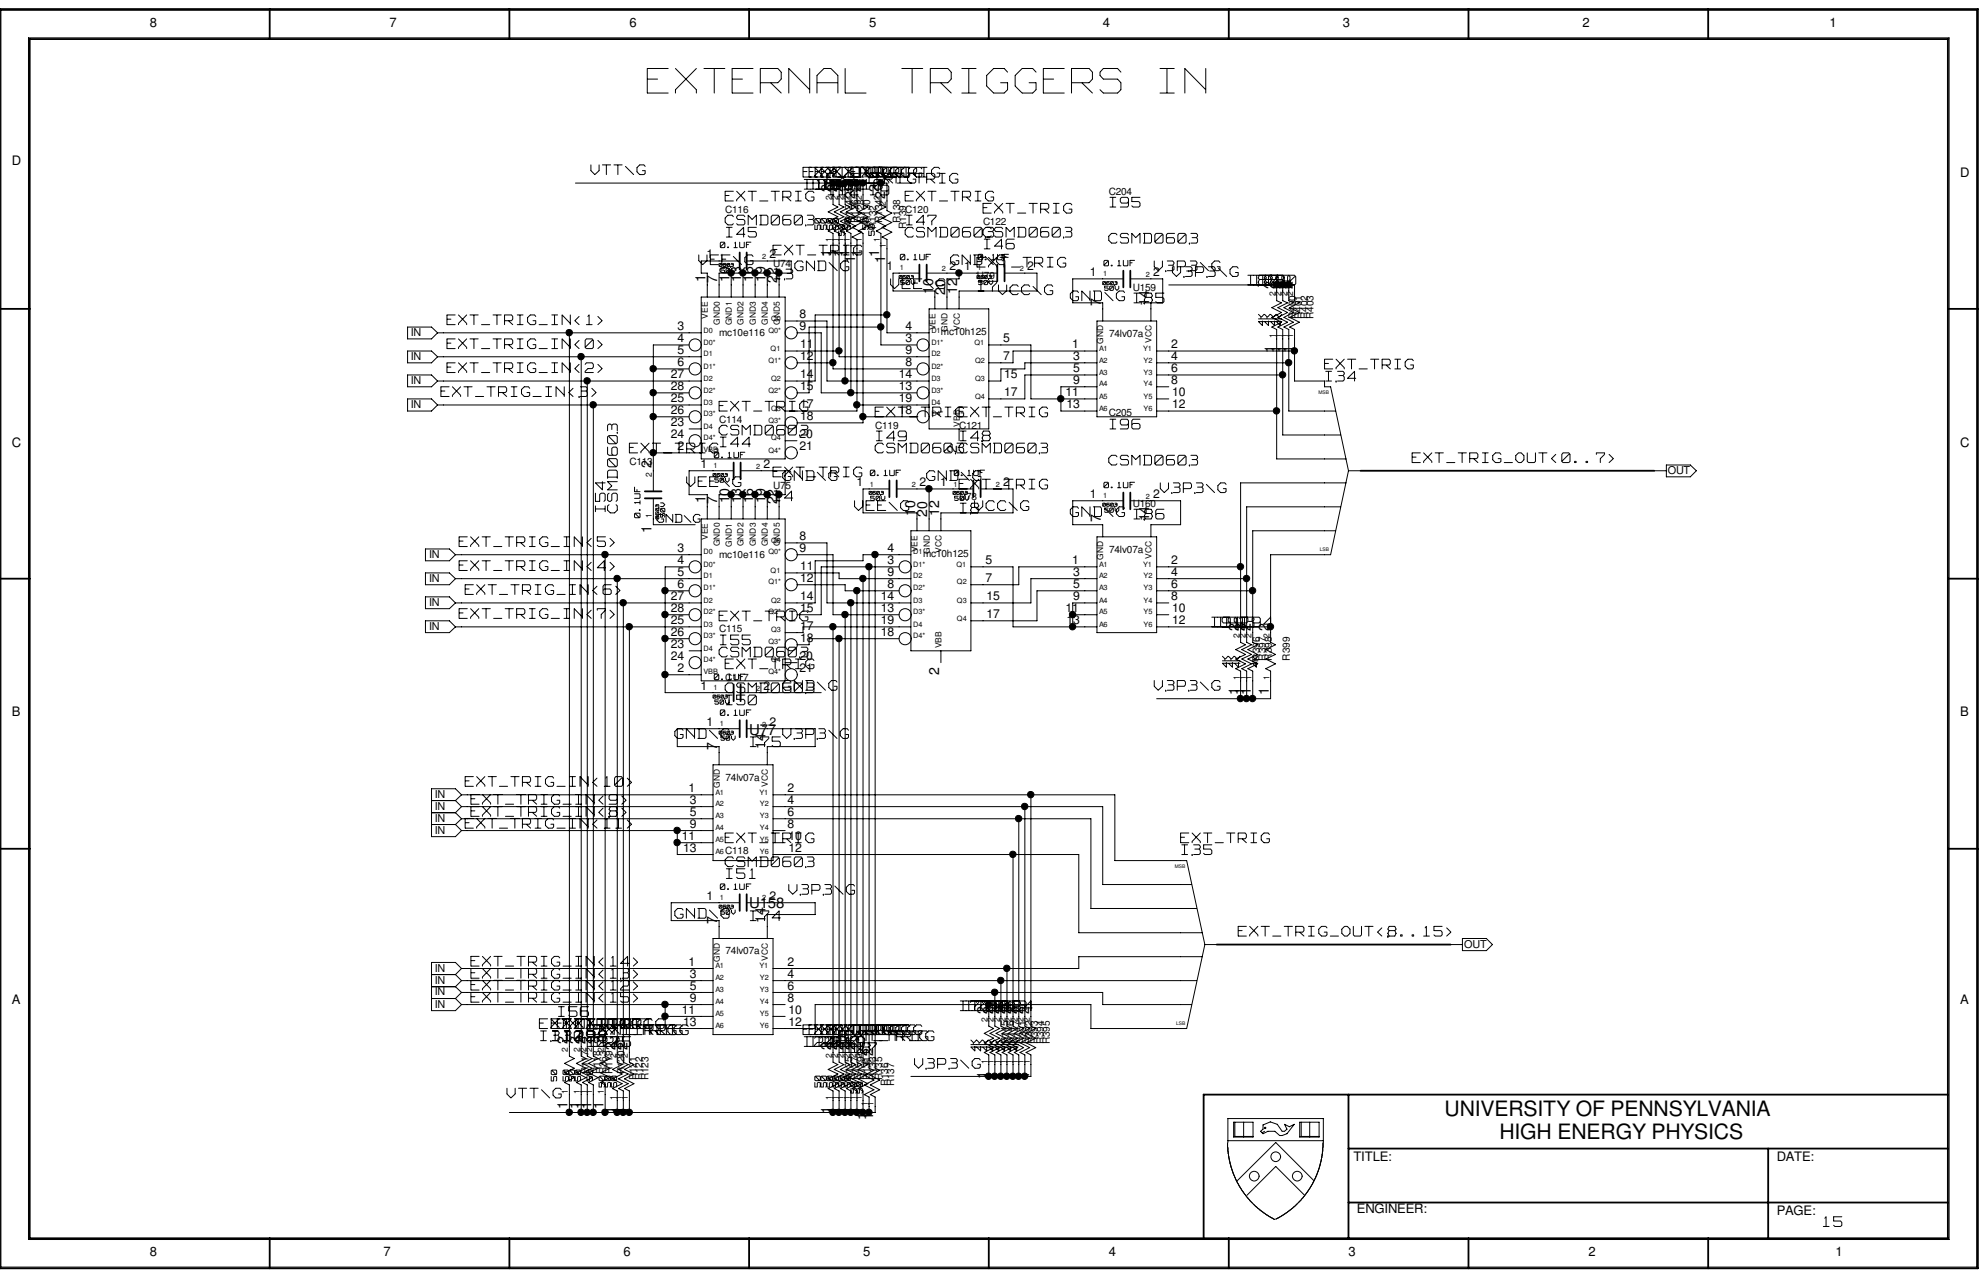
[picture p34: page 30]

UNIVERSITY OF PENNSYLVANIA HIGH ENERGY PHYSICS

TITLE: | DATE:

ENGINEER: | PAGE: 15

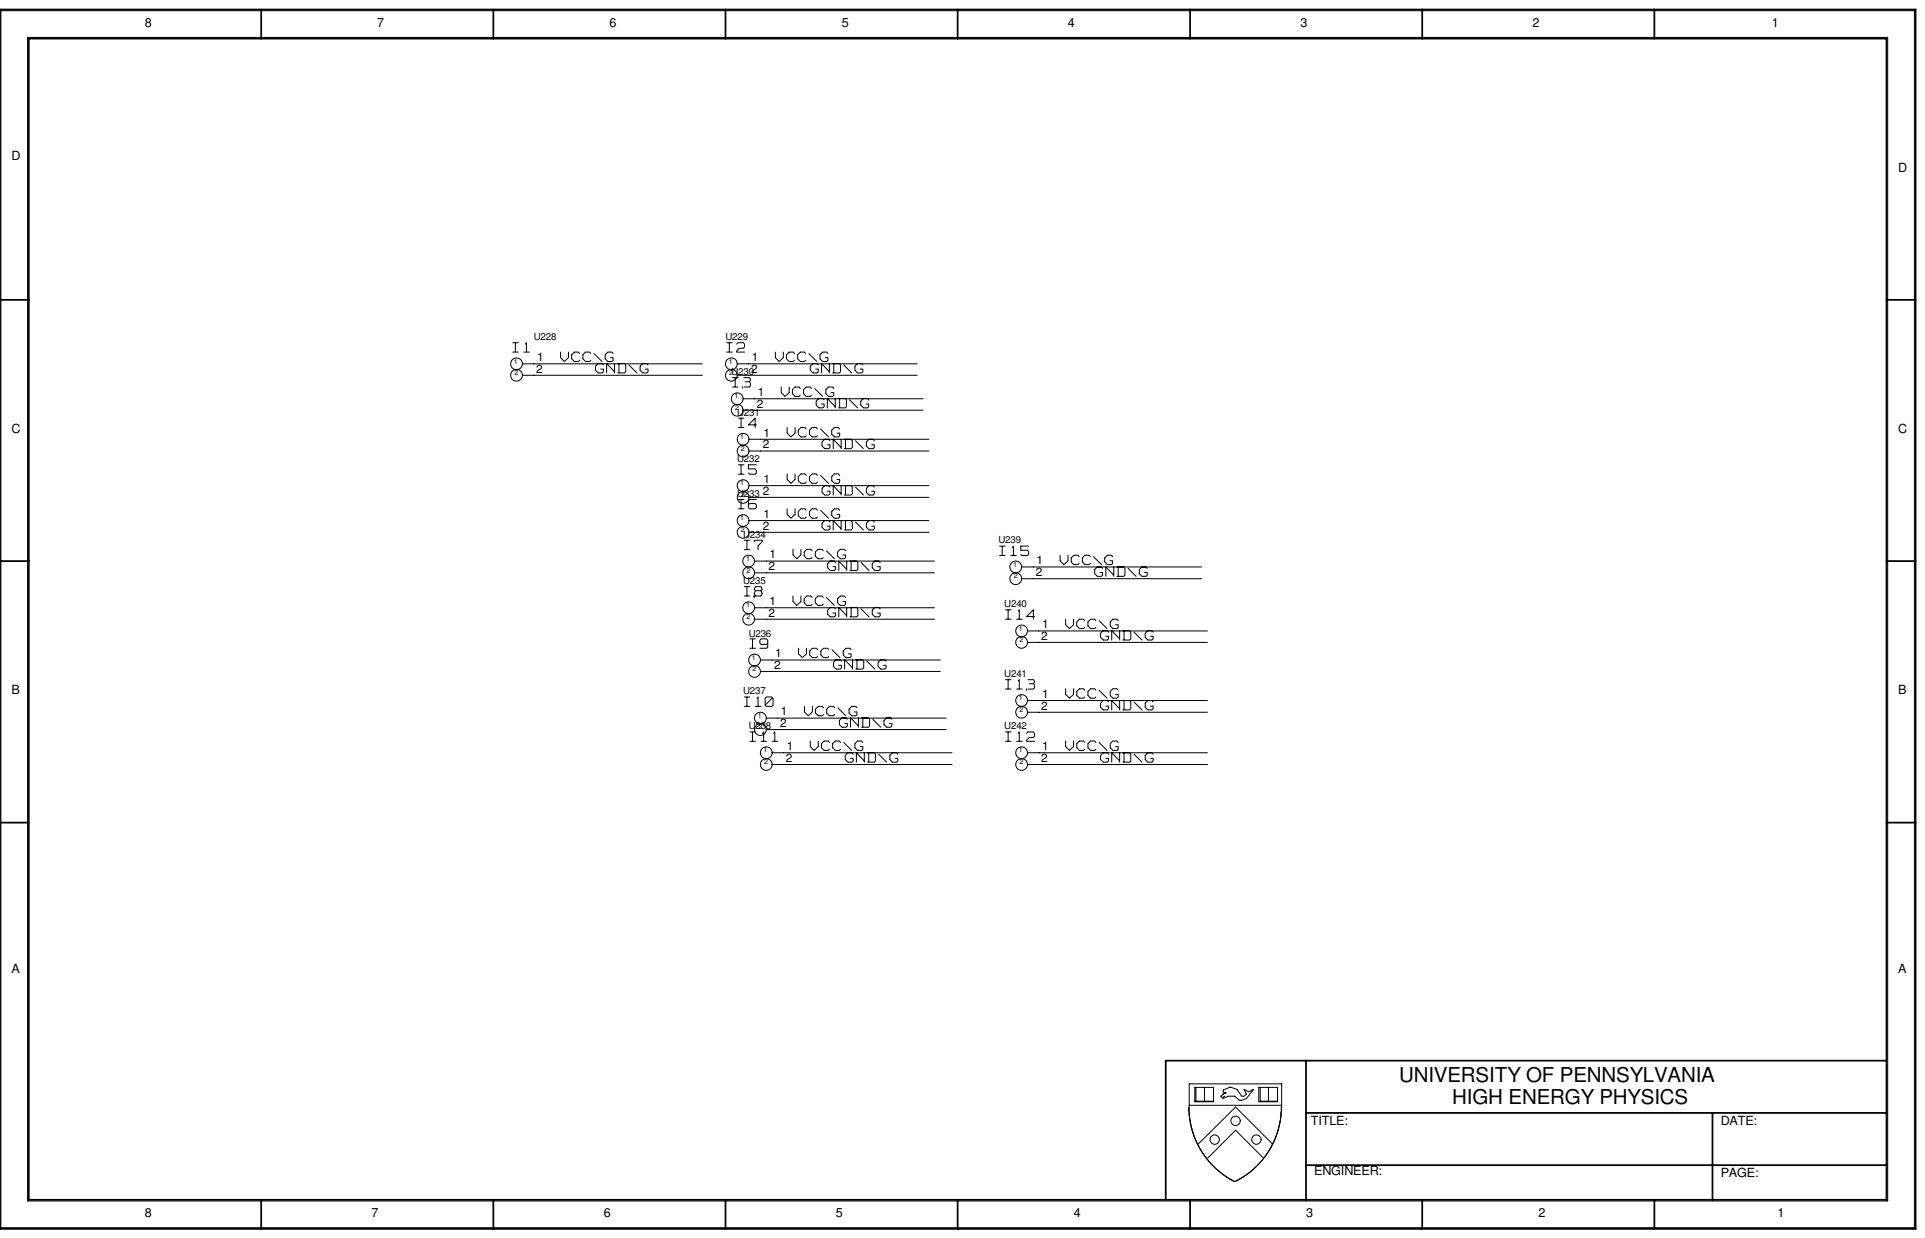
[picture p35: page 31]

UNIVERSITY OF PENNSYLVANIA HIGH ENERGY PHYSICS

TITLE: | DATE:

ENGINEER: | PAGE:

# FRONT PORTS

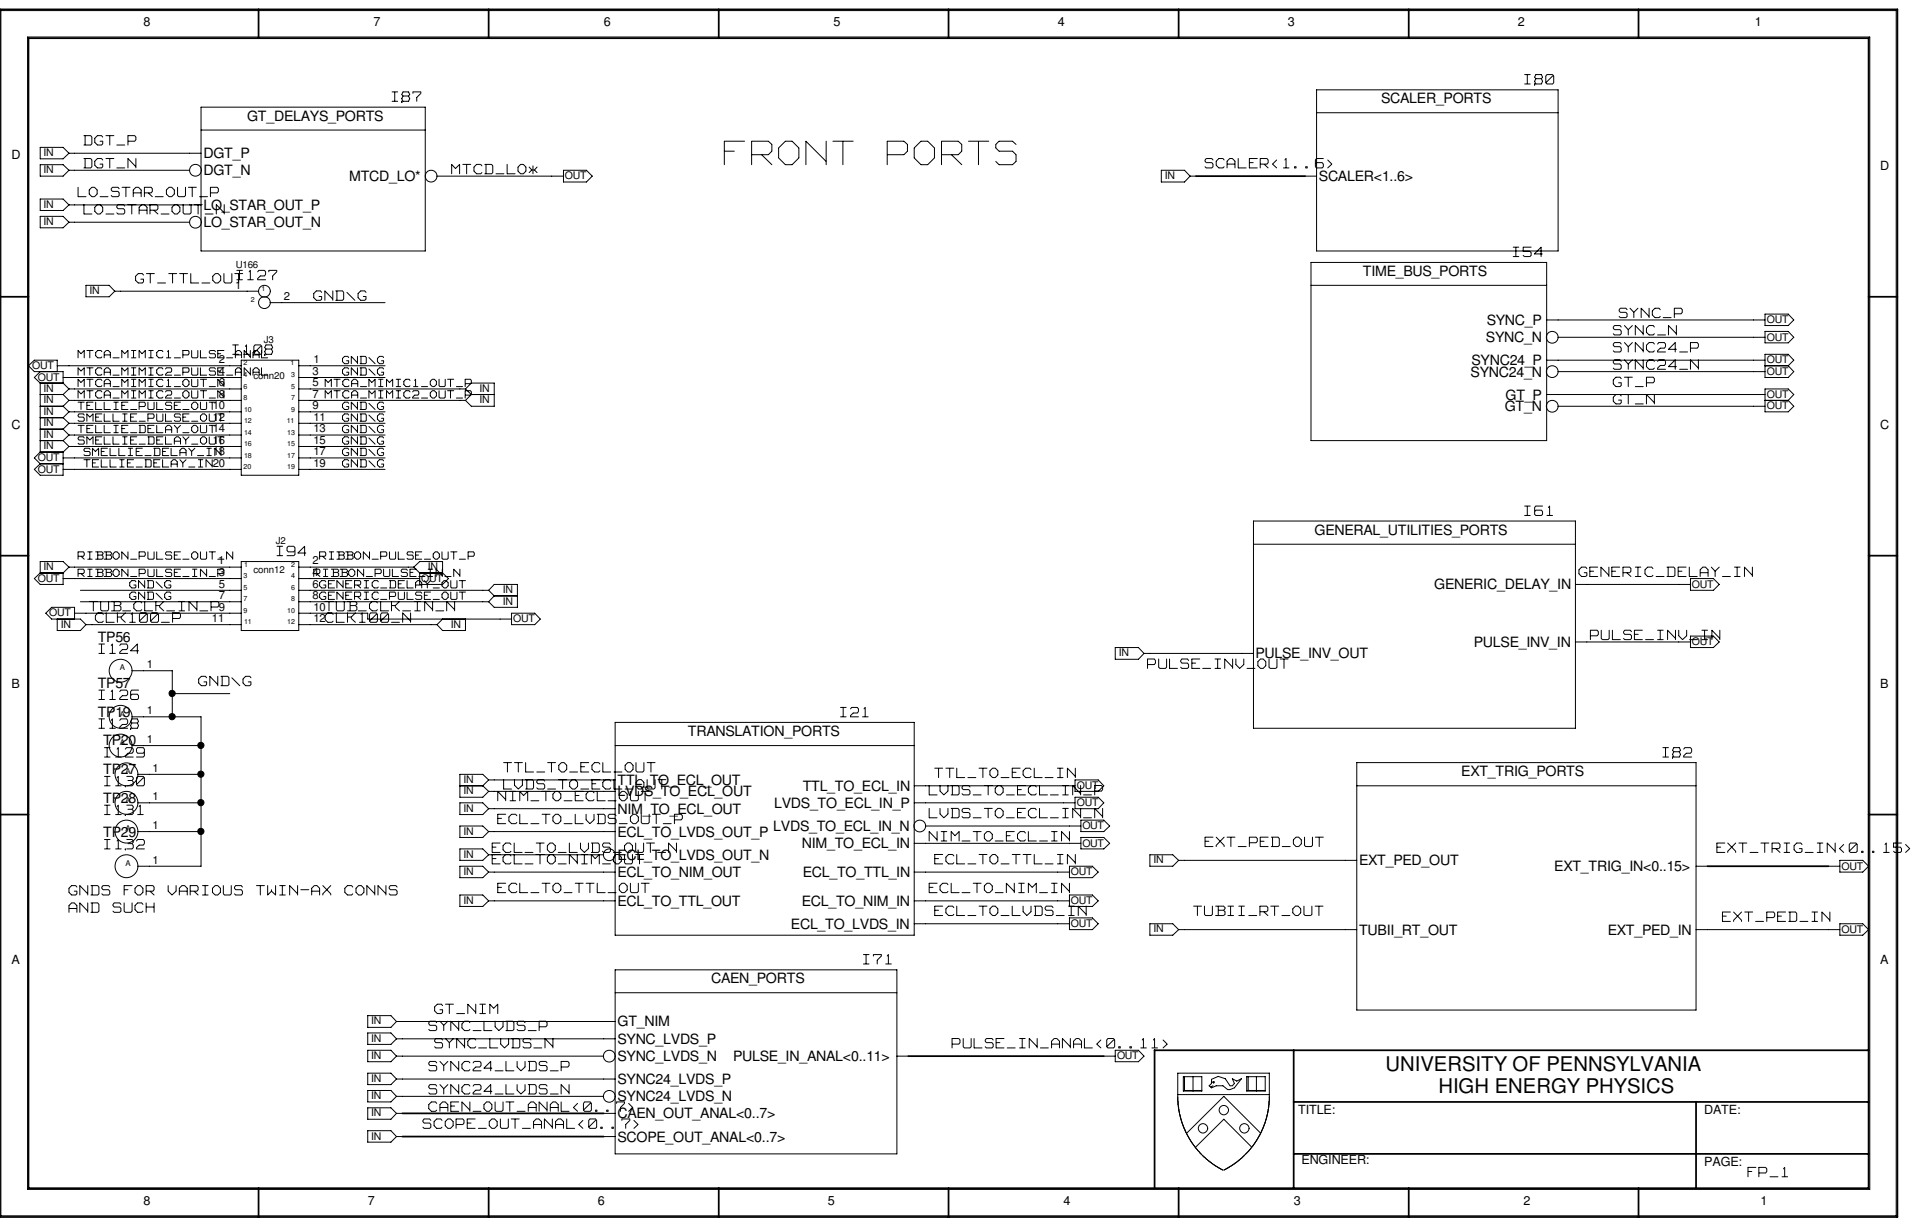
[picture p36: page 32]

GNDS FOR VARIOUS TWIN-AX CONNS
AND SUCH

UNIVERSITY OF PENNSYLVANIA HIGH ENERGY PHYSICS

TITLE: | DATE:

ENGINEER: | PAGE: FP_1

# TRANSLATION PORTS

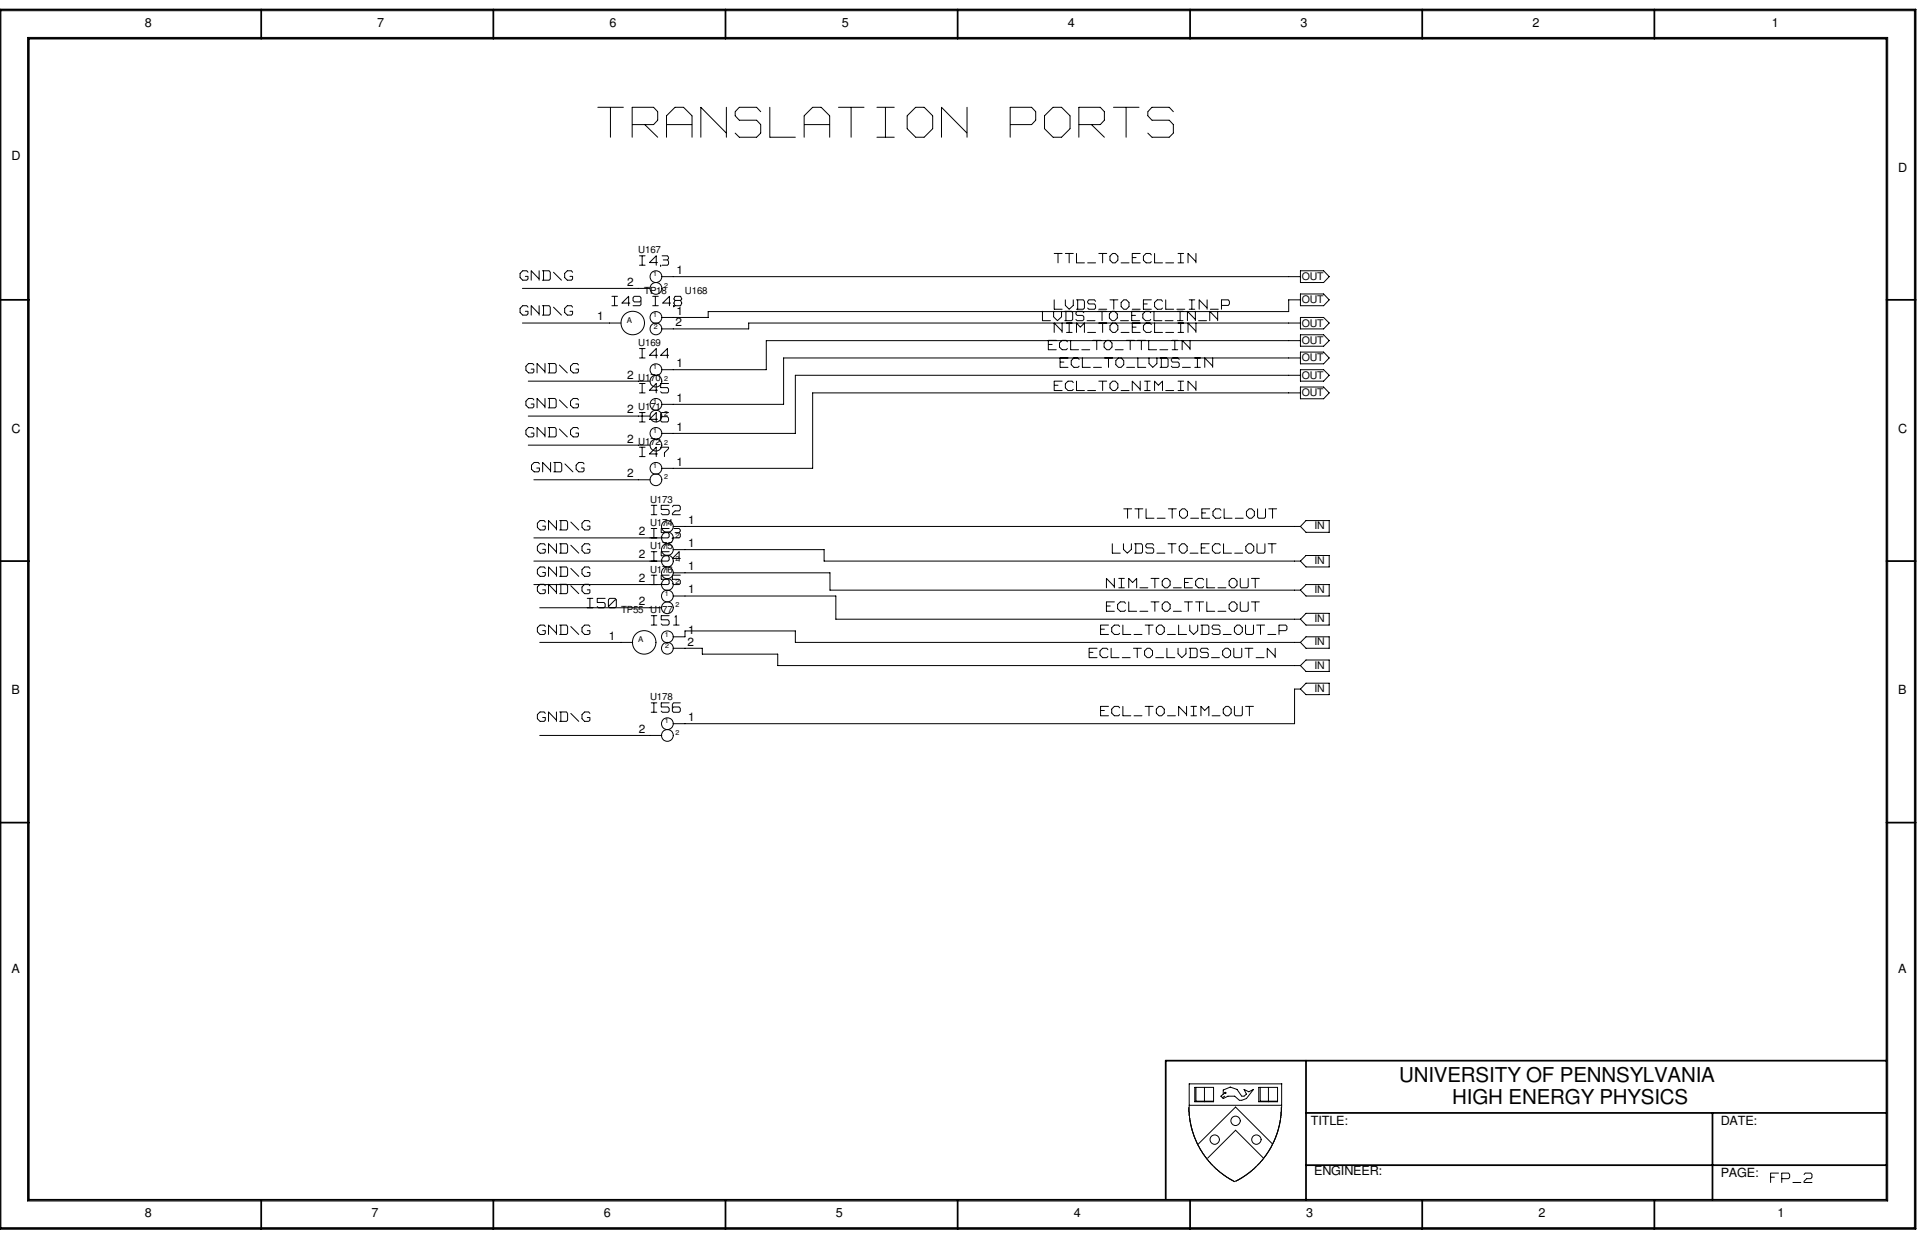
[picture p37: page 33]

UNIVERSITY OF PENNSYLVANIA HIGH ENERGY PHYSICS

TITLE: | DATE:

ENGINEER: | PAGE: FP_2

# TIME BUS PORTS

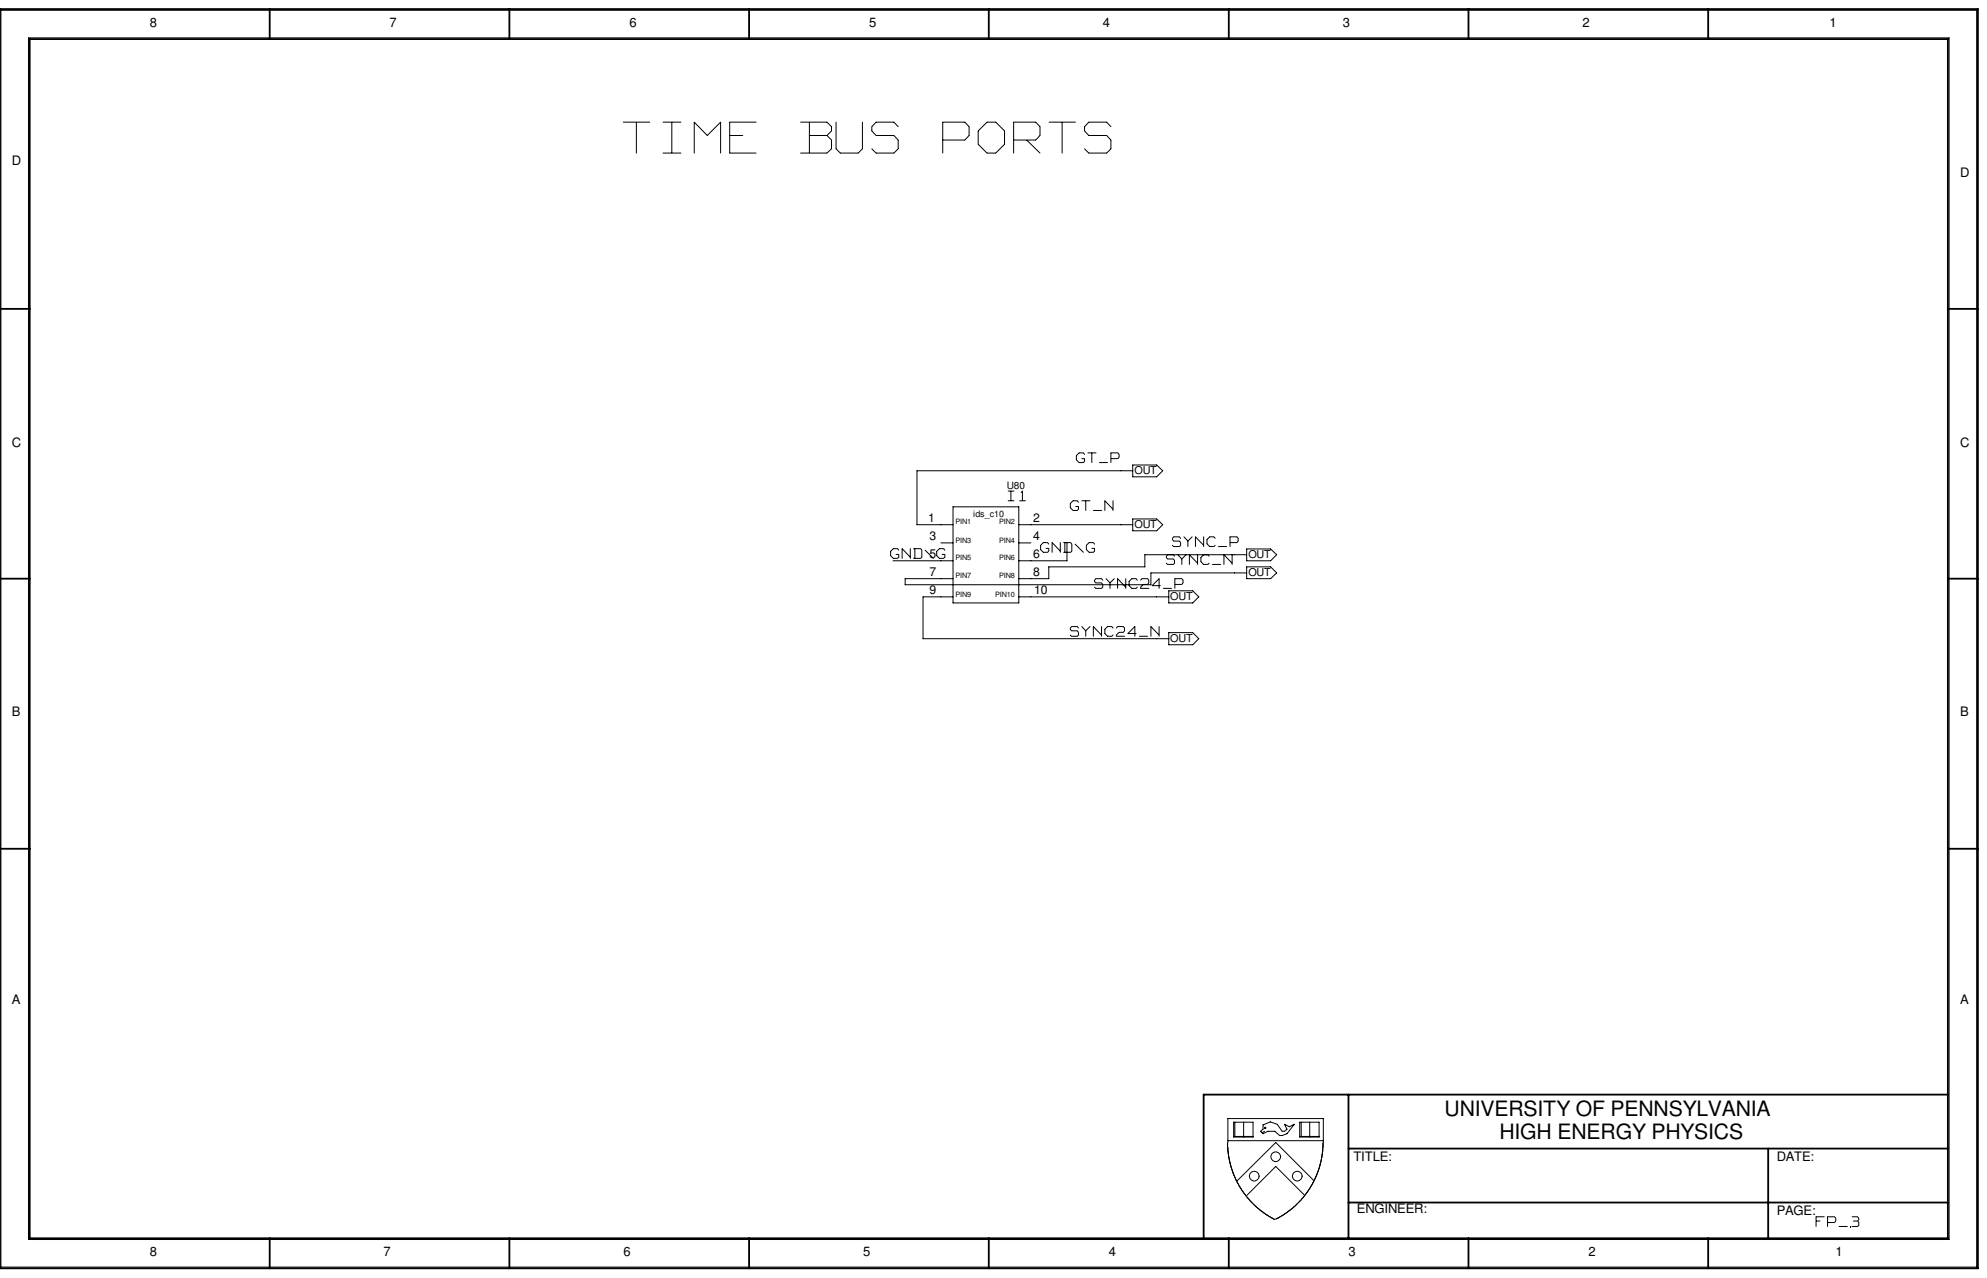
[picture p38: page 34]
GND\G; SYNC24_N; SYNC24_P; SYNC_N; SYNC_P; PIN7; PIN8; PIN6; PIN9; PIN10; PIN3; PIN4; PIN2; PIN5; PIN1; ids_c10; OUT

UNIVERSITY OF PENNSYLVANIA HIGH ENERGY PHYSICS

TITLE: | DATE:

ENGINEER: | PAGE: FP_3

# GENERAL UTILITIES PORTS

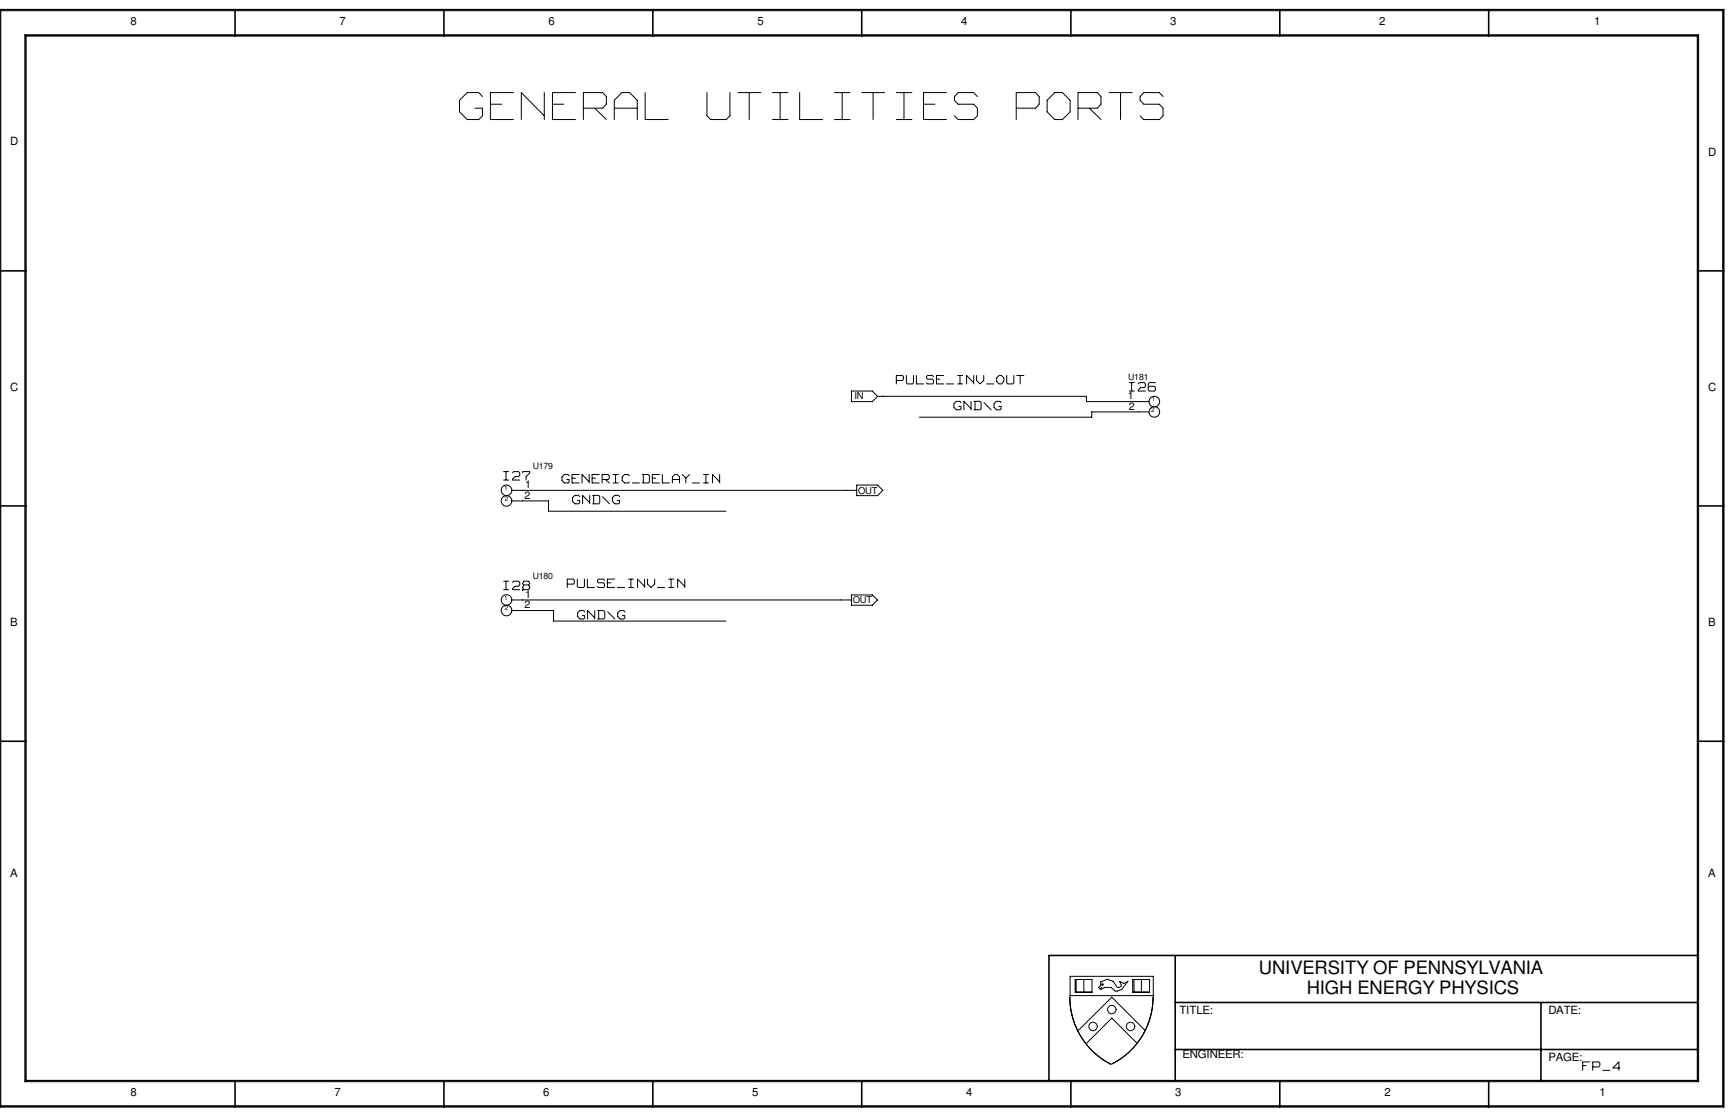
[picture p39: page 35]
PULSE_INV_OUT; GND\G; PULSE_INV_IN; GENERIC_DELAY_IN; OUT

UNIVERSITY OF PENNSYLVANIA HIGH ENERGY PHYSICS

TITLE: | DATE:

ENGINEER: | PAGE: FP_4

# CAEN PORTS

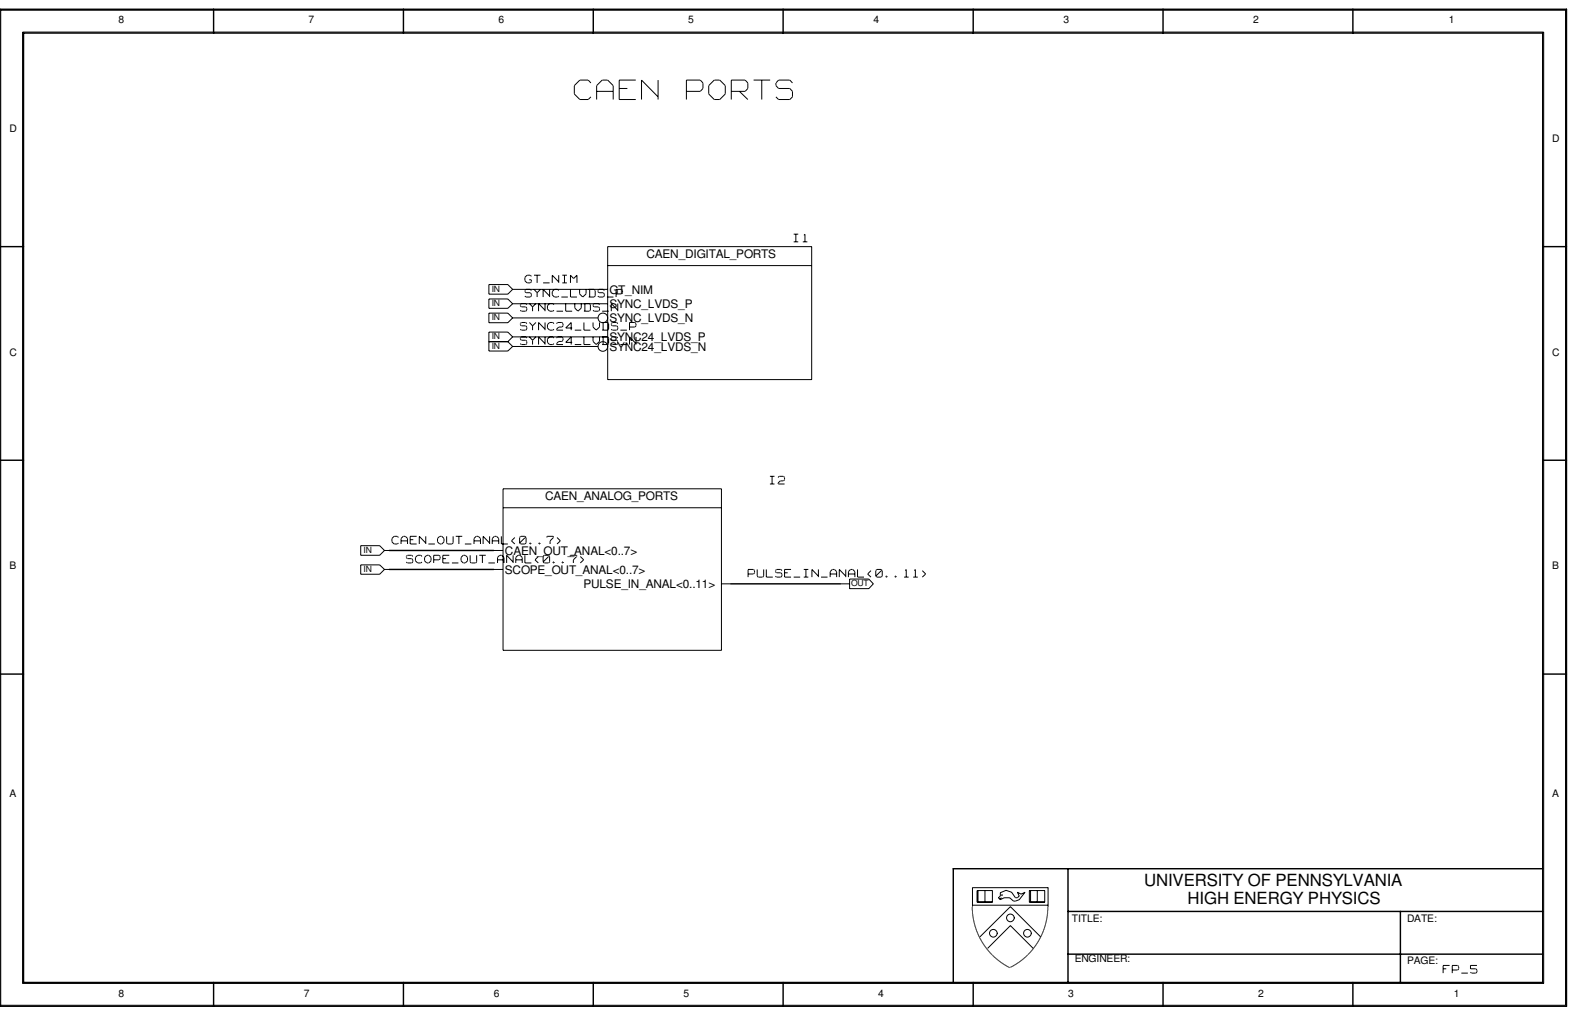
[picture p40: page 36]
PULSE_IN_ANAL<0..11>; SCOPE_OUT_ANAL<0..7>; CAEN_OUT_ANAL<0..7>; SYNC24_LVDS_N; SYNC24_LVDS_P; SYNC_LVDS_N; SYNC_LVDS_P; GT_NIM; OUT; CAEN_ANALOG_PORTS; CAEN_DIGITAL_PORTS; SYNC24_LVDS_N SYNC24_LVDS_P

UNIVERSITY OF PENNSYLVANIA HIGH ENERGY PHYSICS

TITLE: | DATE:

ENGINEER: | PAGE: FP_5

# CAEN DIGITAL PORTS

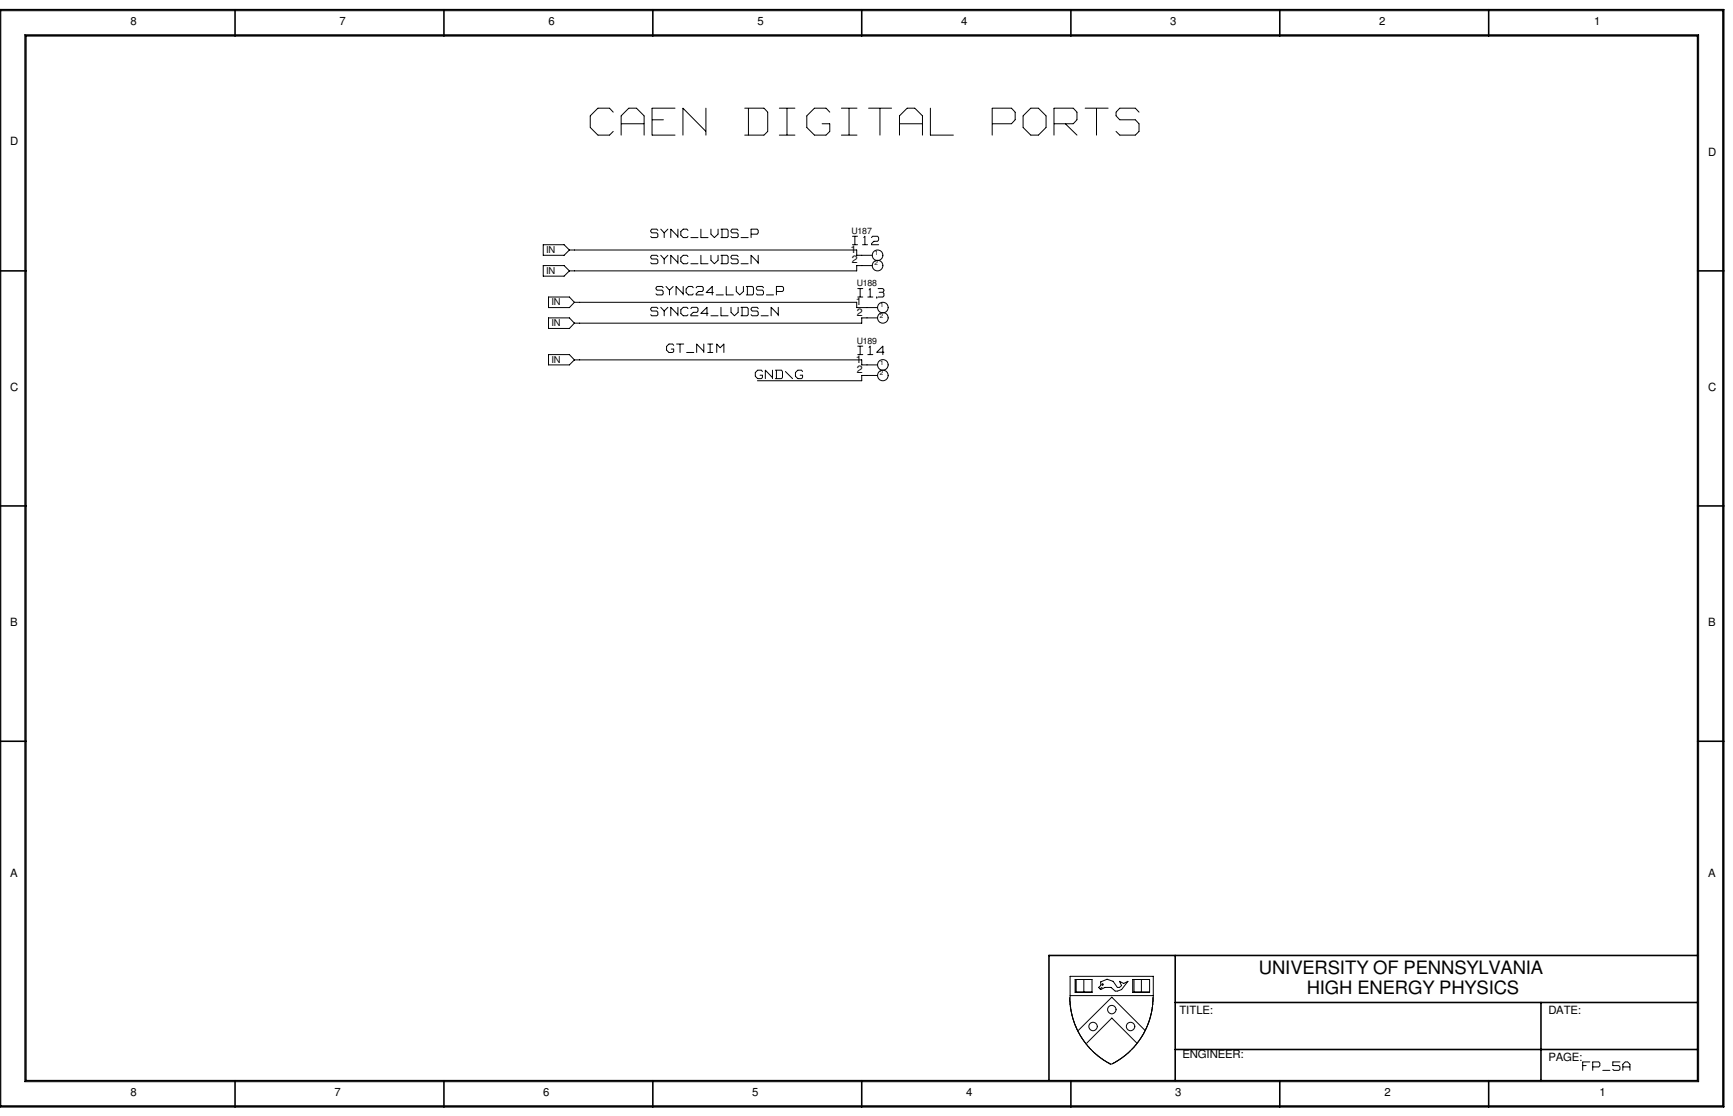
[picture p41: page 37]
GND\G; SYNC_LVDS_P; SYNC_LVDS_N; SYNC24_LVDS_P; SYNC24_LVDS_N; GT_NIM

UNIVERSITY OF PENNSYLVANIA HIGH ENERGY PHYSICS

TITLE: | DATE:

ENGINEER: | PAGE: FP_5A

# CAEN ANALOG PORTS

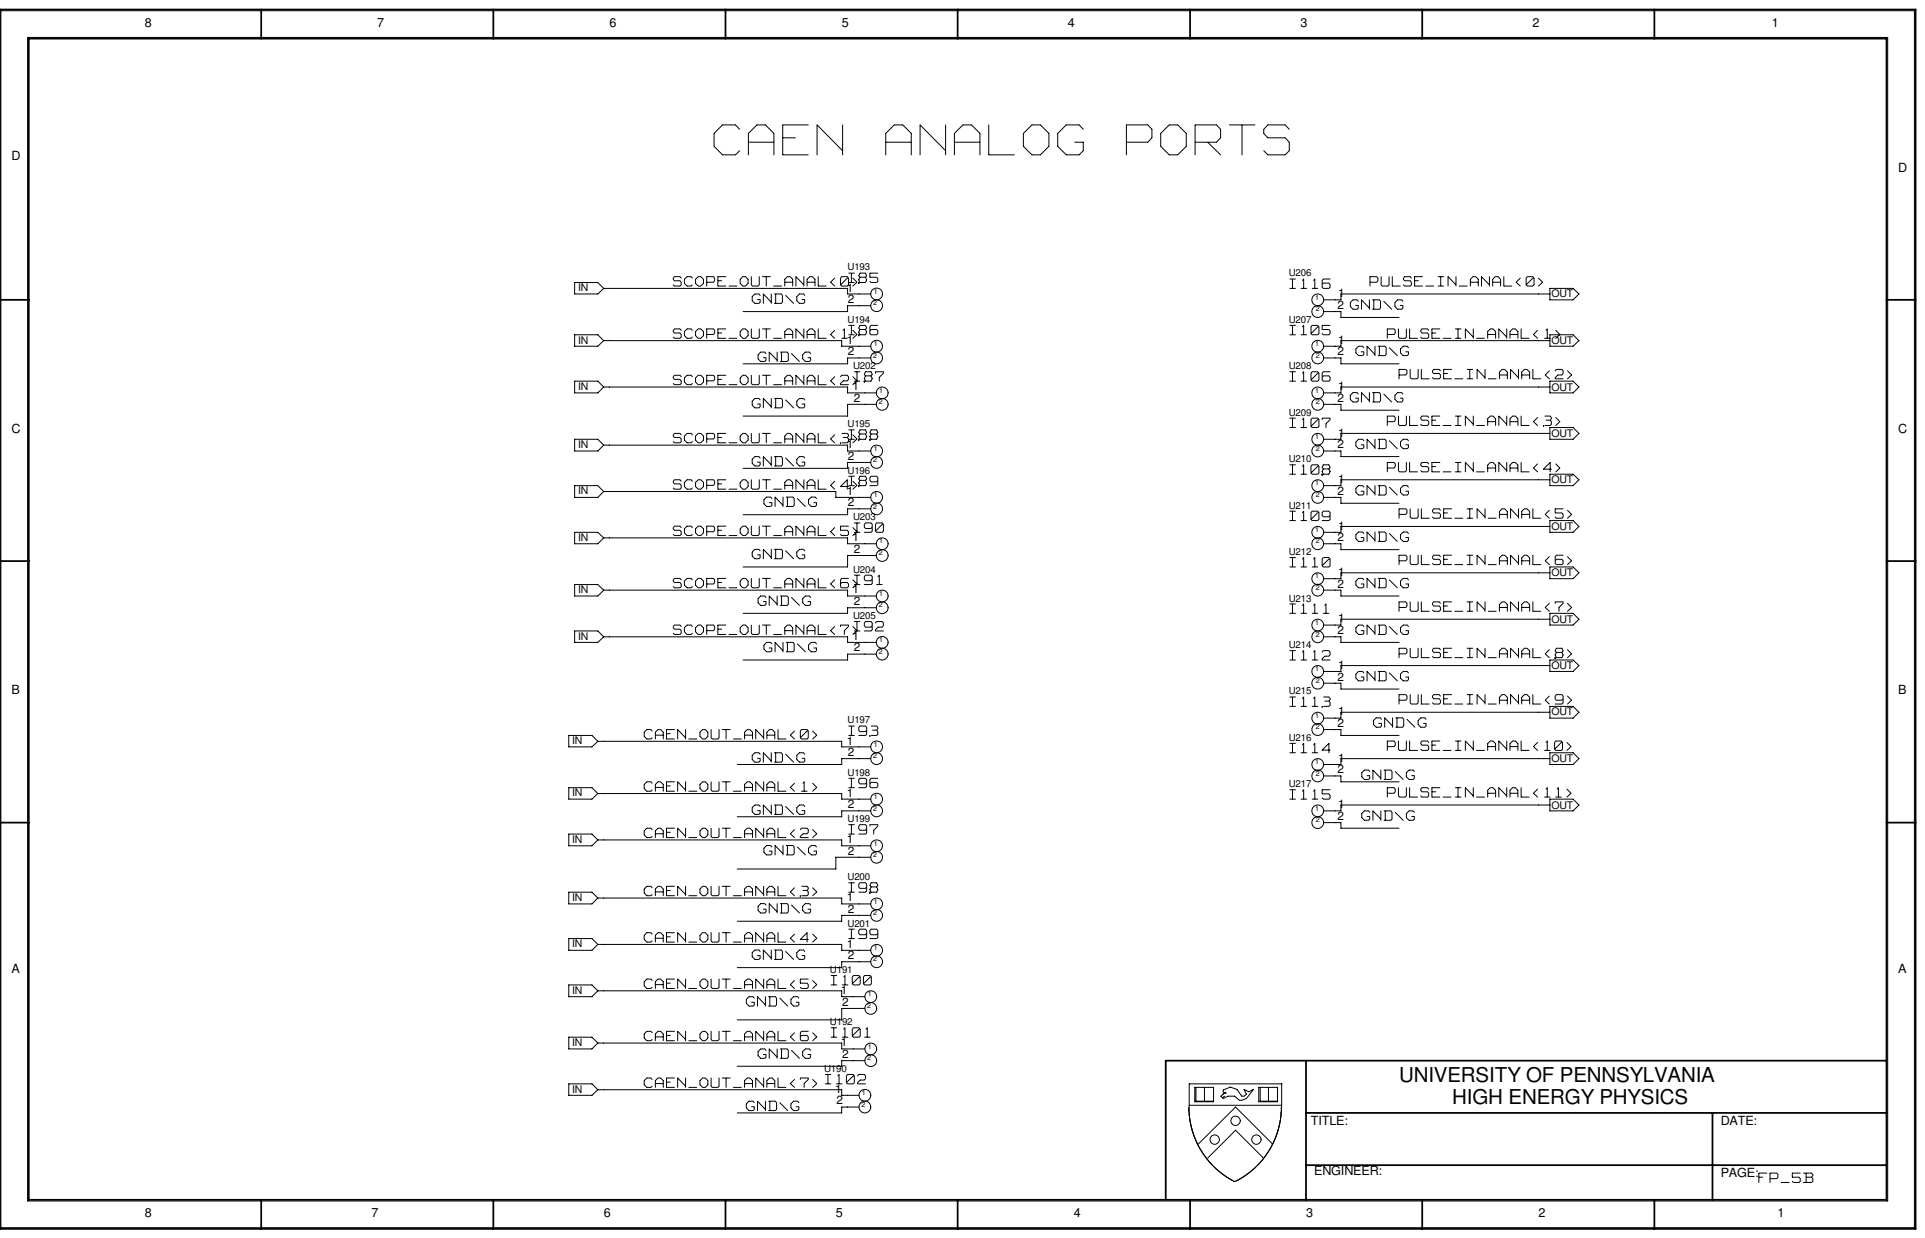
[picture p42: page 38]

UNIVERSITY OF PENNSYLVANIA HIGH ENERGY PHYSICS

TITLE: | DATE:

ENGINEER: | PAGE: FP_5B

# SCALER PORTS

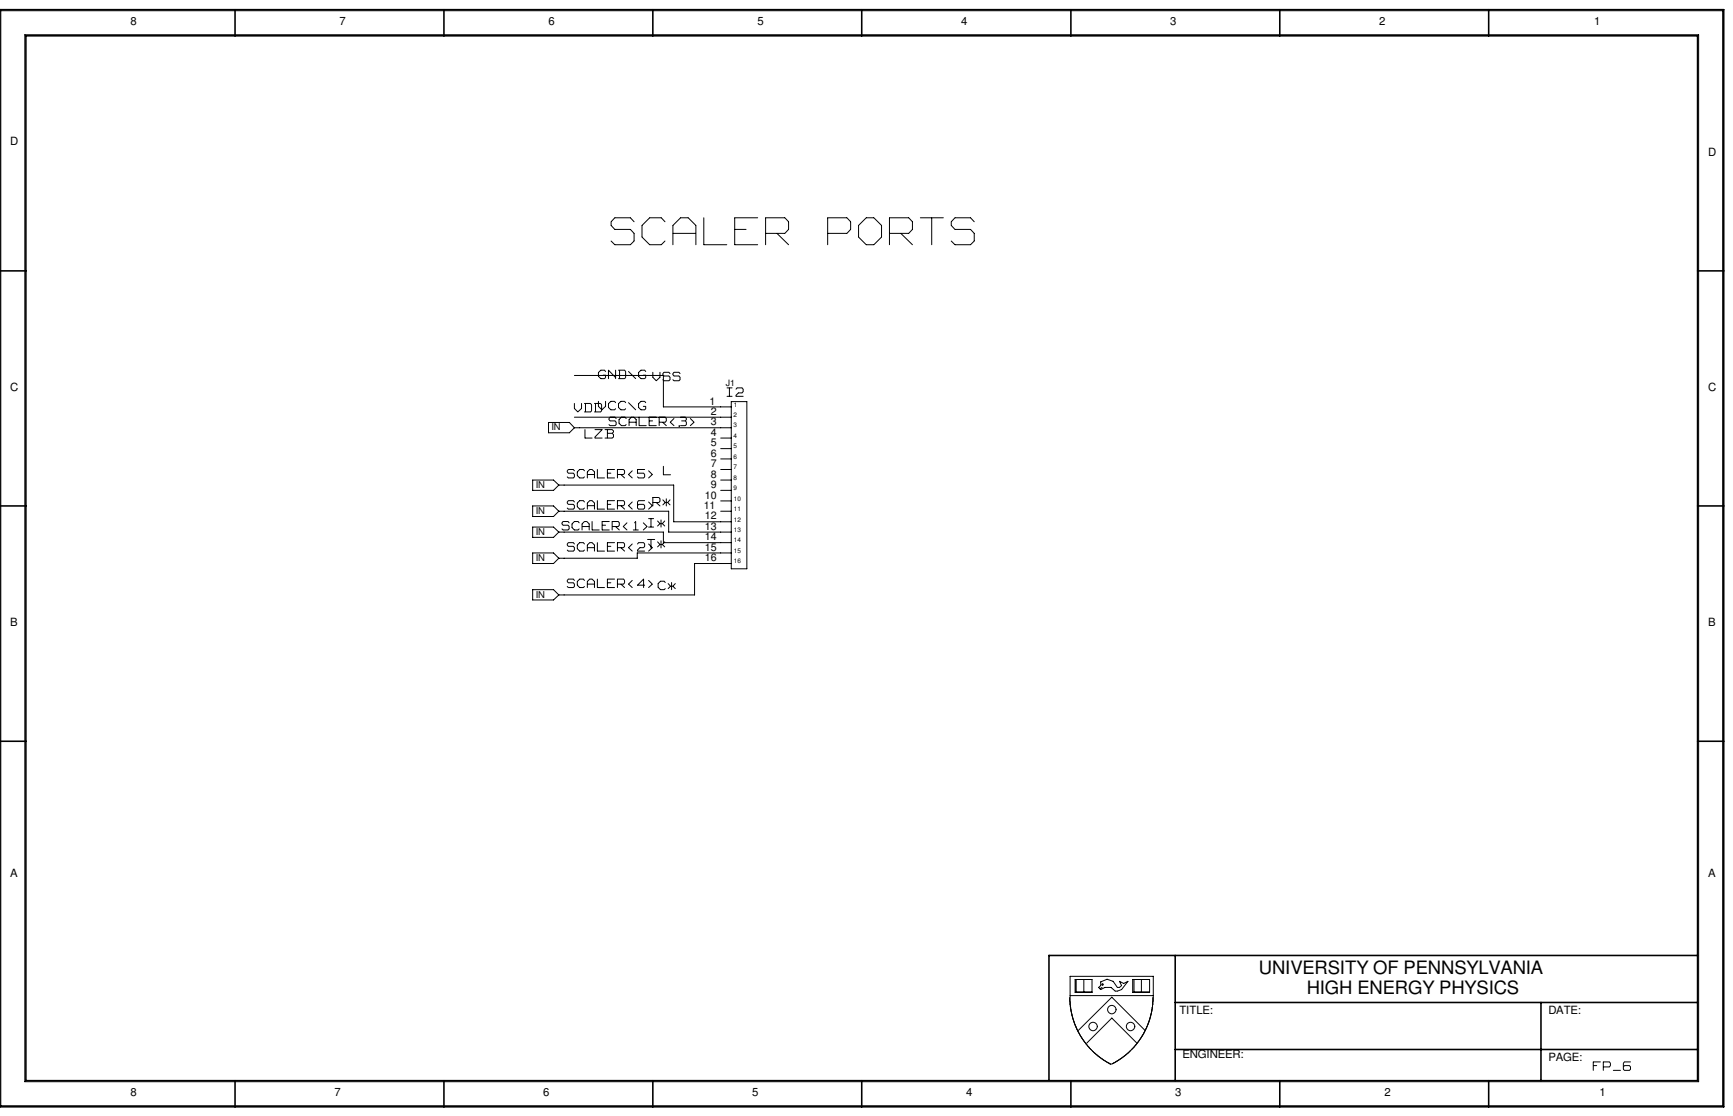
[picture p43: page 39]
VSS; VDD; LZB; SCALER<5>; SCALER<6>; SCALER<1>; SCALER<2>; SCALER<4>; SCALER<3>; VCC\G; GND\G

UNIVERSITY OF PENNSYLVANIA HIGH ENERGY PHYSICS

TITLE: | DATE:

ENGINEER: | PAGE: FP_6

# EXTERNAL TRIGGERS PORTS

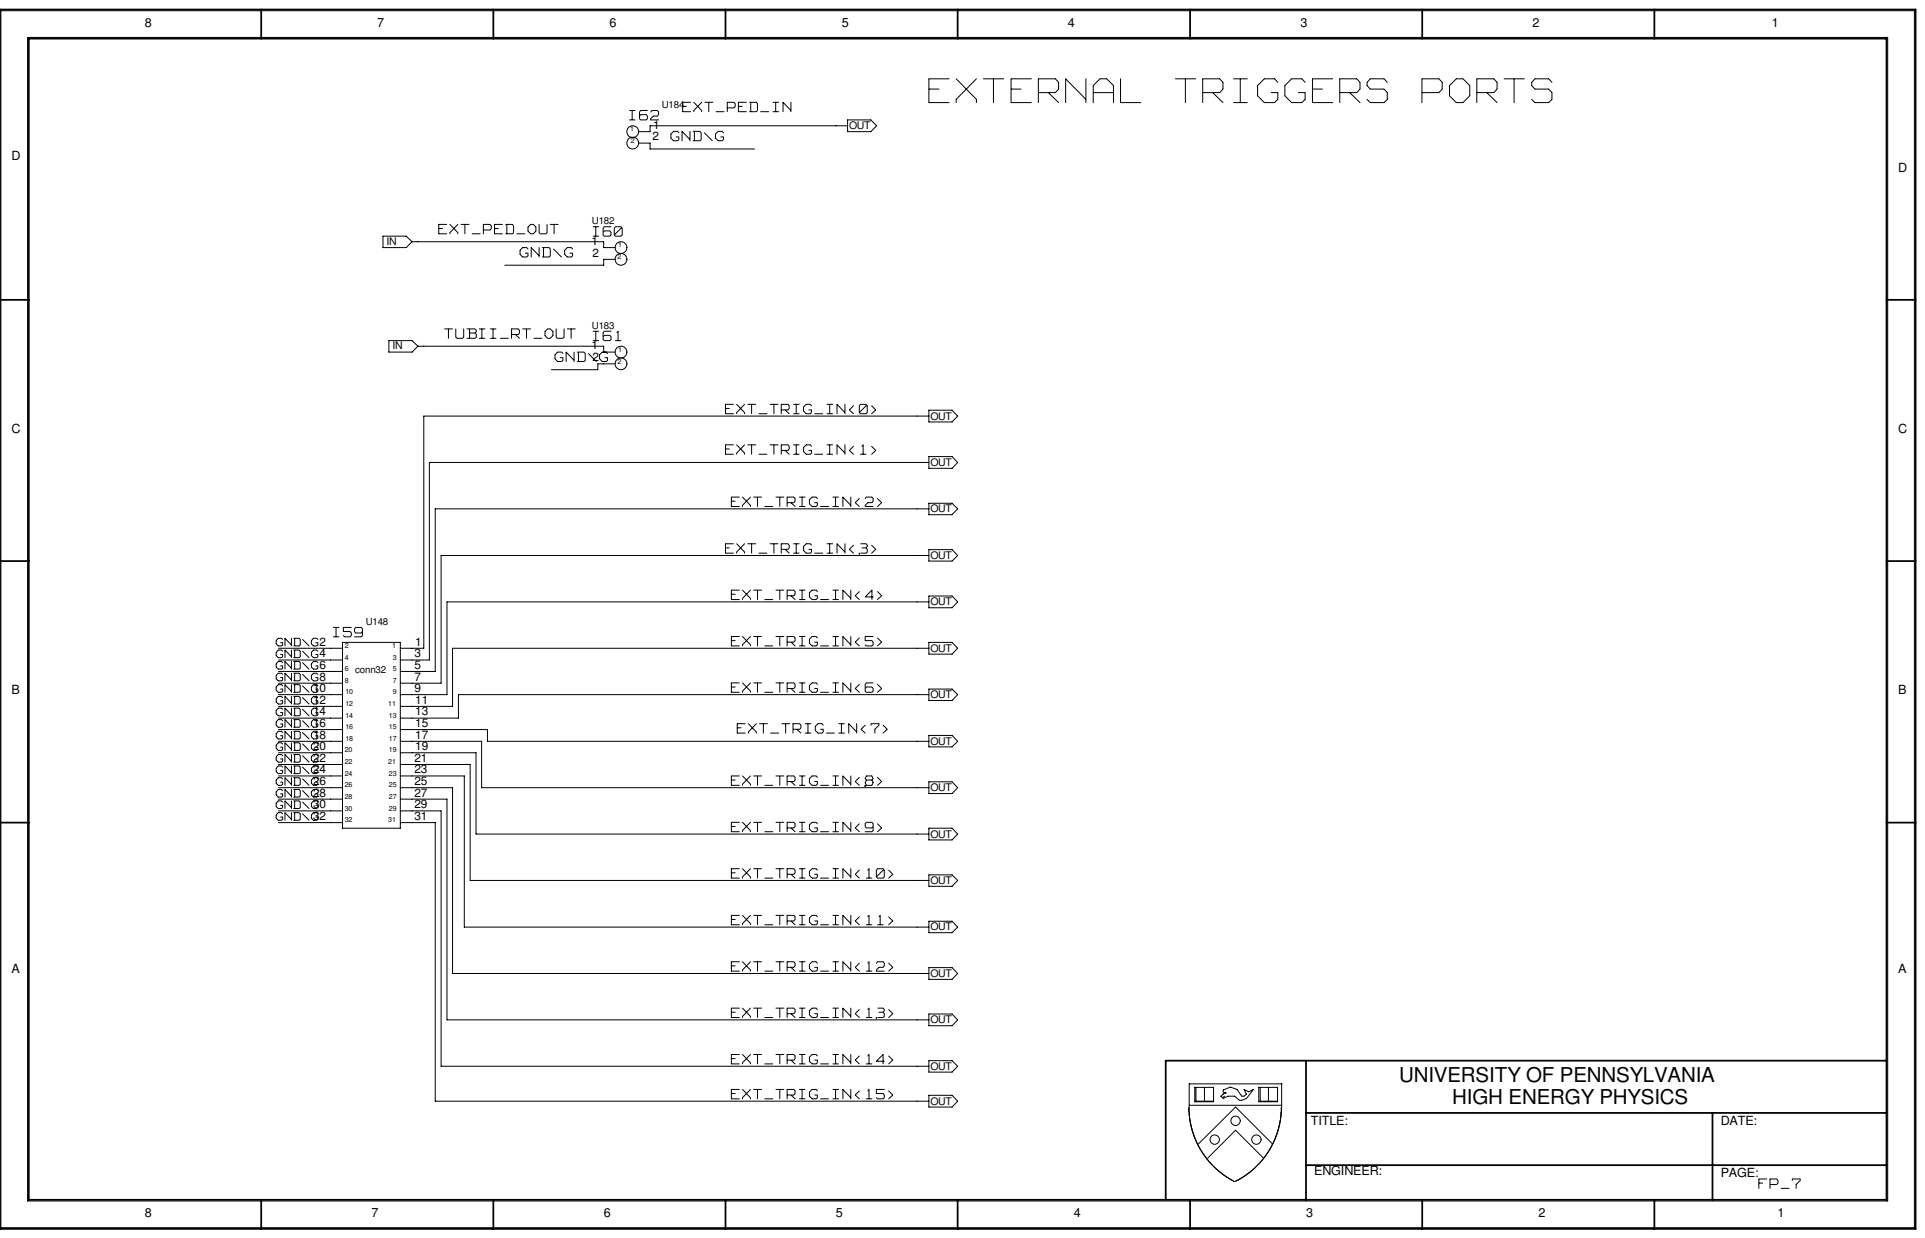
[picture p44: page 40]
GND\G; TUBII_RT_OUT I61; EXT_PED_OUT; EXT_PED_IN; EXT_TRIG_IN<7>; EXT_TRIG_IN<8>; EXT_TRIG_IN<9>; EXT_TRIG_IN<10>; EXT_TRIG_IN<11>; EXT_TRIG_IN<12>; EXT_TRIG_IN<5>; EXT_TRIG_IN<4>; EXT_TRIG_IN<3>; EXT_TRIG_IN<2>; EXT_TRIG_IN<1>; EXT_TRIG_IN<0>; EXT_TRIG_IN<6>; GND\G GND\G; EXT_TRIG_IN<15>; EXT_TRIG_IN<14>; EXT_TRIG_IN<13>; conn32; OUT

UNIVERSITY OF PENNSYLVANIA HIGH ENERGY PHYSICS

TITLE: | DATE:

ENGINEER: | PAGE: FP_7

# GT DELAYS PORTS

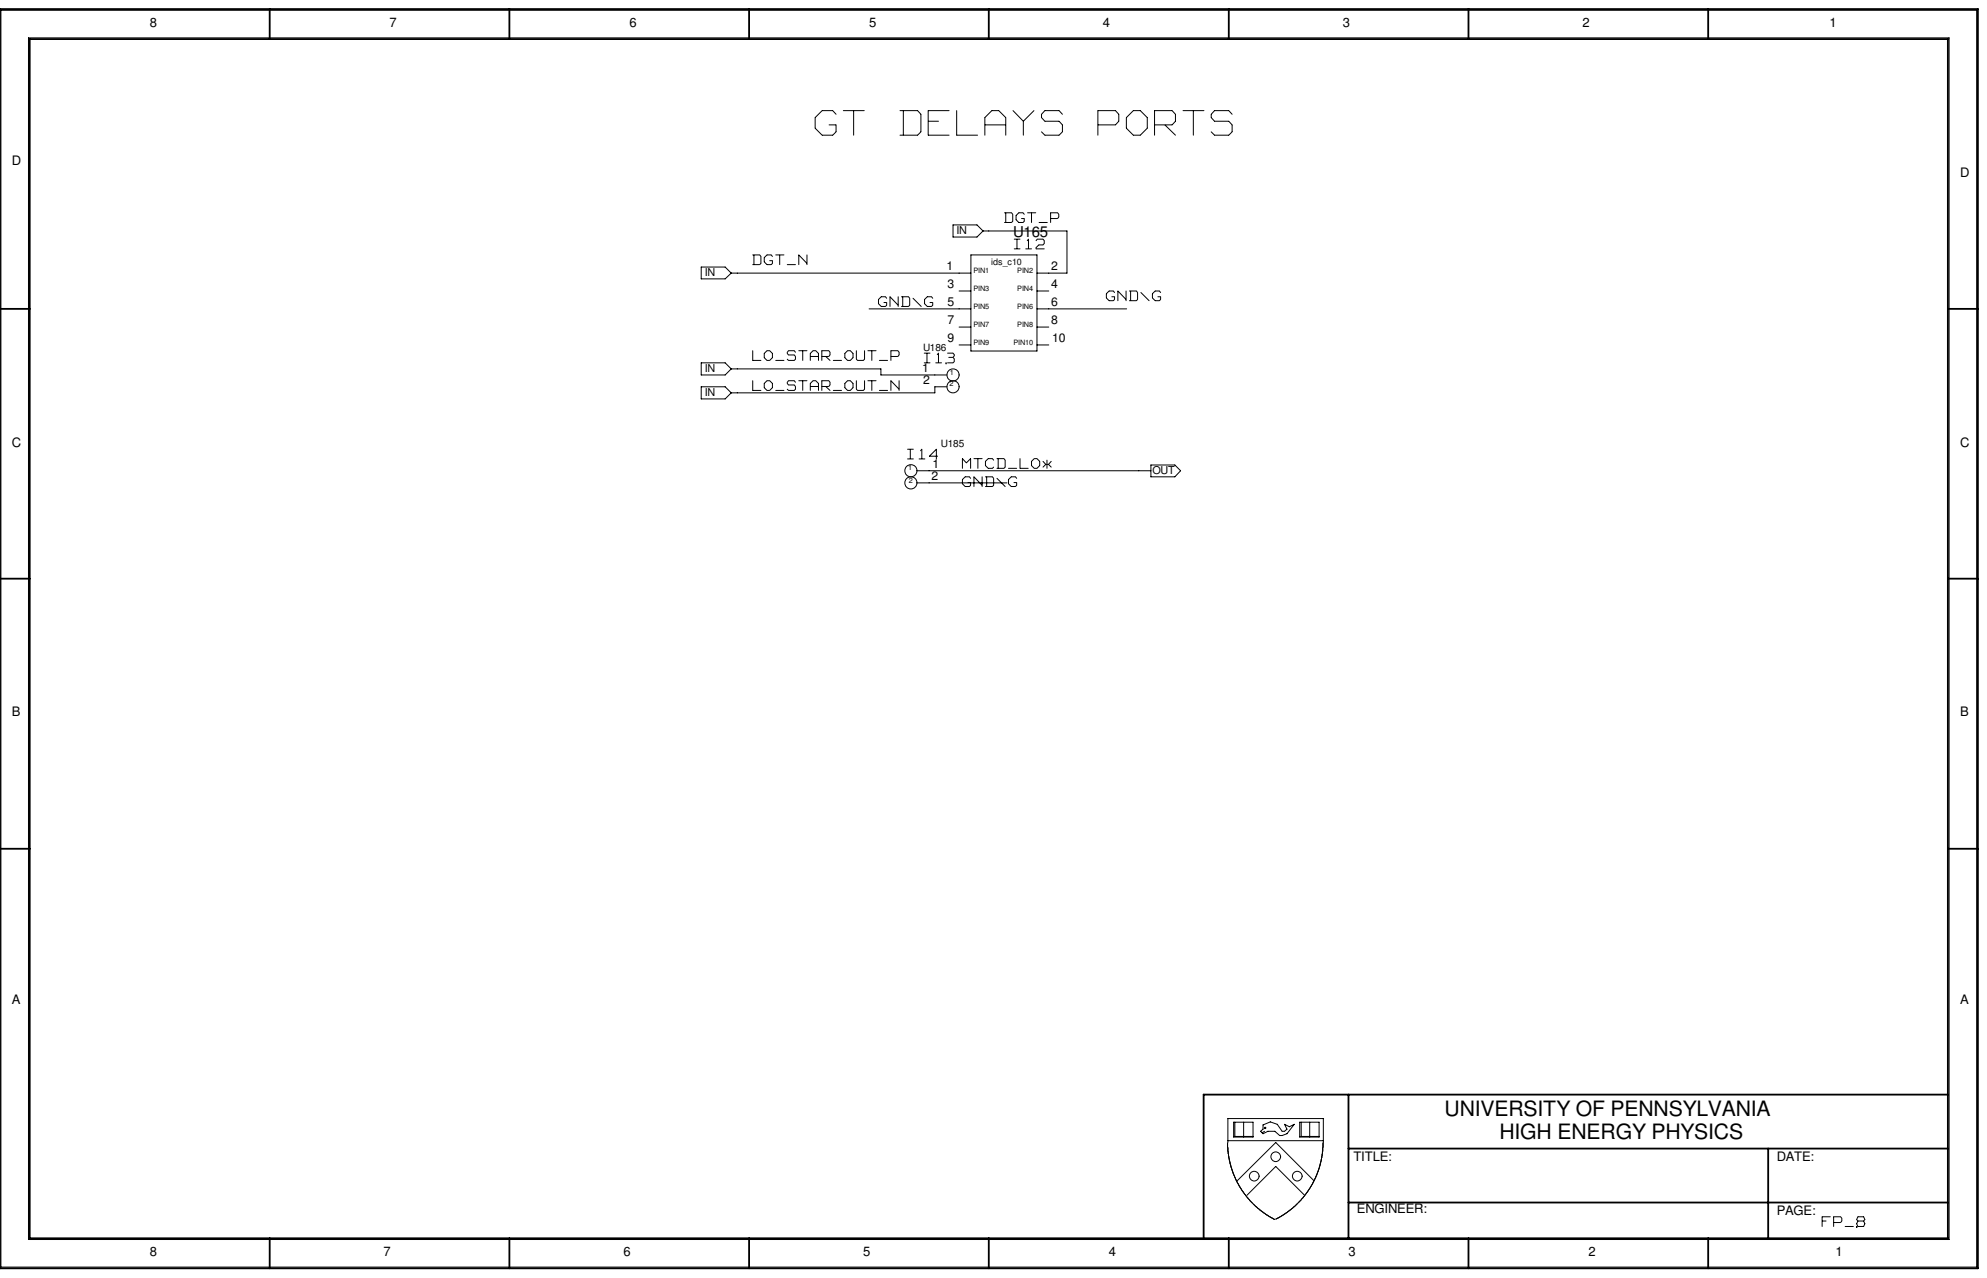
[picture p45: page 41]
LO_STAR_OUT_N; LO_STAR_OUT_P; GND\G; MTCD_LO* I14; DGT_N; DGT_P; PIN7; PIN8; PIN6; PIN9; PIN10; PIN3; PIN4; PIN2; PIN5; PIN1; ids_c10; OUT

UNIVERSITY OF PENNSYLVANIA HIGH ENERGY PHYSICS

TITLE: | DATE:

ENGINEER: | PAGE: FP_8

# BACK PORTS

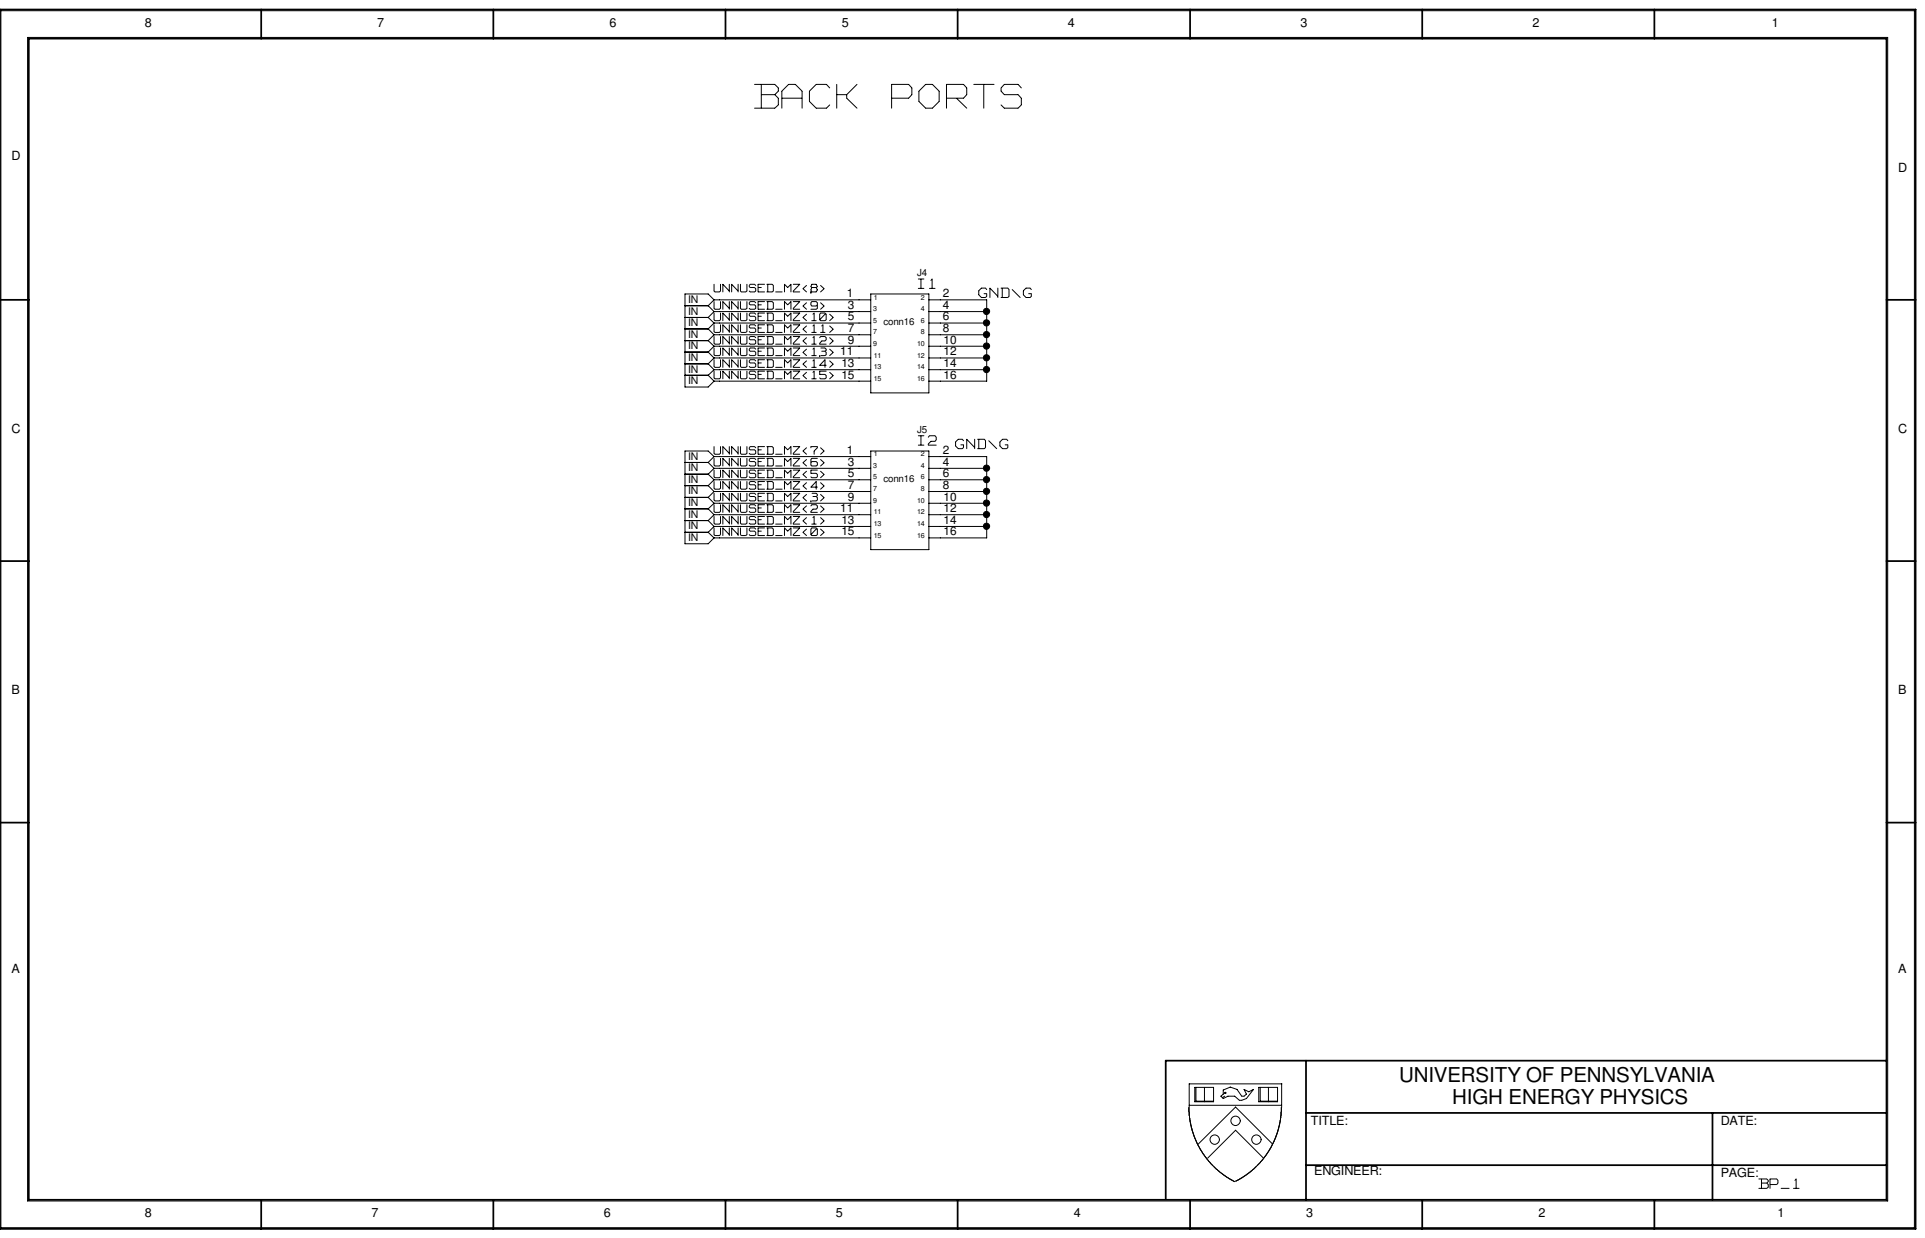
[picture p46: page 42]
UNNUSED_MZ<7>; UNNUSED_MZ<13> UNNUSED_MZ<14> UNNUSED_MZ<15>; UNNUSED_MZ<4> UNNUSED_MZ<3> UNNUSED_MZ<2> UNNUSED_MZ<1> UNNUSED_MZ<0>; UNNUSED_MZ<10>; UNNUSED_MZ<9>; UNNUSED_MZ<8>; UNNUSED_MZ<5>; UNNUSED_MZ<6>; UNNUSED_MZ<12>; UNNUSED_MZ<11>; GND\G; conn16

UNIVERSITY OF PENNSYLVANIA HIGH ENERGY PHYSICS

TITLE: | DATE:

ENGINEER: | PAGE: BP_1
