marzece/Tubii_Tk2/Documentation/Tubii_TK2_Layout.pdf

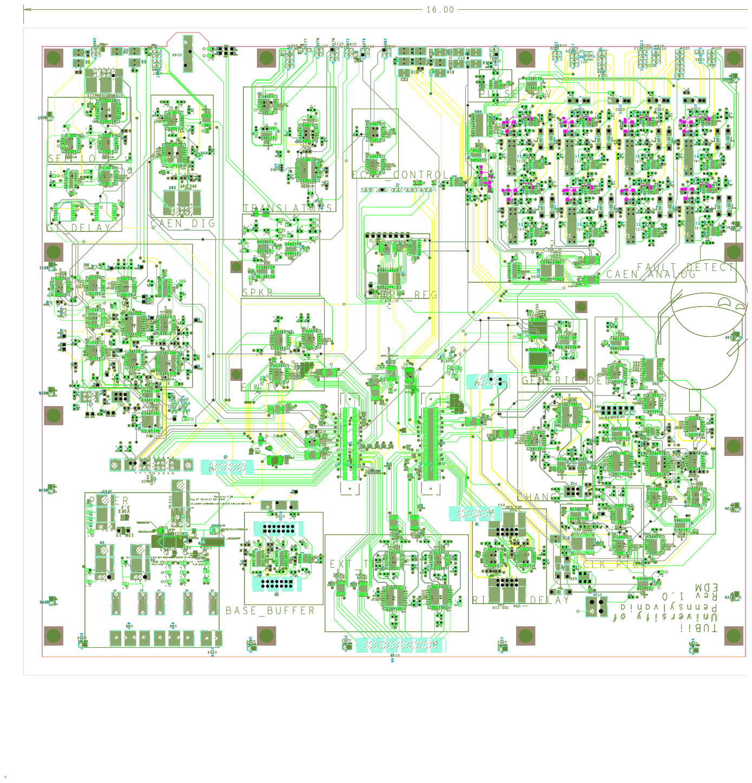
[picture p47: page 1]
