marzece/Tubii_Tk2/Documentation/Tubii_Tk2_Silk_and_Pins.pdf

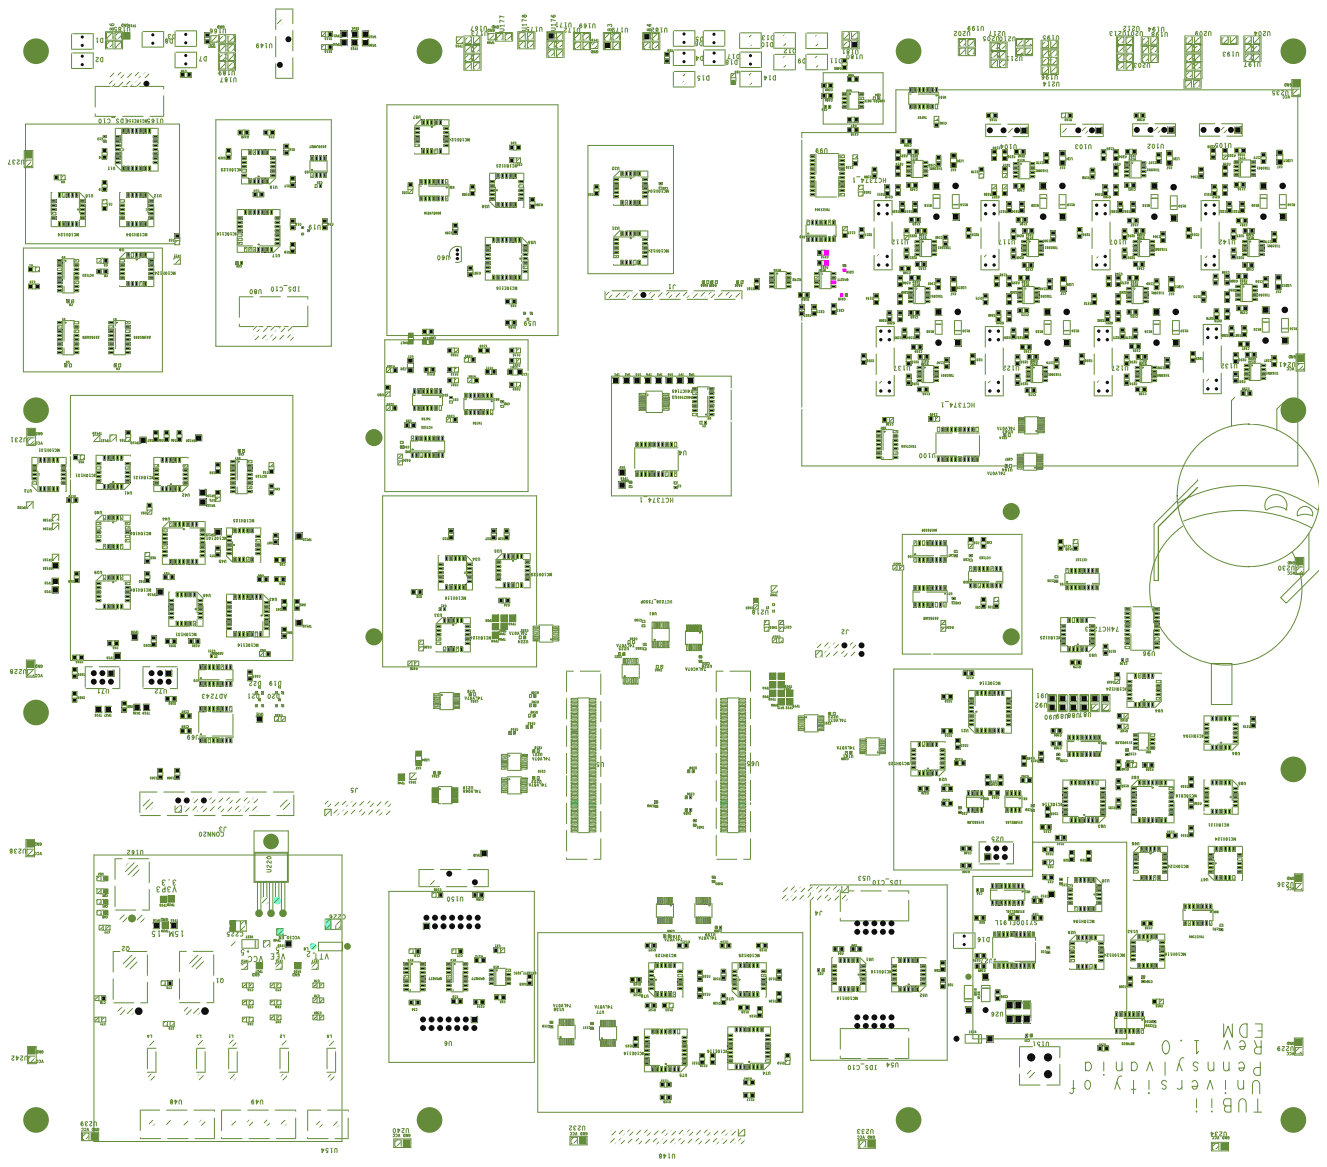
[picture p48: page 1]
