marzece/Tubii_Tk2/Documentation/MICROZED_MODULE.pdf

# MICROZED CONNECTION

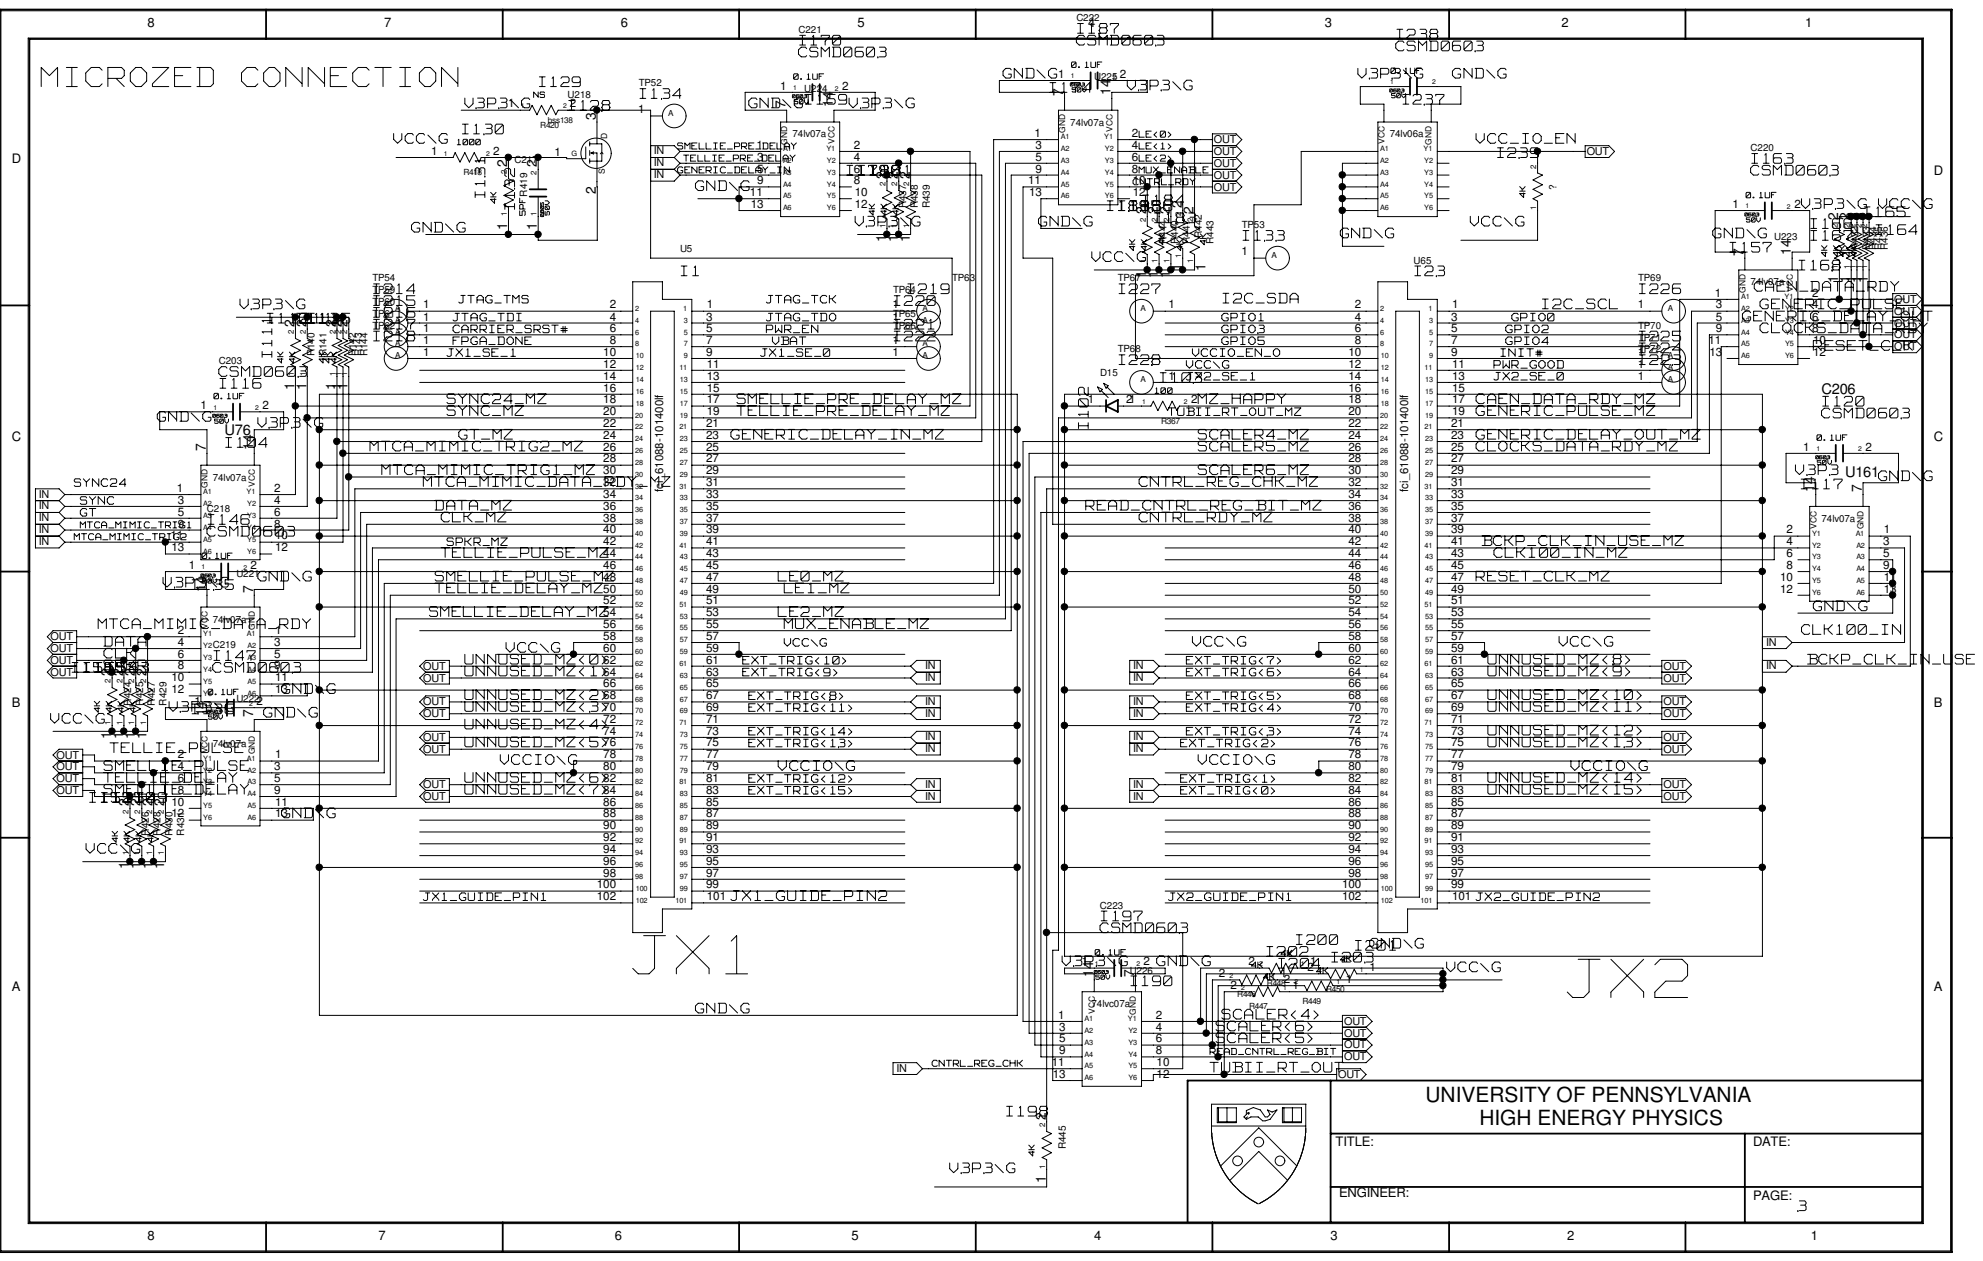
[picture p49: page 1]
