marzece/Tubii_Tk2/(list of files, drawings)

Other design files:
Parts/parts/misc/anlg_dev.olb
worklib/tubii/physical/TubiiPCB_V2.dsn
