marzece/Tubii_Tk2/worklib/tubii/physical/xsectionChartParams.txt

LAYER_NAME YES
LAYER_THICKNESS YES
MATERIAL_NAME YES
EMB_STATUS NO
ATTACH_METHOD NO
LAYER_TYPE YES
DRILL_SPAN YES
STACKED_VIAS YES
EMD_COMP_LEGEND  NO
DRILL_LABEL  YES
X_SCALE_FACTOR  1.000
DIELECTRIC_SCALE_FACTOR  1.000
TEXT_BLOCK  1
MAX_CHART_HEIGHT 2000 MIL
