marzece/Tubii_Tk2/Parts/parts/misc/VerilogModels/TESTPOINT_L.v

/* 
 *  Created:  < wittich 14/08/95>
 *  Time-stamp: <95/08/14 14:51:50 wittich>
 *  filename: /tape/snopcb/snolib_fec32/testpoint_l/verilog_lib/verilog.v
 *  
 *  Comments: test point dummy model.
 *
 *  Modification History:
 *  ------------------------------
 *  14/08/95          Created.
 * 
 */ 

module TESTPOINT_L(A) ;
  input A;
  
endmodule /* TESTPOINT_L */
   
