marzece/Tubii_Tk2/(commit log)

2015-02-28 Initial Commit. Created Hierchy Blocks
    [0603rf_wv_12d.psm, 74hc1g125.psm, 74hc1g125_1.psm, Copy of chips.prt, anlg_dev.olb, at_35ux.psm, bga256.psm, bpcap.psm]
2015-02-28 Began Layout and put in 2 ds1023s
    [TubiiPCB_V1.brd, chips.prt, page1.csv]
2015-02-28 Did (most of) Gt Delays. Changed some parts
    [TubiiPCB_V1.brd, cases.cfg, chips.prt, page1.csv]
2015-02-28 Finshed off LO_Gen and did minor routing
    [BSTPLC.brd, TubiiPCB_V1.brd, TubiiPCB_V2.brd, chips.prt, expand.cfg, page1.csv]
2015-03-01 Scematic for ECAL_Control
    [page1.csv]
2015-03-01 Created Pulse Inverter Schematic
    [page1.csv]
2015-03-01 Created Ribbon Delay
    [chips.prt, expand.cfg, page1.csv]
2015-03-01 Created Generic Pulse Delay and Delay
    [page1.csv]
2015-03-01 Working on MTCA_MIMICS
    [chips.prt, page1.csv]
2015-03-01 Mostly Completed MTCA_MIMICS
    [chips.prt, page1.csv]
2015-03-01 Did Shcematic for Backplane Buffer
    [page1.csv]
2015-03-01 Schematic for speaker made
    [chips.prt, page1.csv]
2015-03-01 Created CLK Picking schem
    [chips.prt, page1.csv]
2015-03-02 Created Fault Detection schem and CAEN anal stuff
    [chips.prt, expand.cfg, page1.csv]
2015-03-03 Worked on CLK change over schem
    [chips.prt, expand.cfg, page1.csv]
2015-03-03 Finished CLK change over schem
    [page1.csv]
2015-03-04 Created schem for powers
    [page1.csv]
2015-03-04 Started on Ellie stuff
    [page1.csv]
2015-03-04 Started translation schems. Did TTL<->ECL already
    [page1.csv]
2015-03-04 Worked on translation schems and...
    Something is wrong with the translation block symbol. I'm
    gonna try and fix it without deleting everything but this commit
    is just in case i fuck that up
    [chips.prt, page1.csv]
2015-03-05 Changed Translation block to Translation_ECL
    [page1.csv]
2015-03-05 Began connecting wires
    [page1.csv]
2015-03-05 Made ext trig in and Ellie stuff and wiring
    [page1.csv]
2015-03-06 More Wiring. Gotta decide on some design stuff
    [page1.csv]
2015-03-06 Made Translation Ports
    [page1.csv]
2015-03-07 Nearly finished adding schems for ports
    [page1.csv]
2015-03-07 Finshed ports and made a mess out of doing the MZ
    [expand.cfg, page1.csv]
2015-03-08 Fixed netlisting errors. And did reset stuff with clocks
    [expand.cfg, page1.csv]
2015-03-08 Debugging & First successful Design Sync
    [TubiiPCB_V2.brd, chips.prt, expand.cfg, page1.csv]
2015-03-08 Did layout for Baseline_Buffer and added package to hct123
    [BSTPLC.brd, TubiiPCB_V2.brd, chips.prt]
2015-03-08 Made some rooms and layed them out
    [BSTPLC.brd, TubiiPCB_V2.brd, expand.cfg, page1.csv]
2015-03-08 Did layout for gen_delays and pulse_inv
    [TubiiPCB_V2.brd, TubiiPCB_V2.dsn, TubiiPCB_V3.brd, expand.cfg, page1.csv]
2015-03-08 Gt Delays layout done
    [TubiiPCB_V3.brd]
2015-03-08 Layout for ECAL_CNTRL
    [BSTPLC.brd, TubiiPCB_V3.brd]
2015-03-09 Layout for CAEN_DIG and started Translation layout
    [BSTPLC.brd, BSTPLC.dsn, TubiiPCB_V3.brd, expand.cfg, page1.csv]
2015-03-09 Finished layout for translators
    [TubiiPCB_V3.brd, page1.csv]
2015-03-09 Added caen analog stuff to caen analog room
    [TubiiPCB_V3.brd, page1.csv]
2015-03-09 Added package for FoxClock :clock1:
    [smd_fox.psm]
2015-03-09 Placed all the rooms
    [BSTPLC.brd, BSTPLC.dsn, TubiiPCB_V3.brd, expand.cfg]
2015-03-09 Created BOM
2015-03-18 Added pull-downs to Change_CLKS
    [TubiiPCB_V3.brd, page1.csv]
2015-03-18 Did layout for Change_CLKs
    [BSTPLC.brd, TubiiPCB_V3.brd, expand.cfg, page1.csv]
2015-03-18 Updated FoxClock part
    [chips.prt, page1.csv]
2015-03-18 Made sure new fox schem worked in design
    [expand.cfg, page1.csv]
2015-03-19 Did CLK_SEL layout
    [TubiiPCB_V3.brd, expand.cfg, page1.csv]
2015-03-20 Began layout for MTCA_MIMIC trigger logic
    [BSTPLC.brd, TubiiPCB_V3.brd, page1.csv]
2015-03-20 Continued layout of mtca_mimic's trigger logic
    [TubiiPCB_V3.brd, expand.cfg, page1.csv]
2015-03-20 Added some ECL VIHs by having a 5K resisitor to gnd
    [TubiiPCB_V3.brd, expand.cfg, page1.csv]
2015-03-20 Finished layout for MTCA_MIMICS
    [BSTPLC.brd, TubiiPCB_V3.brd, page1.csv]
2015-03-20 Bookkeeping update
    [BSTPLC.brd, TubiiPCB_V3.brd, page1.csv]
2015-03-23 Did layout for Powers & ELLIE a bit
    [TubiiPCB_V3.brd, expand.cfg, page1.csv]
2015-03-23 Book keeping commit before beging CAEN_ANAL module
    [BSTPLC.brd, TubiiPCB_V3.brd]
2015-03-23 BookKeeping update number 2...no changes
    [expand.cfg]
2015-03-25 Made VREF5M block in CAEN ANAL
    [TubiiPCB_V3.brd, page1.csv]
2015-03-25 Did a layout for a single CAEN_BUFFER
    [TubiiPCB_V3.brd, expand.cfg, page1.csv]
2015-03-25 Replicated CAEN_BUF
    [BSTPLC.brd, TubiiPCB_V3.brd, expand.cfg]
2015-03-25 Started connecting CAEN BUFS to other parts...
    Stopped b/c I think I did the analog traces all wrong. Gonna redo pretty
    much everything i did today
    [TubiiPCB_V3.brd, page1.csv]
2015-03-25 Deleted CAEN_ANAL stuff, redid ANAL Trace only
    [TubiiPCB_V3.brd]
2015-03-26 Did routing of analog trace for CAEN_BUF
    [TubiiPCB_V3.brd, expand.cfg, page1.csv]
2015-03-26 Finished up layout/routing of a single CAEN_BUF
    [TubiiPCB_V3.brd]
2015-03-27 Arranged digital parts of CAEN_ANALOG block
    [TubiiPCB_V3.brd, page1.csv]
2015-03-30 Connected CAEN_ANALOG parts to ports
    [BSTPLC.brd, TubiiPCB_V3.brd, page1.csv]
2015-04-01 CAEN Analog, connecting VREFs/VCC15s
    [expand.cfg, page1.csv]
2015-04-01 Rearranaged a few outputs on U100 for easier routing
    [expand.cfg, page1.csv]
2015-04-01 Rearranged U100 further
    [page1.csv]
2015-04-01 I think I may have finished CAEN_ANAL stuff
    [page1.csv]
2015-04-01 Place MZ headers and removed CAEN_ANAL_PORTS room
    [expand.cfg, page1.csv]
2015-04-01 Added front ports room
    [expand.cfg, page1.csv]
2015-04-02 Save before start messing with CMGR
    [expand.cfg, page1.csv]
2015-04-06 Created pickering 113 form c foot print
    [chips.prt, p113fc.psm]
2015-04-07 Rearranging things for new smaller parts
    [chips.prt, dip20.psm, expand.cfg, p113fc.psm, page1.csv]
2015-04-08 Reconnected everything and moved some rooms
    [expand.cfg, page1.csv]
2015-04-09 Layout & Routed Ext Trig
    [expand.cfg, page1.csv]
2015-04-09 Replaced testpoints for EXT_TRIG_PORTS with a ribbon calbe
    [page1.csv]
2015-04-10 Routed ribbon cable moved EXT_TRIG near MZ
    [page1.csv]
2015-04-16 Added some stuff for MTCA_MIMICS
    [expand.cfg, page1.csv]
2015-04-16 Placed MTCA_MIMIC and routed much of it.
    [expand.cfg, page1.csv]
2015-04-16 Place CNTRL_REG and started with ELLIE
    [page1.csv]
2015-04-16 Autoplaced FAULT_DETECT room
    [page1.csv]
2015-04-17 Began arranging fault_detection parts
    [page1.csv]
2015-04-17 Routing and layout of FAULT_DETECT nearly done
    [page1.csv]
2015-04-17 Continued routing of FAULT_DETECT...2 caps left
    [page1.csv]
2015-04-18 Finished layout for fault detect the final room :fireworks:
    [page1.csv]
2015-04-18 Replaced a cap and placed a missed resistor
    [expand.cfg, page1.csv]
2015-04-20 Added 3006P Trim pot footprint
    [3006_trimpot.psm]
2015-04-20 Created trimpot part and added it to schematic
    [chips.prt, page1.csv]
2015-04-20 Placed and routed some test points (not ports)
    [page1.csv]
2015-04-21 Added pushbutton and added another connection to clock reset line
    [chips.prt, d6r10f1_button.psm, page1.csv]
2015-04-22 Arranging and trying to finish the routing
    [expand.cfg, page1.csv]
2015-04-22 A lot of stuff...somehow nothing is different though
    [page1.csv]
2015-04-23 Commit before I fuckup MUXer entierly
    [page1.csv]
2015-04-23 Put the MUXer above MZ
    [page1.csv]
2015-04-23 Routing the MZ like a mother fucker
    [page1.csv]
2015-04-23 Routing loose ends...nearly done
    [page1.csv]
2015-04-23 Finished up nearly all the routing.
    [page1.csv]
2015-04-23 Routed the last route
    [chips.prt, page1.csv]
2015-04-23 Added a few ground vias.
2015-04-27 Added shapes for powerplanes and created new BOM
    [expand.cfg]
2015-05-02 Made room names invis and added titles in schem
    [page1.csv]
2015-05-03 Improved readability and added mounting holes
    [expand.cfg, page1.csv, page2.csv]
2015-05-11 Made rooms have 'soft' boundaries
    [3006_trimpot.psm, page1.csv]
2015-05-11 Fixed Power plane boundaries which were outside of the board
2015-05-11 Added voids on all planes for THS3062
    [expand.cfg, page1.csv]
2015-05-12 Finshed 15v planes and 3.3v one.
2015-05-12 Commiting here b/c synching isn't changing layout...needs to be fixed
    [cases.cfg, expand.cfg, page1.csv]
2015-05-13 Fixed the bug a net named jx1_se_) caused it
    [page1.csv]
2015-05-13 Replace THS3062s with THS3061s. Tidied up some routes in CAEN_ANAL
    [chips.prt, expand.cfg, page1.csv]
2015-05-13 Added more screws lined them up a little
2015-05-14 Realized Cadence auto connects through holes to correct plane...started deleting traces
    [expand.cfg, page1.csv]
2015-05-15 Changed planes for POWER and added LVDS terminating res
    [expand.cfg, page1.csv, page2.csv]
2015-05-15 Made TUB Clk differential and added a 10h116 for it
    [expand.cfg, page1.csv]
2015-05-16 Deleted Vtt regulator and added a header for it to come in on
    [chips.prt, expand.cfg, ostoq027150.psm, page1.csv]
2015-05-16 Layout for new Vtt. Routed terminating Res's
    The terminating resistors go on both the MTCA mimic and CAEN Anal
    [expand.cfg, page1.csv]
2015-05-18 Added termination resistors for BASELINE_BUFFER
    [page1.csv]
2015-05-18 Added Block for fan connections (layout too)
    [page1.csv]
2015-05-18 Created 74HCT164 part
    [chips.prt]
2015-05-18 Replaced all 74F164s with 74HCT164s
    [expand.cfg, page1.csv]
2015-05-18 Did layout for change of f164s--->HCT164s
    [page1.csv]
2015-05-18 Added No stuff caps to op-amps in CAEN_Buffer
    [page1.csv]
2015-05-18 Did layout for aforementioned NS caps
    [page1.csv]
2015-05-18 Deleted unneeded vias to ground on Ext_Trig ribbon
2015-05-18 Added GT_TTL_OUT to schematic
    [page1.csv, page2.csv]
2015-05-18 Add GT TTL to layout
    [expand.cfg, page1.csv]
2015-05-18 Created and added Z4KE diode to make pull down voltage for lvpecl
    [chips.prt, expand.cfg, page1.csv]
2015-05-19 Put cap on lvpecl pulldown & fixed speaker pull up
    [page1.csv]
2015-05-19 Did layout for new pull downs on lvpecl and spkr
    [page1.csv]
2015-05-19 Updated LM117 so that the tab is an output
    [chips.prt, page1.csv]
2015-05-19 Similarly connected large pin of 7815s_l and 7915l to output
    [chips.prt, expand.cfg, page1.csv]
2015-05-19 Changed via-line spacing to 10 mils and fixed DRCs
    [expand.cfg, page1.csv]
2015-05-20 Expanded board by 0.2 inches vertically. Doing manufacture prep
    [art_param.txt, nc_param.txt]
2015-05-20 Fixed reed relay pins. Created Gerbers
    [chips.prt, nc_param.txt, p113fc.psm, page1.csv, xsectionChartParams.txt]
2015-05-20 Messing around with gerbers
2015-05-21 Changed LVPECL pulldwn. Made much art-ty changes
    [expand.cfg, nc_param.txt, page1.csv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]
2015-05-22 Did and Fixed all dangling net report
    [page1.csv]
2015-05-22 Added connects to unconnected GNDs & PWRs
    [nc_param.txt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]
2015-05-22 Used josh's script to look for missing Rs. None found
    [page1.csv]
2015-05-23 Did schem for adding SOME lv ttl buffers to MZ
    [chips.prt, expand.cfg, page1.csv]
2015-05-23 Finished layout for the lvttl buffers I added
    [expand.cfg, page1.csv]
2015-05-23 Did schem for more lvttl buffers in ext_trig
    [page1.csv]
2015-05-23 Did layout & routing for 2nd batch of lvttl buffers
    [page1.csv]
2015-05-24 Began Adding more 74lv07a's but I realized it might be too slow
    [expand.cfg, page1.csv]
2015-05-25 Changed 3p3 regulator to lt1085ct-3.3
    [chips.prt, page1.csv]
2015-05-25 Mega Review. See notes for deets
    [page1.csv]
2015-05-26 Many changes. Added 74lv07a to caen anal stuff
    [chips.prt, expand.cfg, page1.csv]
2015-05-26 Put LEDs btwn caen clipping diodes & VEE
    [expand.cfg, page1.csv]
2015-05-26 Changed mux so enable connects to MZ. Made button corners only
    [page1.csv]
2015-05-26 Made VIL a 5K R to VEE
    [page1.csv]
2015-05-27 Did layout for the new VIL resistors
    [page1.csv]
2015-05-27 Added some silkscreen pwr labels and a TP for V3P3
    [page1.csv]
2015-05-27 Changed timebus cables to be 14 pin
    [chips.prt, conn14.psm, expand.cfg, page1.csv]
2015-05-27 Added DGT to a 10 pin header so it can go on time bus
    [expand.cfg, page1.csv]
2015-05-27 Replaced all outport TPs with 2 pin sip headers
    [page1.csv]
2015-05-27 Made VREFM into a plane. Fixed DRCs and Danglers
    [expand.cfg, page1.csv]
2015-05-27 Fixed problem with GND_Bot not connecting to GNDs
    [expand.cfg, page1.csv]
2015-05-27 Added More GND testpoints and a volt divider to spkr
    [page1.csv]
2015-05-27 Copied PTBs power setup for the MZ
    [chips.prt, expand.cfg, page1.csv]
2015-05-27 Did layout for new power stuff
    [expand.cfg, page1.csv]
2015-05-28 Added LVC07A on MZ outputs
    [chips.prt, expand.cfg, page1.csv]
2015-05-28 Did layout & routing for those buffers
    [expand.cfg, page1.csv]
2015-05-28 Did schem layout & routing for remaining buffers
    [page1.csv]
2015-05-28 Replaced all lvc07a's with lv07a's
    [expand.cfg, page1.csv]
2015-05-28 Fixed all dangling lines and un traced rats
    [expand.cfg, page1.csv]
2015-05-28 Added Unnused MZ ports thing
    [expand.cfg, page1.csv, page2.csv]
2015-05-28 Routed unnused mz ribbons
    [expand.cfg, page1.csv, page2.csv]
2015-05-28 Did schem for new vcc_io crap
    [electcap.psm, srr1240.psm, ssr6038.psm, tdfn11_2x3mm.psm, to220_5pin.psm]
2015-05-28 Just realized JX headers a backwards...fuck
    [chips.prt, expand.cfg, page1.csv]
2015-05-28 Fixed things in schem (I think)
    [chips.prt, page1.csv]
2015-05-28 Did (some of the) layout for fixxes and power solution
    [page1.csv]
2015-05-29 Finished layout and such for new regulator (hope it works
    [cap1210.psm, chips.prt, expand.cfg, page1.csv]
2015-05-31 Finished all layout crap. Added Neutrino Atlas
    [expand.cfg, page1.csv]
2015-05-31 Added tp to vccio
    [chips.prt, expand.cfg, page1.csv]
2015-06-01 Changed DS1023 from soic to soicw
    [chips.prt, expand.cfg, nc_param.txt, page1.csv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]
2015-06-04 Updated BOMs
    [BOM.csv, expand.cfg]
2015-06-04 Changed 1n5822 package to do201AD
    [chips.prt, page1.csv]
2015-06-04 Went through each part to make BOM better
2015-06-05 Remade artwork (which I sent to the PCB company)
    [marzece_TubiiPCB_prod-1-8.drl]
2015-06-08 Added a note for d6r10 push button
    [expand.cfg, page1.csv]
2015-09-22 Created new BOM that value column and a line for each item
2016-01-26 Added documentation
    Add more testing descriptions
    Created new BOM that value column and a line for each item
    Added MicroZed pin guide
    Added logo
    Add server API description doc
    Added neat-o picture
    Added overview document
    [TUBii_MicroZed_PinGuide.xlsx]
